Guilleloma/Furby-GPT/README.md

# Hacked Furby as a Desktop Assistant with Voice Control



https://github.com/Guilleloma/Furby-GPT/assets/115458145/2f7d8e4b-0d95-4262-baf4-6ca00bf8f71c

## Description
This project transforms a 1998 Furby into an interactive and advanced desktop assistant using a Raspberry Pi W. It incorporates OpenAI and Google Speech to text for natural language processing, primarily relying on Google Cloud Text to Speech for voice generation. It uses Picovoice's Porcupine library for voice activation and controls the Furby's motor for a dynamic user experience.

> **More on the web:** the [project page](https://makerisland.es/projects/furby-gpt) tells the full story, and [FurbyBoard por dentro](https://makerisland.es/projects/furby-gpt/placa) (in Spanish) is an interactive walkthrough of the custom board: every block animated, simulated signals and how to diagnose faults. The board's design files and datasheet live in [`Hardware/FurbyBoard/`](Hardware/FurbyBoard/README.md).

## Features
- **Function:** Designed to act as an interactive desktop assistant.
- **Platform:** Operates on a Raspberry Pi W.
- **Motor Control:** Animates the Furby in response to voice interactions.
- **Intelligent Interaction:** Processes natural language using OpenAI and Whisper/Google Speech to Text.
- **Voice Generation:** Primarily uses Google Cloud Text to Speech for verbal responses.
- **Voice Activation:** Utilizes Picovoice's Porcupine for detecting wake words.

## Requirements
- A 1998-2000 Furby.
- Raspberry Pi W (with necessary accessories).
- HAT Audio: WM8960 Audio HAT
- L298N H-Bridge (motor driver)
- Speaker (default speaker is useful as well but very poor)
- Access to OpenAI, Google Cloud & Picovoice (Elevenlabs optional)
- Knowledge in programming and electronics.

## Setup and Installation
1. **Hardware Preparation:** Modification and integration of the Raspberry Pi W into the Furby.
2. **Software Configuration:**
   - Installation and setup of OpenAI, Google Cloud
   - Installation of dependencies. Example:
     ```
     pip install openai whisper google-cloud-texttospeech pvporcupinewrapper python-dotenv
     ```
   - Add YOUR API Keys (see **Configuration** below)
3. **Programming and Integration:** Development of code to manage voice interaction and movement.

## Configuration
API keys are read from environment variables. Copy `.env.example` to `.env` and fill it in:
```
cp .env.example .env
```

| Variable | Required | Service |
|---|---|---|
| `OPENAI_API_KEY` | Yes | OpenAI (Whisper and ChatGPT) |
| `PICOVOICE_ACCESS_KEY` | Yes | Picovoice Porcupine (wake word) |
| `GOOGLE_APPLICATION_CREDENTIALS` | Yes | Path to your Google Cloud service account JSON (Text-to-Speech) |
| `PICOVOICE_KEYWORD_PATH` | No | Path to your wake word model (`.ppn`). Defaults to `heymatepicovoice.ppn` next to the scripts |
| `ELEVENLABS_API_KEY` | Only with ElevenLabs | ElevenLabs (optional TTS) |
| `ELEVENLABS_VOICE_ID` | Only with ElevenLabs | ID of the ElevenLabs voice to use |

`.env` is loaded automatically when `python-dotenv` is installed; otherwise export the variables in your shell. `.env` is in `.gitignore`: never commit it. If a variable is missing, the program stops and tells you which one.

The wake word model is created in the Picovoice Console and is tied to your account, so `*.ppn` files are not committed: download yours and place it next to the scripts or set `PICOVOICE_KEYWORD_PATH`.

### Furby personality
The system prompt lives in `chatbot1.txt`, which is local and ignored by git. Create it from the example and personalise it:
```
cp chatbot1.example.txt chatbot1.txt
```
If `chatbot1.txt` does not exist, the program uses `chatbot1.example.txt` and prints a warning. Keep personal details in `chatbot1.txt` only.

## Usage
1. Wake up the Furby with a keyword using Porcupine.
2. Interact with the Furby, which uses Whisper and OpenAI for understanding and responding.
3. Enjoy the Furby's responses and animations, controlled by the Raspberry Pi W.

## Contribution
To contribute to the project:
```
1. Fork the project
2. Create your feature branch (`git checkout -b feature/AmazingFeature`)
3. Commit your changes (`git commit -m 'Add some AmazingFeature'`)
4. Push to the branch (`git push origin feature/AmazingFeature`)
5. Open a Pull Request
```

## License
This project is licensed under the MIT License - see the LICENSE.md file for details.

## Contact
Contact information of the project creator.
