Guilleloma/Furby-GPT/Hardware/FurbyBoard/revisiones/2026-10-27-M3.md

# Cierre de la mejora M3 (piezas contra el contorno fresado; E1 propia repetida y E2 sobre los ficheros) — FurbyBoard v1.0

- Fecha: 2026-10-27 · Rama `fix/furbyboard-m3` desde `trunk` (`402eeb9`) · Commits: `ce455a2` (M3), `e558d6a` (fabricación) y el de documentación que añade este informe · Autor: electronics-engineer (T0, Fable 5.1), encargo de cierre de M3 de `2026-10-25-E-independiente.md`
- Tipo de placa: L · Capas: 6 (JLC06161H-7628) · Fabricante: JLCPCB (Economic a una cara)
- Material: `scripts/design.py`, `layout.py`, `rutas_fijas.py`, `comprobar_colocacion.py`; placa regenerada (`gen_sch` → `sch upgrade` → `gen_pro` → `gen_pcb` → `gen_pro` → `rellenar.sh`); volcado propio con pcbnew en subproceso (`os._exit`) de la distancia de patio, cuerpo (F.Fab) y pads de las 158 huellas al contorno real (`GetBoardPolygonOutlines`, con el agujero del mecanismo), de borde a borde; script propio de rellenos y de paralelos In2/In3 (el mismo criterio de M1); PNG de `pcb-toolkit capturas` a 60 px/mm.
- Skills cargadas: `pcb-layout`, `kicad-automation`, `pcb-fabrication`, `hardware-design-review` (y sus referencias del Cerebro enteras: `layout-pcb`, `kicad-automatizacion`, `fabricacion-pcb`, `fabricante-jlcpcb`, `revision-de-diseno`, plantillas y preferencias).

## Resultado
**PASA (propia)** — 0 críticos, 0 importantes, 0 mejoras nuevas. Objetivo de M3: ningún pad ni cuerpo de pieza montada a < 0,5 mm del contorno fresado (tolerancia del contorno de JLCPCB ±0,2 mm, `fabricante-jlcpcb.md` §2; con 0,5 nominal quedan ≥ 0,3 en el peor caso). Cumplido en las 126 piezas montadas. Falta la revisión independiente («Para el revisor»).

## Criterio
- `fabricante-jlcpcb.md` §2: cobre a borde fresado ≥ 0,2 mm, tolerancia del contorno ±0,2 mm (±0,1 de precisión). Regla del proyecto: cobre a borde 0,3 (DRC). Para piezas montadas se exige además pads y cuerpo a ≥ 0,5 mm (0,3 en el peor caso del fresado), y el patio a ≥ 0,5 donde quepa (es lo que midió la revisión E; el patio lleva 0,25 de margen alrededor del cuerpo y no es cobre).
- Medida: distancia mínima entre el polígono (patio, cuerpo o pad) y los segmentos del contorno real, no contra arcos aproximados.

## Distancias al contorno fresado (mm; antes `402eeb9` → después `ce455a2`)
| Pieza | Patio | Cuerpo | Pads | Qué se hizo |
|---|---|---|---|---|
| **R24** (30 kΩ, compensación del TPS61089) | 0,086 → **0,597** | 0,359 → **0,803** | 0,336 → **0,774** | 0603 → **0402** (C25776) bajo C15, en (−53,88; −119,10) a 180° |
| **R23** (270 kΩ, ILIM) | 0,216 → **0,396** | 0,821 → 0,997 | 0,650 → 0,827 | 0,30 al norte, (−45,25; −115,07) |
| **R50** (1 kΩ, serie de HOME) | 0,410 → **0,568** | 1,102 → 1,260 | 0,789 → 0,947 | 0,15 al oeste y 0,05 al norte, (−44,65; −112,75) |
| R42 | 0,500 → 0,500 | 1,19 | 0,87 | Sin cambio: C20 toca su patio por el oeste y R40 por el norte |
| D3, C16, C18 | 0,70 / 0,76 / 0,98 | ≥ 1,3 | ≥ 1,1 | Sin cambio |
| J9 (pads de cable) | 0,282 | — | 0,717 | Sin cambio |
| J7, J8, J11 (pads de cable) | 0,101 / 0,008 / −0,000 (J11 con un vértice 0,11 fuera, aceptado en C) | — | 0,446 / 0,344 / 0,347 | **No se mueven** (hallazgo A1) |
| J1 (USB-C de montaje medio) | −0,000 | −0,080 | 0,140 | Sin cambio: regla propia del `.kicad_dru` (pads junto a la ranura) |
| U4 (módulo) | −0,000 | 0,839 | — | Sin cambio: la antena va fuera de la placa por diseño |
| LOGO1 (serigrafía inferior) | 0,605 | 0,574 | — | Sin cambio |

Las 144 huellas restantes quedan a > 1,0 mm en los tres conceptos. Volcado completo en el scratchpad del encargo (`borde-antes.txt`, `borde-despues.txt`); el script se reproduce con pcbnew en < 1 min.

## Por qué R24 pasa a 0402 y no se mueve
- Entre el patio de R22 (y −117,00) y el borde trasero (y −120,161) hay 2,66 mm. Caben un 0603 a 180° (patio de 1,55) y un 0402 (0,94), pero no dos 0603 (3,10) ni uno a 90° (3,05). La columna no puede subir: C12 queda a 0,22 del patio de L2 y la pista FSW (y −113,75) a 0,23 del pad de C12. Al oeste están C14, R21 y el keepout de Ø5 de H4; al sur, la muesca del contorno hacia H4 (línea de (−55,53; −121,37) a (−53,34; −120,27)). Mover C15 en vez de R24 deja el mismo problema. Comprobado también a 0° y 90° en el hueco entre el keepout de H4 y la muesca: el patio o los pads caen dentro del keepout o a < 0,5 de la muesca.
- R24 sigue pegada a C15 (COMP, 1,3 mm) y a C14 (RC, 2,1 mm), fuera de la zona de L2 (> 8 mm) y del keepout de H4 (> 3 mm). Ruta: COMP baja recto de C15.1 y entra en R24.1 con una diagonal de 0,43; RC sale de R24.2 al oeste, sube a 45° a la fila de C14 (y −118,6) y entra en C14.1 por su eje. Sin vías nuevas. El lazo VOUT–C18–GND y el nodo SW no se tocan.
- Pieza: UNI-ROYAL 0402WGF3002TCE, 30 kΩ ±1 %, 62,5 mW, **C25776**. Ficha de JLCPCB: **Extended** (3,07 USD de carga en Economic); API de EasyEDA/LCSC: 249 300 en stock, 0,0033 USD (2026-10-27). Se mantiene el valor aprobado de la compensación; el 33 kΩ 0402 (C25779) es Basic y subiría fc un 10 % (R5 ∝ fC, ecuación 17 de SLVSD38C): queda como opción de Guillermo en `fabricacion/README.md`, «Confirmar antes de pedir». El código 30 kΩ 0402 no se adivinó: se sondeó la API de EasyEDA por código (C25770–C25780) hasta dar con el MPN, y se confirmó en la ficha de JLCPCB.

## R23 y R50
- **R23** (ILIM, resistencia de ajuste estática a GND: su única regla es ir corta al pin 8 y con el retorno local; no es realimentación ni compensación): 0,30 al norte. No cabe más al norte (patio de R50 a 0,01) ni al oeste (las dos vías de VSYS que alimentan C16.1 en x −46,25 quedan a 0,225 de sus pads; la primera prueba a 0,24 al oeste dio DRC con corto GND/VSYS y se descartó). ILIM pasa entre los pads de C16 por y −116,12 (0,245 al pad de VSYS, 0,405 al de GND) y entra en R23.1 por su eje desde el sur (aviso `entrada-pad-descentrada` 0,225, aceptado en NOTAS). La vía de GND de R23.2 baja a 45° al SE, a (−44,65; −114,845): al este quedaba a 0,125 de la columna de HOME_PAD.
- **R50**: 0,15 al oeste y 0,05 al norte. La vía de HOME se queda en la diagonal de In2 ((−46,35; −112,75), 45° exacto desde (−48,3; −110,8)); la columna de HOME_PAD de In2 pasa a x −43,825 (0,355 a la vía de TUMMY_PAD, 0,6 a la de TUMMY). La bajada de ENC_IO de In3 pasa de x −43,95 a −44,2 (0,225 a la vía de TUMMY) para no quedar a 0,125 de eje a eje de esa columna: ahora 0,375 (antes 0,275), solape 1,55 mm, por debajo del criterio de M1 (≥ 2 mm). Ningún paralelo In2/In3 nuevo: los 19 pares son los mismos, con las mismas longitudes y separaciones.

## Herramientas
| Herramienta | Comando | Resultado |
|---|---|---|
| Comprobación §1.1 | kicad-cli, pcb-toolkit, kicad-happy, rsvg-convert | kicad-cli 10.0.7; pcb-toolkit 0.1.0 (venv de `~/development/pcb-toolkit`, el de `PCB_TOOLKIT`); kicad-happy v2.3.2; rsvg-convert; sin `~*.lck` |
| ERC | `kicad-cli sch erc --severity-all --exit-code-violations` | **0** |
| DRC | `kicad-cli pcb drc --schematic-parity --severity-all` sobre la placa guardada por `rellenar.sh` (y en `make_fab.sh`, copia rellenada por kicad-cli idéntica) | **0 infracciones, 0 sin unir, 0 de paridad** |
| Rellenos | Script propio (área y trozos por red y capa) frente a `402eeb9` | In1 e In4 3313,1 mm² en 1 trozo; GND B 2773,3 en 10; VSYS In2 2617,8 en 3 (antes 2619,0, por las vías movidas); BAT F 31,2 en 1; **GND F 2080,3 en 19 (antes 2082,9 en 21)**: la bolsa de C18.2 (4,3 mm², 1 vía) se une al plano por la franja bajo el 0402 y la de C16.2 (4,0, 2 vías) a la de R23.2 (ahora 7,0 mm² con 3 vías); desaparece el dedo de 0,25 mm de ancho entre los pads de R40/R42/R50 (≈ 3 mm², sin pads ni vías de GND; `layout-pcb.md` §5.4 los prohíbe). Todos los pads de GND de la esquina siguen en un trozo con vía (U5.5 va por pista a C18.2, como antes) |
| Flujo | `pcb-toolkit comprobar-flujo --png --json` | Solo los dos cruces ya aceptados en NOTAS (I2S_DIN a 0,40 del clase D; MOT_VREF a 2,58 de L2) y los 4 desacoplos ≤ 2 mm de siempre |
| Geometría | `pcb-toolkit revisar-rutado --json` (anchos de `pcb-toolkit.toml`) | **0 errores, 152 avisos** (antes 151): +1 `entrada-pad-descentrada` R23:1 0,225 (BST_ILIM). Diff contra `402eeb9`: ningún otro aviso nuevo ni desaparecido |
| Colocación | `scripts/comprobar_colocacion.py` | OK (TP accesibles, calzos libres, alturas). Fallaba desde M7 por R59 (0402 sin altura en `ALTURAS`) y LOGO2: añadidas R_0402 (0,45 mm) y Logo_GuilleMaker (0) |
| Paralelos In2/In3 | Script propio (≤ 8°, solape ≥ 2 mm, borde a borde < 1 mm) | 19 pares de redes, idénticos a `402eeb9` (misma longitud y separación) |
| Configuración | `pcb-toolkit.toml`, `.kicad_dru` | Sin cambios |
| Análisis | `kicad-happy.sh analizar` sobre copia | Puerta WARN (el de siempre: 152 símbolos frente a 158 huellas = 152 + H1–H4 + LOGO1 + LOGO2); hallazgos de nivel error los mismos de E1-12 y M9 (fiduciales, keepouts por caja, J1 fuera del contorno, vía de IR_TX junto a H1, DC-002, SU-001, SW-003); nada nuevo |
| CPL | `pcb-toolkit cpl-rotaciones` (en `make_fab.sh`) | **PASS, 0 errores, 3 avisos** `giro-sin-tabla` (R59, R60: C25105; R24: C25776; los tres 0402 sin polaridad); origen del CPL = origen del Gerber (220; −40) |
| PNG | `pcb-toolkit capturas` a 60 px/mm | **11 leídos** (abajo) |

## PNG leídos
| PNG | Qué se ve | Pasa |
|-----|---|---|
| Esquina del elevador, F.Cu | R24 0402 bajo C15, COMP recto desde C15.1 con la diagonal final, RC al oeste y a 45° hasta C14.1; franja de GND continua bajo R24 hasta la zona de C18; R23 con ILIM entre los pads de C16 y entrada por el eje; vía de GND de R23.2 a 45°. Solo 0°/45°/90°, sin agudos ni escaleras | Sí |
| Esquina, patios | R24 pequeño bajo C15 con hueco claro al borde; R23 separado del arco; ningún solape | Sí |
| Esquina, todo el cobre | Lo de arriba más In2/B.Cu: nada sobre el nodo SW ni el lazo de C18 | Sí |
| Esquina, In2 | Diagonal de HOME a 45° acabando en su vía; columna de HOME_PAD hacia el norte; EN_6V sin tocar | Sí |
| Esquina, In3 | Solo vías; ninguna pista nueva | Sí |
| Esquina, B.Cu | V6 por y −118,0 y las vías dobles de C18; EN_6V por x −48,4; TP7. Sin cambios | Sí |
| Esquina, serigrafía | Designadores recolocados sin pisar pads ni vías | Sí |
| Zona de R50/R23/J9, F.Cu | Columna R40/R42/R50 con sus vías; R23 abajo con el stub de GND a 45°; ya no hay dedo de GND entre los pads de la columna (comparado con el PNG de `402eeb9`) | Sí |
| Zona de R50/R23/J9, In2 | HOME_PAD sube por x −43,825 entre las vías de TUMMY y TUMMY_PAD hasta el canal de J9 | Sí |
| Zona de R50/R23/J9, In3 | ENC_IO baja por x −44,2, fila de y −109,3 y vía; TUMMY_PAD por el canal x −43,07 | Sí |
| Zona de R50/R23/J9, patios | R23, R50, R42, R40, JP4 sin solape (huecos de 0,01–0,06) | Sí |

## Hallazgos
| ID | Severidad | Área | Hallazgo | Evidencia | Verificado / supuesto | Corrección propuesta | Estado |
|----|---|---|---|---|---|---|---|
| A1 | Aceptado (documental) | DFM: pads de cable y USB-C junto al contorno | Los patios de J7, J8, J9 y J11 quedan a 0,0–0,28 mm del contorno y el cobre de sus pads a 0,34–0,45; J1 a 0,14 por su regla propia; U4 con la antena fuera | Volcado propio | Verificado | No se mueven: son pads de cable sin cuerpo (el patio no es cobre y no hay pieza que el fresado pueda tocar); el cobre cumple los 0,3 del DRC y los 0,2 de JLCPCB (peor caso 0,14 de FR-4 con ±0,2). Moverlos 0,2 mm reabre el rutado de 18 pads en el borde (UART, I2C y P04 de J_EXP; TILT, TONGUE y altavoz de J8; IR de J7, que además quedaría bajo la batería). Si el revisor lo exige, es un encargo aparte | Abierto para el revisor |
| A2 | Mejora | Coste | R24 en 0402 es extended (+3,07 USD de carga por pedido, 19 referencias) | Ficha de JLCPCB de C25776 | Verificado | Mantener 30 kΩ (valor aprobado). Opción: C25779 (33 kΩ, basic), fc +10 % sin simular | Decisión de Guillermo (README de fabricación) |
| A3 | Mejora | R23 | El patio queda a 0,40 (pads a 0,83, cuerpo a 1,0): no llega a 0,5 por las vías de VSYS de C16 y por R50 | Volcado | Verificado | Nada para la v1.0: cumple el criterio de pads y cuerpo. v1.1: alimentar C16.1 desde el norte para liberar x −46,25 | Abierto (v1.1) |

## Checklist de la puerta (solo los puntos tocados)
| Sev. | Punto | Resultado |
|---|---|---|
| C | DRC con paridad 0/0 y rellenos no desfasados | OK: 0/0/0 guardado y rellenado; `make_fab.sh` para si no son idénticos |
| C | `revisar-rutado --ancho` 0 errores; anchos en el `.kicad_dru` | OK: 0 errores, 152 avisos (+1 aceptado) |
| C | `pcb-toolkit.toml` sin reglas apagadas | OK, sin cambios |
| C | Huella y pieza del 0402 comprobadas | OK: R_0402_1005Metric de KiCad (la misma de R59/R60), MPN y código confirmados en JLCPCB y LCSC |
| I | Convertidor como su referencia; compensación corta | OK: R24 a 1,3 mm de C15 y 2,1 de C14; lazo y SW intactos |
| I | Plano continuo bajo B/C/D; sin islas ni dedos nuevos | OK: In1/In4 en 1 trozo; GND F con 2 trozos menos (bolsas unidas) y un dedo menos |
| I | Apilado: paralelos In2/In3 | OK: 19, los mismos |
| I | Mecánica (`comprobar_colocacion.py`), patios sin solape | OK |
| C (E2) | Gerber, taladros y CPL con el mismo origen; CPL comprobado | OK: (220; −40); `cpl-rotaciones` PASS; R24 en (−53,880; −119,100) Top 180 |
| I (E2) | BOM agrupada; README de fabricación | OK: 52 líneas / 126 piezas; README con C25776, 19 extended y la opción C25779 |
| I | NOTAS y README al día | OK |

## Revisión final como revisor senior
- «Isla borrada en silencio» (FurbyBoard, 2026-10-25): medido trozo a trozo; los dos que desaparecen se unen a otros y el dedo que se pierde no tenía pads ni vías.
- «Vía de otra red fuera de la ventana» (2026-10-27): la primera posición de R23 chocó con la vía de VSYS de C16; lo paró el DRC y se corrigió antes de rutar nada más. Lección: antes de mover una pieza, volcar vías y pistas a ≥ 1 mm de su patio nuevo (hecho después para R50 y ENC_IO).
- «Código de pieza inventado»: C25900 que yo recordaba como 30 kΩ era 4,7 kΩ; se comprobó en LCSC y JLCPCB antes de usar C25776.
- «Herramienta de pipx desfasada»: todo con el pcb-toolkit del venv.

## Para el revisor
1. Repetir el volcado de distancias al contorno con `GetBoardPolygonOutlines` (patio, cuerpo y pads de las 158 huellas) y comprobar que ninguna pieza montada tiene pads ni cuerpo a < 0,5 mm; R24 0,60 / 0,80 / 0,77, R23 0,40 / 1,00 / 0,83, R50 0,57 / 1,26 / 0,95, R42 0,500 / 1,19 / 0,87.
2. Juzgar A1: si los pads de cable (J7, J8, J11) deben moverse 0,2 mm hacia dentro pese a cumplir las reglas de cobre, o si basta con lo documentado.
3. R24: la compensación sigue siendo 30 kΩ + 4,7 nF (+ 10 pF); comprobar que COMP y RC siguen cortas y que el 0402 no cae en el keepout de H4 ni en la zona de L2. Decidir, con Guillermo si hace falta, 30 kΩ extended (C25776) o 33 kΩ basic (C25779).
4. ILIM entre los pads de C16 por y −116,12: 0,245 al pad de VSYS y 0,405 al de GND, entrada a R23.1 por el eje desde el sur (descentrada 0,225).
5. Rellenos de GND de F.Cu: 21 → 19 trozos. Comprobar que los pads C18.2, C16.2 y R23.2 siguen en trozos con vía y que el dedo perdido entre R40/R42/R50 no deja nada suelto.
6. ENC_IO (In3) por x −44,2: 0,225 a la vía de TUMMY y 0,375 de eje a eje con HOME_PAD (In2) en 1,55 mm; paralelos In2/In3 sin cambios (19).
7. E2: `cpl-rotaciones` con 3 `giro-sin-tabla` (0402 sin polaridad): R24 a 180° en el CPL; comprobar en el visor de JLCPCB con las otras dos 0402.
