Guilleloma/Furby-GPT/Hardware/FurbyBoard/revisiones/2026-10-27-M7-M1.md

# Cierre de las mejoras M7 y M1 (E1 propia repetida y E2 sobre los ficheros) — FurbyBoard v1.0

- Fecha: 2026-10-27 · Rama `fix/furbyboard-m7-m1` desde `trunk` (`7f1f637`) · Commits: `f2f73dd` (M7), `4156112` (M1, tanda 1) y los de fabricación y documentación que siguen · Autor: electronics-engineer (T0, Fable 5.1), encargo de cierre de M7 y M1 de `2026-10-25-E-independiente.md`
- Tipo de placa: L · Capas: 6 (JLC06161H-7628) · Fabricante: JLCPCB (Economic a una cara)
- Material: `scripts/design.py`, `layout.py`, `rutas_fijas.py`, `pcb-toolkit.toml`; placa regenerada (`gen_sch` → `gen_pro` → `gen_pcb` → `gen_pro` → `rellenar.sh`); volcado propio con pcbnew en subproceso (`os._exit`) y script propio de paralelos In2/In3 (pares de segmentos a ≤ 8°, solape ≥ 2 mm, borde a borde < 1 mm); 9 PNG; `fabricacion/` regenerada con `make_fab.sh`. Skills cargadas: pcb-layout, kicad-automation (con `layout-pcb.md`, `kicad-automatizacion.md`, `preferencias-pcb-guillermo.md`, `plantilla-informe-revision.md`, `revision-de-diseno.md` §4.7–4.9 y §6) y la regla §7.3 de `diseno-de-circuito.md`. Coordenadas en el sistema del STL.

## Resultado
**PASA (propia)** — 0 críticos, 0 importantes, 0 mejoras nuevas. M7 cerrada; M1 cerrada con 9 pares corregidos y **19 aceptados uno a uno** en NOTAS («Paralelos In2/In3 aceptados»). Falta la revisión independiente (sección «Para el revisor»).

## Herramientas
| Herramienta | Comando | Resultado |
|---|---|---|
| Comprobación §1.1 | kicad-cli, pcb-toolkit, kicad-happy, Freerouting, rsvg-convert, ngspice | kicad-cli 10.0.7; pcb-toolkit 0.1.0 (pipx en `~/.local/bin`, y el venv de `~/development/pcb-toolkit` en `28b60ac`, que es el que mide el cobre en `comprobar-flujo` y trae la tabla de giros); kicad-happy v2.3.2 (`2fd9aa0f`); Freerouting 1.9.0; rsvg-convert; ngspice. Nada instalado (un venv con gerbonara para rasterizar los Gerber fue denegado por el sistema de permisos: los Gerber se comprobaron por texto, ver E2) |
| ERC | `kicad-cli sch erc --severity-all --format json` | **0** |
| DRC | `kicad-cli pcb drc --schematic-parity --severity-all` sobre la placa guardada por `rellenar.sh` | **0 infracciones, 0 sin unir, 0 de paridad** |
| Rellenos | `make_fab.sh` (copia rellenada por kicad-cli `cmp` con la guardada) | Idénticos. Volcado: GND F 2082,9 mm² en 21 trozos (antes 2084,6: antipads de los dos 0402), GND B 2773,2 en 10, In1 e In4 3313,1 en 1, VSYS In2 2619,0 en 3 (antes 2616,3: la fila de BQ_TS sube 0,25 y libera relleno), BAT F 31,2 en 1. **Ningún trozo ni isla nuevos** |
| Flujo | `pcb-toolkit comprobar-flujo --png --json` (venv `28b60ac`, mide el cobre) | Solo los dos avisos ya aceptados en NOTAS (I2S_DIN a 0,40 del clase D; MOT_VREF a 2,58 de L2) y los 4 desacoplos ≤ 2 mm; nada nuevo. (El pcb-toolkit de pipx, anterior, sigue dando el falso positivo USB_DP/L1) |
| Geometría | `pcb-toolkit revisar-rutado --tp-max 5 --json` (anchos de `pcb-toolkit.toml` = `params.ANCHOS_MINIMOS`) | **0 errores, 151 avisos** (entrada-asimétrica 36, descentrada 32, rodeo 27, cuello 21, roce-vía 15, roce-pad 10, pista-entre-pads 6, ancho-mayor-que-pad 3, colineales 1): los de NOTAS «Avisos aceptados», uno menos (el roce de BQ_TS con la vía de GND de C5.2 pasa de 0,2 a 0,225) |
| Configuración | `pcb-toolkit.toml` | Sin reglas en `off` ni umbrales más laxos; `criticas` y el grupo DVP pasan de `CAM_XCLK`/`CAM_PCLK` a `CAM_XCLK*`/`CAM_PCLK*` para cubrir las redes cortas de las series |
| Análisis | `kicad-happy.sh analizar` | Sin críticos; consistencia 152 símbolos frente a 158 huellas (= 152 + H1–H4 + LOGO1 + LOGO2, como antes); EMC 43/100 sin críticos |
| Paralelos In2/In3 | Script propio sobre el volcado | **28 → 19 pares**; antes de tocar nada reproduce los 28 del revisor independiente |
| CPL | `pcb-toolkit cpl-rotaciones` (venv, tabla `ejemplos/giros-jlcpcb.toml`) dentro de `make_fab.sh` | **PASS, 0 errores**, 2 avisos `giro-sin-tabla` (R59, R60: C25105 no está en la tabla; 0402 sin polaridad, giro 0) |
| PNG | `pcb-toolkit capturas` (F.Cu a 80 px/mm para M7; In2+In3 a 30 px/mm para M1) y los renders de `make_fab.sh` | 9 leídos y comentados (sección «PNG leídos») |

## M7: series en los relojes del bus DVP
| Qué | Dónde | Medida que lo demuestra |
|-----|---|---|
| **R59, 33 Ω 0402 (C25105, UNI-ROYAL 0402WGF330JTCE, básica, 2 162 519 en stock, 0,0011 USD; API de piezas de JLCPCB, 2026-10-27)** en CAM_XCLK, junto al pin 21 del módulo (lo genera el ESP32) | `layout.py` (−72,365; −82,35) a 0°; pad 1 (oeste) a la red corta CAM_XCLK_IO (pin 21), pad 2 al bus. Patio a 0,18 del patio del módulo (y −81,70); pads a 0,53 del pin 21 | PNG F.Cu a 80 px/mm: la subida de Y8 (x −71,095) a 0,415 del pad 2 y la de Y9 (x −73,635) a 0,415 del pad 1; XCLK entra en el pin 21 por su eje con una diagonal de 0,72 mm; la fila de Y9 (y −83,3) no pasa bajo los pads. DRC 0 |
| **R60, 33 Ω 0402 (mismo código)** en CAM_PCLK, junto al pad 17 de J6 (lo genera la cámara) | `layout.py` (−53,6; −78,0) a 0°, a 2,0 mm del pad; pad 2 (este) a la red corta CAM_PCLK_CAM (J6.17), pad 1 al bus. PCLK baja 0,25 a y −78,0 al salir del patio de J6 y vuelve a −77,75 al oeste de R60; Y7 baja 0,35 a y −78,6 y vuelve a −78,25 en x −55,6…−55,95 (más al oeste que el quiebro de PCLK) | PNG: Y6 (y −77,25) a 0,355 de los pads y Y7 (−78,6) a 0,205; Y8 (−79,25) a 0,5 de Y7; los quiebros son diagonales de 0,35–0,49 mm a 45° escalonadas (ningún par de diagonales a < 0,2). DRC 0 |
| Valor 33 Ω | `design.py` y NOTAS «Cálculos» | Z0 ≈ 75 Ω (microstrip 0,15 mm sobre In1 a 0,2104 mm, εr 4,4, IPC-2141); Rout del ESP32-S3 ≈ 30–40 Ω y de la OV2640 ≈ 40–50 Ω (**estimadas**, drive programable en los dos); Rs + Rout ≈ Z0. τ con ≈ 10 pF: 0,33 ns frente a 50 ns de periodo. Mismo valor que R31/R32 (I2S), huella distinta por sitio |
| HREF, VSYNC y datos sin serie | NOTAS «Decisiones» | HREF y VSYNC conmutan a frecuencia de línea y de cuadro; los datos se muestrean a mitad de periodo de PCLK (≥ 25 ns tras el flanco) con 16–29 mm de pista (anillo extinguido en < 2 ns). Ocho 0402 más no caben en el corredor de 0,3 mm de paso |
| Sin degradar el bus | Volcado | Las 12 líneas siguen en F.Cu sobre In1 continuo, **sin vías nuevas** (334 vías, como antes); los únicos cambios son los quiebros de PCLK y Y7 junto a J6 y 0,51 mm menos de XCLK |
| Esquema, ERC y paridad | `design.py` (redes CAM_XCLK_IO y CAM_PCLK_CAM), `hojas/mcu`, `hojas/camara` | ERC 0; paridad 0; 152 referencias, 108 redes |
| Documentación | README (Estado, Resumen, bloque Cámara, tablas de J6 y del módulo), NOTAS (Estado, Decisiones, Cálculos), TEST-PLAN §14 (flancos en R59/R60: ≤ 10 % de sobreimpulso; 47 Ω si hay anillo, 22 Ω si el flanco es lento), `fabricacion/README.md` (BOM, visor, coste) | Al día |

## M1: paralelos In2/In3
Método: volcado propio de la placa con pcbnew y script propio que compara cada segmento de In2 con cada uno de In3 (ángulo ≤ 8°, proyección con solape ≥ 2 mm, separación borde a borde = distancia entre ejes − (w1 + w2)/2 < 1 mm). Antes de tocar nada: **28 pares, los mismos que el revisor**. Orden: analógicas (VBAT_SNS, IPROPI, BQ_TS), relojes (I2S_BCLK, MOT_IN2) y la UART junto a la antena; después el resto por coste.

| Par corregido | Antes | Cambio (`rutas_fijas.py`, sin mover piezas ni vías) | Ahora (borde a borde) |
|---|---|---|---|
| VBAT_SNS ‖ U0RX | 11,4 mm a 0,46 | U0RX (In3) sube de y −63,6 a −63,0 entre el módulo y x −81,8 (0,45 a U0TX), baja a −63,6 en x −82,4 al sur de la vía de GND (−83,0; −62,99) | 1,06 |
| VBAT_SNS ‖ BQ_EN1 | 14,3 mm a 0,97 | Diagonales de EN_6V/BQ_EN2/BQ_EN1 0,141 al este (0,1 en perpendicular); la vía de GND (−71,2; −99,1) queda a 0,24 de EN_6V | 1,07 |
| I2S_DIN ‖ EN_6V | 3,7 mm a 0,95 | Las tres columnas de In3 0,1 al oeste (x −84,35 / −83,9 / −83,45); vías de 3V3 (−85,5; −86,3/−90,5) a 0,75 de BQ_EN1 | 1,05 |
| BQ_TS ‖ LED_CHG_A | 6,5 mm a 0,70 | BQ_TS (In2) a y −114,05 (0,225 a la vía de GND de C5.2); LED_CHG_A a −115,3 y LED_PG_A a −115,7 (0,2 a la vía de GND (−69,225; −116,3)); el tramo de F.Cu a R10.2 entra por el eje del pad | 1,05 |
| VBAT_SNS ‖ TUMMY | 2,6 mm a 0,85 | Fila corta de VBAT_SNS (In2) a y −76,1 (0,4 a la vía de ENC_IO) y las tres filas TUMMY/BACK/CAM_PWDN 0,1 al norte | 1,05 |
| 3V3 ‖ CAM_PWDN | 9,7 mm a 0,95 | Las mismas filas 0,1 al norte (CAM_PWDN a y −78,15; su diagonal a 0,25 de la vía de SDA y 0,29 de la de 3V3) | 1,05 |
| 3V3 ‖ CAM_EN y CAM_2V8 ‖ CAM_EN (tramo norte) | 2,3 a 0,90 y 4,1 a 0,28 | Tramo norte de CAM_EN (In3) por x −51,3 (1,0 a CAM_PWDN, 0,25 a la vía de 3V3 (−50,65; −87,8)) y la fila y −87,9 (0,3 a la vía de GND (−51,6; −88,6)) hasta x −53,5 y la vía de U8.3. Primer intento por x −50,9 cortocircuitaba con esa vía de 3V3 (DRC `shorting_items`): corregido antes del commit | 3,6 y 2,2; queda el tramo sur, 2,0 mm a 0,78 (fila 4 de NOTAS) |
| I2S_BCLK ‖ EXP_P07 | 4,5 mm a 0,75 | Columna de BCLK (In2) junto a U7 por x −94,0 (0,4 a DOUT, 0,2 a la vía de GND (−93,4; −91,95)) con diagonal de 0,57 a su vía | 1,15 |
| MOT_IN2 ‖ HOME | 4,4 mm a 0,50 | Fila de HOME (In3) a y −88,05 (0,5 a la vía de MOT_IN1 (−66,325; −88,95)) con diagonales de 0,55 y 2,0 | 1,05 |

**Los 19 que quedan** (EN ‖ U0RX y U0TX en la banda de la antena, IPROPI ‖ CAM_EN, CAM_2V8 ‖ CAM_EN, I2C_SCL ‖ I2C_SDA, EXP_INT ‖ IR_RX/TUMMY/BACK/CAM_PWDN, HOME_PAD y ENC_PT ‖ TUMMY_PAD, HOME ‖ BACK/TUMMY, CC1 ‖ CC2, I2C_SCL ‖ LED_RUN_K, 3V3 ‖ LED_RUN_K/IR_TX, I2C_SDA ‖ IR_RX, CAM_DVDD ‖ ENC_IO) están justificados uno a uno en NOTAS «Paralelos In2/In3 aceptados»: en todos la víctima o el agresor es una red estática o de interruptor filtrado (EN con 1 µF; enables; interruptores con 1 kΩ + 100 nF; Rd del USB-C; raíles desacoplados) y la geometría los pinza entre vías o en el único canal (entre las filas de pads de J7, entre las columnas de J9, entre las vías de EN y SDA bajo el módulo, entre el agujero del mecanismo y la columna de vías de x −53…−52). El único con una red de clase D es **IPROPI ‖ CAM_EN** (9,4 mm a 0,50): CAM_EN cambia una vez por encendido de la cámara a través de 100 kΩ; se intentó CAM_EN por x −50,5 y la diagonal de vuelta a R33 no pasa la columna de vías de x −54,375 (paso 0,75, antipads de 0,55); IPROPI no puede ir más al este por su vía de retorno (−53,39; −99,55). HOME_PAD ‖ TUMMY_PAD: el canal este de J9 (x −40,4) no existe, el borde fresado está en x −40,0 a la altura de J9.5.

Lo que sigue por debajo del umbral de 2 mm y por tanto no cuenta, para que el revisor no lo descubra por su cuenta: U0RX ‖ EN 2,0 mm a 0,20 en x −82,4…−84,4 (se cuenta dentro de la fila 1 de NOTAS); CAM_EN ‖ CAM_2V8 1,1 mm a 0,275 en el tramo x −53,5 (y −87,9…−89,0); CAM_2V8 ‖ CAM_EN 0,9 mm a 0,8 en el stub de x −51,512; VBAT_SNS ‖ ENC_IO 1,6 mm a 0,7 (fila y −76,1 frente a y −75,3).

## E2 sobre los ficheros regenerados
| Comprobación | Resultado |
|---|---|
| Rellenos al día | `make_fab.sh` para si la copia rellenada por kicad-cli no es idéntica: idéntica |
| ERC y DRC en `fabricacion/` | `erc.rpt` y `drc.rpt` sin infracciones (0/0/0) |
| Capas | 6 de cobre, máscara, pasta (la inferior vacía), serigrafía y contorno; 29 ficheros en `gerber/` y el zip |
| Taladros | PTH: 383 (0,2 × 3 del par USB, 0,3 × 331 = 334 vías, 0,8 × 4 ranuras del USB-C, 1,0 × 44 pads de cable, 1,2 × 1 de J2); NPTH: 4 (M2). **Iguales a la E2 del 2026-10-25**: M7 y M1 no añaden vías |
| Pads de R59 y R60 en los Gerber (comprobación por texto, sin rasterizar) | Flashes `D03` en F.Cu, F.Mask y F.Paste en (−72,875; −82,35), (−71,855; −82,35), (−54,11; −78,0) y (−53,09; −78,0): las cuatro aperturas de los 0402 en el mismo marco que el CPL (origen auxiliar (0,0) del STL) |
| Origen | Gerber con `--use-drill-file-origin`, taladros `--drill-origin plot`, CPL `--use-drill-file-origin`; `cpl-rotaciones`: origen del CPL = origen del Gerber (220; −40) |
| CPL | PASS, 0 errores; R59 (−72,365; −82,35) y R60 (−53,6; −78,0) a 0°, las posiciones del PCB. Los 21 códigos con giro u origen corregidos (`jlc_post.py`) no han cambiado |
| BOM | 52 líneas, 126 piezas, 18 extended (sin cambio); nueva línea `33, R59,R60, R_0402_1005Metric, C25105` (básica) |
| Renders | `render/furbyboard-arriba.png` (R59 bajo la fila inferior del módulo y R60 a la izquierda del FPC, el resto como el 2026-10-25), `-abajo.png` (sin cambios: TP, leyendas, logos) e `-iso.png`; STEP y PDF regenerados |
| README de fabricación | Fecha, commit, 52/126, línea de C25105 en la BOM, R59/R60 en «Revisar en el visor» y en «Confirmar antes de pedir», coste (+0,002 por placa) |
| Datos personales | `grep -r '/Users/'` en `Hardware/FurbyBoard`: nada |

Lo que no se repitió: la rasterización de los Gerber con gerbonara (instalación denegada en este encargo); los Gerber salen del mismo `kicad-cli` y la placa que los genera se ha revisado en PNG, pero **el revisor debería abrir `gerber-jlcpcb.zip` en un visor** (gerbv, el de JLCPCB o gerbonara) y mirar F.Cu, F.Paste y F.Mask alrededor de (−72,4; −82,4) y (−53,6; −78,0).

## PNG leídos
- `png-m7/F_Cu-v1` (comb de J6, 80 px/mm): R60 entre Y6 y Y7; PCLK con sus dos quiebros a 45°, Y7 con los suyos más al oeste; Y6 y Y8 sin tocar; el stub de GND de J6.15 a su vía. Pasa.
- `png-m7/F_Cu-v2` (fila sur del módulo, 80 px/mm): R59 bajo el pin 21; pad 1 sube con la diagonal al pin, pad 2 baja a la fila de XCLK; Y8 y Y9 a los lados sin tocar; fila de Y9 por debajo. Pasa.
- `png-m1/cobre-v1` (banda bajo la antena, In2+In3): TX y RX en dos carriles separados sobre el relleno de VSYS, RX con el quiebro a −63,6 junto a la vía de GND; EN y VBAT_SNS en In2 debajo; cosido en y −64,9. Pasa.
- `png-m1/cobre-v2` (diagonales BQ_EN/VBAT_SNS): las tres diagonales de In3 a su lado NE de la de VBAT_SNS con separación visible; octógono de HOME alrededor del agujero. Pasa.
- `png-m1/cobre-v3` (CAM_EN junto a J6/U8): columna de In3 por x −51,3, fila a y −87,9 y bajada a la vía; CAM_2V8 de In2 a dos milímetros al oeste. Pasa.
- `png-m1/cobre-v4` (BQ_TS y LED bajo la batería): fila de BQ_TS con sus vías, LED_CHG_A y LED_PG_A debajo en pareja con las diagonales, GND de C5.2 fuera del margen. Pasa.
- `png-m1/cobre-v5` (autopista de In3 bajo U10): tres filas con sus diagonales, columnas de In2 cruzando a 90°; fila corta de VBAT_SNS arriba. Pasa.
- `png-m1/cobre-v6` (BCLK/U7): columna de BCLK con la diagonal a su vía, EXP_P07 al oeste; vías de GND de cosido intactas. Pasa.
- `png-m1/cobre-v7` (HOME/MOT_IN2 alrededor del agujero): fila de HOME con la diagonal a su columna, MOT_IN2 por encima; octógono. Pasa.
- `render/furbyboard-arriba.png` y `-abajo.png`: montaje completo; R59 y R60 presentes; cara inferior sin cambios. Pasa.

## Checklist (puntos tocados)
| Ref. | Sev. | Punto | Estado |
|---|---|---|---|
| 4.2 | I | Interfaces: series en relojes de buses paralelos (`diseno-de-circuito.md` §7.3) | OK: XCLK y PCLK con 33 Ω en su origen |
| 4.3 | C/I | MPN, huella, código, stock y clase | OK: C25105 básica, huella `R_0402_1005Metric` de KiCad (pads 0,54 × 0,64 a 1,02 de paso), stock consultado |
| 4.6 | C/I | Colocación: patios sin solape, desacoplos sin regresión | OK: DRC 0; ningún desacoplo se mueve |
| 4.7 | C | DRC con paridad 0/0 y rellenos no desfasados | OK |
| 4.7 | C | `revisar-rutado --ancho` 0 errores; anchos en el `.kicad_dru` | OK (151 avisos, justificados) |
| 4.7 | C | `pcb-toolkit.toml` sin reglas apagadas | OK (`criticas` ampliada) |
| 4.7 | I | PNG; plano continuo bajo B/C/D; sin islas ni dedos | OK: In1/In4 en 1 trozo; DVP sigue en F.Cu sobre In1 sin vías |
| 4.7 | I | Apilado: paralelos In2/In3 (regla de NOTAS) | OK con 19 aceptados y justificados |
| 4.8 | C | Gerber, taladros y CPL con el mismo origen; giros por geometría | OK (R59/R60 sin polaridad) |
| 4.8 | I | BOM agrupada; README de fabricación | OK |
| 4.9 | C/I | TEST-PLAN | OK: §14 con la medida de los flancos en R59/R60 |

## Revisión final como revisor senior
- **«DRC 0» como calidad:** el primer intento de CAM_EN por x −50,9 pasó por `revisar-rutado` sin error y lo paró el DRC (`shorting_items` con la vía de 3V3 de U8.1): la lección es que el volcado por ventana hay que hacerlo con margen (la vía estaba a 0,25 mm fuera de la ventana que se miró). Se corrigió antes del commit.
- **Afirmación no medida:** cada separación de este informe sale del script de paralelos sobre el volcado, y las holguras a vías se han calculado una a una; las Rout del ESP32-S3 y de la OV2640 son estimaciones y están marcadas como tales.
- **Bus rápido por un convertidor, TP lejos, piezas giradas en el CPL, Gerber y CPL con distinto origen:** no aplica o comprobado (CPL PASS; sin vías nuevas; DVP intacto).
- **Islas borradas en silencio:** recuentos de relleno iguales por red y capa (ninguna isla nueva).

## Para el revisor
1. **Paralelos:** repetir el volcado y el recuento con su propio script (criterio: ≤ 8°, solape ≥ 2 mm, < 1 mm borde a borde) sobre `FurbyBoard.kicad_pcb` del último commit: deben salir **19 pares**, los de la tabla de NOTAS «Paralelos In2/In3 aceptados», con las separaciones que allí figuran. Comprobar que ninguno lleva una red de clase B, C o D salvo IPROPI ‖ CAM_EN, y juzgar las 19 justificaciones (en especial IPROPI ‖ CAM_EN, EN ‖ U0RX/U0TX y EXP_INT ‖ IR_RX).
2. **M7:** en el PNG de F.Cu (o en el Gerber) alrededor de (−72,4; −82,4) y (−53,6; −78,0): R59 y R60 a 0°, XCLK y PCLK pasando por ellas (pad 1 de R59 al pin 21, pad 2 a J6.13; pad 2 de R60 a J6.17, pad 1 al pin 24), sin vías nuevas (334), Y6/Y7/Y8/Y9 con holguras ≥ 0,2 y el bus entero en F.Cu sobre In1. En el esquema: R59 entre CAM_XCLK_IO (U4.21) y CAM_XCLK (J6.13); R60 entre CAM_PCLK (U4.24) y CAM_PCLK_CAM (J6.17). Valorar el valor (33 Ω) con el cálculo de NOTAS y, si se tiene la hoja del ESP32-S3 a mano, la Rout a su drive por defecto.
3. **Holguras de los movimientos de M1** (todas calculadas, DRC 0 con 0,15 de holgura): BQ_TS a 0,225 de la vía (−69,5; −113,425); LED_PG_A a 0,2 de (−69,225; −116,3); BCLK a 0,2 de (−93,4; −91,95); CAM_EN a 0,25 de (−50,65; −87,8) y 0,3 de (−51,6; −88,6); EN_6V a 0,24 de (−71,2; −99,1); U0RX a 0,21 de (−83,0; −62,99); HOME a 0,5 de (−66,325; −88,95). Vía de retorno de GND a ≤ 1 mm de cada vía de red crítica: sin cambios (ninguna vía se ha movido).
4. **Rellenos:** volcar y comparar con la referencia (GND F 2082,9 mm² en 21 trozos, B 2773,2 en 10, In1/In4 3313,1 en 1, VSYS In2 2619,0 en 3, BAT 31,2 en 1); los trozos sin vía ni pad de su red deben ser los mismos que en la re-revisión del 2026-10-25.
5. **E2:** `make_fab.sh` con `PCB_TOOLKIT=~/development/pcb-toolkit/.venv/bin/pcb-toolkit` (el de pipx no trae la tabla de giros y da 2 «errores» falsos de posición en U4 y J1); abrir `fabricacion/gerber-jlcpcb.zip` en un visor y mirar F.Cu, F.Paste y F.Mask de R59 y R60; contar taladros (383 PTH, 4 NPTH); BOM 52/126.
6. **Documentación:** README (tablas de J6 y del módulo con R59/R60 y las redes cortas), NOTAS (Decisiones del 2026-10-27, Cálculos, «Paralelos In2/In3 aceptados», Revisiones), TEST-PLAN §14 y `fabricacion/README.md` coinciden con `design.py` y con la placa.
