Guilleloma/Furby-GPT/Hardware/FurbyBoard/revisiones/2026-10-24-C-colocacion.md

# Revisión C colocación — FurbyBoard v1.0

- Fecha: 2026-10-24 · Commit: el de la colocación de esta rama (ver `git log`) · Revisor: electronics-engineer (replanteo independiente, modelo T0; revisión propia, no independiente)
- Tipo de placa: L · Capas: 4 · Fabricante: JLCPCB (reglas del perfil en el `.kicad_pro`)
- Material revisado: `FurbyBoard.kicad_pcb` generado por `scripts/gen_pcb.py --sin-rutado` desde `scripts/layout.py`; PNG de `pcb-toolkit png-revision --ratsnest --zona L1,L2` (fuera del repo) y `comprobar-flujo --png`; `render/colocacion-arriba.png` y `render/colocacion-abajo.png`

## Resultado
**PASA** — 0 críticos, 0 importantes, 4 mejoras anotadas. En placa L el encargo termina aquí: la revisión independiente de la colocación la lanza Maestro antes del rutado.

## Herramientas
| Herramienta | Comando | Resultado |
|---|---|---|
| ERC | `kicad-cli sch erc --severity-all --exit-code-violations` | 0/0 |
| DRC | `kicad-cli pcb drc --schematic-parity --severity-all` (sin `--refill-zones`) | **0 infracciones, paridad 0**; 362 conexiones sin rutar (esperable) |
| Flujo | `pcb-toolkit comprobar-flujo FurbyBoard.kicad_pcb --png … --json …` | **PASS**: 0 errores, 4 avisos (desacoplo a 1,02–1,9 mm), 232 conexiones, 9 zonas calientes, demanda máxima de celda 0,58 (umbral 0,8), 0 celdas congestionadas |
| Colocación propia | `scripts/comprobar_colocacion.py` | OK: TP, puentes, LED, botones y pads de cable fuera de la batería; calzos libres; 64 piezas bajo la batería, la más alta L1 (2,1 mm) para 4,1 de hueco; nada bajo el flex |
| Geometría | `pcb-toolkit revisar-rutado` | No aplica (sin rutado) |
| Configuración | `pcb-toolkit.toml` frente a `ejemplos/pcb-toolkit.toml` | Sin reglas en `off` ni umbrales relajados; margen 1,0 mm en las zonas del puente H y de la clase D, justificado en `NOTAS.md` |
| kicad-happy | — | no ejecutado (no instalado) |
| PNG | 12 leídos: `ratsnest_placa`, `montaje-F_placa`, `montaje-B_placa`, zonas U2, U3, U4, U5, U6, U7, U10, J1, J6, J9 | Comentados abajo |

## Hallazgos
| ID | Sev. | Área | Hallazgo | Evidencia | Verificado / supuesto | Corrección | Estado |
|----|---|---|---|---|---|---|---|
| C1 | Mejora | Desacoplo | C10 (100 nF del módulo) a 1,9 mm del pin 2 y C32 (TCA9535) a 1,08 mm: por encima del 1,0 mm ideal, dentro del máximo de 2 mm. C28/C29 (LDO) a 1,02 | `comprobar-flujo` avisos #1–#4 | Verificado | El pad del módulo y el patio de J9 no dejan acercarlos más; aceptado | Aceptado |
| C2 | Mejora | Serigrafía | Rótulos sin sitio: «+» de J2 arriba (BAT+ y BAT− sí están abajo y los pads tienen forma distinta), parte de la leyenda de J_EXP, J5 y los pads 1 y 7 de J9 | `gen_pcb.py` («Rótulos sin sitio») | Verificado | Se recolocan en la fase de rutado con el cobre definitivo; manda el diseño | Abierto (rutado) |
| C3 | Mejora | Buses | `cruces-en-bus` (info): DVP 15, I2S 13, sensado 3 cruces entre líneas rectas del ratsnest | JSON de `comprobar-flujo` | Verificado | Son cruces geométricos de líneas rectas entre una fila de pines y una columna de pads (rutado «de río» sin cruces reales, ver `NOTAS.md` «Pasillos»); los pines del módulo ya siguen el orden de los pads de J6 | Aceptado |
| C4 | Mejora | Batería | La fila trasera de J7 queda con el borde del pad a 0,05 mm del borde delantero nominal de la batería (centro del pad 0,8 mm fuera) | Linter de colocación | Verificado | El cable se suelda por delante; si molesta, J7 sube 0,1 mm a costa del área restringida del módulo | Aceptado |

## PNG leídos
- `ratsnest_placa`: bloques como en `NOTAS.md` («Planta»); el bus DVP (cian) va del lado derecho del módulo a J6 por el pasillo de la cámara sin tocar ninguna zona caliente; el par USB (verde) sube recto por el pasillo norte-sur a 2 mm del hull de L1; el I2S (magenta) va de la columna izquierda a U7 y J5; el sensado (amarillo) solo cruza el módulo (LIGHT, VBAT_SNS por debajo en capas internas). Congestión moderada en el canal de la columna izquierda y en la fila inferior del módulo.
- `montaje-F_placa`: serigrafía de LED, botones y puentes legible; «FurbyBoard v1.0» delante de la antena; polaridades de los LED visibles.
- `montaje-B_placa`: logo entero bajo la zona trasera izquierda de la batería; rótulos de pads de cable y de J_EXP (parciales, C2); BAT+ y BAT−.
- `zona-U5`: SW de U5 arriba, pegado al pad SW de L2; VIN al este con C16; VOUT y GND al sur con C18 (lazo de salida mínimo); compensación y FB al oeste.
- `zona-U2`: C3 (OUT) al norte, C2 (IN) al oeste, C4 (BAT) al sur, EN/PGOOD/CHG al este con sus pull-ups; Q1 y los pads de batería detrás.
- `zona-U6`: lado de control (IPROPI, IN, VREF) al oeste con R28/C23; VM y salidas al este con C22/C20 y los pads del motor de J9; zona caliente solo sobre las salidas.
- `zona-U7`: VDD al norte con C26 a 1,8 mm; salidas al oeste hacia J8.6/7; I2S por el este hacia los pines del sur.
- `zona-U3`: VIN/L1/L2/VOUT al este con la bobina y C7/C8; FB al oeste con R15/R16 pegados.
- `zona-U4`: columna izquierda hacia el expansor y el canal; fila inferior hacia el pasillo de la cámara; pines 35–39 hacia la izquierda por debajo del módulo.
- `zona-J1`: pads del USB-C con U1 detrás y R1/R2 a los lados; nada en la ranura.
- `zona-J6`: pines 7–22 reciben el bus desde el oeste en orden; 1–6 y 10/11 desde los LDO de debajo.
- `zona-U10`: I2C e INT por el este hacia el módulo; acondicionamiento de J8 al oeste.
- `zona-J9`: fototransistor y leva en la columna exterior, lejos de la zona del motor (abajo, columna interior).

## Checklist de la puerta (4.6)
| Sev. | Punto | Estado |
|---|---|---|
| C | Contorno, taladros y conectores coherentes con la carcasa; holgura ≥ 1 mm; fijación por tornillos | OK: `geometria.json` sin cambios (H1–H4, USB-C, agujero del mecanismo); la base no se toca |
| C | Interfaz con piezas reales medida | OK para el USB-C y el contorno (encargos anteriores); el centro del agujero del mecanismo sigue siendo un supuesto (pendiente de medir, `interfaz-base.md`) |
| C | Keepout de antena como área de reglas en todas las capas | OK (`gen_pcb.py`: x −85…−61, y > −62 en las 4 capas) + el área restringida propia de la huella del módulo |
| C | `comprobar-flujo` PASS | OK |
| I | Bloques compactos, cada convertidor como su layout de referencia, corredores reservados | OK (PNG de U5, U3, U6, U2; pasillos en `NOTAS.md`) |
| I | TP junto a su fuente; LED, botones, puentes y conectores accesibles | OK: 14 TP en la cara inferior junto a su fuente (lo comprobará `revisar-rutado --tp-max 5` al rutar); LED, botones y puentes arriba fuera de la batería |
| I | Alturas dentro de la carcasa, por zonas | OK: `comprobar_colocacion.py` (≤ 2,1 mm bajo la batería; nada bajo el flex; nada en la cara inferior salvo TP) |
| I | Taladros con keepout de cabeza y distancia al borde; fiduciales | OK: patio Ø5 de la huella y área sin cobre Ø5 en F/B; H3/H4 a 2,56/2,60 del borde (≥ 1,6); sin fiduciales (montaje Economic) |

## Revisión final como revisor senior
- Bus rápido por un convertidor (lección de esta placa): el DVP va por el pasillo de la cámara, el elevador en la esquina trasera derecha y el buck-boost al oeste del pasillo del USB; `comprobar-flujo` lo vigila con 3 mm.
- TP lejos de su fuente: cada TP a ≤ 5 mm de su pieza, en la cara inferior.
- El cruce del par USB en J1 queda resuelto desde las reglas (vías 0,45/0,2 solo en la clase USB) y la colocación de U1 (`NOTAS.md`, «Par USB»).

## Vuelta 1 — hallazgos de la revisión independiente (2026-10-24)

Entrada: `revisiones/2026-10-24-C-independiente.md` (commit `3575c85`): 0 críticos, 9 importantes (R1–R9), 6 mejoras (R10–R15). Planta, bloques, pasillos y pines sin cambios; solo piezas pequeñas y serigrafía. Sin rutar y sin Freerouting.

### Qué se hizo con cada hallazgo
| Hallazgo | Resolución | Verificado |
|---|---|---|
| R1 TP6 (3V3) y TP9 (I2S_DOUT) lejos de su fuente | TP6 a (−84,5; −110,0) B, a 4,9 mm de C8.1; TP9 a (−91,5; −92,0) B, a 1,5 mm de U7 | `revisar-rutado --tp-max 5` PASS (0 errores; antes 2 tp-lejos) |
| R2 TPS63802 sin su layout de referencia | C6 (Cin) a 90° pegado a VIN al norte, C7 (Cout) a 270° pegado a VOUT al sur con el GND hacia el plano, C8 al lado, L1 desplazada al este (−85,4) para no quedar entre VIN y VOUT; R15/R16 pegados a FB al oeste | PNG `zona-U3`; `comprobar-flujo` PASS (sin bulk-lejos) |
| R3 U5: C18 girado y GND por vías | C18 a 0° en (−50,4; −118,1) bajo los pines 5/6: VOUT–Cout–GND en la misma cara sin vías; C16 a 270° con VIN hacia el pin 7 | PNG `zona-U5`; DRC 0 |
| R4 TS del cargador sin NTC | RT1 Murata NCP18XH103F03RB (LCSC C13564, extended), 10 kΩ B3380 0603, de TS a VSS sin red de polarización (el BQ2407x inyecta la corriente); red `BQ_TS` en `criticas`; colocada en (−80,5; −113,5) bajo la batería, a 15 mm de U2 | ERC 0; esquema regenerado; PNG `zona-RT1` |
| R5 C14 y R21 lejos de COMP/FB | Columna x −53,8 pegada al lado oeste de U5: R22 (−114,5), R21 (−116,1), C15 (−117,7), C14 (−119,3); R24 y C12/R20 en la segunda columna (x −57). Toma Kelvin de V6 para R21 desde el pad de C18 (nota en `NOTAS.md`, «Elevador») | PNG `zona-U5`; DRC 0 (C14 a 0,31 mm del borde, mínimo 0,30) |
| R6 el logo manda sobre los rótulos de J_EXP | Logo regenerado a 0,28 mm/px (10,1 × 9,5 mm) en x −100…−90, y −118…−108; nombre y versión a su derecha y recuadro «PLACA» entre el logo y los pads de cable; `LEYENDA["J11"]` con 5,8 mm de ancho | `render/colocacion-abajo.png`: los 10 pads de J_EXP con su GPIO; logo a 2 mm de J11 y del buck-boost |
| R7 «+» de BAT+ y nombres de TP | `LADO_ARRIBA["J2"] = "U"` («+» en la cara superior); rótulo de cada TP en la cara inferior (`TP_ABAJO`, `LADO_TP = "UDRL"`, colocado en `gen_pcb.rotulos`) | `render/colocacion-arriba.png` («+» y «−»); `render/colocacion-abajo.png` (14 rótulos de TP) |
| R8 R23 fuera del contorno | R23 a (−45,55; −115,7) a 90°; R30 a (−56,2; −111,5) | DRC 0 (sin `copper_edge_clearance`) |
| R9 anillo del mecanismo | Patios a ≥ 2 mm del agujero Ø11,3 (centro supuesto): U9 a 270° en (−47,3; −93,8) con C29 debajo, U11 a 0° con C39 al este, U8 a 270° con C27/C28; JP4 y R40/R42/R50/R51 a la columna x −44 junto a J9 | Linter propio (anillo r + 2 mm); no ha hecho falta cambiar área ni funciones |
| R11 F1 entre J1 y U2 | Descartada: el patio de J1 ocupa el hueco; F1 sigue en (−82,5; −121) | — |
| R12 RC del ADC junto a 38/39 | Queda para v1.1 (anotado en `NOTAS.md`) | — |

### Herramientas (vuelta 1)
| Herramienta | Resultado |
|---|---|
| `kicad-cli sch erc --severity-all` | 0 infracciones |
| `kicad-cli pcb drc --severity-all --schematic-parity` | 0 infracciones, paridad 0, 362 sin conectar (sin rutar) |
| `pcb-toolkit comprobar-flujo` | PASS; 2 avisos conocidos (C10 a 1,90 mm de U4:2 y C32 a 1,08 mm de U10:24, ambos ≤ 2 mm) |
| `pcb-toolkit revisar-rutado --tp-max 5` | PASS, 0 errores (los 14 TP a ≤ 5 mm de su fuente) |
| `scripts/comprobar_colocacion.py` | OK: TP, puentes, LED y botones accesibles; alturas bajo la batería ≤ 2,1 mm |
| kicad-happy | no ejecutado (no instalado) |
| Freerouting | no ejecutado (fuera del encargo) |

### PNG leídos (vuelta 1)
- `zona-U5`: SW contra L2; C16 (VIN) al este; C18 a 0° bajo VOUT/GND, lazo cerrado en la cara superior; columna FB/COMP pegada al oeste.
- `zona-U3`: C6 al norte sobre VIN, C7/C8 al sur sobre VOUT, L1 al este fuera del camino VIN–VOUT; R15/R16 en FB.
- `zona-U2`: C3 (OUT) al norte con R5 al lado, C2 (IN) al oeste, C4 (BAT) al sur; sin cambios de bloque.
- `zona-U6`: control al oeste con R28/C23, VM/salidas al este con C22/C21; el hull de L2 queda 0,3 mm por debajo del sensado de VREF (antes cruzaba).
- `zona-U8`: TP10 (3V3) sobre el pad de entrada de U8; C27 al noreste y C28 bajo VOUT; U9 a 270° al este.
- `zona-RT1`: NTC sola bajo la batería, a 8 mm de F1 y 15 de U2.
- `zona-J1`: pads del USB-C limpios, U1 detrás; nada en el anillo del mecanismo.
- `render/colocacion-arriba.png`: «+» y «−» de la batería, LED/botones/puentes con rótulo, nada dentro del anillo de 2 mm del agujero.
- `render/colocacion-abajo.png`: 14 TP con nombre, 10 pads de J_EXP con GPIO, J5/J7/J8 completos, logo pequeño a la derecha con nombre/versión y recuadro; J9 con 7 de 10 rótulos (EN+, G y ESP sin sitio por TP11; se recolocan con el cobre definitivo) y «IO8» de JP4 solo en la cara inferior.

### Resultado de la vuelta 1
**PASA la puerta C propia** (0 críticos, 0 importantes). Siguiente paso: segunda revisión independiente de la colocación (Maestro) antes del rutado.

## Vuelta 2 — regresión R16 y mejoras R17, R20, R21 (2026-10-24)

Entrada: `revisiones/2026-10-24-C-independiente.md`, sección «Vuelta 1» (commit `5837471`): 1 importante (R16) y mejoras R17–R21. R19 queda para el rutado.

| Hallazgo | Resolución | Medida (borde a borde, pad a pad) |
|---|---|---|
| R16 C12 (2,2 µF de VCC) a 3,86 mm del pin VCC | C12 a (−53,8; −114,5) frente al pin VCC; R21 a la segunda columna (−57; −116,15) a 0°, con la toma de V6 para R21 en Kelvin desde el pad de C18 (se ruta así); R22 baja a (−53,8; −116,1) frente a FB; C15 se queda | C12–U5:2 **0,64 mm** (antes 3,86; vuelta 0: 0,62); R22–FB 0,63; C15–COMP 1,06 (sin cambio) |
| R17 R24 y C14 lejos de COMP | R24 a 180° (COMP al este) en (−57; −117,75) y C14 a 0° justo debajo, en (−56,9; −119,35): el nodo BST_RC mide 0,65 mm entre pads; R24 fuera del tornillo H4 y de la zona caliente de L2 | R24.2–C14.1 0,65 (antes 3,97); R24–COMP 3,93 (antes 3,99: sin sitio en la primera columna) |
| R20 margen de patio al borde | R50 a (−44,5; −112,8) y R23 a (−45,75; −115,7) (más al oeste choca con C16); C14 se ha ido con R17 | Patio al borde: R50 0,35 (antes 0,13), R23 0,32 (0,24), C14 1,05 (0,14) |
| R21 RT1 en el TEST-PLAN | `TEST-PLAN.md` 8.3: V_TS ≈ 0,75 V a 25 °C (75 µA × 10 kΩ), ventana 0–50 °C, hot ≈ 0,31 V (RT1 ≈ 4,2 kΩ, ≈ 50–51 °C) con aire caliente, cold ≈ 2,1 V (28 kΩ, 0 °C) con spray frío; qué hacer si falla | Resistencias de la NTC calculadas con B = 3380 K; umbrales del BQ24073 según la lectura del revisor del datasheet |

Sin regresión de desacoplos: script `medir_desacoplos.py` (scratchpad) mide, para cada condensador, la distancia borde a borde a la patilla de CI más cercana de su red (la misma medida que `comprobar-flujo`) y compara con la línea base del commit `96d64e1`: el único cambio mayor de 0,05 mm es C12 (3,86 → 0,64); ningún condensador que estuviera a ≤ 1 mm ha empeorado.

Herramientas: ERC 0; DRC 0 infracciones, paridad 0, 362 sin conectar; `comprobar-flujo` PASS (avisos C10 1,90 y C32 1,08, conocidos); `revisar-rutado --tp-max 5` PASS; `comprobar_colocacion.py` OK; kicad-happy no instalado; Freerouting no ejecutado.

PNG leídos: `ratsnest_zona-U5` (C12 arriba de la columna oeste sobre VCC, R22 sobre FB, C15 sobre COMP; C18 horizontal bajo VOUT/GND; C16 al este); `ratsnest_zona-C14` (R24 con C14 justo debajo, nodo RC vertical de 0,65 mm, fuera de la zona caliente de L2 y del keepout del tornillo; GND de C14 hacia la isla de señal de U5); `render/colocacion-arriba.png` y `-abajo.png` regenerados.

**Resultado: PASA la puerta C propia** (0 críticos, 0 importantes). Siguiente: revisión independiente breve y rutado.
