Guilleloma/Furby-GPT/Hardware/FurbyBoard/revisiones/2026-10-25-E1-rutado.md

# Revisión E1 diseño listo para fabricar (propia, fin del rutado) — FurbyBoard v1.0

- Fecha: 2026-10-25 · Commit: `24cea7e` · Revisor: electronics-engineer (T1, Opus 5.5), puerta propia del autor; la revisión independiente del diseño va después
- Tipo de placa: L · Capas: 6 (JLC06161H-7628) · Fabricante: JLCPCB
- Material revisado: esquema y PCB del commit, `NOTAS.md`, `README.md`, `TEST-PLAN.md`, `pcb-toolkit.toml`, `.kicad_dru`, `sim/`, `revisiones/2026-10-24-C-independiente.md` («Vuelta 2»); herramientas vueltas a ejecutar sobre copias en el scratchpad; 9 PNG de placa entera y 12 zonas ampliadas leídos
- Herramientas: kicad-cli 10.0.7, pcb-toolkit 0.1.0 (pipx; los PNG con el venv del repo, ver E1-14), kicad-happy v2.3.2 (`2fd9aa0f`), ngspice, rsvg-convert. No se instaló nada

## Resultado
**PASA con hallazgos** — 0 críticos, 0 importantes abiertos (E1-1 cerrado para esta puerta con una acción obligatoria antes de los Gerber), 13 mejoras. **No se ha cambiado el diseño**: el único arreglo trivial que pedía una comprobación (vértice colineal, E1-7) no se aplicó porque regenerar el PCB reordena el fichero entero (diff de 47 734 líneas); queda para la siguiente regeneración.

## Herramientas
| Herramienta | Comando | Resultado |
|---|---|---|
| ERC | `kicad-cli sch erc --severity-all` | **0 / 0** (9 hojas) |
| DRC, placa guardada | `kicad-cli pcb drc --schematic-parity --severity-all` (sin relleno) | **0 infracciones, 0 sin unir, 0 de paridad** |
| DRC, relleno de kicad-cli | `kicad-cli pcb drc --refill-zones --save-board --schematic-parity --severity-all` sobre una copia, y otra vez sin relleno | **0 / 0 / 0**; los rellenos cambian (E1-1) |
| Relleno en proceso aparte | `LoadBoard` + `ZONE_FILLER` + `SaveBoard` con el Python de KiCad sobre otra copia | Idéntico al de kicad-cli (áreas y trozos iguales en las 6 capas) |
| Flujo | `pcb-toolkit comprobar-flujo` | FAIL: 1 error (USB_DP cruza L1, falso positivo aceptado), 4 avisos de desacoplo (C10 1,90; C32 1,08; C22 1,23; C2 1,15 mm) |
| Geometría | `pcb-toolkit revisar-rutado --tp-max 5` (anchos de `pcb-toolkit.toml`) | **PASS, 0 errores, 152 avisos**; 0 `tp-lejos` (TP más lejano: TP12 a 4,29 mm) |
| Geometría estricta | `pcb-toolkit revisar-rutado --tp-max 5 --estricto` | Código 1 por los 152 avisos (el texto y el JSON dicen PASS: E1-14) |
| Configuración | `pcb-toolkit.toml` frente a `ejemplos/pcb-toolkit.toml` | Ninguna regla en `off` ni umbral más laxo. `clearance` 0,15 (la plantilla trae 0,2 solo como respaldo si el `.kicad_pro` no lo da; el proyecto da 0,15). `criticas` limita `CAM_*` al bus DVP (NOTAS, «Decisiones», 2026-10-24) |
| Análisis | `kicad-happy.sh analizar` sobre la copia rellenada | Puerta de fabricación WARN (8 pass, 1 warn, 0 fail, 3 skip); 13 hallazgos de severidad «error», todos justificados o falsos positivos (E1-12) |
| Simulación | `sim/analiza.py` (3 min 29 s) en una copia de `sim/` | 62 PASS, 6 FAIL, 14 informativos: **los mismos veredictos que `sim/RESULTADOS.md`** (E1-14 por el entorno de Python) |
| README frente a `design.py` | Script propio (lee las tablas del README e importa `design.py`) | **136 pines coinciden, 0 discrepancias** (J1 16, J5 6, J6 24, J7 8, J8 7, J9 12, J11 10, U4 37, TCA9535 16); J2 BAT_PAD y J3 GND; 14 TP con su red y su posición iguales en README, `layout.py` y PCB |
| PCB frente al generador | `gen_pcb.py` + `gen_pro.py` en una copia y comparación de huellas, pads, pistas, vías, zonas y dibujos | Idénticos (155 huellas, 522 pads, 1349 pistas y vías, 12 zonas, 194 dibujos); el `.kicad_pro` también. Solo cambia el orden de los elementos en el fichero |
| CPL | `pcb-toolkit comprobar-cpl` | No aplica en E1 (puerta E2) |
| PNG | `render/e1-cobre-{F,In1,In2,In3,In4,B}.png`, `render/e1-serigrafia-{F,B}.png`; teselas y zonas en el scratchpad | 9 de placa entera y 12 zonas leídos (sección «PNG») |

## Comprobaciones del encargo

### 1. Sin unir, DRC y rellenos
- Placa guardada y copia rellenada por kicad-cli: **0 sin unir, 0 infracciones, 0 de paridad** en las dos.
- El relleno de `gen_pcb.py` y el de kicad-cli **no coinciden**. Causa medida: el relleno guardado se queda a **0,55 mm** del contorno y el de kicad-cli a **0,35 mm** (bbox del relleno de In1: 67,85 × 65,33 frente a 68,25 × 65,54 mm). El margen a borde del proyecto es 0,3 mm; 0,5 mm es el valor por defecto de KiCad. `gen_pcb.py` rellena antes de que `gen_pro.py` vuelva a escribir las reglas en el `.kicad_pro` (supuesto sobre el mecanismo exacto, verificado en el efecto). El relleno bueno para fabricar es el de kicad-cli: aplica las reglas del proyecto y es el que harían los Gerber con `--check-zones`. Paso exacto, en `README.md` («Cómo regenerar») y `NOTAS.md` («Pendiente»):

  ```sh
  $KC pcb drc --refill-zones --save-board --schematic-parity --severity-all --exit-code-violations -o /tmp/drc-relleno.rpt FurbyBoard.kicad_pcb
  $KC pcb drc --schematic-parity --severity-all --exit-code-violations -o fabricacion/drc.rpt FurbyBoard.kicad_pcb
  ```

  Después de `gen_pro.py` (si se ha regenerado) y antes de `scripts/make_fab.sh`. Resultado esperado: el de la tabla del punto 5.

### 2. ERC
0 errores y 0 avisos.

### 3. comprobar-flujo
- **Error «USB cruza bobina L1 (USB_DP)»**: falso positivo ya aceptado (NOTAS, «Avisos aceptados»). Medido de nuevo con el cobre: USB_DP a **4,32 mm** y USB_DN a **3,89 mm** del patio de L1, y a **6,63 mm** de las pistas de BB_SW. BB_SW1/2 solo están en F.Cu y no tienen vías. Coincide con NOTAS.
- Avisos de desacoplo: C10 (1,90 mm) y C32 (1,08) ya estaban aceptados. **C22 (1,23 mm de U6:5) y C2 (1,15 mm de U2:13) no**: solo figuraban en «Desviaciones del layout de referencia», con las cifras de la colocación (1,8 y 1,6 mm). C28 y C29 ya no salen. Ver E1-11.
- Cruces dentro de los buses (DVP 15, I2S 5, sensado 3, USB 1): información de líneas rectas, como en la colocación.

### 4. revisar-rutado: avisos por tipo
152 avisos, los mismos en modo normal y estricto. Justificación en NOTAS antes de este encargo y evaluación de E1:

| Tipo | N | ¿Justificado en NOTAS antes de E1? | Evaluación de E1 |
|---|---|---|---|
| `cuello` | 21 | Sí (tabla de raíles: cuellos ≤ 1 mm en U2, U3, U5, U6, U7, Q1 y J1; J6 en «Decisiones») | OK: todos ≤ 1,00 mm y dentro de esos patios, incluido el 3V3 de J6.11 (0,30 mm) |
| `entrada-asimetrica` | 37 | Solo en la tabla «Revisiones» («entradas asimétricas de potencia»), no en «Avisos aceptados» | Mejora E1-3. Todas en 0603 u 0805; peores C3 (1,20/0,40), R10 (1,00/0,20), C2 (1,00/0,30), R13/R38/R52 (0,80/0,15). En 0603 el riesgo de lápida es bajo y el pad de GND va con alivio térmico al relleno |
| `entrada-pad-descentrada` | 32 | Solo TONGUE (C35.1) y CHG (D1.1) | Mejora E1-5. 24 a ≤ 0,30 mm. Las mayores van a lo largo del eje largo de pads grandes: JP1:2 0,675 mm (pad 1,0 × 1,5), C21:1 0,64 (0805), U5:5 0,50, U7:17 0,47 (pad expuesto), U4:11 0,39 (pad del módulo) y R4:1 0,39 |
| `pista-entre-pads` | 6 | No | Mejora E1-5. BST_ILIM bajo C16, I2S_WS bajo C25 y R31, LED_PWR_K bajo D3 y R19, TUMMY bajo C38. Pista de 0,15 mm con máscara entre pads y holgura ≥ 0,15 (DRC): fabricable. Ninguna es un nodo de conmutación |
| `roce-pad` / `roce-via` | 10 / 16 | Solo los de MOT_IN1/MOT_IN2 (bloque M) | Mejora E1-5. Todos ≥ 0,150 mm (clearance del proyecto; JLCPCB pide 0,09 en multicapa); los de 0,150 son I2C_SCL en In3 junto a la columna de vías de x −44,45 |
| `rodeo` | 26 | Solo MOT_IN1 (× 1,70), LED_CHG_A/LED_PG_A (× 1,7–1,9) e IR_PWR (× 1,65) | Mejora E1-4. Por encima del criterio de clase B y C (≤ 1,2): I2S_BCLK 1,40, I2S_DIN 1,32, I2S_DOUT 1,37, I2S_WS 1,59, I2S_WS_MIC 1,85 y USB_DN 1,21. Clase D por encima de 1,5: IPROPI_IO 1,51. El resto son señales lentas (hasta BQ_ILIM × 2,20 y VBUS_IN × 2,03, 31,5 mm a 0,5 mm de ancho) |
| `ancho-mayor-que-pad` | 3 | No (cubierto por las reglas de cuello de Q1 y J1 del `.kicad_dru`) | Mejora E1-5: V6 0,50 en U5:6 (0,45), BAT_G 0,50 en Q1:4 (0,41), VBUS_IN 0,40 en J1:A9 (0,30) |
| `colineales` | 1 | No | Mejora E1-7: USB_DP en B.Cu (−83,0; −79,5) → (−83,5; −80,0) → (−84,3; −80,8), `rutas_fijas.py` línea 343 |

Todos los tipos quedan ahora justificados en NOTAS («Avisos aceptados», filas de E1), **pendientes de que los confirme la revisión independiente**.

### 5. Rellenos por red y capa (relleno de kicad-cli, el de fabricar)
| Red y capa | Área (mm²) | Trozos | Guardado por `gen_pcb.py` |
|---|---:|---:|---|
| GND In1 | 3324,4 | 1 | 3279,4 en 1 |
| GND In4 | 3324,4 | 1 | 3279,4 en 1 |
| GND F.Cu | 2096,3 | 21 | 2055,0 en 21 |
| GND B.Cu | 2799,7 | 10 | 2758,1 en 11 |
| VSYS In2 | 2584,3 | 3 | 2541,8 en 3 |
| BAT F.Cu | 31,2 | 1 | 31,2 en 1 |

**Ningún trozo suelto**: cada trozo contiene una vía de su red o toca un pad de su red. Los que no tienen vía se comprobaron por intersección con el pad:
- F.Cu: U2.4 (0,48 mm²), J5.6 (0,62), J7.3 y J7.7 (9,62).
- B.Cu: cuatro arcos de alivio de J7.3 y J7.7 y dos de J9.10 (1,5–2,0 mm²).
- VSYS de In2: 2525,0 mm² con 14 vías, 34,0 con 2 y 25,3 con 1 (las bolsas de U7 y R54, unidas por sus puentes, NOTAS 93 y 98).
- In1 e In4: un único trozo, sin ranuras, salvo bajo la antena (PNG).
- GND F.Cu tiene seis trozos de 0,2–1,2 mm² alrededor de una sola vía de cosido: inocuos (E1-13, informativo).

### 6. Agujero del mecanismo y taladros
- El agujero del mecanismo es un **corte de Edge.Cuts** (Ø11,3 en (−60,88; −95,32)), no un taladro NPTH: le aplica la regla de JLCPCB de **cobre a borde fresado, ≥ 0,2 mm**, consultada el 2026-10-25 en jlcpcb.com/capabilities/pcb-capabilities. El proyecto exige 0,3.
- Cobre más cercano a su borde: rellenos de GND y VSYS a **0,300 mm** en las 6 capas, MOT_IN2 (B.Cu) **0,342**, IPROPI (In2) 0,430, HOME (In3) 0,630, MOT_IN1 (B.Cu) 0,645 y 0,736. **Cumple la regla del fabricante** (mínimo 0,30 frente a 0,2): no hay crítico.
- **No cumple el punto 9 de la vigilancia** (nada a < 1 mm del borde, por si el agujero se agranda): E1-9. Maestro comunica que Guillermo dio por bueno el agujero el 2026-10-24, pero en el repo seguía como supuesto (E1-10).
- Anillo de 2 mm sin piezas: el patio más cercano está a **2,05 mm** del borde (R26); U11 2,14, R52 2,18, D1 2,21 y TP10 2,29. Cumple.
- Taladros M2 (H1–H4, NPTH Ø2,3): cobre exterior a ≥ 1,33 mm del borde (la cabeza del tornillo no toca cobre). Los planos interiores (GND In1/In4, VSYS In2) quedan a **0,201–0,205 mm** de la pared: es justo el mínimo de JLCPCB, «NPTH to track» 0,2 mm (E1-8).

### 7. Antena y TP
- **Keepout de la antena** (x −85…−61, y > −62): área de reglas en las 6 capas que prohíbe pistas, vías, pads y rellenos. **0 objetos de cobre dentro** (pistas, vías, pads y rellenos, comprobado por intersección en cada capa).
- Keepouts de las cabezas de los tornillos (F.Cu y B.Cu): limpios. kicad-happy marca una vía de IR_TX en (−95,0; −70,9) «dentro» del de H1, pero lo comprueba por la caja: la vía queda a 2,82 mm del centro y el keepout es un círculo de 2,5 mm.
- **TP**: todos a ≤ 5 mm de su fuente: TP12 4,29 mm (U4.41), TP11 4,15, TP6 4,12, TP9 3,48, TP2 3,12, TP7 3,05, TP10 2,81, TP4 2,39, TP1 2,36, TP13 2,28, TP14 1,95, TP8 1,95, TP5 1,20, TP3 0,37. Todos en la cara inferior.

### 8. PNG
Placa entera con `pcb-toolkit png-revision` (40 px/mm, reducida a la mitad para el repo) y serigrafía con kicad-cli + rsvg-convert:
- `e1-cobre-F`: relleno de GND, bus DVP de río del módulo a J6 sin cruces, par USB por el pasillo norte-sur sin vías, lazos de U3, U5, U2 y U7 compactos, F.Cu vacía bajo la antena. Pasa.
- `e1-cobre-In1` / `e1-cobre-In4`: GND continuo, solo antipads, sin ranuras ni dedos; recorte limpio bajo la antena. Pasa.
- `e1-cobre-In2`: relleno de VSYS con los huecos de las señales lentas bajo el módulo e I2S/I2C a la izquierda; las dos bolsas aisladas son las de U7 y R54, con sus puentes. Pasa.
- `e1-cobre-In3`: autopistas de señales lentas, HOME rodeando el agujero en octógono, puente de VSYS de 0,6 mm a R54. Pasa, con los paralelos de E1-6.
- `e1-cobre-B`: relleno de GND partido en franjas por el tronco de 3V3 y las señales, cosido con vías; TP en la cara inferior. Pasa.
- `e1-serigrafia-F`: «FURBYBOARD V1.0» en la franja de la antena, rótulos de LED, botones y puentes sin pisar pads. Pasa.
- `e1-serigrafia-B`: leyendas de J5, J7, J8 y J_EXP con la disposición de los pads, J9 aparte (aceptado), TP con su nombre, BAT+/BAT− grandes, logo y recuadro PLACA. La fecha es «2026-10» a propósito (`params.BOARD_DATE`). Pasa.
- Zonas ampliadas: C16, C25, R31, C38, D3, JP1, C21, R10 y C3 (las de E1-3 y E1-5), y montaje de las dos caras.

### 9. Simulación
Mismos veredictos que `sim/RESULTADOS.md`: 62 PASS y los **6 FAIL documentados**:
- power path: pico de 2,9 A en USB500 con el BAT-FET en su máximo, y enchufe con 5 W en ILIM;
- caída del pico de 10,2 W con 0,21 Ω y con 0,37 Ω;
- ADC de VBAT_SNS a 10 kHz y a 100 kHz.

Todos están cubiertos por las «Reglas para el firmware». Ningún valor cambia. Las únicas diferencias son de formato en la tabla del elevador de `RESULTADOS.md`, escrita a mano con más filas (2,82 A y 19 mV iguales).

### 10. Coherencia README frente a `design.py`
0 discrepancias en 136 pines, en las tablas de conectores, en la del módulo y en la del TCA9535, y 14 TP con la misma red y posición en README, `layout.py` y el PCB.

## Hallazgos
| ID | Severidad | Área | Hallazgo | Evidencia | Verificado / supuesto | Corrección propuesta | Estado |
|----|---|---|---|---|---|---|---|
| E1-1 | Importante | Rellenos (4.7 C «rellenos no desfasados») | El relleno guardado en el repo no es el que se fabricaría: `gen_pcb.py` rellena con 0,5 mm de margen a borde en vez de 0,3 (−45 mm² en In1/In4, GND B.Cu 11 trozos en vez de 10) | Punto 1 y tabla del punto 5 | Verificado (efecto); la causa exacta en `gen_pcb.py`, supuesto | Por instrucción de Maestro, no se rellena el repo. El relleno de kicad-cli se verificó sobre una copia (DRC 0/0/0, sin trozos sueltos) y el paso exacto queda en README y NOTAS. **Es obligatorio antes de los Gerber (E2)** | Cerrado para E1; acción en E2 |
| E1-2 | Mejora | Documentación | 7 de los 9 tipos de aviso de `revisar-rutado`, 2 avisos de `comprobar-flujo` y los 13 «error» de kicad-happy no estaban justificados en NOTAS | Puntos 3, 4 y E1-12 | Verificado | Filas de E1 en «Avisos aceptados» (este commit); las confirma la revisión independiente | Cerrado (documentado) |
| E1-3 | Mejora | DFA (`layout-pcb.md` §12, pasivos pequeños) | 37 entradas asimétricas en 0603/0805 | Punto 4; PNG de C3, R10 y C2 | Verificado | v1.1: estrechar a ≤ 0,4 mm la pista ancha en los últimos 0,5 mm antes del pad o igualar las dos entradas. Mirar la soldadura de C3, C2, R10, R13, R38, R41 y R52 en las primeras placas | Abierto (v1.1) |
| E1-4 | Mejora | Rodeos de clase B, C y D | I2S de × 1,32 a × 1,85, USB_DN × 1,21 e IPROPI_IO × 1,51, sin justificar | Punto 4 | Verificado | Aceptables: BCLK ≈ 3 MHz, 35–51 mm sobre In1 a 0,40 mm, desfase máximo ≈ 15 mm (0,1 ns frente a 325 ns de periodo); par USB con 0,97 mm de diferencia entre D+ (58,09 mm) y D− (59,06); IPROPI_IO es casi continua. Justificado en NOTAS | Cerrado (documentado) |
| E1-5 | Mejora | Pegas del PNG (`layout-pcb.md` §15) | 6 pistas entre pads de pasivos, 30 entradas descentradas sin justificar, 21 roces sin justificar, 3 pistas más anchas que el pad | Punto 4; PNG de R31, C16 y JP1 | Verificado | Fabricables y con DRC limpio. Justificado en NOTAS; v1.1, sacar I2S_WS de debajo de C25 y R31 y BST_ILIM de debajo de C16 si se recoloca | Cerrado (documentado); v1.1 |
| E1-6 | Mejora | Apilado (In2 e In3 adyacentes) | 4 paralelos In2/In3 a menos de 1 mm, contra la regla de «Apilado»: VBAT_SNS ‖ U0RX 0,66 mm × 11,4 mm (−65,4; −64,3), IPROPI ‖ CAM_EN 0,70 × 9,3, BQ_TS ‖ LED_CHG_A 0,90 × 6,5, I2S_BCLK ‖ EXP_P07 0,95 × 4,5 | Script de paralelos (In3/B.Cu no cuenta: In4 los apantalla) | Verificado (geometría); acoplo, supuesto | Despreciables: VBAT_SNS tiene C5 de 100 nF (≈ 0,5 pF × 3,3 V da ≈ 16 µV); CAM_EN y LED_CHG_A son estáticas; EXP_P07 es lenta. v1.1: separar ≥ 1 mm | Abierto (v1.1) |
| E1-7 | Mejora | Geometría (`layout-pcb.md` §12) | Vértice colineal en USB_DP de B.Cu (−83,5; −80,0) | `revisar-rutado` (`colineales`) | Verificado | Quitar `(-83.5, -80.0)` en `rutas_fijas.py`:343 en la próxima regeneración. No se aplicó: regenerar reordena el `.kicad_pcb` entero (diff de 47 734 líneas) por un cambio estético | Abierto |
| E1-8 | Mejora | DFM, taladros M2 | Planos interiores a 0,201 mm de los NPTH de Ø2,3: justo el mínimo de JLCPCB (0,2) | Punto 6 | Verificado | Regla en el `.kicad_dru` que aleje a ≥ 0,3–0,5 mm el cobre interior de los NPTH (holgura frente al tornillo metálico) y volver a rellenar. Se puede hacer en E2 junto con el relleno: solo cambian los rellenos | Abierto |
| E1-9 | Mejora | Mecánica (vigilancia, punto 9) | Pistas a menos de 1 mm del borde del agujero: MOT_IN2 0,34, IPROPI 0,43, HOME 0,63, MOT_IN1 0,645/0,736 mm | Punto 6 | Verificado | Cumplen la regla de JLCPCB (0,2) y el agujero está dado por bueno. Si algún día hubiera que agrandarlo, MOT_IN2 e IPROPI son lo primero que se cortaría | Aceptado |
| E1-10 | Mejora | Documentación | El agujero del mecanismo figuraba como «supuesto, medir antes de pedir» en NOTAS, README y `../PCB-suelo/interfaz-base.md` §4, cuando Guillermo lo dio por bueno el 2026-10-24 (dato de Maestro, no consta en el repo) | Búsqueda en el repo | Verificado (documentos); la decisión, comunicada por Maestro | NOTAS («Decisiones» y «Pendiente») y README actualizados en este commit. **`interfaz-base.md` está fuera de la carpeta de la placa: lo actualiza otro encargo** | Parcial |
| E1-11 | Mejora | Documentación | C22 (1,23 mm) y C2 (1,15 mm) no estaban aceptados; «Desviaciones del layout de referencia» daba 1,8 y 1,6 mm (cifras de la colocación) | `comprobar-flujo` | Verificado | Fila en «Avisos aceptados» (este commit). Las cifras de «Desviaciones» se actualizan en el próximo encargo de NOTAS | Cerrado (aviso); cifras abiertas |
| E1-12 | Mejora | kicad-happy | 13 «error» (sin críticos ni altos con ese nombre). Falsos positivos o decisiones ya tomadas: SW-003 (lazo de U5 «C25 → U5 → L2», pero C25 es del amplificador y el lazo real es VOUT–C18–GND sin vías); PP-001 (U6.5 VM en V6, que es la salida de U5); keepouts de H1–H4 y del logo comprobados por la caja; J1 fuera del contorno (USB-C de montaje medio, regla del `.kicad_dru`); 0 fiduciales (montaje Economic, `layout-pcb.md`); SU-001 (In2/In3 adyacentes, decisión del apilado); SW-001 (armónicos de U3); 150 frente a 155 huellas (H1–H4 y LOGO1). **DC-002: U1 (USBLC6-2SC6) sin condensador en VBUS_IN**; C1 está tras F1 | JSON de kicad-happy (scratchpad) | Verificado salvo DC-002 (recomendación del fabricante sin comprobar en su hoja) | Justificados en NOTAS. DC-002: 100 nF en VBUS_IN junto a U1.5 en la v1.1, con la TVS ya prevista | Cerrado (documentado); DC-002 v1.1 |
| E1-13 | Mejora | Flujo de scripts | Causa de E1-1: `gen_pcb.py` rellena antes de que el `.kicad_pro` tenga las reglas, y `make_fab.sh` no vuelve a rellenar. Seis trozos de GND de F.Cu de 0,2–1,2 mm² alrededor de una sola vía (inocuos) | Punto 1 | Verificado | Mover el relleno a un paso aparte después de `gen_pro.py` (o al principio de `make_fab.sh`, con `--refill-zones --save-board`) | Abierto |
| E1-14 | Mejora | Herramientas | (a) El pcb-toolkit de pipx no tiene Pillow (`png-revision` y `--png` dan código 2): se usó `~/development/pcb-toolkit/.venv`. (b) Con `--estricto` el código es 1 pero el texto y el JSON dicen «PASS». (c) El `python3` del PATH no tiene numpy ni matplotlib: `sim/analiza.py` se ejecutó con `Hardware/Base-furby/.venv` sobre una copia de `sim/`. (d) `gen_pcb.py` no da el mismo fichero byte a byte (mismo contenido, otro orden) | Salidas de las órdenes | Verificado | (a) y (c): Maestro decide si instalar los extras. (b) y (d): mejoras para pcb-toolkit y para `gen_pcb.py` (ordenar los elementos antes de guardar) | Abierto (Maestro) |

## Lista de vigilancia de la revisión C independiente («Vuelta 2»)
| # | Punto | Estado en E1 |
|---|---|---|
| 1 | Par USB | OK. D+ unido en F.Cu en J1; D− cruza por B.Cu con vías de 0,45/0,2 solo en la clase USB (regla del `.kicad_dru`); 0 errores de `via-sin-retorno` en redes críticas; par de 0,28/0,15 por el pasillo norte-sur y el canal; D+ 1 vía, D− 2 vías (≤ 2 cambios de capa); 0,97 mm de diferencia de longitud; rodeo de D− × 1,21 (E1-4). TP2 y TP3 cuelgan del par como ramales cortos, irrelevantes a 12 Mbit/s (aceptado) |
| 2 | DVP | OK. Las 12 líneas en F.Cu, de río en orden de pads (PNG), con In1 continuo debajo; ningún cruce con zonas calientes (`comprobar-flujo` solo da el falso positivo del USB) |
| 3 | Lazos calientes | OK. BST_SW, BB_SW1 y BB_SW2 solo en F.Cu y **sin vías**. El camino de 2,9 A de BAT (Q1 → C4 → U2.2/U2.3) va entero por el polígono de F.Cu, sin cambio de capa; entra en U2 con el ancho del pad (cuello aceptado). Sus 3 vías solo llevan el divisor (R13) y TP4. VSYS con 17 vías y los puentes de 2 vías por extremo (NOTAS 93). MOT_OUT a 0,5 mm; SPK_P/N en F.Cu sin vías a 0,4 mm |
| 4 | Clase D | OK. `revisar-rutado` sin errores de retorno ni de roce en BQ_TS, IPROPI, MOT_VREF, VBAT_SNS, LIGHT, ENC_PT ni en las realimentaciones; IPROPI y MOT_VREF salen por el oeste de U6 (bloque M). Paralelos In2/In3 en E1-6 |
| 5 | Relleno de VSYS en In2 | OK con puentes. 3 trozos: el principal (2525 mm², 14 vías) y las bolsas de U7 y R54, alimentadas por el puente de B.Cu de 0,6 mm con 2 vías por extremo y por el de In3 (NOTAS 93 y 98) |
| 6 | Canal x −86,5…−82,5 | OK (PNG de F.Cu e In2): I2S y par USB en F.Cu; I2C, INT, HOME y ENC_IO por In2 e In3 |
| 7 | Antena | OK. 0 cobre en el keepout de las 6 capas; cosido del bloque E: fila de vías de GND en y −64,9 y vías de borde |
| 8 | Serigrafía (R19) | Aceptado en NOTAS: leyenda de J9 aparte, «IO8» de JP4 solo abajo, sin título «J5», cuatro rótulos de 0,8 mm. DRC de serigrafía 0 (severidades en error) |
| 9 | Mecanismo: nada a < 1 mm del borde | **No se cumple** (E1-9), aunque sí la regla del fabricante; el anillo de 2 mm sin piezas, sí (2,05 mm) |
| 10 | Puerta D | DRC 0/0 con paridad y `revisar-rutado` sin errores. El contraste del relleno sobre una copia **da otro relleno** (E1-1). No hay autorrutador propio ni Freerouting (0 ejecuciones) |

## Entrada para la revisión independiente: excepciones, micromovimientos y permutaciones (NOTAS, «Decisiones»)
**Excepciones a reglas y criterios:**
- Margen a borde de 0,12 mm solo para los pads de J1 (USB-C de montaje medio, `.kicad_dru`).
- Vías de 0,45/0,2 solo en la clase USB.
- Cuellos de 0,25 mm (0,2 en J1, 0,15 en J6, 0,5 en Q1) dentro de los patios de U2, U3, U5, U6, U7, Q1, J1 y J6.
- `criticas` limitada al bus DVP.
- Vías en el pad expuesto de U2:17, U6:9, U7:17 y U4:41 (POFV de serie en 6 capas).
- 20 pads de GND sin vía propia, unidos por el relleno de F.Cu.
- VSYS de U7 por un puente de B.Cu con 2 vías por extremo, y de R54 por un puente de In3 con 1 vía por extremo.
- Bolsa de VSYS de In2 bajo J7 eliminada.
- Huecos del cosido de borde: junto a J_EXP/J5, junto a R40/J9, en (−103; −72) y en el USB-C.
- Rótulos de 0,8 mm, leyenda de J9 a 22 mm, «IO8» y el título de J5 sin sitio.
- Rodeos aceptados de MOT_IN1, LED_CHG_A/LED_PG_A e IR_PWR.
- Y las filas de E1 en «Avisos aceptados»: entradas asimétricas, descentradas, pistas entre pads, roces, rodeos, anchos mayores que el pad, colineal, C22/C2 y kicad-happy.

**Micromovimientos (≤ 2 mm):**
- R36 y R37 intercambiadas; C40 a 180°; C4 a (−63,9; −114,55).
- JP1–JP3 en fila y JP3 a 270°; R18 junto al pin 27; SW1/SW2 0,4/0,2 mm al este.
- TP2, TP3 y TP11 recolocados; TP14 a (−98,3; −86,4).
- Bloque RC de J8: columna izquierda 0,3 mm al oeste y cinco piezas a 180°.
- R28 0,17 mm al norte y C23 0,30 mm al sur (bloque M); D1 0,1 mm al norte (bloque U); R43 0,13 mm al sur (bloque U2).
- Vías de PGOOD, TONGUE_PAD y VSYS de U7 desplazadas ≤ 1 mm.

**Permutaciones:**
- J9.11/J9.12 (MOT_OUT2/MOT_OUT1).
- J_EXP: 5 EXP_P07, 6 SCL, 7 U0TX, 9 SDA, 10 U0RX.
- J7.3 ↔ J7.8 (J7.3 a GND, J7.8 a IR_PWR).
- Puertos del TCA9535 en ciclo: P03 LED_RUN_K, P04 EXP_P07, P17 IR_PWR.
- GPIO del módulo y puertos del expansor asignados por geometría (replanteo).

**Cambios de componente desde la colocación aprobada:**
- C41 nuevo (10 µF, C19702) en VDD de U7.
- R57/R58 de 1 kΩ (antes 2,2 kΩ y 1,5 kΩ).
- RT1 NTC en TS (crítico B7).
- LED del encoder desde V6 por 470 Ω, sin AO3400A.

## Checklist de la puerta E1
| Ref. | Sev. | Punto | Estado |
|---|---|---|---|
| 4.1 | C/I | Alimentación y protección | OK por las puertas A y B y por la simulación (6 FAIL con regla de firmware); sin cambios en E1 |
| 4.2 | C/I | MCU, señales e interfaces | OK (puerta B; pines de arranque en el README; consola UART en J_EXP) |
| 4.3 | C | Pinout y huellas | OK (puerta B); el giro del CPL se comprueba en E2 |
| 4.3 | I | Código, stock y precio | Pendiente de E2: C23179 e Isat de la FHD4020S-1R0MT antes del pedido (NOTAS) |
| 4.4 | I | Simulación y cálculos | OK (punto 9) |
| 4.5 | C/I | RF y alta velocidad | OK: módulo con antena integrada y keepout limpio; USB FS sin impedancia controlada (NOTAS, «Apilado») |
| 4.6 | C | Contorno, taladros, keepout de antena, flujo | OK; el agujero, dado por bueno por Guillermo (E1-10); flujo, solo el falso positivo aceptado |
| 4.6 | I | TP junto a su fuente; holguras | OK (TP ≤ 4,29 mm) |
| 4.7 | C | DRC con paridad 0/0 y rellenos no desfasados | DRC OK; rellenos: **E1-1** (verificado el relleno de fabricación; paso obligatorio en E2) |
| 4.7 | C | `revisar-rutado` con los anchos, 0 errores; los mismos anchos en el `.kicad_dru` | OK (12 redes de potencia en los dos) |
| 4.7 | C | `pcb-toolkit.toml` sin reglas apagadas ni umbrales laxos | OK |
| 4.7 | C | Anchos y vías de potencia | OK (vigilancia 3) |
| 4.7 | I | PNG de toda la placa | OK (punto 8); pegas en E1-3, E1-5 y E1-7 |
| 4.7 | I | Plano continuo, lazos, pares, analógico lejos de conmutados | OK (vigilancia 1–6); E1-6 |
| 4.7 | M | Lágrimas | No hay (mejora ya conocida; vías de 0,6/0,3 con anillo de 0,15) |
| 4.9 | C | `TEST-PLAN.md` | OK: cortos sin alimentar (§2), fuente limitada (§3), polaridad inversa sin USB y con USB (§8.1) |
| 4.9 | I | TP, GND para la sonda, puentes; firmware de prueba por bloques | OK (14 TP, 3 de GND, JP1–JP5; TEST-PLAN §5–§16) |
| — | — | kicad-happy sin críticos ni altos sin justificar | OK tras E1-12 |

## Revisión final como revisor senior
- **Rutado en escalera, solapes, picos o autorrutado en bucle:** no. Todo el rutado es explícito en `rutas_fijas.py`, sin autorrutador; `revisar-rutado` da 0 errores de ángulo, escalera, solape o colgante.
- **Bus rápido cruzando un convertidor:** no (DVP, I2S y USB lejos de L1/L2; el único aviso es el falso positivo medido).
- **TP lejos de su fuente:** no (máximo 4,29 mm).
- **«DRC 0» tomado como calidad:** se revisaron además los 152 avisos uno a uno por tipo, los PNG de las 6 capas y la geometría frente al agujero y la antena.
- **Rellenos guardados distintos de los fabricados:** **sí se repetía** la lección de la Game Boy y de la FurbyBoard (E1-1). Queda cubierta por el paso obligatorio antes de los Gerber.
- **Serigrafía bajo el mínimo:** cuatro rótulos de 0,8 mm, aceptados y documentados.
- **Giros del CPL, Gerber y CPL con distinto origen:** se comprueban en E2 (`make_fab.sh` ya usa el origen auxiliar en los dos).
- **Lección para el Cerebro** (la pasa Maestro; este encargo no escribe en el Cerebro): un generador que rellena antes de escribir las reglas del proyecto deja rellenos con las reglas por defecto de KiCad (0,5 mm a borde). El relleno va en un paso aparte, después de escribir el `.kicad_pro`.
