Guilleloma/Furby-GPT/Hardware/FurbyBoard/render/colocacion-abajo.png

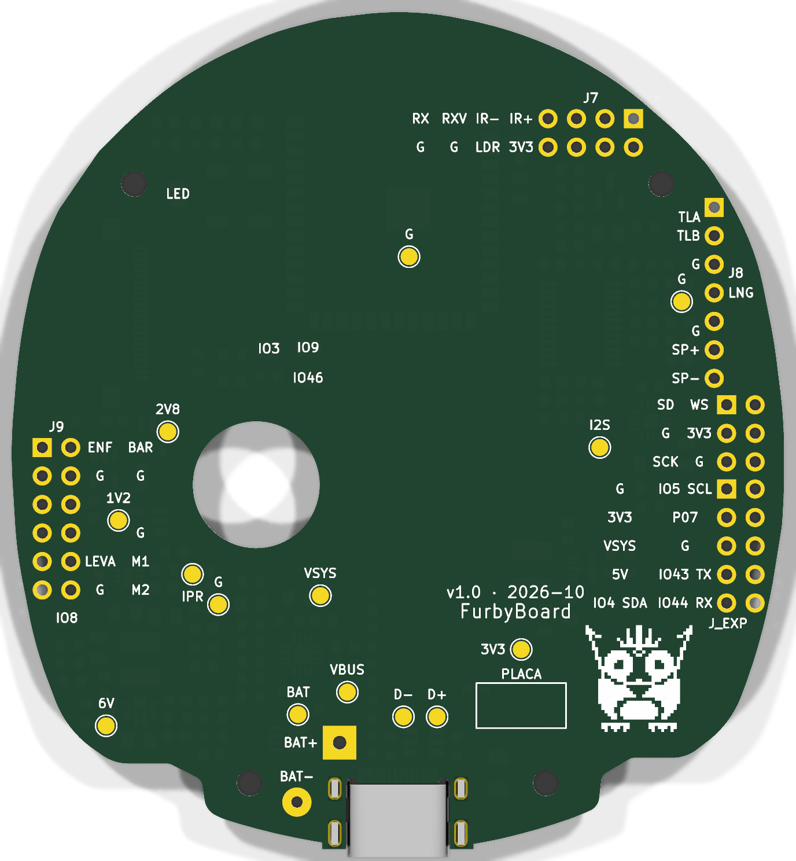
Hardware/FurbyBoard/render/colocacion-abajo.png
