Guilleloma/Furby-GPT/Hardware/FurbyBoard/render/colocacion-arriba.png

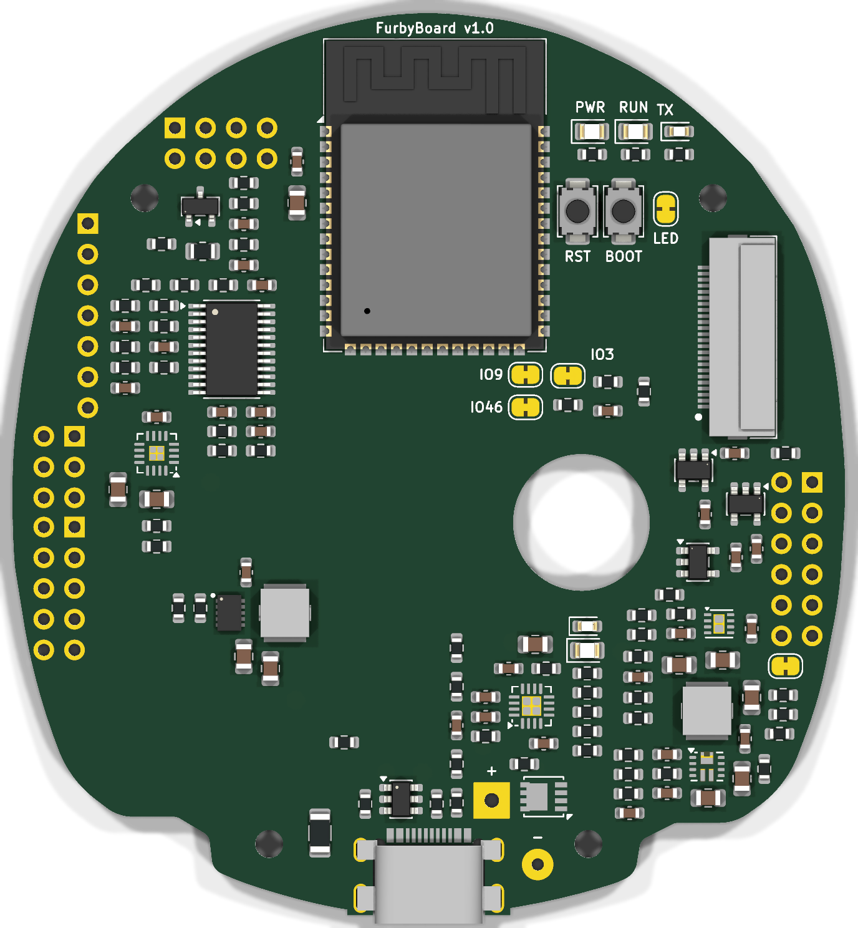
Hardware/FurbyBoard/render/colocacion-arriba.png
