Guilleloma/Furby-GPT/Hardware/FurbyBoard/render/e1-cobre-B.png

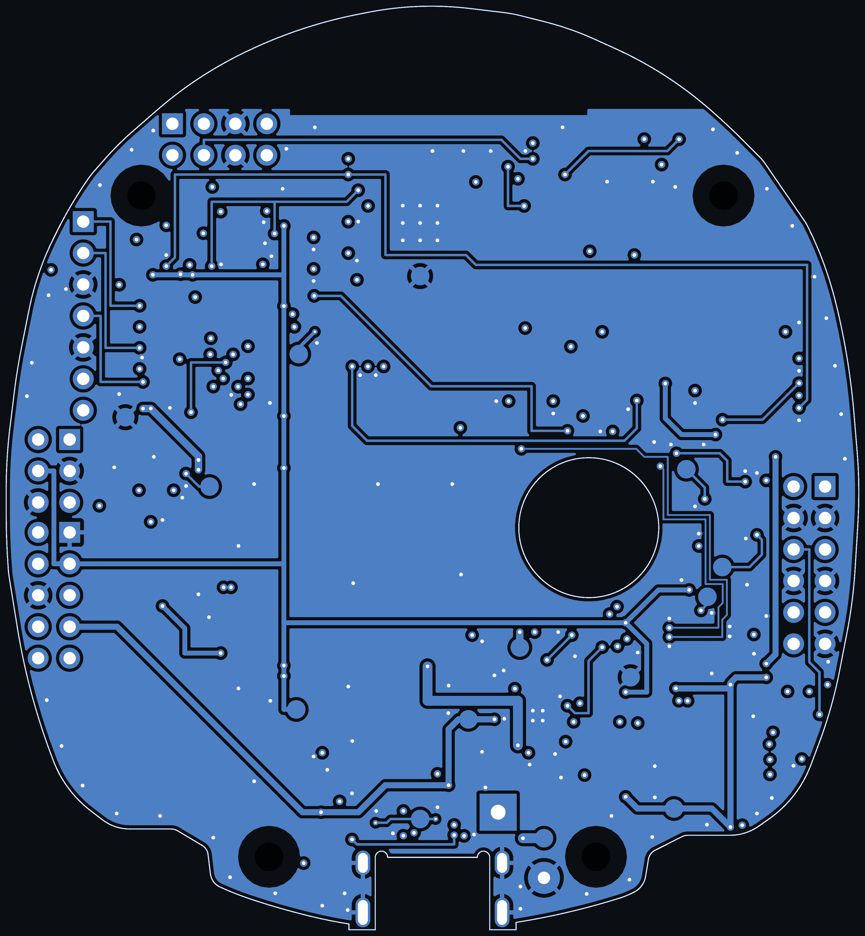
Hardware/FurbyBoard/render/e1-cobre-B.png
