Guilleloma/Furby-GPT/Hardware/FurbyBoard/render/e1-cobre-F.png

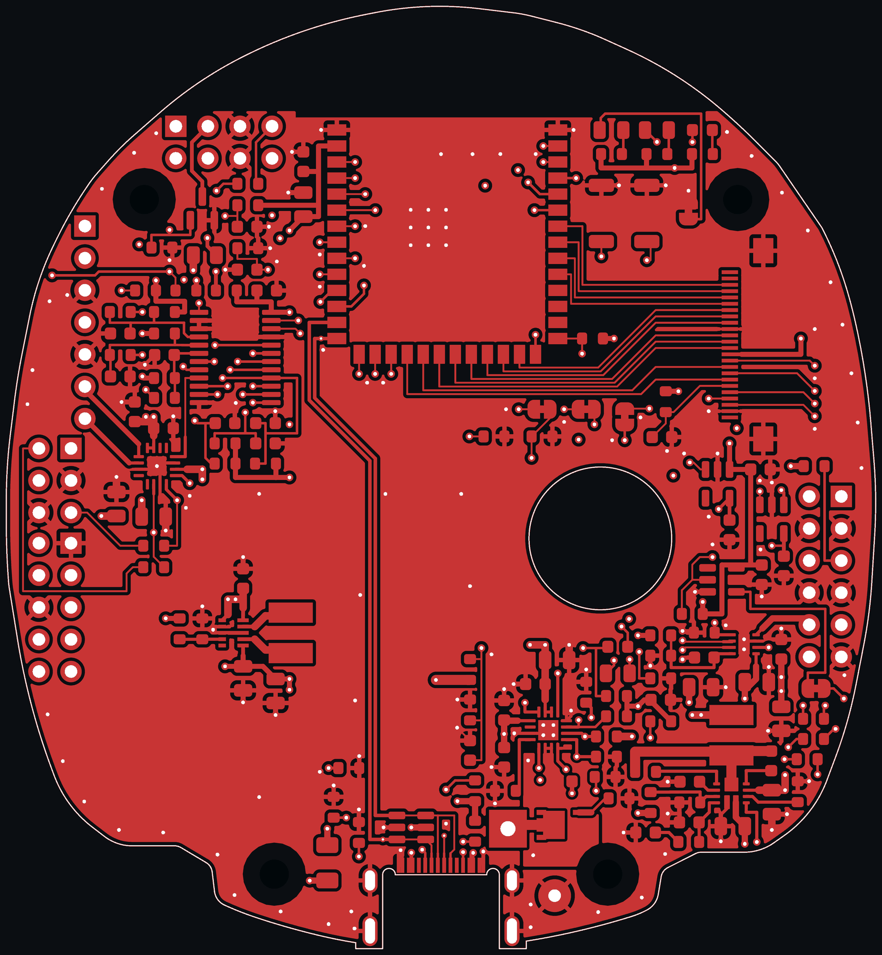
Hardware/FurbyBoard/render/e1-cobre-F.png
