Guilleloma/Furby-GPT/Hardware/FurbyBoard/render/e1-cobre-In3.png

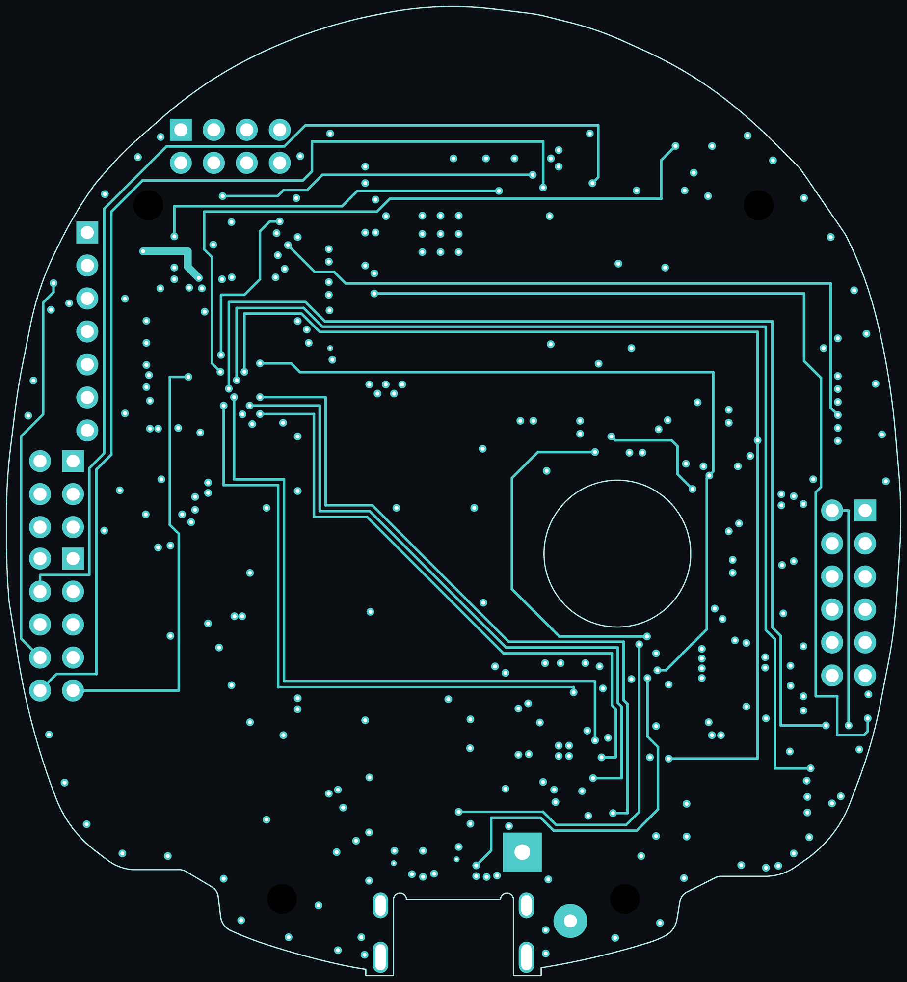
Hardware/FurbyBoard/render/e1-cobre-In3.png
