Guilleloma/Furby-GPT/Hardware/FurbyBoard/render/e1-cobre-In4.png

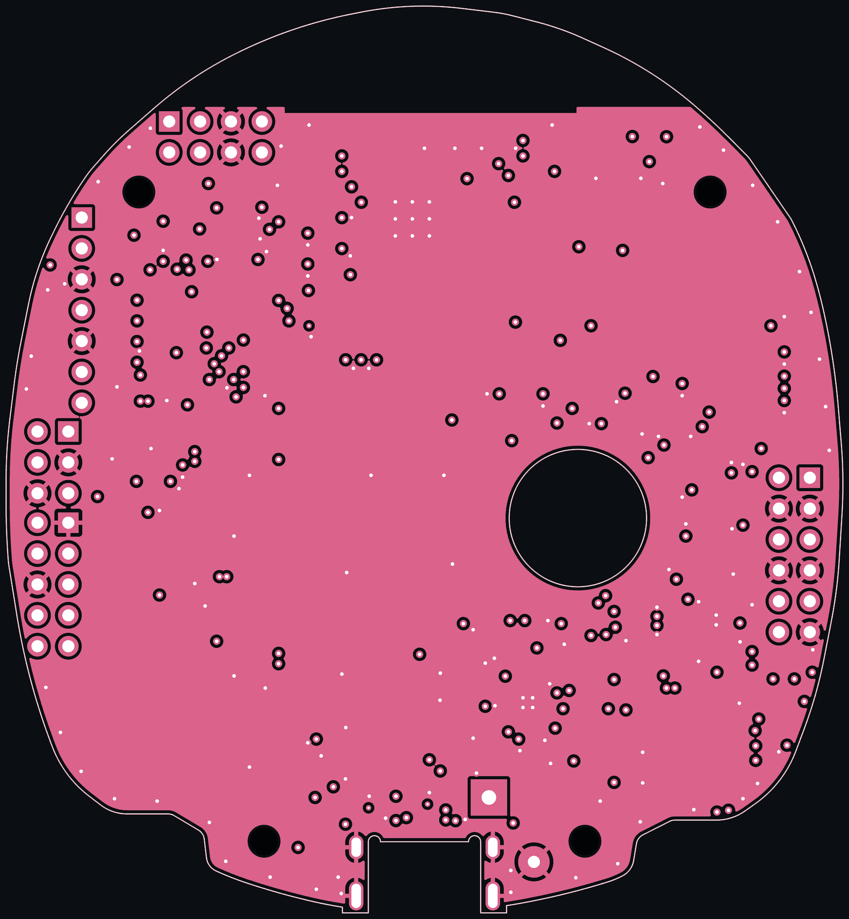
Hardware/FurbyBoard/render/e1-cobre-In4.png
