Guilleloma/Furby-GPT/Hardware/FurbyBoard/render/e1-serigrafia-F.png

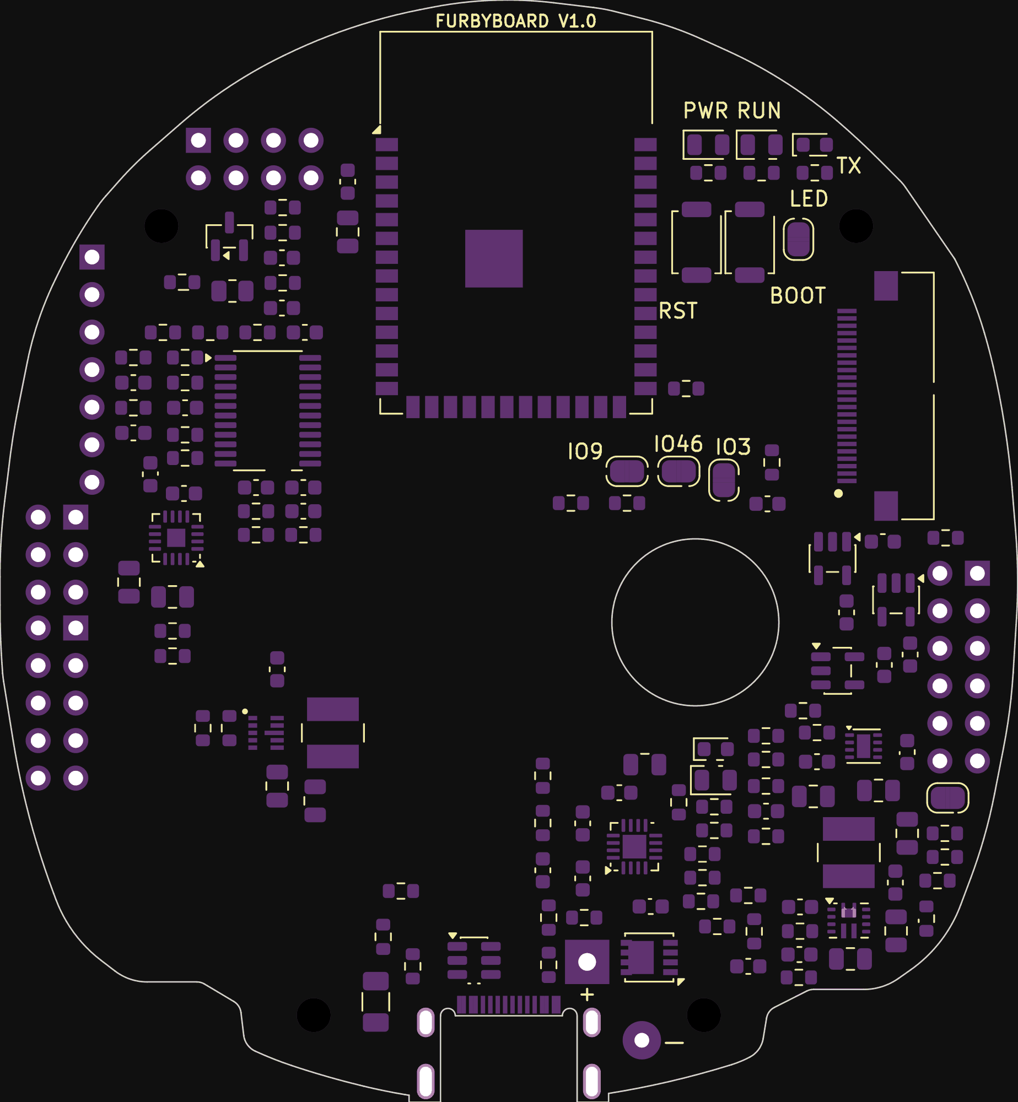
Hardware/FurbyBoard/render/e1-serigrafia-F.png
