Guilleloma/Furby-GPT/Hardware/FurbyBoard/render/furbyboard-iso.png

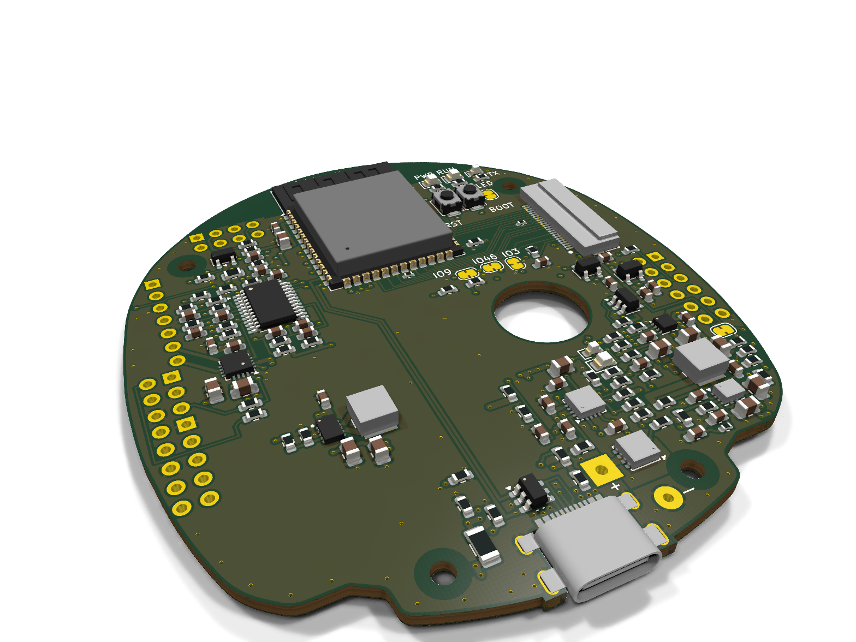
Hardware/FurbyBoard/render/furbyboard-iso.png
