Guilleloma/Furby-GPT/Hardware/FurbyBoard/render/remate-zona-cargador-elevador.png

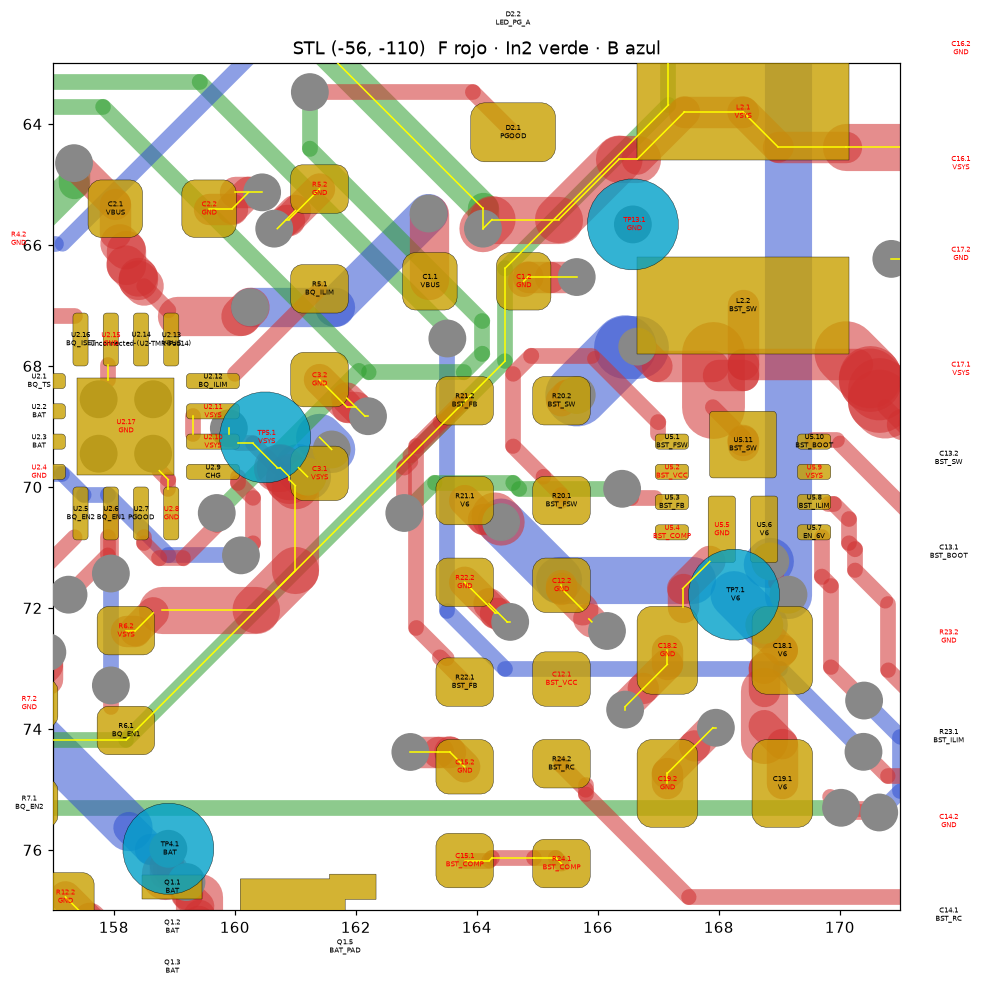
Hardware/FurbyBoard/render/remate-zona-cargador-elevador.png
