Guilleloma/Furby-GPT/Hardware/FurbyBoard/sim/png/arranque.png

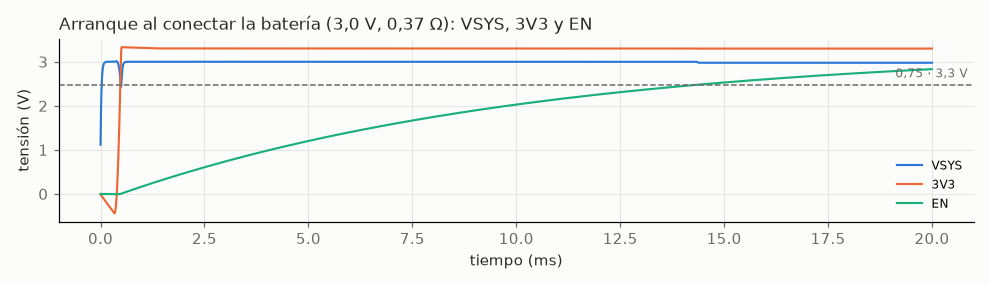
Hardware/FurbyBoard/sim/png/arranque.png
