Guilleloma/Furby-GPT/Hardware/FurbyBoard/sim/png/bq24073_desenchufe.png

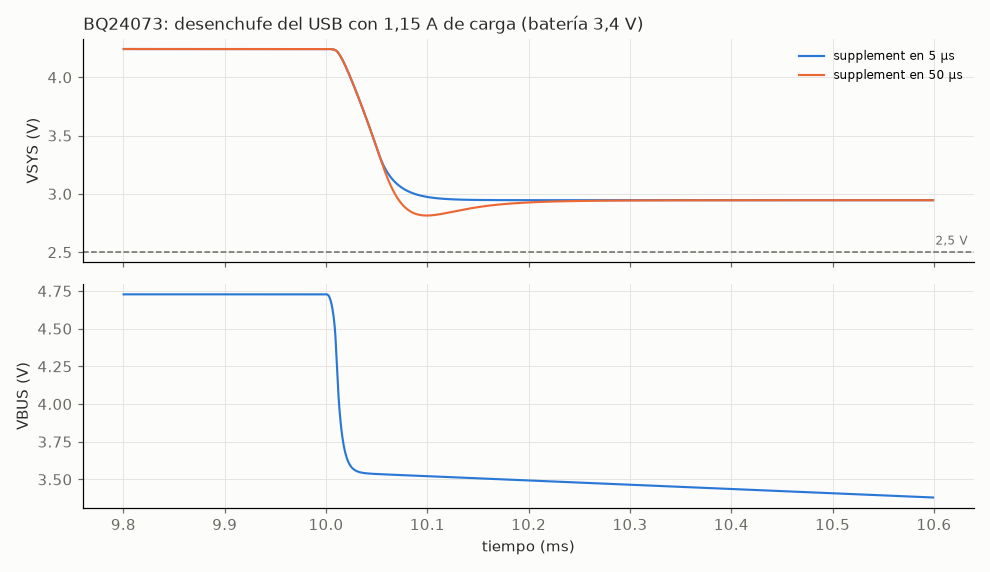
Hardware/FurbyBoard/sim/png/bq24073_desenchufe.png
