Guilleloma/Furby-GPT/Hardware/FurbyBoard/sim/png/bq24073_enchufe.png

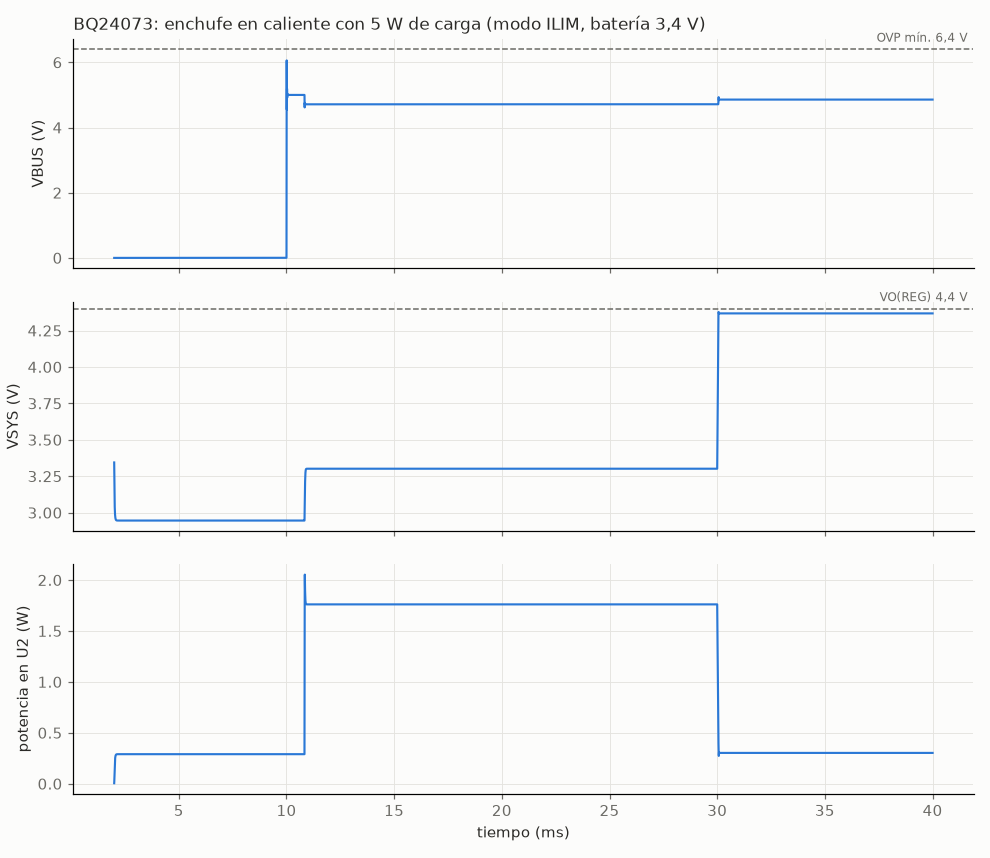
Hardware/FurbyBoard/sim/png/bq24073_enchufe.png
