Guilleloma/Furby-GPT/Hardware/FurbyBoard/sim/png/bq24073_supplement.png

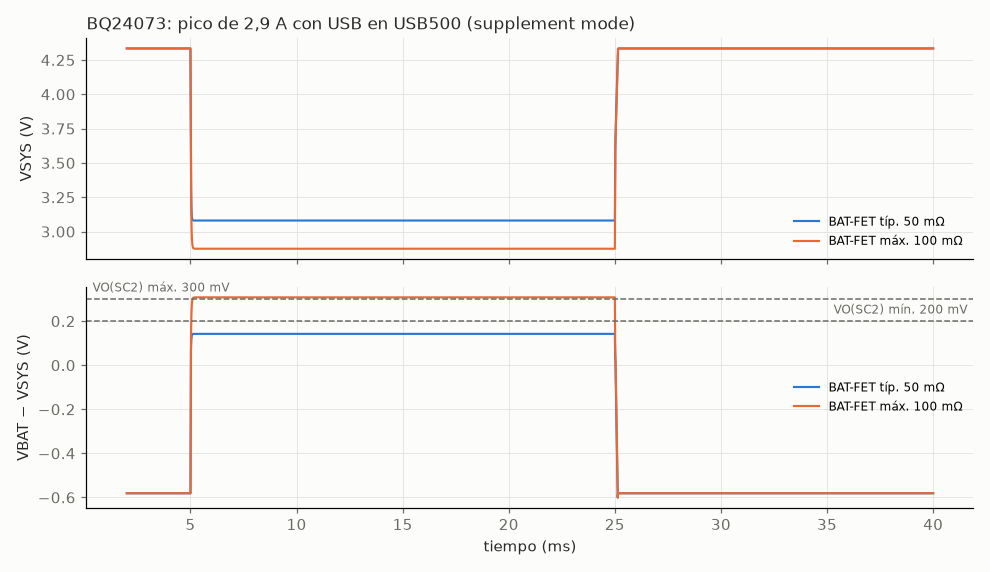
Hardware/FurbyBoard/sim/png/bq24073_supplement.png
