Guilleloma/Furby-GPT/Hardware/FurbyBoard/sim/png/caida_bateria.png

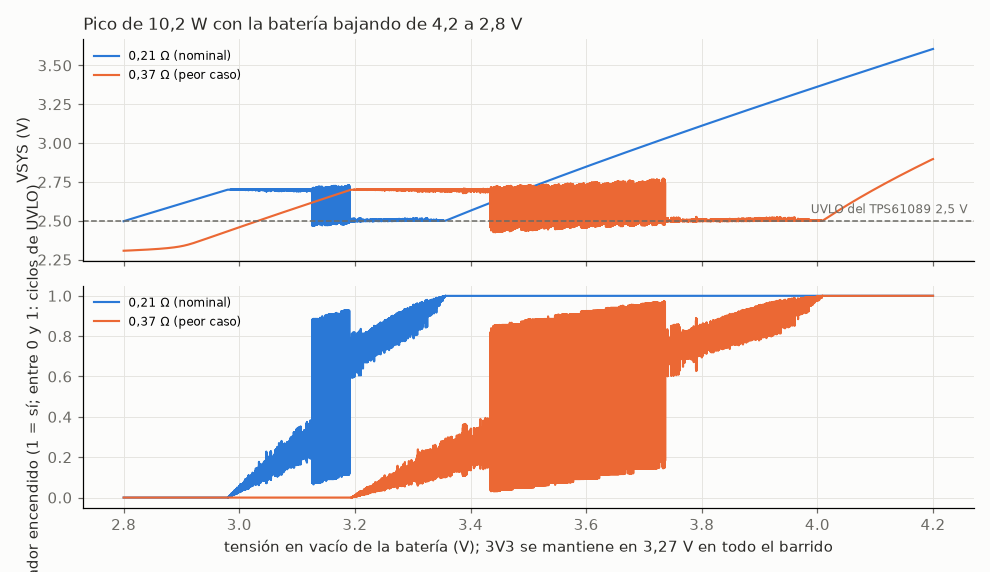
Hardware/FurbyBoard/sim/png/caida_bateria.png
