Guilleloma/Furby-GPT/Hardware/FurbyBoard/sim/png/drv_inversion.png

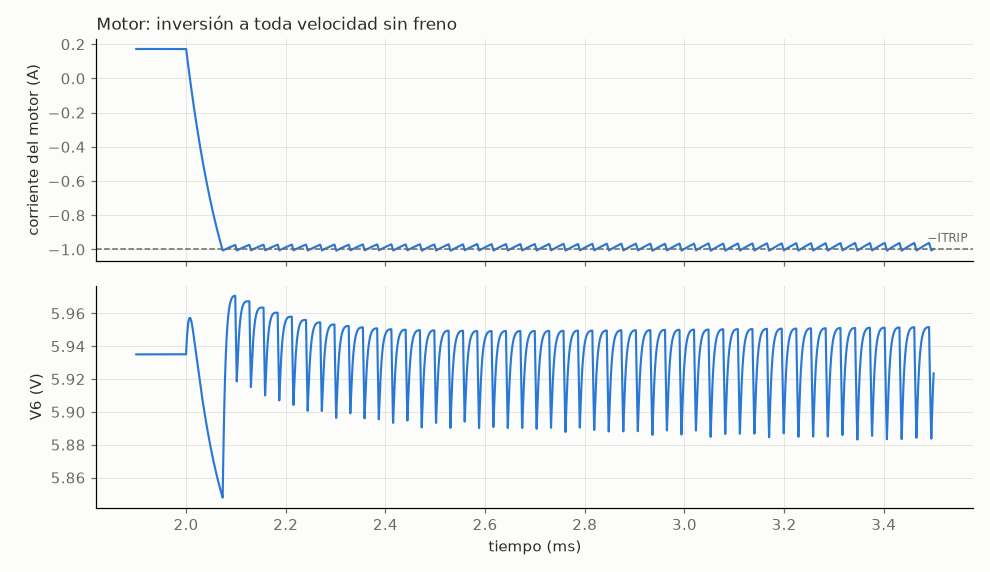
Hardware/FurbyBoard/sim/png/drv_inversion.png
