Guilleloma/Furby-GPT/Hardware/FurbyBoard/sim/png/ldo_arranque.png

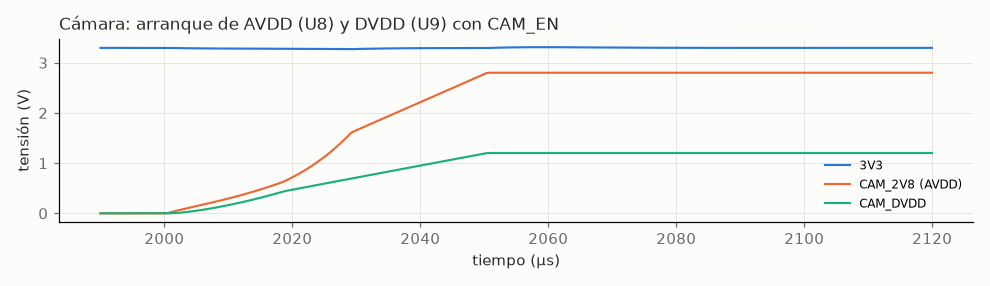
Hardware/FurbyBoard/sim/png/ldo_arranque.png
