Guilleloma/Furby-GPT/Hardware/FurbyBoard/sim/png/ntc_ts.png

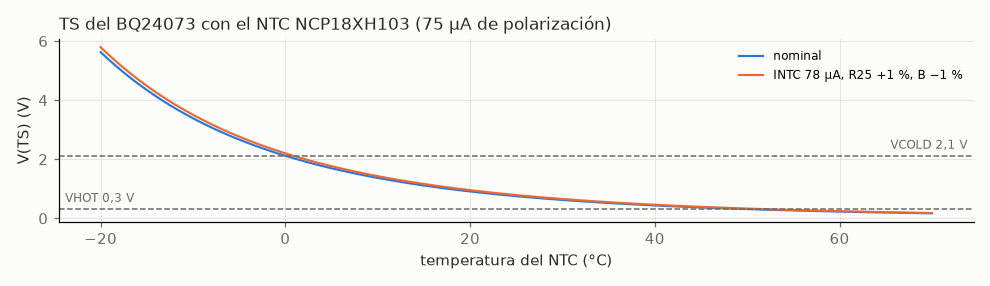
Hardware/FurbyBoard/sim/png/ntc_ts.png
