Guilleloma/Furby-GPT/Hardware/FurbyBoard/sim/png/q1_reves_con_usb.png

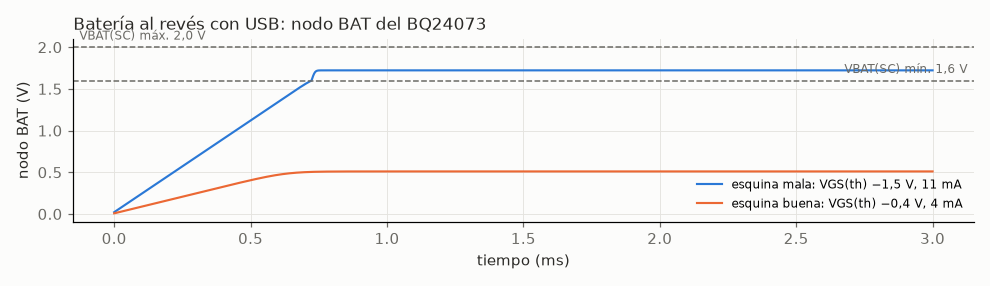
Hardware/FurbyBoard/sim/png/q1_reves_con_usb.png
