Guilleloma/Furby-GPT/Hardware/FurbyBoard/sim/png/tps63802_rizado.png

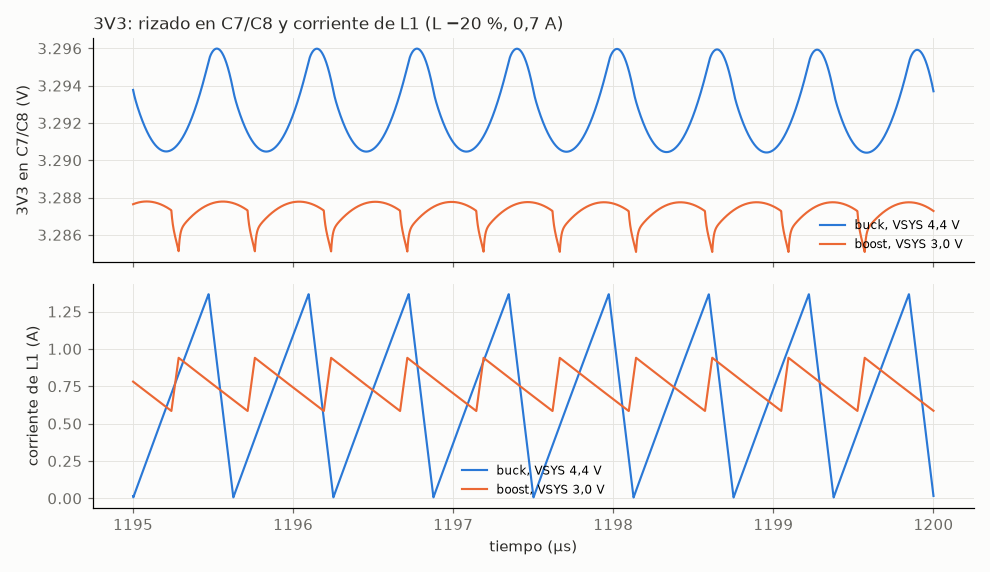
Hardware/FurbyBoard/sim/png/tps63802_rizado.png
