Guilleloma/Furby-GPT/Hardware/PCB-suelo/render/planta.png

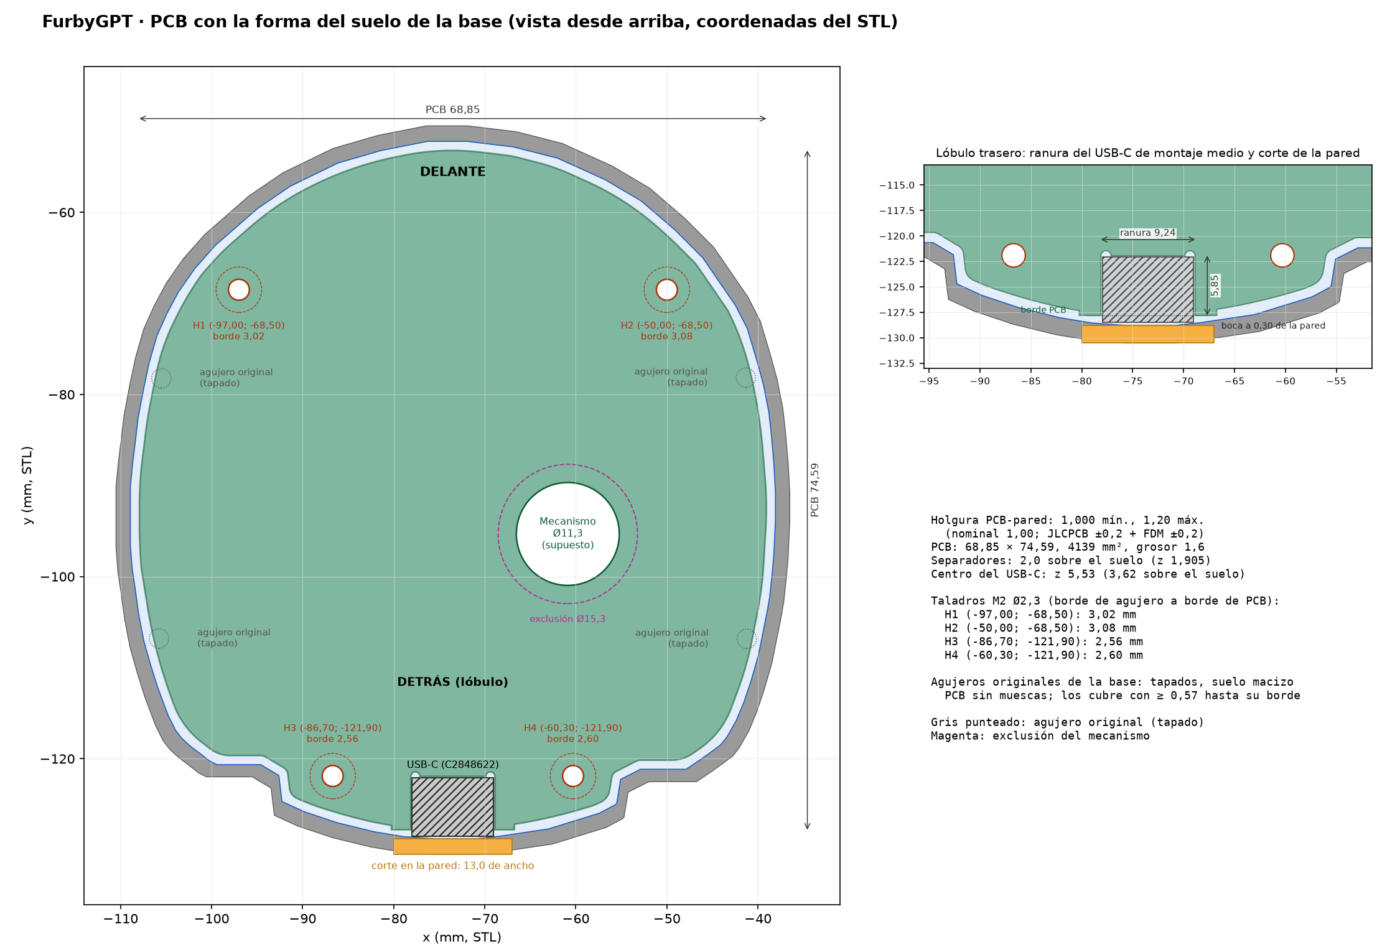
Hardware/PCB-suelo/render/planta.png
