Guilleloma/Furby-GPT/Hardware/FurbyBoard/fabricacion/bom-jlcpcb.csv

Comment | Designator | Footprint | LCSC Part #
10u | C1,C3,C4,C6,C41 | C_0603_1608Metric | C19702
1u | C2,C11,C27,C28,C29 | C_0603_1608Metric | C15849
100n | C5,C10,C13,C22,C23,C26,C30,C31,C32,C33,C34,C35,C36,C37,C39,C40 | C_0603_1608Metric | C14663
22u | C7,C8,C9,C16,C17,C18,C19,C20,C21,C24,C25 | C_0805_2012Metric | C45783
2.2u | C12 | C_0603_1608Metric | C23630
4.7n | C14 | C_0603_1608Metric | C53987
10p | C15 | C_0603_1608Metric | C1634
10n | C38 | C_0603_1608Metric | C57112
Rojo | D1,D3 | LED_0603_1608Metric | C2286
Verde | D2,D4,D5 | LED_0805_2012Metric | C2297
1.5A | F1 | Fuse_1206_3216Metric | C883133
USB-C 16P | J1 | USB_C_HRO_TYPE-C-31-M-13C | C2848620
FPC 24P 0.5 | J6 | FPC_AFC01-S24FCA-00 | C262669
0.47u | L1 | L_Changjiang_FHD4020S | C602026
1u | L2 | L_Changjiang_FHD4020S | C602028
SI7615ADN | Q1 | Vishay_PowerPAK_1212-8_Single | C553966
AO3400A | Q3 | SOT-23 | C20917
5.1k | R1,R2 | R_0603_1608Metric | C23186
1.8k | R4 | R_0603_1608Metric | C4177
1.2k | R5 | R_0603_1608Metric | C22765
100k | R6,R7,R8,R9,R22,R25,R29,R30,R33,R49,R55 | R_0603_1608Metric | C25803
2.2k | R10,R11 | R_0603_1608Metric | C4190
10k | R12,R17,R18,R27,R34,R35,R38,R52 | R_0603_1608Metric | C25804
470k | R13,R14,R53 | R_0603_1608Metric | C23178
510k | R15 | R_0603_1608Metric | C23192
91k | R16 | R_0603_1608Metric | C23265
1.5k | R19,R28 | R_0603_1608Metric | C22843
150k | R20 | R_0603_1608Metric | C22807
390k | R21 | R_0603_1608Metric | C23150
270k | R23 | R_0603_1608Metric | C22965
33k | R24 | R_0402_1005Metric | C25779
4.7k | R26,R36,R37 | R_0603_1608Metric | C23162
33 | R31,R32 | R_0603_1608Metric | C23140
47k | R39,R41,R43 | R_0603_1608Metric | C25819
1k | R40,R42,R44,R46,R48,R50,R56,R57,R58 | R_0603_1608Metric | C21190
220k | R45,R47 | R_0603_1608Metric | C22961
220 | R51 | R_0603_1608Metric | C22962
22 | R54 | R_0805_2012Metric | C17561
33 | R59,R60 | R_0402_1005Metric | C25105
10k NTC | RT1 | R_0603_1608Metric | C13564
RESET / BOOT | SW1,SW2 | SW_SPST_TS-1088-xR020 | C720477
USBLC6-2SC6 | U1 | SOT-23-6 | C2687116
BQ24073RGTR | U2 | VQFN-16-1EP_3x3mm_P0.5mm_EP1.6x1.6mm | C15220
TPS63802DLAR | U3 | Texas_DLA_VSON-10_2x3mm_P0.5mm | C2845237
ESP32-S3-WROOM-1-N16R8 | U4 | ESP32-S3-WROOM-1 | C2913202
TPS61089RNRR | U5 | Texas_VQFN-RNR0011A-11 | C165129
DRV8231ADSGR | U6 | Texas_DSG0008A_WSON-8-1EP_2x2mm_P0.5mm_EP0.9x1.6mm | C5139865
MAX98357AETE+T | U7 | TQFN-16-1EP_3x3mm_P0.5mm_EP1.23x1.23mm | C910544
ME6211C28M5G-N | U8 | SOT-23-5 | C53099
ME6211C12M5G-N | U9 | SOT-23-5 | C236672
TCA9535PWR | U10 | TSSOP-24_4.4x7.8mm_P0.65mm | C130204
SN74LVC1G17DBVR | U11 | SOT-23-5 | C7836
