Guilleloma/Furby-GPT/Hardware/FurbyBoard/render/furbyboard.step

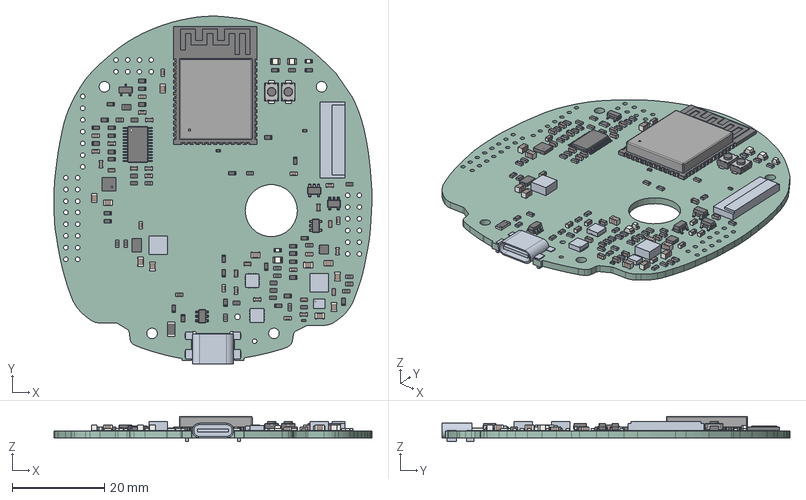
[picture p66: CAD file, 2026-10-27]
Hardware/FurbyBoard/render/furbyboard.step
68.8 x 75.3 x 5.50 mm
R_0603_1608Metric x 56
SW_SPST_TS-1088-xR020 x 2
C_0603_1608Metric x 30
R_0402_1005Metric x 3
LED_0805_2012Metric x 3
C_0805_2012Metric x 11
ESP32-S3-WROOM-1
R_0805_2012Metric
SOT-23-6
WSON_8_1EP_2x2mm_P05mm_EP09x16mm
LED_0603_1608Metric x 2
WSON-10-1EP_2x3mm_P0.5mm_EP0.84x2.4mm
Fuse_1206_3216Metric
TSSOP-24_4.4x7.8mm_P0.65mm
SOT-23-5 x 3
SOT-23
TQFN_16_1EP_3x3mm_P05mm_EP16x16mm
FurbyBoard_PCB
