Guilleloma/Furby-GPT/Hardware/PCB-suelo/contorno-pcb.dxf

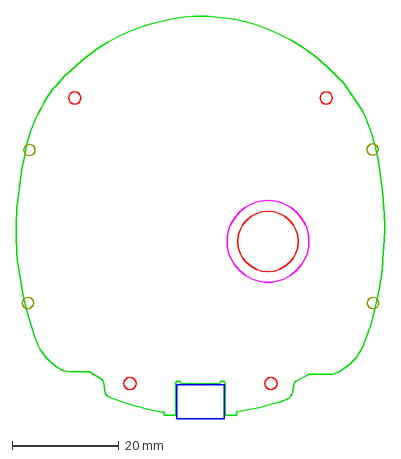
[picture p67: CAD file, 2026-10-25]
Hardware/PCB-suelo/contorno-pcb.dxf
68.8 x 75.3 mm
