Guilleloma/Furby-GPT/3D Prints/readme

https://www.tinkercad.com/things/ggFgPefmAW7-furby-1998-base-adult
