Guilleloma/Furby-GPT/3D Prints/WhatsApp Image 2024-03-22 at 01.04.49.jpeg

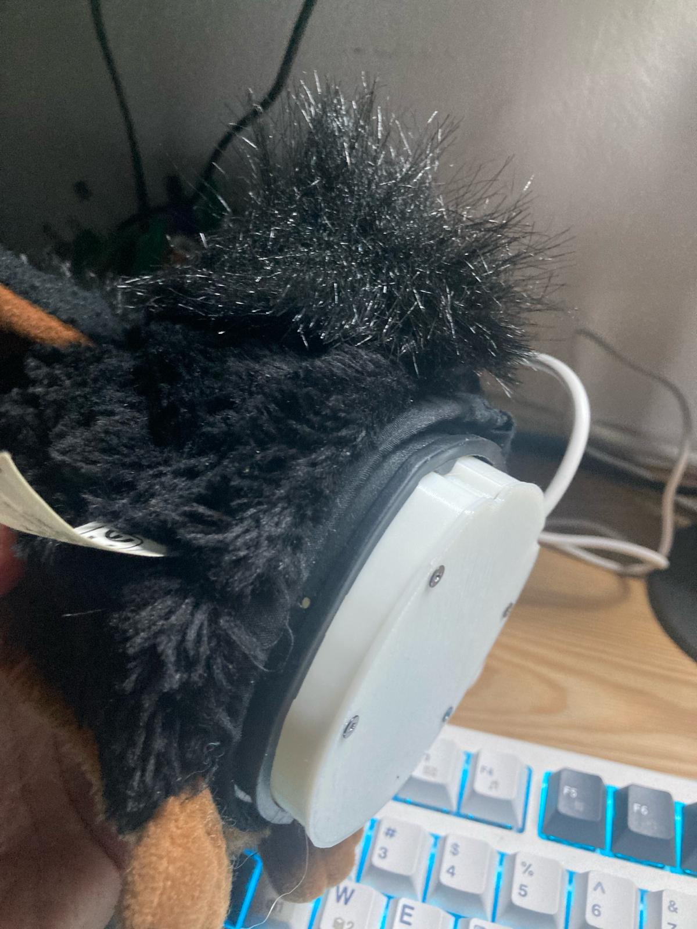
3D Prints/WhatsApp Image 2024-03-22 at 01.04.49.jpeg
