Guilleloma/Furby-GPT/Hardware/FurbyBoard/FurbyBoard.kicad_pcb

## KiCad design Hardware/FurbyBoard/FurbyBoard.kicad_pcb (2026-10-27)

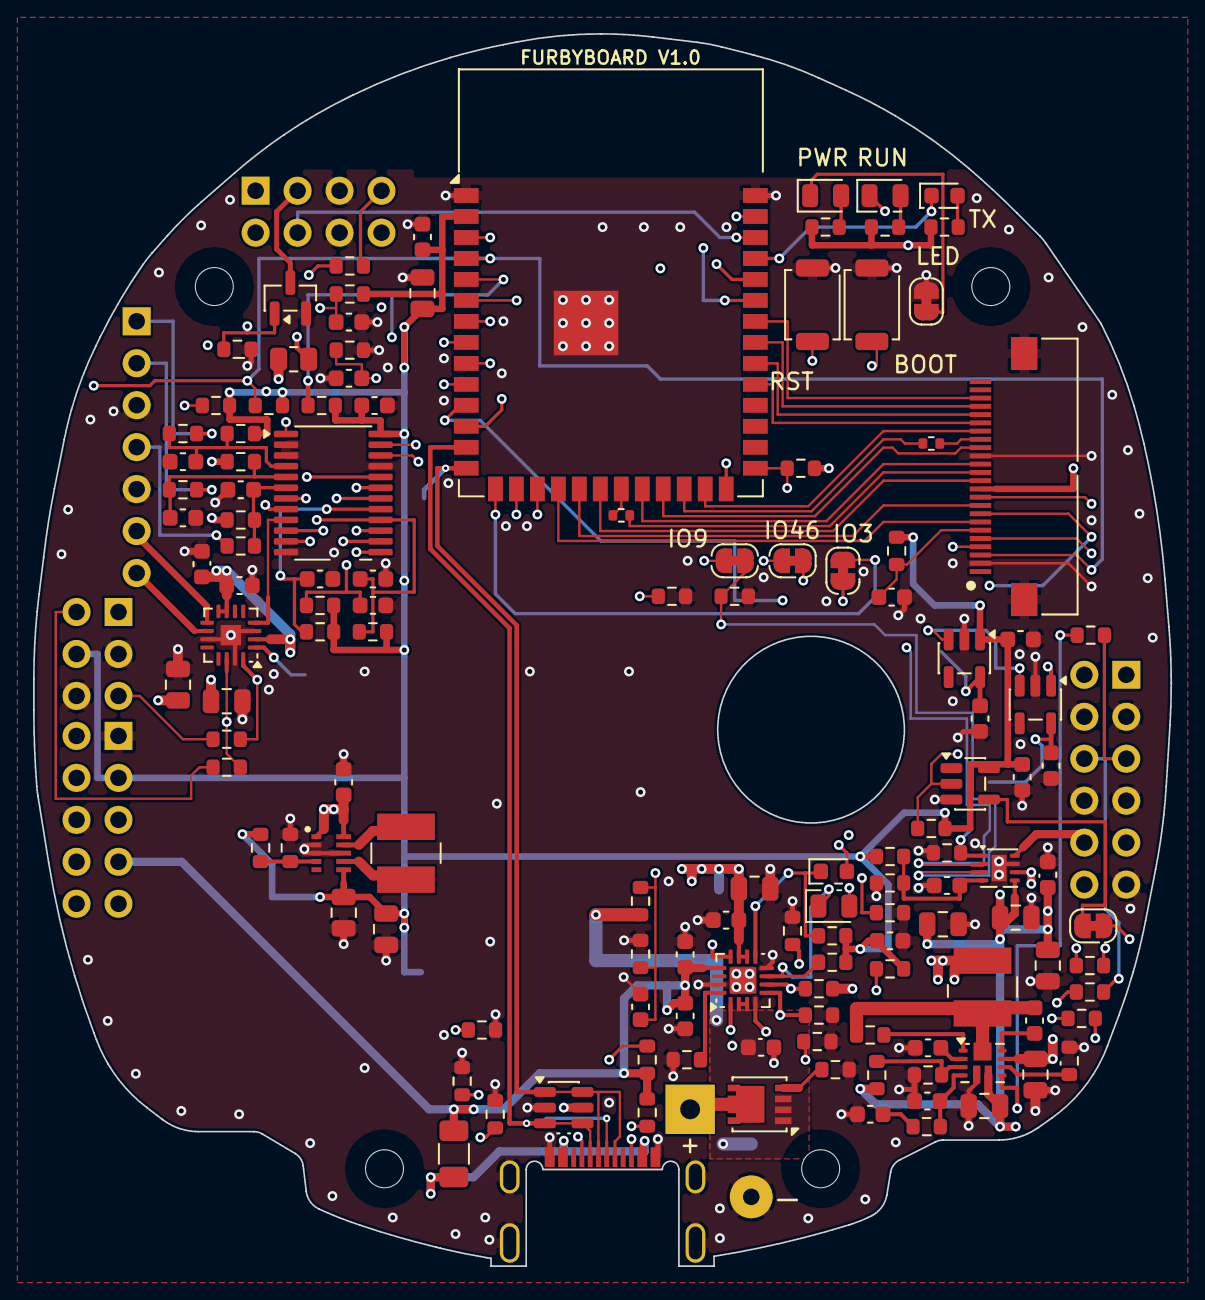
[picture p78: board FurbyBoard.kicad_pcb from above]

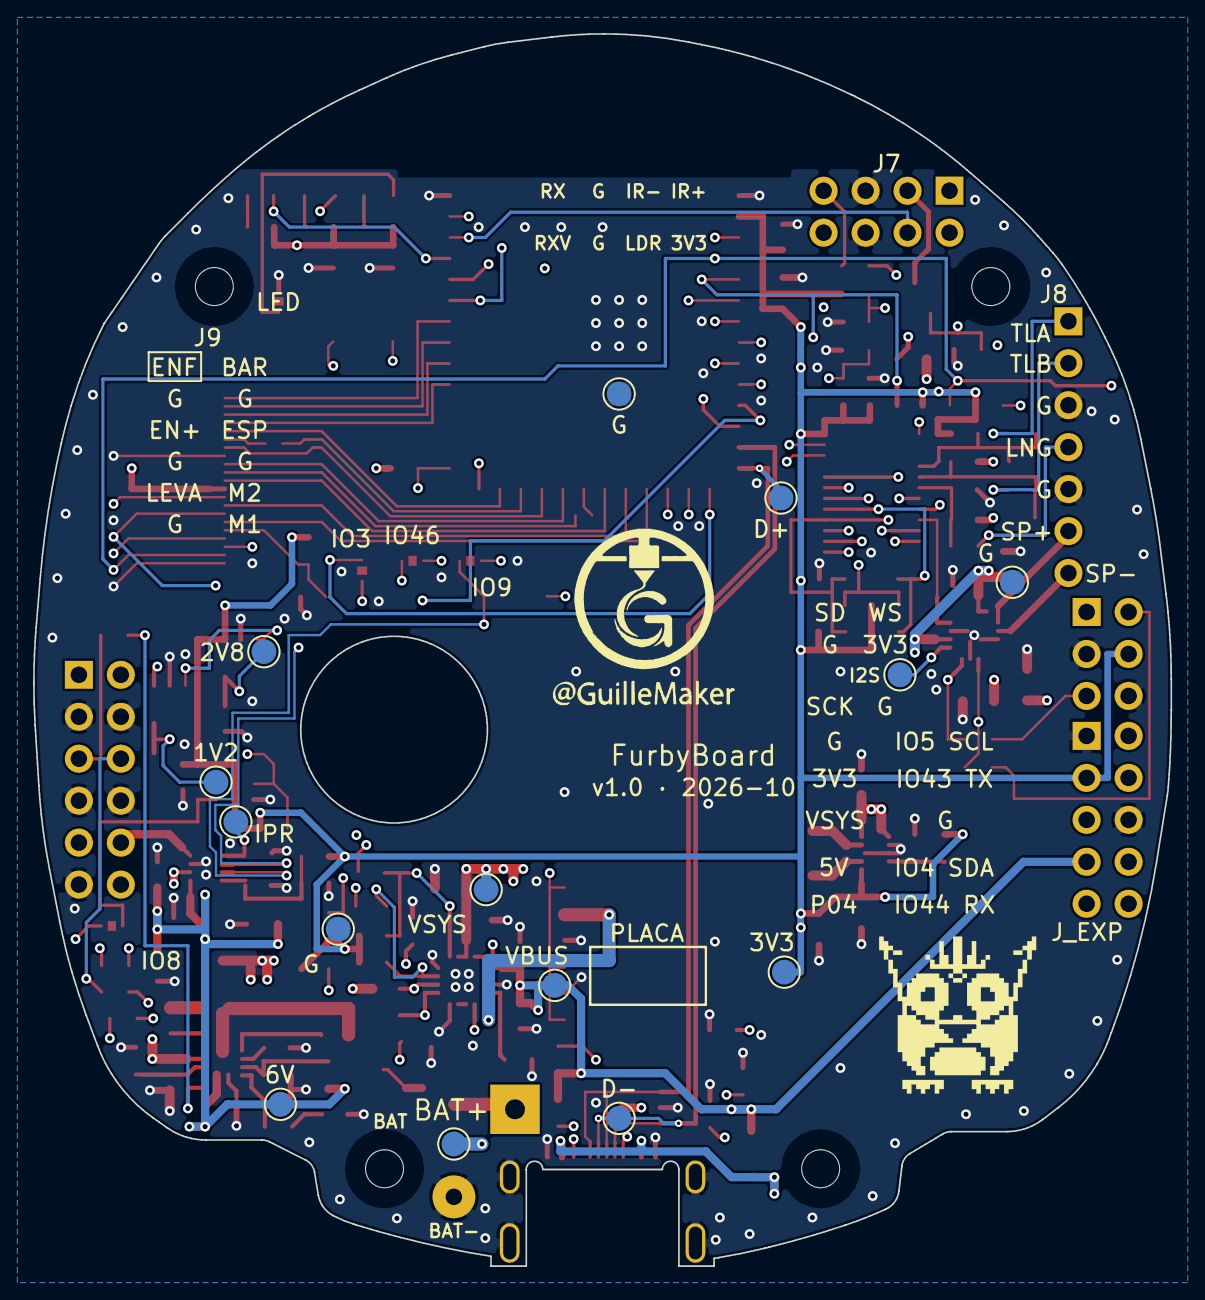
[picture p79: board FurbyBoard.kicad_pcb from below]

Board: 6 copper layers, 68.8 x 74.6 mm, 158 parts (16 on the bottom side), 108 nets.

Parts:
C1, C3, C4, C6, C41: 10u; C_0603_1608Metric
C2, C11, C27, C28, C29: 1u; C_0603_1608Metric
C5, C10, C13, C22, C23, C26, C30, C31, C32, C33, C34, C35, C36, C37, C39, C40: 100n; C_0603_1608Metric
C7, C8, C9, C16, C17, C18, C19, C20, C21, C24, C25: 22u; C_0805_2012Metric
C12: 2.2u; C_0603_1608Metric
C14: 4.7n; C_0603_1608Metric
C15: 10p; C_0603_1608Metric
C38: 10n; C_0603_1608Metric
D1, D3: Rojo; LED_0603_1608Metric
D2, D4, D5: Verde; LED_0805_2012Metric
F1: 1.5A; Fuse_1206_3216Metric
H1, H2, H3, H4: M2; MountingHole_2.3mm_M2
J1: USB-C 16P; USB_C_HRO_TYPE-C-31-M-13C
J2: BAT+; BAT_POS_Square3x3_Drill1.2
J3: BAT-; BAT_NEG_Round2.6_Drill1.0
J5: Micro I2S (SD, GND, SCK, WS, 3V3, GND); Pads_2x03_P2.54mm
J6: FPC 24P 0.5; FPC_AFC01-S24FCA-00
J7: Frente: IR (emisor ×2, receptor ×3), luz ×2, GND; Pads_2x04_P2.54mm
J8: Inclinación ×3, lengua ×2, altavoz ×2; Pads_1x07_P2.54mm
J9: Encoder ×3, leva ×2, barriga ×2, espalda ×2, moto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; Pads_2x06_P2.54mm
J11: J_EXP: header de expansión 2 x 5 sin montar; Pads_2x05_P2.54mm
JP1, JP2, JP3, JP4, JP5: Puente; SolderJumper-2_P1.3mm_Bridged_RoundedPad1.0x1.5mm
L1: 0.47u; L_Changjiang_FHD4020S
L2: 1u; L_Changjiang_FHD4020S
LOGO1: Logo_Furby_PixelArt
LOGO2: Logo_GuilleMaker
Q1: SI7615ADN; Vishay_PowerPAK_1212-8_Single
Q3: AO3400A; SOT-23
R1, R2: 5.1k; R_0603_1608Metric
R4: 1.8k; R_0603_1608Metric
R5: 1.2k; R_0603_1608Metric
R6, R7, R8, R9, R22, R25, R29, R30, R33, R49, R55: 100k; R_0603_1608Metric
R10, R11: 2.2k; R_0603_1608Metric
R12, R17, R18, R27, R34, R35, R38, R52: 10k; R_0603_1608Metric
R13, R14, R53: 470k; R_0603_1608Metric
R15: 510k; R_0603_1608Metric
R16: 91k; R_0603_1608Metric
R19, R28: 1.5k; R_0603_1608Metric
R20: 150k; R_0603_1608Metric
R21: 390k; R_0603_1608Metric
R23: 270k; R_0603_1608Metric
R24: 30k; R_0603_1608Metric
R26, R36, R37: 4.7k; R_0603_1608Metric
R31, R32: 33; R_0603_1608Metric
R39, R41, R43: 47k; R_0603_1608Metric
R40, R42, R44, R46, R48, R50, R56, R57, R58: 1k; R_0603_1608Metric
R45, R47: 220k; R_0603_1608Metric
R51: 220; R_0603_1608Metric
R54: 22; R_0805_2012Metric
R59, R60: 33; R_0402_1005Metric
RT1: 10k NTC; R_0603_1608Metric
SW1: RESET; SW_SPST_TS-1088-xR020
SW2: BOOT; SW_SPST_TS-1088-xR020
TP1: VBUS; TestPoint_Pad_D1.5mm
TP2: USB_DP; TestPoint_Pad_D1.5mm
TP3: USB_DN; TestPoint_Pad_D1.5mm
TP4: BAT; TestPoint_Pad_D1.5mm
TP5: VSYS; TestPoint_Pad_D1.5mm
TP6: 3V3; TestPoint_Pad_D1.5mm
TP7: V6; TestPoint_Pad_D1.5mm
TP8: IPROPI; TestPoint_Pad_D1.5mm
TP9: I2S_DOUT; TestPoint_Pad_D1.5mm
TP10: CAM_2V8; TestPoint_Pad_D1.5mm
TP11: CAM_DVDD; TestPoint_Pad_D1.5mm
TP12, TP13, TP14: GND; TestPoint_Pad_D1.5mm
U1: USBLC6-2SC6; SOT-23-6
U2: BQ24073RGTR; VQFN-16-1EP_3x3mm_P0.5mm_EP1.6x1.6mm
U3: TPS63802DLAR; Texas_DLA_VSON-10_2x3mm_P0.5mm
U4: ESP32-S3-WROOM-1-N16R8; ESP32-S3-WROOM-1
U5: TPS61089RNRR; Texas_VQFN-RNR0011A-11
U6: DRV8231ADSGR; Texas_DSG0008A_WSON-8-1EP_2x2mm_P0.5mm_EP0.9x1.6mm
U7: MAX98357AETE+T; TQFN-16-1EP_3x3mm_P0.5mm_EP1.23x1.23mm
U8: ME6211C28M5G-N; SOT-23-5
U9: ME6211C12M5G-N; SOT-23-5
U10: TCA9535PWR; TSSOP-24_4.4x7.8mm_P0.65mm
U11: SN74LVC1G17DBVR; SOT-23-5

Connections:
3V3: C7.1, C8.1, C9.1, C10.1, C27.1, C30.1, C32.1, C39.1, J5.5, J6.11, J7.5, J11.2, R8.2, R9.2, R15.1, R17.2, R18.2, R19.1, R26.1, R34.2, R35.2, R36.2, R37.2, R38.2, R39.2, R41.2, R43.2, R45.2, R47.2, R49.2, R52.2, R57.1, R58.1, TP6.1, U3.6, U4.2, U8.1, U10.24, U11.5
AMP_SD: U7.4, U10.9
BACK: C34.1, R41.1, R42.1, U10.17
BACK_PAD: J9.9, R42.2
BAT: C4.1, Q1.1, Q1.2, Q1.3, R13.1, TP4.1, U2.2, U2.3
BAT_G: Q1.4, R12.1
BAT_PAD: J2.1, Q1.5
BB_FB: R15.2, R16.1, U3.4
BB_SW1: L1.1, U3.9
BB_SW2: L1.2, U3.7
BOOT: R18.1, SW2.1, U4.27
BQ_EN1: R6.1, U2.6, U10.13
BQ_EN2: R7.1, U2.5, U10.14
BQ_ILIM: R5.1, U2.12
BQ_ISET: R4.1, U2.16
BQ_TS: RT1.1, U2.1
BST_BOOT: C13.1, U5.10
BST_COMP: C15.1, R24.1, U5.4
BST_FB: R21.2, R22.1, U5.3
BST_FSW: R20.1, U5.1
BST_ILIM: R23.1, U5.8
BST_RC: C14.1, R24.2
BST_SW: C13.2, L2.2, R20.2, U5.11
BST_VCC: C12.1, U5.2
CAM_2V8: C28.1, J6.4, TP10.1, U8.5, U9.1
CAM_DVDD: C29.1, J6.10, TP11.1, U9.5
CAM_EN: R33.1, U8.3, U9.3, U10.19
CAM_HREF: J6.9, U4.19
CAM_PCLK: R60.1, U4.24
CAM_PCLK_CAM: J6.17, R60.2
CAM_PWDN: J6.8, R34.1, U10.18
CAM_RST: C31.1, J6.6, R35.1
CAM_VSYNC: J6.7, U4.18
CAM_XCLK: J6.13, R59.2
CAM_XCLK_IO: R59.1, U4.21
CAM_Y2: J6.19, U4.31
CAM_Y3: J6.21, U4.33
CAM_Y4: J6.22, U4.34
CAM_Y5: J6.20, U4.32
CAM_Y6: J6.18, U4.25
CAM_Y7: J6.16, U4.23
CAM_Y8: J6.14, U4.22
CAM_Y9: J6.12, U4.20
CC1: J1.A5, R1.1
CC2: J1.B5, R2.1
CHG: D1.1, R9.1, U2.9, U10.11
EN: C11.1, R17.1, SW1.1, U4.3
ENC: JP4.1, U11.4
ENC_IO: JP4.2, U4.12
ENC_LED_A: J9.3, R51.2
ENC_PT: J9.1, R52.1, U11.2
EN_6V: R25.1, R51.1, U5.7, U10.15
EXP_INT: R38.1, U4.6, U10.1
EXP_P07: J11.5, U10.8
GND: C1.2, C2.2, C3.2, C4.2, C5.2, C6.2, C7.2, C8.2, C9.2, C10.2, C11.2, C12.2, C14.2, C15.2, C16.2, C17.2, C18.2, C19.2, C20.2, C21.2, C22.2, C23.2, C24.2, C25.2, C26.2, C27.2, C28.2, C29.2, C30.2, C31.2, C32.2, C33.2, C34.2, C35.2, C36.2, C37.2, C38.2, C39.2, C40.2, C41.2, J1.A1, J1.A12, J1.B1, J1.B12, J1.SH, J3.1, J5.2, J5.6, J6.2, J6.15, J6.MP, J7.3, J7.7, J8.3, J8.5, J9.2, J9.4, J9.6, J9.8, J9.10, J11.1, J11.8, JP5.2, Q3.2, R1.2, R2.2, R4.2, R5.2, R7.2, R12.2, R14.2, R16.2, R22.2, R23.2, R25.2, R27.2, R28.2, R29.2, R30.2, R33.2, R53.2, R55.2, RT1.2, SW1.2, SW2.2, TP12.1, TP13.1, TP14.1, U1.2, U2.4, U2.8, U2.15, U2.17, U3.2, U3.3, U3.8, U4.1, U4.40, U4.41, U5.5, U6.7, U6.9, U7.3, U7.11, U7.15, U7.17, U8.2, U9.2, U10.2, U10.3, U10.12, U10.21, U11.3
HOME: C38.1, R49.1, R50.1, U4.11
HOME_PAD: J9.5, R50.2
I2C_SCL: J6.5, J11.6, R37.1, U4.5, U10.22
I2C_SDA: J6.3, J11.9, R36.1, U4.4, U10.23
I2S_BCLK: R31.1, U4.7, U7.16
I2S_DIN: J5.1, U4.10
I2S_DOUT: TP9.1, U4.9, U7.1
I2S_SCK_MIC: J5.3, R31.2
I2S_WS: R32.1, U4.8, U7.14
I2S_WS_MIC: J5.4, R32.2
IPROPI: JP3.2, R28.1, TP8.1, U6.1
IPROPI_IO: JP3.1, U4.15
IR_LED_A: J7.1, R54.2
IR_LED_K: J7.2, Q3.3
IR_PWR: J7.8, U10.20
IR_RX: R56.1, U4.35
IR_RX_PAD: J7.4, R56.2
IR_TX: Q3.1, R55.1, U4.26
LED_CHG_A: D1.2, R10.2
LED_PG_A: D2.2, R11.2
LED_PROG_A: D3.2, R19.2
LED_PWR_A: D4.2, R57.2
LED_PWR_K: D4.1, JP5.1
LED_RUN_A: D5.2, R58.2
LED_RUN_K: D5.1, U10.7
LIGHT: C40.1, J7.6, R53.1, U4.38
MOT_IN1: JP1.2, R29.1, U6.3
MOT_IN1_IO: JP1.1, U4.17
MOT_IN2: JP2.2, R30.1, U6.2
MOT_IN2_IO: JP2.1, U4.16
MOT_OUT1: J9.12, U6.6
MOT_OUT2: J9.11, U6.8
MOT_VREF: C23.1, R26.2, R27.1, U6.4
PGOOD: D2.1, R8.1, U2.7, U10.10
SPK_N: J8.7, U7.10
SPK_P: J8.6, U7.9
TILT_A: C36.1, R45.1, R46.1, U10.4
TILT_A_PAD: J8.1, R46.2
TILT_B: C37.1, R47.1, R48.1, U10.5
TILT_B_PAD: J8.2, R48.2
TONGUE: C35.1, R43.1, R44.1, U10.6
TONGUE_PAD: J8.4, R44.2
TUMMY: C33.1, R39.1, R40.1, U10.16
TUMMY_PAD: J9.7, R40.2
U0RX: J11.10, U4.36
U0TX: D3.1, J11.7, U4.37
USB_DN: J1.A7, J1.B7, TP3.1, U1.3, U1.4, U4.13
USB_DP: J1.A6, J1.B6, TP2.1, U1.1, U1.6, U4.14
V6: C18.1, C19.1, C20.1, C21.1, C22.1, R21.1, TP7.1, U5.6, U6.5
VBAT_SNS: C5.1, R13.2, R14.1, U4.39
VBUS: C1.1, C2.1, F1.2, J11.4, R10.1, R11.1, TP1.1, U2.13
VBUS_IN: F1.1, J1.A4, J1.A9, J1.B4, J1.B9, U1.5
VSYS: C3.1, C6.1, C16.1, C17.1, C24.1, C25.1, C26.1, C41.1, J11.3, L2.1, R6.2, R54.1, TP5.1, U2.10, U2.11, U3.1, U3.10, U5.9, U7.2, U7.7, U7.8
