Guilleloma/Furby-GPT/chatbot/furpisimple/speech_to_text.py

#Speech_to_text.py

import time
import sounddevice as sd
import soundfile as sf
import openai
from utils import open_file
import numpy as np

import pyaudio
import wave

api_key = open_file('openaiapikey2.txt')

def record_and_transcribe(duration=8, fs=44100, threshold=1000):
    
    pa=pyaudio.PyAudio()
    
    # Configuración del stream de audio
    stream = pa.open(format=pyaudio.paInt16, channels=1, rate=fs, input=True, frames_per_buffer=1024)
    print("Recording...")
    print("Abriendo stream de audio (pyaudio)")
    frames = []
    for _ in range(0, int(fs / 1024 * duration)):
        data = stream.read(1024)
        frames.append(data)

    print("Recording complete.")
    print("Cerrando stream de audio (pyaudio)")
    stream.stop_stream()
    stream.close()

    # Convertir frames a datos de numpy
    np_frames = np.frombuffer(b''.join(frames), dtype=np.int16)
    
    # Calcular y mostrar el valor medio absoluto
    mean_val = np.abs(np_frames).mean()
    print(f"Valor medio absoluto del audio: {mean_val}")
    # Comprobar si el audio es principalmente silencio
    print("Comprobamos si hay silencio")
    if mean_val < threshold:
        print('Detectado silencio, yendo a dormir...')
        return "a dormir"
    
    print("No hay silencio. Generamos Wav")
    # Guardar grabación en un archivo WAV
    filename = 'myrecording.wav'
    with wave.open(filename, 'wb') as wf:
        wf.setnchannels(1)
        wf.setsampwidth(pa.get_sample_size(pyaudio.paInt16))
        wf.setframerate(fs)
        wf.writeframes(b''.join(frames))

    # Transcripción del audio a texto usando Whisper de OpenAI
    attempt = 0
    while attempt < 3:
        try:
            print("Transcribiendo texto con Whisper")
            with open(filename, "rb") as file:
                openai.api_key = api_key
                result = openai.Audio.transcribe(model="whisper-1", file=file)
            return result['text']
        except openai.error.APIError as e:
            print(f"Error al transcribir: {e}. Reintentando...")
            attempt += 1
            time.sleep(2)

    print("No se puede conectar con Whisper.OpenAI")
    return None

    '''
    #GRABA
    print('Recording...')
    print("Abriendo stream de audio (sounddevice)")
    myrecording = sd.rec(int(duration * fs), samplerate=fs, channels=1)
    sd.wait() #Esperamos a que termine para que se cierre el stream
    print("Cerrando stream de audio (sounddevice)")
    print('Recording complete.')

    # Comprueba si el audio grabado es principalmente silencio
    if np.abs(myrecording).mean() < threshold:
        print('Detectado silencio, yendo a dormir...')
        return "a dormir" #Se va a dormir si es silencio
    
    #Genera el archivo de audio
    print('Generando archivo myrecording.wav')
    filename = 'myrecording.wav'
    sf.write(filename, myrecording, fs)
    

    #MANDA A WISPER (OPENAI) PARA SPEECH TO TEXT
    attempt = 0
    while attempt < 3: #Reintentos en caso de fallo de conexion con la API
        try:
            with open(filename, "rb") as file:
                openai.api_key = api_key
                result = openai.Audio.transcribe(model="whisper-1", file=file)
            transcription = result['text']
            return transcription #Devuelve el resultado de la transcripcion
        except openai.error.APIError as e:
            print(f"Error al transcribir: {e}. Reintentando...")
            attempt += 1
            time.sleep(2)  # Esperar 2 segundos antes de reintentar

    print("No se puede conectar con Wisper.OpenAI") #Mensaje en caso de no conseguir conectarse
    return None
'''

def chatgpt(conversation, chatbot, user_input):
    openai.api_key = api_key
    conversation.append({"role": "user", "content": user_input})
    messages_input = conversation.copy()
    prompt = [{"role": "system", "content": chatbot}]
    messages_input.insert(0, prompt[0])
    completion = openai.ChatCompletion.create(
        model="gpt-3.5-turbo",
        messages=messages_input
    )
    chat_response = completion['choices'][0]['message']['content']
    conversation.append({"role": "assistant", "content": chat_response})
    return chat_response
