Guilleloma/Furby-GPT/Hardware/FurbyBoard/scripts/layout.py

"""Colocación de la FurbyBoard en coordenadas del STL (mm, vista desde arriba, delante = y mayor).

Cada entrada es ref -> (x, y, rotación en grados, sentido antihorario visto desde arriba) y,
opcionalmente, un cuarto valor "B" para las piezas de la cara inferior (solo los puntos de
test: todo lo que se monta va en la cara superior, montaje económico de JLCPCB a una cara).

Replanteo del 2026-10-24 (NOTAS.md, «Planta»). Bloques, de delante hacia atrás:

- delante: módulo con la antena en el borde; a su derecha, LED PWR/RUN/TX, botones y JP5;
  a su izquierda, pads del IR y la luz (J7) con el driver del emisor;
- borde izquierdo (fuera de la batería): J8 (inclinación, lengua, altavoz), J5 (micro) y J_EXP;
- bajo la batería, de delante hacia atrás: expansor pegado a la columna izquierda del módulo
  con el acondicionamiento de J8 entre ambos, amplificador junto a J8 y J5, buck-boost de 3,3 V
  en la zona trasera izquierda;
- borde derecho: FPC de la cámara con el flex hacia la pared; debajo, los LDO de la cámara,
  el Schmitt del encoder, los puentes y el puente H junto a J9;
- esquina trasera derecha: elevador de 6 V; centro trasero: cargador, protección de polaridad
  y pads de la batería; lóbulo: USB-C, ESD, PTC.

Pasillos reservados (sin piezas): el de la cámara (módulo -> J6, y -74..-81), el pasillo sur
(y -83..-89,5 entre el módulo y el agujero del mecanismo), el canal x -86,5..-82,5 a la
izquierda de la columna izquierda del módulo (I2S, par USB, 3V3) y el pasillo norte-sur
x -77..-69 bajo la batería (par USB, señales del motor, VBAT).
"""

BATERIA = {"centro": (-84.5, -91.8), "ancho": 33.0, "largo": 50.0, "giro": -4.0}
ANTENA_SIN_COBRE = {"x": (-85.0, -61.0), "y": (-62.0, -50.0)}
# Logo en la cara inferior (sin vías ni pads), bajo la zona trasera izquierda de la batería,
# entre J_EXP, el buck-boost y el micro: sin piezas arriba y pocas vías previstas. Subordinado al diseño.
LOGO_INFERIOR = {"x": (-100.0, -90.0), "y": (-118.0, -108.0)}
# Logo de GuilleMaker (scripts/logo_guillemaker.py, 11 mm), cara inferior: gen_pcb.py lo pone tras los
# rótulos en el sitio libre más cercano a este centro. Junto al logo del Furby no queda sitio ni para
# 8 mm tras el cosido de GND; aquí, a la izquierda del agujero del mecanismo, cabe sin vías dentro de
# su silueta (2026-10-25).
LOGO_GUILLEMAKER = {"centro": (-75.9, -88.3), "radio": 3.0}
# Franja del flex de la cámara entre J6 y la pared: sin piezas (el flex pasa por encima).
FLEX_SIN_PIEZAS = {"x": (-46.0, -39.0), "y": (-88.0, -72.0)}
CALZOS = [(-75.0, -105.8, "E1"), (-99.5, -113.0, "E2"), (-90.5, -112.5, "E3")]
CALZO_D = 4.0
# Cabeza del tornillo M2 (Ø4) + 0,5: sin cobre ni piezas en las dos caras (layout-pcb.md 4.1).
TORNILLO_KEEPOUT_D = 5.0

P = {
    # ------------------------------------------------ módulo y su soporte (pin 2 = 3V3, 3 = EN)
    "U4": (-73.0, -68.25, 0),
    "C10": (-84.4, -65.5, 90), "C9": (-84.4, -68.9, 90),
    # ------------------------------------------------ delante a la izquierda: IR, luz y RC de EN
    "J7": (-94.5, -62.7, 0),
    "R56": (-88.8, -67.25, 0), "R17": (-88.8, -68.95, 0), "C11": (-88.85, -70.65, 0), "R53": (-88.8, -72.35, 0),
    "Q3": (-92.4, -69.2, 90), "R54": (-92.2, -72.9, 0), "R55": (-95.6, -72.3, 0),
    # ------------------------------------------------ LED, botones y JP5 (delante a la derecha)
    "D4": (-60.0, -63.0, 0), "D5": (-56.4, -63.0, 0), "D3": (-52.8, -63.0, 0),
    "R57": (-60.0, -64.9, 0), "R58": (-56.4, -64.9, 0), "R19": (-52.8, -64.9, 0),
    "SW1": (-60.8, -69.6, 90), "SW2": (-57.2, -69.6, 90), "JP5": (-53.9, -69.4, 90),
    # ------------------------------------------------ cámara: FPC en el borde derecho (pin 1 abajo)
    "J6": (-49.3, -80.0, 90),
    # Series de los relojes del DVP (M7, 2026-10-27), 0402 a 0°: R59 (XCLK) justo bajo el pin 21 del
    # módulo, entre su patio (y -81,70) y la fila del bus (XCLK en y -83,0; Y8 sube por x -71,1 al
    # este y Y9 por x -73,6 al oeste); R60 (PCLK) a 2 mm del pad 17 de J6, con PCLK bajada a y -78,0
    # y Y7 a -78,6 en ese tramo para que quepan los pads de 0,64 entre Y6 (-77,25) y Y7.
    "R59": (-72.365, -82.35, 0), "R60": (-53.6, -78.0, 0),
    # LDO de la cámara debajo del FPC: 3V3 -> U8 (2,8 V) -> U9 (1,2 V); control debajo
    "U8": (-51.6, -91, 270), "C28": (-50.65, -94.65, 270), "C29": (-46.35, -97.5, 270),
    "R33": (-56.1, -106.4, 0), "C27": (-48.2, -89.86, 0), "U9": (-47.3, -93.8, 270),
    "C30": (-56.1, -108.1, 0), "C39": (-48.1, -98.2, 270), "U11": (-51.25, -98.6, 0),
    "C31": (-56, -87.3, 0), "R34": (-56.1, -109.8, 0), "R35": (-55.7, -84.5, 90),
    # ------------------------------------------------ pasillo sur: puentes del motor, BOOT y JP4
    "JP1": (-65.5, -85.1, 0), "JP2": (-62, -85.1, 0), "JP3": (-58.95, -85.7, 270),
    "R18": (-61.5, -79.5, 0), "JP4": (-43.8, -107.2, 0),
    # ------------------------------------------------ puente H junto a los pads del motor (J9.11/12)
    "J9": (-41.8, -92.0, 270),
    "U6": (-49.5, -103.7, 0),
    "C22": (-46.55, -104.1, 90), "C20": (-46.55, -109.6, 270), "C21": (-48.49, -106.7, 0),
    # R28 0,17 al norte y C23 0,30 al sur (bloque M): el hueco entre ellos pasa de 0,55 a 0,80 para que
    # MOT_IN1 y MOT_IN2 salgan juntas de los pines 2 y 3 de U6
    "R28": (-52.65, -102.78, 180), "C23": (-52.65, -104.75, 180),
    "R26": (-56.1, -103, 0), "R27": (-56.1, -104.6, 180),
    "R29": (-65.5, -87.25, 0), "R30": (-69.3, -87.25, 0), "R25": (-60.5, -114.2, 0),
    # Series de barriga, espalda y leva y resistencia del LED del encoder, junto a J9
    # M3: R50 0,15 al oeste y 0,05 al norte (patio a 0,55 del borde, antes 0,41). R42 queda a 0,50
    # justo: C20 toca su patio por el oeste y R40 por el norte.
    "R40": (-44, -109.6, 0), "R42": (-44, -111.2, 0), "R50": (-44.65, -112.75, 0), "R51": (-43.95, -89.6, 0),
    "R52": (-53.6, -101.3, 0),
    # ------------------------------------------------ elevador de 6 V (esquina trasera derecha)
    # SW abajo (hacia U5), VIN al este (Cin), VOUT y GND al sur (lazo caliente con Cout).
    "L2": (-50.5, -110.9, 270), "U5": (-50.5, -115.5, 0),
    # M3 (2026-10-27): R23 0,30 al norte (patio a 0,33 del borde fresado, antes 0,22; pads a 1,0): no
    # cabe más al norte (patio de R50 a 0,01) ni al oeste (vías de VSYS de C16 en x -46,25, a 0,225 de
    # sus pads). R24 pasa a 0402 bajo C15 (pads a 0,77 del borde, antes 0,34; patio a 0,60, antes 0,09).
    "C13": (-47.35, -112.93, 90), "C16": (-47.3, -116.2, 270), "R23": (-45.25, -115.07, 90), "C17": (-64.3, -104.95, 0),
    "C18": (-50.39, -118.1, 180), "C19": (-52.9, -107.1, 0),
    "R20": (-57.3, -113.8, 180), "C12": (-53.8, -114.58, 180), "R22": (-53.8, -116.22, 180),
    "C15": (-53.84, -117.8, 180), "R21": (-56.9, -116.23, 90), "R24": (-53.88, -119.1, 180),
    "C14": (-57.3, -118.6, 180),
    # ------------------------------------------------ cargador (centro trasero), girado 90°:
    # IN al oeste (C2 junto al pin), BAT al sur (C4, Q1 y pads), OUT al norte (C3), EN/PGOOD al este.
    "U2": (-65.0, -110.5, 90),
    "C2": (-68.5, -108.925, 90), "C1": (-68.5, -112.65, 270), "R4": (-68.4, -115.3, 180), "RT1": (-80.8, -113.5, 0), 
    "C3": (-66.025, -106.85, 180), "R5": (-62, -107.5, 90),
    "C4": (-63.9, -114.55, 0), "R12": (-59.4, -115.9, 0),
    "R9": (-59.6, -107.8, 0), "R8": (-59.6, -109.4, 0), "R6": (-60.4, -111, 0), "R7": (-60.4, -112.6, 0),
    # LED CHG y PG al norte del cargador (visibles); sus resistencias, en VBUS bajo la batería
    "D1": (-59.5, -103.9, 0), "D2": (-59.5, -106, 0),
    # Divisor de VBAT (ADC) y resistencias de los LED: columna bajo la batería, junto al cargador
    "R13": (-71.2, -105.7, 90), "R14": (-71.2, -108.9, 90), "C5": (-71.2, -112.1, 90),
    "R10": (-70.8, -115.3, 90), "R11": (-70.8, -118.5, 270),
    # Polaridad y pads de la batería (fuera de la batería, detrás de su esquina derecha)
    "Q1": (-64, -118, 180), "J2": (-68.2, -118.3, 0), "J3": (-64.5, -123.6, 0),
    # ------------------------------------------------ USB (lóbulo)
    "J1": (-73.5, -128.494, 0), "U1": (-75.85, -118.2, 0),
    "R1": (-82, -116.6, 90), "R2": (-80, -118.6, 90), "F1": (-82.5, -121.0, 90),
    # ------------------------------------------------ borde izquierdo: J8, micro (2 x 3) y J_EXP (2 x 5)
    "J8": (-101.7, -70.6, 270), "J5": (-102.8, -88.2, 270), "J11": (-102.8, -95.7, 270),
    # ------------------------------------------------ bajo la batería: expansor y su acondicionamiento
    "C32": (-87.3, -75.7, 0), "R36": (-93.7, -75.7, 0), "R37": (-90.5, -75.7, 0), "R38": (-96.9, -75.7, 0),
    "U10": (-89.8, -81, 0),
    # Bloque RC de J8 (rutado, 2026-10-24): columna izquierda 0,3 mm al oeste para que entre una vía de 0,6
    # entre columnas (x -97,15); las series TILT_A/B_PAD y TONGUE_PAD salen por esas vías a B.Cu hacia J8,
    # y los 3V3 de R47/R43 por otras dos a In2. Filas: TILT_A arriba (R46, C36 | R45), TILT_B (R48, C37 | R47)
    # y TONGUE a la derecha (C35, R43, R44, giradas 180°: su nodo hacia U10.6). R43 0,13 al sur (bloque U2):
    # deja sitio a la vía de EXP_P07 junto a U10.8 entre C35.1 y R43.1.
    "R45": (-95.4, -77.4, 0), "R47": (-95.4, -79.1, 180), "C35": (-95.4, -80.8, 180), "R43": (-95.4, -82.63, 180),
    "R44": (-95.4, -84.2, 180),
    "R46": (-98.9, -77.4, 0), "C36": (-98.9, -79.1, 180), "R48": (-98.9, -80.8, 0), "C37": (-98.9, -82.5, 0),
    # Pull-ups y filtros de barriga, espalda y leva (sus series van junto a J9)
    "C33": (-87.4, -86.2, 0), "C34": (-90.6, -86.2, 0), "C40": (-88.85, -74.05, 180),
    "C38": (-87.4, -87.8, 0), "R49": (-90.6, -87.8, 0),
    "R39": (-87.4, -89.4, 0), "R41": (-90.6, -89.4, 0),
    # ------------------------------------------------ bajo la batería: amplificador junto a J8
    # Girado 180°: salidas al oeste hacia J8.6/7, VDD al norte (C26 junto al pin), I2S al sur, DIN al este.
    "U7": (-96, -89.6, 180), "C26": (-95.475, -86.6, 0), "C41": (-97.75, -85.3, 90), "C24": (-99.2, -92.6, 90), "C25": (-96.25, -93.6, 0),
    "R31": (-96.25, -95.9, 180), "R32": (-96.25, -97.6, 180),
    # ------------------------------------------------ bajo la batería: buck-boost de 3,3 V
    # VIN/L1/L2/VOUT al este (bobina y condensadores), EN/MODE/AGND/FB al oeste (divisor).
    "C6": (-89.17, -98.5, 90), "U3": (-90, -102.8, 0), "L1": (-85.4, -102.8, 270),
    "C7": (-89.17, -106.4, 270), "C8": (-86.6, -107.4, 270),
    "R16": (-92.4, -102.48, 90), "R15": (-94.2, -102.48, 270),
    # ------------------------------------------------ puntos de test: cara inferior, junto a su fuente
    "TP1": (-70.6, -110.8, 0, "B"), "TP2": (-84.3, -81.3, 0, "B"), "TP3": (-74.5, -118.85, 0, "B"),
    "TP4": (-64.5, -120.4, 0, "B"), "TP5": (-66.45, -105, 0, "B"), "TP6": (-84.5, -110, 0, "B"),
    "TP7": (-54, -118, 0, "B"), "TP8": (-51.3, -100.9, 0, "B"), "TP9": (-91.5, -92, 0, "B"),
    "TP10": (-53, -90.6, 0, "B"), "TP11": (-50.1, -98.5, 0, "B"),
    "TP12": (-74.5, -75, 0, "B"), "TP13": (-57.5, -107.4, 0, "B"), "TP14": (-98.3, -86.4, 0, "B"),
}


def placement():
    return {ref: v[:3] for ref, v in P.items()}


def caras():
    """Cara de cada pieza: "F" salvo las marcadas con "B"."""
    return {ref: (v[3] if len(v) > 3 else "F") for ref, v in P.items()}
