Guilleloma/Furby-GPT/Hardware/FurbyBoard/scripts/rutas_fijas.py

"""Rutas explícitas de la FurbyBoard (coordenadas del STL, mm), bloqueadas en el PCB.

Encargo 4 (rutado, 2026-10-24): todo lo crítico va aquí escrito a mano, por bloques y en el
orden de layout-pcb.md §13: lazos de potencia (U2, U3, U5, U6, U7) y raíles → par USB → DVP →
I2S → sensado (clase D) → escapes de los pines finos. Lo lento que queda lo remata Freerouting
sobre estas pistas bloqueadas (una ejecución acotada) y el resultado pasa por limpiar-pistas.

Sintaxis (gen_pcb.rutas_fijas resuelve los pads con las posiciones reales de la placa):
    pista(red, capa, ancho, p0, p1, ..., modo="s")
        p = (x, y) | "REF.PAD" | ("REF.PAD", dx, dy)
        Entre dos puntos no alineados a 0/45/90 se mete un codo a 45°: modo "s" = recto
        primero y diagonal al final; "d" = diagonal primero. Un codo por tramo; para
        trayectorias largas se dan los vértices.
    via(red, p, tam=VIA)              VIA = 0,6/0,3; VIA_USB = 0,45/0,2 (solo la clase USB)
    stub(red, "REF.PAD", (dx, dy), ancho, tam=VIA)   pista corta pad -> vía en pad+(dx, dy)
Cada pista comprueba que la red de los pads que toca es la suya.
"""

VIA = (0.6, 0.3)
VIA_USB = (0.45, 0.2)

PISTAS = []   # (red, capa, ancho, [puntos], modo)
VIAS = []     # (red, punto, (diámetro, taladro))
ZONAS = []    # (red, capa, [puntos], clearance, prioridad): polígonos de potencia (conexión sólida)


def pista(red, capa, ancho, *puntos, modo="s"):
    PISTAS.append((red, capa, ancho, list(puntos), modo))


def via(red, p, tam=VIA):
    VIAS.append((red, p, tam))


def zona(red, capa, puntos, clearance=0.2, prioridad=2):
    """Polígono de cobre de una red de potencia (> 1,5 A: layout-pcb.md §5.1), con conexión sólida
    a sus pads; prioridad por encima del relleno de GND de la cara."""
    ZONAS.append((red, capa, list(puntos), clearance, prioridad))


def stub(red, pad, d, ancho, tam=VIA, capa="F.Cu"):
    pista(red, capa, ancho, pad, (pad, d[0], d[1]))
    via(red, (pad, d[0], d[1]), tam)


def codo(a, b, modo):
    """Vértice intermedio que une a y b con un tramo recto y uno a 45° (o nada si ya están alineados)."""
    dx, dy = b[0] - a[0], b[1] - a[1]
    ax, ay = abs(dx), abs(dy)
    # Alineados (o a 45°) salvo por el redondeo de los pads: sin codo (queda dentro de 0,5°)
    if ax < 0.02 or ay < 0.02 or abs(ax - ay) < 0.02:
        return None
    sx, sy = (1 if dx > 0 else -1), (1 if dy > 0 else -1)
    if ax > ay:
        rem = ax - ay
        return (a[0] + sx * rem, a[1]) if modo == "s" else (a[0] + sx * ay, b[1])
    rem = ay - ax
    return (a[0], a[1] + sy * rem) if modo == "s" else (b[0], a[1] + sy * ax)


def resolver(p, pad_xy):
    if isinstance(p, str):
        return pad_xy(p)
    if isinstance(p, tuple) and len(p) == 3 and isinstance(p[0], str):
        x, y = pad_xy(p[0])
        return (x + p[1], y + p[2])
    return (float(p[0]), float(p[1]))


def rutas(pad_xy):
    """Devuelve (pistas, vias) con coordenadas resueltas: pistas = [(red, capa, ancho, [(x, y), ...])]."""
    out_p = []
    for red, capa, ancho, puntos, modo in PISTAS:
        pts = [resolver(p, pad_xy) for p in puntos]
        expandido = [pts[0]]
        for a, b in zip(pts, pts[1:]):
            c = codo(a, b, modo)
            if c is not None:
                expandido.append(c)
            expandido.append(b)
        out_p.append((red, capa, ancho, expandido))
    out_v = [(red, resolver(p, pad_xy), tam) for red, p, tam in VIAS]
    return out_p, out_v


# ============================================================================ bloques
# Nota de geometría: los pads de 0805/0603 girados 90/270 tienen el lado largo en x (C16, C20, C7,
# C8, C24: 1,45 x 1,0; L1/L2: 3,5 x 1,6). Tramos >= 2 x ancho (revisar-rutado).
# ---------------------------------------------------------------- elevador de 6 V (TPS61089)
# Lazo de salida en F.Cu: pin 6 (VOUT) -> C18.1 y pin 5 (GND) -> C18.2 (C18 a 180°: V6 al este,
# GND al oeste; sin cruce ni vías dentro del lazo). SW: pad de L2, pad 11 y los stubs de C13 y RFSW.
# VSYS entra en C16.1 desde dos vías al este del pad (pin 9 con cuello de 0,25 de 1 mm). ILIM pasa
# entre los pads de C16 y EN_6V baja entre C18.1 y C16.2 hasta una vía (sigue por In2 a R25).
# Columna oeste (x -53,8): C12 (VCC), R22 (FB), C15 (COMP), R24 (COMP->RC) en filas de 1,6 mm con
# las pistas FSW (y -113,8), FB (y -115,4) y COMP (y -117,0) entre ellas; GND a vías en x -55,55.
pista("BST_SW", "F.Cu", 0.8, "U5.11", "L2.2")
pista("BST_SW", "F.Cu", 0.8, "C13.2", (-49.2, -112.15))
pista("BST_SW", "F.Cu", 0.8, "R20.2", (-58.13, -112.2), (-50.9, -112.2))
pista("BST_BOOT", "F.Cu", 0.25, "U5.10", (-49.33, -113.7), "C13.1")
pista("BST_FSW", "F.Cu", 0.25, "U5.1", (-51.675, -113.75), "R20.1")
pista("BST_VCC", "F.Cu", 0.25, "U5.2", (-52.355, -115.25), "C12.1")
pista("BST_FB", "F.Cu", 0.25, "U5.3", (-52.51, -115.75), "R22.1")
pista("BST_FB", "F.Cu", 0.25, "R22.1", (-52.98, -115.39), "R21.2")
pista("BST_COMP", "F.Cu", 0.25, "U5.4", (-52.25, -116.25), (-52.25, -116.99), "C15.1")
# R24 en 0402 bajo C15 (M3): COMP baja recto de C15.1 y entra en R24.1 con una diagonal; RC sale de
# R24.2 al oeste, sube a 45° a la fila de C14 (y -118,6) y entra en C14.1 por su eje.
pista("BST_COMP", "F.Cu", 0.25, "C15.1", "R24.1")
pista("BST_RC", "F.Cu", 0.25, "R24.2", (-55.45, -118.6), "C14.1")
pista("V6", "F.Cu", 0.5, "U5.6", (-50.15, -117.39), "C18.1")
pista("GND", "F.Cu", 0.25, "U5.5", (-50.85, -116.7), (-51.34, -117.19), "C18.2")
pista("GND", "F.Cu", 0.35, "C18.2", (-51.34, -119.3))
via("GND", (-51.34, -119.3))
via("VSYS", (-46.25, -115.25))
via("VSYS", (-46.25, -114.05))
pista("VSYS", "F.Cu", 0.6, (-46.25, -114.05), (-46.25, -115.25), (-48.33, -115.25))
pista("VSYS", "F.Cu", 0.25, "U5.9", (-48.33, -115.25))
pista("GND", "F.Cu", 0.4, "C16.2", (-46.1, -117.15))
via("GND", (-46.1, -117.15))
pista("GND", "F.Cu", 0.6, "C16.2", (-47.3, -118.4))
via("GND", (-47.3, -118.4))
# EN_6V baja a una vía entre C18.1 y C16.2 (x -48,4; a 0,24 y 0,41 de los pads) y deja el sitio
# junto al borde, al este de la vía de V6 de C18, a la segunda vía de V6 (revisión E, I1)
pista("EN_6V", "F.Cu", 0.25, "U5.7", (-49.33, -117.0), (-48.4, -117.0), (-48.4, -118.25))
via("EN_6V", (-48.4, -118.25))
# ILIM pasa entre los pads de C16 por y -116,12 (0,245 al pad de VSYS, 0,405 al de GND) y entra en
# R23.1 por su eje desde el sur (R23 0,30 al norte por M3).
pista("BST_ILIM", "F.Cu", 0.25, "U5.8", (-48.83, -115.75), (-48.46, -116.12), ("R23.1", 0.0, -0.225), "R23.1")
# V6: vía junto a C18.1; por B.Cu, toma Kelvin hacia R21 (TP7 sobre esa pista) y tronco al puente H
# Dos vías junto a C18 (1,0 A; I1 de la revisión E: ⌈I / 0,7 A⌉ vías por cambio de capa, «Cálculos»
# de NOTAS): bajo C18.1 y al este, donde estaba la de EN_6V
via("V6", (-49.44, -119.35))
via("V6", (-48.49, -119.35))
pista("V6", "F.Cu", 0.5, "C18.1", (-49.44, -119.35), (-48.49, -119.35))
pista("V6", "B.Cu", 0.5, (-48.49, -119.35), (-49.44, -119.35))
pista("V6", "B.Cu", 0.5, (-49.44, -119.35), (-50.79, -118.0), (-56.96, -118.0), (-57.9, -117.06))
via("V6", (-57.9, -117.06))
pista("V6", "F.Cu", 0.5, (-57.9, -117.06), "R21.1")
# Tronco hasta una segunda vía al norte de C21.1 (y -105,3) y ramal a C20/C22 por y -107,41
pista("V6", "B.Cu", 0.5, (-49.44, -119.35), (-49.44, -105.3))
pista("V6", "B.Cu", 0.5, (-49.44, -107.41), (-46.55, -107.41))
via("V6", (-46.55, -107.41))
# EN_6V sigue por In2 hasta R25 (pull-down) y de ahí por In3 a U10
pista("EN_6V", "In2.Cu", 0.2, (-48.4, -118.25), (-51.35, -115.3), (-61.22, -115.3))
via("EN_6V", (-61.22, -115.3))
pista("EN_6V", "F.Cu", 0.2, (-61.22, -115.3), "R25.1")
# GND de la columna oeste: vías en el hueco entre columnas (x -55,55)
pista("GND", "F.Cu", 0.3, "C12.2", (-55.55, -114.58))
via("GND", (-55.55, -114.58))
pista("GND", "F.Cu", 0.35, "R22.2", "C15.2")
pista("GND", "F.Cu", 0.3, (-54.62, -117.1), (-55.55, -117.1))
via("GND", (-55.55, -117.1))
stub("GND", "C14.2", (-0.97, 0.0), 0.3)
# M3: la vía de GND de R23.2 baja a 45° al SE (antes 0,9 al este): con R23 0,30 al norte y la columna de
# HOME_PAD 0,15 al oeste (x -43,825), al este quedaba a 0,125 de esa pista.
stub("GND", "R23.2", (0.6, -0.6), 0.3)
# ---------------------------------------------------------------- V6 hacia el puente H
# La vertical x -46,55 une C22.1 y C20.1 y baja a B.Cu por dos vías (tronco de B.Cu desde C18).
pista("V6", "F.Cu", 0.5, "C22.1", "C20.1")
via("V6", (-46.55, -106.3))
pista("V6", "B.Cu", 0.5, (-46.55, -106.3), (-46.55, -107.41))
# ---------------------------------------------------------------- LED del encoder desde EN_6V
# R51 cuelga de EN_6V (P12 del TCA9535), no de V6: el TPS61089 no desconecta la carga y con EN bajo
# V6 = VSYS - 0,4 V, así que el LED lucía también dormido (revisión E independiente, I3). Desde la
# vía de EN_6V junto a U5 por B.Cu: al norte por x -48,4 (a 1 mm del tronco de V6), al este por
# y -108,4 (bajo la fila de V6 de y -107,41) y al norte por el pasillo de x -45,8 que ocupaba el
# ramal de V6, entre las vías de C20/C22 y la columna de J9, hasta la vía junto a R51.
pista("EN_6V", "B.Cu", 0.2, (-48.4, -118.25), (-48.4, -108.4), (-45.8, -108.4), (-45.8, -89.6))
via("EN_6V", (-45.8, -89.6))
pista("EN_6V", "F.Cu", 0.2, (-45.8, -89.6), "R51.1")
# ---------------------------------------------------------------- buck-boost de 3,3 V (TPS63802)
# Cin (C6) sobre VIN (pines 1/10) con dos vías de VSYS; L1 al este con los nodos SW de 0,6; Cout
# (C7) bajo VOUT (pin 6) y C8 en paralelo; FB (R16/R15) al oeste. GND de los pines 2/3/8 unidos
# bajo el chip y a una vía; toma Kelvin de 3V3 para R15 desde el pad de C7 por B.Cu.
pista("BB_SW1", "F.Cu", 0.3, "U3.9", (-88.25, -102.3))
pista("BB_SW1", "F.Cu", 0.6, (-88.25, -102.3), (-87.4, -101.45), (-86.2, -101.45))
pista("BB_SW2", "F.Cu", 0.3, "U3.7", (-88.25, -103.3))
pista("BB_SW2", "F.Cu", 0.6, (-88.25, -103.3), (-87.4, -104.15), (-86.2, -104.15))
pista("VSYS", "F.Cu", 0.3, "U3.10", (-89.17, -100.82))
pista("VSYS", "F.Cu", 0.6, (-89.17, -100.82), "C6.1")
pista("VSYS", "F.Cu", 0.6, (-89.17, -100.14), (-90.37, -100.14))
via("VSYS", (-89.77, -100.14))
via("VSYS", (-90.37, -100.14))
pista("VSYS", "F.Cu", 0.3, "U3.1", (-90.37, -101.345))
pista("VSYS", "F.Cu", 0.6, (-90.37, -101.345), (-90.37, -100.14))
pista("GND", "F.Cu", 0.25, "U3.2", (-91.55, -102.3))
pista("GND", "F.Cu", 0.25, "U3.3", (-91.55, -102.8), (-91.55, -102.3))
via("GND", (-91.55, -102.55))
pista("GND", "F.Cu", 0.25, "U3.3", "U3.8")
stub("GND", "C6.2", (0.0, 0.925), 0.4)
stub("GND", "C7.2", (0.0, -0.95), 0.4)
stub("GND", "C8.2", (0.0, -0.95), 0.4)
stub("GND", "R16.2", (0.0, 0.955), 0.3)
pista("BB_FB", "F.Cu", 0.25, "U3.4", "R16.1")
pista("BB_FB", "F.Cu", 0.25, "R16.1", "R15.2")
pista("3V3", "F.Cu", 0.3, "U3.6", (-89.17, -104.6))
pista("3V3", "F.Cu", 0.4, (-89.17, -104.6), "C7.1")
pista("3V3", "F.Cu", 0.4, "C7.1", (-87.6, -105.45), "C8.1")
pista("3V3", "F.Cu", 0.4, "C8.1", (-85.5, -106.45))
via("3V3", (-85.5, -106.45))
pista("3V3", "F.Cu", 0.4, (-85.5, -106.45), (-85.5, -107.3))
via("3V3", (-85.5, -107.3))
pista("3V3", "F.Cu", 0.4, "C7.1", (-90.6, -105.45))
via("3V3", (-90.6, -105.45))
pista("3V3", "B.Cu", 0.4, (-90.6, -105.45), (-93.5, -105.45), (-93.5, -103.45), (-95.3, -101.65))
via("3V3", (-95.3, -101.65))
pista("3V3", "F.Cu", 0.4, (-95.3, -101.65), "R15.1")
# ---------------------------------------------------------------- tronco de 3V3 por B.Cu (x -85,5)
# De las vías de C8 al módulo (C9/C10 y pin 2) por el canal; ramales: U10 y pull-ups (fila F y -76,6
# para C32/R36; fila B y -74,75 para R37/R38 y J7.5); J11.2 y J5.5 (fila y -98,24 y columna x -104,07
# entre los pads); lado este (y -103,0) para R26, R52, U11, C39, C27 y U8.
pista("3V3", "B.Cu", 0.4, (-85.5, -107.3), (-85.5, -70.95))
via("3V3", (-85.5, -70.95))
pista("3V3", "F.Cu", 0.4, (-85.5, -70.95), "C9.1")
# Segunda vía del tronco al módulo (0,55-0,7 A de pico; I1)
via("3V3", (-85.5, -73.4))
pista("3V3", "F.Cu", 0.4, (-85.5, -73.4), (-85.5, -70.95))
pista("3V3", "F.Cu", 0.4, "C9.1", (-83.2, -69.85), (-83.2, -64.26), "U4.2")
pista("3V3", "F.Cu", 0.4, (-83.2, -66.28), "C10.1")
via("3V3", (-85.5, -77.42))
pista("3V3", "F.Cu", 0.4, (-85.5, -77.42), "U10.24")
pista("3V3", "F.Cu", 0.4, "U10.24", (-86.94, -76.6), (-89.675, -76.6))
pista("3V3", "F.Cu", 0.4, "C32.1", (-88.08, -76.6))
pista("3V3", "F.Cu", 0.4, "R37.2", (-89.675, -76.6))
pista("3V3", "B.Cu", 0.4, (-85.5, -74.9), (-96.075, -74.9))
via("3V3", (-92.875, -74.9))
pista("3V3", "F.Cu", 0.4, (-92.875, -74.9), "R36.2")
via("3V3", (-96.075, -74.9))
pista("3V3", "F.Cu", 0.4, (-96.075, -74.9), "R38.2")
via("3V3", (-93.85, -74.85))
pista("3V3", "In2.Cu", 0.4, (-93.85, -74.85), (-93.85, -65.9), (-94.5, -65.25))
pista("3V3", "B.Cu", 0.4, (-85.5, -98.24), "J11.2", (-104.07, -98.24), (-104.07, -90.74), "J5.5")
pista("3V3", "B.Cu", 0.4, (-85.5, -103.0), (-57.9, -103.0))
via("3V3", (-57.9, -103.0))
pista("3V3", "F.Cu", 0.4, (-57.9, -103.0), "R26.1")
pista("3V3", "B.Cu", 0.4, (-57.9, -103.0), (-55.25, -100.35), (-52.775, -100.35))
via("3V3", (-52.775, -100.35))
pista("3V3", "F.Cu", 0.4, (-52.775, -100.35), "R52.2")
pista("3V3", "F.Cu", 0.4, "R52.2", (-51.25, -101.3), (-51.25, -97.42), "C39.1")
pista("3V3", "F.Cu", 0.4, (-48.975, -97.42), "C27.1")
pista("3V3", "F.Cu", 0.4, "C27.1", "U8.1")
# ---------------------------------------------------------------- cargador (BQ24073)
# VSYS por los pines 10/11 a C3 y C17 y dos vías; VBUS por el pin 13 a C2.1/C1.1 (verticales) y una
# vía a B.Cu (TP1 sobre la fila; R10/R11 en F; F1.2 por B); BAT como polígono (2,9 A) de los pines
# 2/3 a C4 y Q1, con vías para TP4 y para la toma de R13 (B.Cu); ILIM por In2 a R5; ISET a R4; TS
# por In2 a RT1 con vías de retorno; EP con 4 vías térmicas (declaradas) y los pines 4/8/15 a vías.
pista("VSYS", "F.Cu", 0.25, "U2.10", "U2.11")
pista("VSYS", "F.Cu", 0.25, "U2.11", (-65.25, -108.08))
pista("VSYS", "F.Cu", 0.6, (-65.25, -108.08), "C3.1", "C17.1", (-65.25, -103.75))
via("VSYS", (-65.25, -103.75))
pista("VSYS", "F.Cu", 0.6, (-65.25, -103.75), (-66.45, -103.75))
via("VSYS", (-66.45, -103.75))
pista("VSYS", "B.Cu", 0.6, (-66.45, -103.75), "TP5.1")
# Tres vías más de OUT al plano de In2, al oeste de TP5 bajo el tronco de 3V3 de B.Cu (y -103,0):
# cinco para el pico de 2,9 A (I1); antes había dos (la de R6.2 no está unida a OUT por F.Cu)
pista("VSYS", "F.Cu", 0.6, (-66.45, -103.75), (-68.7, -103.75))
via("VSYS", (-67.5, -103.75))
via("VSYS", (-68.7, -103.75))
pista("VSYS", "F.Cu", 0.6, (-68.1, -103.75), (-68.1, -104.5))
via("VSYS", (-68.1, -104.5))
stub("GND", "C3.2", (-0.95, 0.0), 0.4)
stub("GND", "C17.2", (0.0, 1.2), 0.6)
pista("VBUS", "F.Cu", 0.25, "U2.13", (-67.42, -109.75))
pista("VBUS", "F.Cu", 0.5, (-67.42, -109.75), "C2.1", "C1.1")
via("VBUS", (-68.5, -110.8))
# Segunda vía de VBUS junto a C1.1, unida al tramo de B.Cu (1,34 A en ILIM; I1)
pista("VBUS", "F.Cu", 0.5, "C1.1", (-69.6, -112.3))
via("VBUS", (-69.6, -112.3))
pista("VBUS", "B.Cu", 0.5, (-69.6, -112.3), (-69.6, -110.8))
pista("VBUS", "B.Cu", 0.5, (-68.5, -110.8), (-71.4, -110.8), (-72.2, -111.6), (-72.2, -116.12))
via("VBUS", (-72.2, -116.12))
pista("VBUS", "F.Cu", 0.5, (-72.2, -116.12), "R10.1", "R11.1")
pista("VBUS", "B.Cu", 0.5, (-72.2, -116.12), (-77.3, -116.12), (-79.48, -118.3), (-82.5, -118.3))
via("VBUS", (-82.5, -118.3))
pista("VBUS", "F.Cu", 0.5, (-82.5, -118.3), "F1.2")
# Segunda vía de F1.2 sobre el tramo de B.Cu, al este (entre R1 y el pad; I1)
via("VBUS", (-81.3, -118.3))
pista("VBUS", "F.Cu", 0.5, (-81.3, -118.3), (-82.5, -118.3))
# VBUS a J11.4 (THT) por B.Cu: diagonal larga por debajo de los convertidores
pista("VBUS", "B.Cu", 0.5, (-82.5, -118.3), (-84.0, -118.3), (-98.98, -103.32), "J11.4")
stub("GND", "C2.2", (0.0, 0.9), 0.3)
stub("GND", "C1.2", (-1.0, 0.0), 0.3)
pista("BQ_ISET", "F.Cu", 0.25, "U2.16", (-67.3, -111.25), (-67.3, -115.025), "R4.1")
stub("GND", "R4.2", (0.0, -1.0), 0.3)
pista("BQ_ILIM", "F.Cu", 0.25, "U2.12", (-66.85, -109.06), (-66.85, -108.325))
via("BQ_ILIM", (-66.85, -108.325))
pista("BQ_ILIM", "In2.Cu", 0.2, (-66.85, -108.325), (-62.775, -108.325), (-61.6, -109.5))
via("BQ_ILIM", (-61.6, -109.5))
pista("BQ_ILIM", "F.Cu", 0.25, (-61.6, -109.5), (-61.6, -108.725), "R5.1")
stub("GND", "R5.2", (0.0, 0.975), 0.3)
pista("GND", "F.Cu", 0.25, "U2.4", (-64.25, -112.95), (-63.6, -113.6))
via("GND", (-63.6, -113.6))
# U2.8 sube a su vía en diagonal: deja sitio a la vía de PGOOD al este de U2.7
pista("GND", "F.Cu", 0.25, "U2.8", (-63.2, -109.388), (-63.2, -108.95))
via("GND", (-63.2, -108.95))
pista("GND", "F.Cu", 0.25, "U2.15", (-67.7, -110.75))
via("GND", (-67.7, -110.75))
for _xy in ((-65.4, -110.9), (-64.6, -110.9), (-65.4, -110.1), (-64.6, -110.1)):
    via("GND", _xy)
pista("BAT", "F.Cu", 0.25, "U2.2", "U2.3")
zona("BAT", "F.Cu", [(-67.0, -112.3), (-61.0, -112.3), (-61.0, -121.3), (-67.0, -121.3)])
via("BAT", (-66.2, -120.4))
pista("BAT", "B.Cu", 0.8, (-66.2, -120.4), "TP4.1")
via("BAT", (-66.6, -112.9))
pista("BAT", "B.Cu", 0.8, (-66.6, -112.9), (-66.6, -109.3), (-73.9, -109.3), (-73.9, -106.525))
via("BAT", (-73.9, -106.525))
pista("BAT", "F.Cu", 0.8, (-73.9, -106.525), "R13.1")
# BAT_PAD: del pad de 3 mm de J2 al drenador de Q1 (0,8)
pista("BAT_PAD", "F.Cu", 0.8, (-67.0, -118.0), "Q1.5")
stub("GND", "C4.2", (0.0, -0.95), 0.3)
pista("BQ_TS", "F.Cu", 0.25, "U2.1", (-65.75, -113.5))
via("BQ_TS", (-65.75, -113.5))
# M1 (2026-10-27): la fila sube de y -114,3 a -114,05 (0,225 a la vía de GND de C5.2 (-69,5; -113,425)) y
# LED_CHG_A baja a -115,3: 1,05 borde a borde entre las dos (antes 0,70).
pista("BQ_TS", "In2.Cu", 0.2, (-65.75, -113.5), (-66.3, -114.05), (-81.85, -114.05), (-82.4, -113.5))
via("BQ_TS", (-82.4, -113.5))
pista("BQ_TS", "F.Cu", 0.25, (-82.4, -113.5), "RT1.1")
via("GND", (-65.65, -114.45))
via("GND", (-83.1, -113.8))
stub("GND", "RT1.2", (0.0, 0.95), 0.3)
# ---------------------------------------------------------------- USB-C: VBUS_IN, CC1, CC2 y GND
# U1 (USBLC6) es de paso: los pines 6-1 (D+) y 4-3 (D-) se unen por debajo del cuerpo con 0,15,
# así que VBUS_IN no puede subir por el hueco entre columnas. Entra en el pin 5 y baja a In2 por
# una vía bajo el cuerpo (In2 hasta la vía de A4/B9). A4/B9 (0,3 centrada entre los dos pads) y
# A9/B4 bajan con sus propias vías a B.Cu (1 oz) y de ahí van a F1.1 por la fila y -120,9, sobre
# el borde de la ranura del conector y bajo el pad de escudo, con dos vías junto a F1.1. Antes iba
# 27 mm por In2 a 0,5 mm: en 0,5 oz interior eso son 0,44 A a ΔT 10 °C frente a 1,34 A en modo
# ILIM (revisión E independiente, I2). En B.Cu, 0,5 mm llevan 1,45 A (IPC-2221, ΔT 10 °C); más
# ancho no cabe entre la vía de CC2 de J1, la muesca de la ranura (x -77,9) y el pad de escudo.
# CC1 (A5) por In2 bajo la fila de pads (y -120,8) a R1, al oeste de F1; CC2 (B5) por In3 (vacía
# en el lóbulo) bajo la fila de B.Cu de VBUS_IN hasta una vía al suroeste de R2.
# GND de A12/B1 a una vía; A1/B12 por el relleno.
pista("VBUS_IN", "F.Cu", 0.3, (-75.85, -121.194), (-75.85, -120.2))
via("VBUS_IN", (-75.85, -120.2))
pista("VBUS_IN", "F.Cu", 0.5, "U1.5", (-75.85, -118.2))
via("VBUS_IN", (-75.85, -118.2))
pista("VBUS_IN", "In2.Cu", 0.5, (-75.85, -120.2), (-75.85, -118.2))
pista("VBUS_IN", "F.Cu", 0.4, (-71.05, -121.194), (-71.05, -120.21))
via("VBUS_IN", (-70.95, -120.21))
pista("VBUS_IN", "B.Cu", 0.5, (-70.95, -120.21), (-70.95, -120.85), (-79.75, -120.85), (-81.31, -122.41),
      (-83.9, -122.41), (-83.9, -123.41))
pista("VBUS_IN", "B.Cu", 0.5, (-75.85, -120.2), (-75.85, -120.85))
via("VBUS_IN", (-83.9, -122.41))
via("VBUS_IN", (-83.9, -123.41))
pista("VBUS_IN", "F.Cu", 0.5, (-83.9, -123.41), (-83.9, -122.41), "F1.1")
pista("CC1", "F.Cu", 0.2, "J1.A5", (-74.75, -120.2))
pista("CC1", "F.Cu", 0.15, (-74.75, -120.2), (-74.99, -119.96))
via("CC1", (-74.99, -119.96))
pista("CC1", "In2.Cu", 0.2, (-74.99, -119.96), (-74.99, -120.8), (-78.8, -120.8), (-79.5, -120.1), (-79.5, -118.925), (-81.0, -117.425))
via("CC1", (-81.0, -117.425))
pista("CC1", "F.Cu", 0.2, (-81.0, -117.425), "R1.1")
pista("CC2", "F.Cu", 0.2, "J1.B5", (-71.75, -120.1))
via("CC2", (-71.75, -120.1))   # 0,05 al norte: deja 0,2 a la fila de VBUS_IN de B.Cu
pista("CC2", "In3.Cu", 0.2, (-71.75, -120.1), (-71.75, -120.9), (-80.0, -120.9), (-80.9, -120.0))
via("CC2", (-80.9, -120.0))
pista("CC2", "F.Cu", 0.2, (-80.9, -120.0), "R2.1")
stub("GND", "R1.2", (0.0, 0.9), 0.3)
stub("GND", "R2.2", (0.0, 1.0), 0.3)
stub("GND", "U1.2", (-1.0625, 0.0), 0.3)
stub("GND", "J1.A12", (0.0, 1.09), 0.3)
# ---------------------------------------------------------------- par USB (clase C, 0,28/0,15)
# Campo de pads de J1: 0,2 dentro del patio de J1 y 0,15 hasta U1. D+: A6 sube recta y B6 sube
# con un quiebro a x -72,45, cruza por encima de la vía de D- y entra en el pin 6 recogiendo a A6
# en un cruce a 90°; D-: B7 sube al pin 4 y A7 sube entre A6 y B6 hasta una vía de 0,45 y sigue
# por B.Cu (TP3 sobre esa pista) hasta otra vía en la salida del pin 3. Retornos de GND: vía
# (-73,1, -117,9) a 0,96 mm de la primera (entre A6 y el quiebro de B6) y la vía del pin 2 a
# 0,95 mm de la segunda. Con pads a 0,5 mm de paso, la vía de 0,6 solo cabe si B6 se aparta.
# Paso por U1: pines 6-1 y 4-3 unidos con 0,15 bajo el cuerpo. El par sale por el oeste de U1
# (x -78,7 / -79,13), sube por el pasillo norte-sur, cruza al canal (x -83,5 / -83,93) y entra en
# los pines 14 (D+) y 13 (D-). TP2 (D+) sobre una vía de 0,45 a la entrada del pin 14.
pista("USB_DP", "F.Cu", 0.2, "J1.A6", (-73.75, -120.25))
pista("USB_DP", "F.Cu", 0.15, (-73.75, -120.25), (-73.75, -117.25))
pista("USB_DP", "F.Cu", 0.2, "J1.B6", (-72.75, -120.25))
pista("USB_DP", "F.Cu", 0.15, (-72.75, -120.25), (-72.45, -119.95), (-72.45, -117.25), "U1.6")
pista("USB_DP", "F.Cu", 0.15, "U1.6", "U1.1")
pista("USB_DN", "F.Cu", 0.2, "J1.B7", (-74.25, -120.25))
pista("USB_DN", "F.Cu", 0.15, (-74.25, -120.25), (-74.25, -119.6125), (-74.7125, -119.15), "U1.4")
pista("USB_DN", "F.Cu", 0.15, "U1.4", "U1.3")
pista("USB_DN", "F.Cu", 0.2, "J1.A7", (-73.25, -120.25))
pista("USB_DN", "F.Cu", 0.15, (-73.25, -120.25), (-73.25, -118.85))
via("USB_DN", (-73.25, -118.85), VIA_USB)
pista("USB_DN", "B.Cu", 0.2, (-73.25, -118.85), (-76.9, -118.85), (-77.2, -119.15), (-78.1, -119.15))
via("USB_DN", (-78.1, -119.15), VIA_USB)
via("GND", (-73.1, -117.9))
pista("USB_DP", "F.Cu", 0.28, "U1.1", (-78.7, -117.25), (-78.7, -89.0), (-83.5, -84.2), (-83.5, -79.5), "U4.14")
pista("USB_DN", "F.Cu", 0.28, "U1.3", (-79.13, -119.15), (-79.13, -89.178), (-83.93, -84.378), (-83.93, -78.23), "U4.13")
via("USB_DP", (-83.0, -79.5), VIA_USB)
via("GND", (-82.83, -80.4))
pista("USB_DP", "B.Cu", 0.28, (-83.0, -79.5), (-83.5, -80.0), (-84.3, -80.8), "TP2.1")
# ---------------------------------------------------------------- cámara: bus DVP J6 -> U4 (clase B)
# Rutado "de río" en F.Cu desde la columna de pads de J6 (x -50,6; paso 0,5) hasta la fila sur del
# módulo (pines 18-25, se entran desde abajo) y la columna este (31-34), sin cruces: Y4/Y3/Y5/Y2
# (pines 22-19 de J6) suben en escalera entre SW1 y la columna de pads (x -62,3…-63,2) a los
# pines 34-31; los ocho restantes bajan a 45° desde x -56,5 a una banda de paso 0,3 en
# y -81,8…-83,9 (entre la fila de pads y JP1/JP3, que bajan a y -85,1) y entran en 25-18 por
# orden. Los pines no DVP de J6 salen por el este bajo el cuerpo (GND 15, 3V3 11, DVDD 10,
# PWDN 8, SCL 5, SDA 3, GND 2: columna de vías en x -43,9) o por el oeste (2V8 4 a una vía;
# CAM_RST 6 en F.Cu a R35/C31). Retornos de GND a <= 1 mm de cada vía de red CAM_*.
# Series de 33 Ω en el origen de los relojes (M7, 2026-10-27), 0402 a 0° y en F.Cu, sin vías:
# · PCLK (lo genera la cámara): R60 en (-53,6; -78,0), a 2 mm del pad 17. PCLK baja 0,25 a y -78,0
#   nada más salir del patio de J6 (x -51,8 → -52,05) y vuelve a -77,75 al oeste de R60 (x -55,2 →
#   -55,45); Y7 baja 0,35 a y -78,6 (x -51,8 → -52,15) y vuelve a -78,25 en x -55,6 → -55,95, más
#   al oeste que el quiebro de PCLK para no acercarse a él a < 0,2. Entre Y6 (-77,25) y Y7 (-78,6)
#   quedan 0,355 y 0,205 a los pads de R60 (0,64 de alto); Y8 (-79,25) sigue a 0,5 de Y7.
# · XCLK (lo genera el ESP32): R59 en (-72,365; -82,35), bajo el pin 21 (patio del módulo en
#   y -81,70, pads a 0,53 del pin). Pad 1 (oeste, x -72,875) sube y entra en el pin 21 por su eje
#   con una diagonal; pad 2 (este, x -71,855) baja recto a la fila de XCLK (y -83,0), que se
#   acorta 0,51 por el este. Y8 sube por x -71,095 (0,415 del pad 2) y Y9 por x -73,635 (0,415
#   del pad 1); la fila de Y9 (y -83,3) no pasa bajo los pads.
pista("CAM_Y4", "F.Cu", 0.15, "J6.22", (-62.3, -75.25), (-62.3, -70.61), "U4.34")
pista("CAM_Y3", "F.Cu", 0.15, "J6.21", (-62.6, -75.75), (-62.6, -71.88), "U4.33")
pista("CAM_Y5", "F.Cu", 0.15, "J6.20", (-62.9, -76.25), (-62.9, -73.15), "U4.32")
pista("CAM_Y2", "F.Cu", 0.15, "J6.19", (-63.2, -76.75), (-63.2, -74.42), "U4.31")
pista("CAM_Y6", "F.Cu", 0.15, "J6.18", (-56.5, -77.25), (-61.05, -81.8), (-67.285, -81.8), "U4.25")
pista("CAM_PCLK_CAM", "F.Cu", 0.15, "J6.17", (-51.8, -77.75), (-52.05, -78.0), "R60.2")
pista("CAM_PCLK", "F.Cu", 0.15, "R60.1", (-55.2, -78.0), (-55.45, -77.75), (-56.5, -77.75), (-60.85, -82.1), (-68.555, -82.1), "U4.24")
pista("CAM_Y7", "F.Cu", 0.15, "J6.16", (-51.8, -78.25), (-52.15, -78.6), (-55.6, -78.6), (-55.95, -78.25), (-56.5, -78.25), (-60.65, -82.4), (-69.825, -82.4), "U4.23")
pista("CAM_Y8", "F.Cu", 0.15, "J6.14", (-56.5, -79.25), (-59.95, -82.7), (-71.095, -82.7), "U4.22")
pista("CAM_XCLK", "F.Cu", 0.15, "J6.13", (-56.5, -79.75), (-59.75, -83.0), (-71.855, -83.0), "R59.2")
pista("CAM_XCLK_IO", "F.Cu", 0.15, "R59.1", "U4.21", modo="d")
pista("CAM_Y9", "F.Cu", 0.15, "J6.12", (-56.5, -80.25), (-59.55, -83.3), (-73.635, -83.3), "U4.20")
pista("CAM_HREF", "F.Cu", 0.15, "J6.9", (-56.5, -81.75), (-58.35, -83.6), (-74.905, -83.6), "U4.19")
pista("CAM_VSYNC", "F.Cu", 0.15, "J6.7", (-56.5, -82.75), (-57.65, -83.9), (-76.175, -83.9), "U4.18")
# Salidas por el este (bajo el cuerpo de J6) a la columna de vías x -43,9
pista("GND", "F.Cu", 0.15, "J6.15", (-43.9, -78.75))
via("GND", (-43.9, -78.75))
pista("3V3", "F.Cu", 0.3, "J6.11", (-49.7, -80.75))
pista("3V3", "F.Cu", 0.4, (-49.7, -80.75), (-45.0, -80.75), (-45.0, -79.5))
via("3V3", (-45.0, -79.5))
pista("CAM_DVDD", "F.Cu", 0.15, "J6.10", (-44.3, -81.25), (-43.9, -81.65))
via("CAM_DVDD", (-43.9, -81.65))
via("GND", (-43.9, -82.65))
pista("CAM_PWDN", "F.Cu", 0.15, "J6.8", (-45.3, -82.25), (-43.9, -83.65))
via("CAM_PWDN", (-43.9, -83.65))
pista("I2C_SCL", "F.Cu", 0.15, "J6.5", (-44.8, -83.75), (-43.9, -84.65))
via("I2C_SCL", (-43.9, -84.65))
pista("I2C_SDA", "F.Cu", 0.15, "J6.3", (-44.8, -84.75), (-43.9, -85.65))
via("I2C_SDA", (-43.9, -85.65))
pista("GND", "F.Cu", 0.15, "J6.2", (-45.3, -85.25), (-43.9, -86.65))
via("GND", (-43.9, -86.65))
# CAM_DVDD: por In2 bordeando J9 hasta una vía junto a U9.5/C29 (TP11 en B.Cu)
pista("CAM_DVDD", "In2.Cu", 0.2, (-43.9, -81.65), (-43.2, -82.35), (-43.2, -89.0), (-45.6, -91.4), (-45.6, -94.2), (-47.3, -95.9))
via("CAM_DVDD", (-47.3, -95.9))
via("GND", (-48.2, -96.2))
pista("CAM_DVDD", "F.Cu", 0.2, (-47.3, -95.9), (-46.35, -95.9))
pista("CAM_DVDD", "F.Cu", 0.3, "U9.5", "C29.1")
pista("CAM_DVDD", "B.Cu", 0.2, (-47.3, -95.9), (-46.9, -96.3), (-46.9, -97.5), (-47.9, -98.5), "TP11.1")
# 3V3 del pin 11 de J6, de R35.2 (pull-up de RST) y de R18.2 (pull-up de BOOT): fila de In2 en
# y -79,5 con una columna a la vía de R35.2, y de ahí por B.Cu a U8.1 (tronco de 3V3)
pista("3V3", "F.Cu", 0.4, "R35.2", (-54.7, -83.675))
via("3V3", (-54.7, -83.675))
pista("3V3", "B.Cu", 0.4, (-54.7, -83.675), (-54.7, -86.5), (-53.4, -87.8), (-50.65, -87.8))
via("3V3", (-50.65, -87.8))
pista("3V3", "F.Cu", 0.4, (-50.65, -87.8), "U8.1")
pista("3V3", "F.Cu", 0.4, "R18.2", (-59.8, -79.5))
via("3V3", (-59.8, -79.5))
pista("3V3", "In2.Cu", 0.4, (-59.8, -79.5), (-45.0, -79.5))
pista("3V3", "In2.Cu", 0.4, (-54.7, -79.5), (-54.7, -83.675))
# BOOT: pin 27 -> R18.1 en F.Cu; de R18.1 por In2 a SW2 (el grupo Y2-Y4 cierra el paso en F.Cu)
pista("BOOT", "F.Cu", 0.15, "U4.27", "R18.1")
pista("BOOT", "F.Cu", 0.15, "R18.1", (-62.325, -80.7))
via("BOOT", (-62.325, -80.7))
pista("BOOT", "In2.Cu", 0.2, (-62.325, -80.7), (-62.325, -79.0), (-57.2, -73.875), (-57.2, -73.3))
via("BOOT", (-57.2, -73.3))
pista("BOOT", "F.Cu", 0.15, (-56.9, -73.3), "SW2.1")
# CAM_2V8 del pin 4: vía al oeste, In2 hasta U8.5 (TP10 en B.Cu) y C28.1; U9.1 con su propia vía a la
# misma columna de In2 (el tronco de 3V3 en F.Cu, x -48,975, cierra el paso entre U8 y U9)
pista("CAM_2V8", "F.Cu", 0.15, "J6.4", (-52.3, -84.25))
via("CAM_2V8", (-52.3, -84.25))
via("GND", (-52.3, -85.25))
pista("CAM_2V8", "In2.Cu", 0.25, (-52.3, -84.25), (-53.0, -84.95), (-53.0, -91.512), (-51.512, -93.0))
via("CAM_2V8", (-51.512, -93.0))
via("GND", (-52.3, -93.6))
pista("CAM_2V8", "F.Cu", 0.25, (-51.512, -93.0), "U8.5")
pista("CAM_2V8", "F.Cu", 0.3, "U8.5", "C28.1")
pista("CAM_2V8", "F.Cu", 0.25, "U9.1", (-46.35, -91.7), (-46.55, -91.5))
via("CAM_2V8", (-46.55, -91.5))
pista("CAM_2V8", "In2.Cu", 0.25, (-46.55, -91.5), (-46.55, -90.4), (-47.25, -89.7), (-53.0, -89.7))
pista("CAM_2V8", "B.Cu", 0.2, (-51.512, -93.0), (-51.512, -92.088), "TP10.1")
# CAM_RST (pin 6) en F.Cu a R35.1 y, bajando a 45°, a C31.1
pista("CAM_RST", "F.Cu", 0.15, "J6.6", (-53.0, -83.25), (-55.075, -85.325), "R35.1", (-55.7, -86.225), "C31.1")
# CAM_EN: vía A junto a U8.3 y vía B sobre U9.3 (el resto de la red, por In2, en el bloque del expansor)
pista("CAM_EN", "F.Cu", 0.15, "U8.3", (-52.95, -89.862), (-53.5, -89.312), (-53.8, -89.312))
via("CAM_EN", (-53.8, -89.312))
via("GND", (-54.25, -88.6))
pista("CAM_EN", "F.Cu", 0.15, "U9.3", (-48.25, -91.6))
via("CAM_EN", (-48.25, -91.6))
pista("GND", "F.Cu", 0.25, "U9.2", (-47.3, -90.9))
via("GND", (-47.3, -90.9))
via("GND", (-48.25, -90.75))
# Puentes de soldadura (fila y -85,1 entre la banda DVP y el anillo del mecanismo; JP3 a 270° al
# este): IPROPI_IO / MOT_IN1_IO / MOT_IN2_IO desde los pines 15-17; JP1.2 -> R29.1 en F.Cu y
# JP2.2 -> R30.1 (bajo la batería) por In2 (los pull-down del puente H)
pista("IPROPI_IO", "F.Cu", 0.15, "U4.15", (-79.985, -82.3))
via("IPROPI_IO", (-79.985, -82.3))
pista("MOT_IN2_IO", "F.Cu", 0.15, "U4.16", (-78.715, -82.3))
via("MOT_IN2_IO", (-78.715, -82.3))
pista("MOT_IN1_IO", "F.Cu", 0.15, "U4.17", (-77.445, -82.3))
via("MOT_IN1_IO", (-77.445, -82.3))
via("GND", (-79.35, -83.0))
via("GND", (-78.08, -83.0))
pista("MOT_IN1_IO", "In2.Cu", 0.2, (-77.445, -82.3), (-77.445, -83.5), (-76.645, -84.3), (-68.15, -84.3), (-67.35, -85.1))
via("MOT_IN1_IO", (-67.35, -85.1))
via("GND", (-68.35, -85.1))
pista("MOT_IN1_IO", "F.Cu", 0.15, (-67.35, -85.1), "JP1.1")
pista("MOT_IN2_IO", "In2.Cu", 0.2, (-78.715, -82.3), (-78.715, -85.1), (-77.915, -85.9), (-64.55, -85.9), (-63.75, -85.1))
via("MOT_IN2_IO", (-63.75, -85.1))
via("GND", (-63.75, -86.1))
pista("MOT_IN2_IO", "F.Cu", 0.15, (-63.75, -85.1), "JP2.1")
# IPROPI_IO por B.Cu (en In2 cruzaría la diagonal de IPROPI junto a JP3)
pista("IPROPI_IO", "B.Cu", 0.2, (-79.985, -82.3), (-79.985, -87.1), (-78.785, -88.3), (-58.0, -88.3), (-57.0, -87.3), (-57.0, -85.05))
via("IPROPI_IO", (-57.0, -85.05))
via("GND", (-57.7, -85.75))
pista("IPROPI_IO", "F.Cu", 0.15, "JP3.1", (-57.0, -85.05))
pista("MOT_IN1", "F.Cu", 0.15, "JP1.2", (-64.85, -85.775), "R29.1")
pista("MOT_IN2", "F.Cu", 0.15, "JP2.2", (-61.35, -86.3))
via("MOT_IN2", (-61.35, -86.3))
pista("MOT_IN2", "In2.Cu", 0.2, (-61.35, -86.3), (-61.85, -86.8), (-70.8, -86.8), (-71.25, -87.25))
via("MOT_IN2", (-71.25, -87.25))
pista("MOT_IN2", "F.Cu", 0.15, (-71.25, -87.25), "R30.1")
# ---------------------------------------------------------------- puente H (DRV8231A) y V6 local
# V6: C21.1 desde dos vías del tronco de B.Cu (al sur y al norte del pad, I1), de ahí al pin 5 (0,5,
# ancho mayor que el pad); C19.1 con su propia vía; C22.1 y C20.1 por la vertical x -46,55 (dos vías).
# Salidas: OUT2 (pin 8) a J9.11 por F.Cu al noreste; OUT1 (pin 6) por In2 a J9.12 (los pads 11/12
# del motor se intercambiaron en el esquema). IPROPI a R28 y, por una vía, a TP8 (B) y JP3 (In2
# por x -54,7, fuera del anillo del mecanismo; JP3 bajo el bus de la cámara). VREF a C23 y por In2 a R27/R26. EP con 2 vías.
via("V6", (-49.44, -108.0))
pista("V6", "F.Cu", 0.5, (-49.44, -108.0), "C21.1")
via("V6", (-49.44, -105.3))
pista("V6", "F.Cu", 0.5, (-49.44, -105.3), "C21.1")
pista("V6", "F.Cu", 0.25, "U6.5", (-48.55, -105.45))
pista("V6", "F.Cu", 0.5, (-48.55, -105.45), (-48.55, -106.45), (-49.44, -107.34))
pista("V6", "B.Cu", 0.5, (-49.44, -108.3), (-53.85, -108.3))
via("V6", (-53.85, -108.3))
pista("V6", "F.Cu", 0.5, (-53.85, -108.3), "C19.1")
pista("MOT_OUT2", "F.Cu", 0.25, "U6.8", (-48.05, -102.45))
pista("MOT_OUT2", "F.Cu", 0.5, (-48.05, -102.45), (-47.25, -101.65), (-44.34, -101.65))
pista("MOT_OUT1", "F.Cu", 0.25, "U6.6", (-47.55, -103.95))
via("MOT_OUT1", (-47.55, -103.95))
# Segunda vía al sur, hacia la vía de GND (-47,54; -105,5): al norte cortaría el único paso del
# relleno de GND de F.Cu entre C22.2 y U6.7 (I1). In2 a 1,0 mm: a 0,5 mm en 0,5 oz interior solo
# llevaba 0,44 A a ΔT 10 °C (IPC-2221); 3,5 mm a 1,0 mm son 4 mΩ, 4 mW a 1,0 A
pista("MOT_OUT1", "F.Cu", 0.5, (-47.55, -103.95), (-47.55, -104.65))
via("MOT_OUT1", (-47.55, -104.65))
pista("MOT_OUT1", "In2.Cu", 1.0, (-47.55, -103.95), (-46.8, -104.7), "J9.12")
pista("MOT_OUT1", "In2.Cu", 0.5, (-47.55, -104.65), (-47.55, -103.95))   # 1,0 rozaría la vía de GND
pista("GND", "F.Cu", 0.25, "U6.7", (-49.5, -103.45))
via("GND", (-49.5, -103.3))
via("GND", (-49.5, -104.1))
pista("IPROPI", "F.Cu", 0.25, "U6.1", ("R28.1", 0.0, -0.17))   # recto: R28 está 0,17 al norte del pin 1 (bloque M)
pista("IPROPI", "F.Cu", 0.25, "R28.1", (-51.825, -102.0))
via("IPROPI", (-51.825, -102.0))
pista("IPROPI", "B.Cu", 0.2, (-51.825, -102.0), (-51.3, -101.475), "TP8.1")
pista("IPROPI", "In2.Cu", 0.2, (-51.825, -102.0), (-54.7, -102.0), (-54.7, -91.8), (-58.95, -87.55))
via("GND", (-59.95, -87.55))
via("GND", (-50.95, -102.2))
via("IPROPI", (-58.95, -87.55))
pista("IPROPI", "F.Cu", 0.2, (-58.95, -87.55), "JP3.2")
pista("MOT_VREF", "F.Cu", 0.25, "U6.4", ("C23.1", 0.0, 0.3))   # recto: C23 está 0,30 al sur del pin 4 (bloque M)
pista("MOT_VREF", "F.Cu", 0.25, "C23.1", (-51.875, -105.55), (-55.275, -105.55), "R27.1")
pista("MOT_VREF", "F.Cu", 0.2, "R27.1", "R26.2")
# Vías de GND de R28.2 y C23.2 en los extremos de la columna x -54,375 (paso 0,75); entre ellas, las de MOT_IN2 y
# MOT_IN1 (bloque M). La de R28.2 no sube más: IPROPI va por In2 en y -102,0 (0,25 de margen).
pista("GND", "F.Cu", 0.3, "R28.2", (-53.605, -102.65), (-54.375, -102.65))
via("GND", (-54.375, -102.65))
pista("GND", "F.Cu", 0.3, "C23.2", (-54.225, -104.75), (-54.375, -104.9))
via("GND", (-54.375, -104.9))
stub("GND", "R27.2", (0.0, -0.8), 0.3)
stub("GND", "C19.2", (1.0, 0.0), 0.3)
stub("GND", "C21.2", (0.0, 1.2), 0.3)
stub("GND", "C20.2", (-1.05, 0.0), 0.3)
stub("GND", "C22.2", (0.0, 0.875), 0.3)
# ---------------------------------------------------------------- amplificador de clase D (MAX98357)
# VSYS por los pines 7/8 a C26.1 y a una vía; C25/C24 (bulk) con sus vías; GND de los pines 3/11/15
# al EP (1 vía). SPK_P/SPK_N (0,4) a J8.6/J8.7 en diagonales paralelas separadas.
pista("VSYS", "F.Cu", 0.25, "U7.7", "U7.8")
pista("VSYS", "F.Cu", 0.25, "U7.7", (-96.25, -87.2))
pista("VSYS", "F.Cu", 0.6, (-96.25, -87.2), (-96.25, -85.7))
via("VSYS", (-96.25, -85.7))
pista("VSYS", "F.Cu", 0.25, "U7.2", (-93.6, -89.85))
pista("VSYS", "F.Cu", 0.6, (-93.6, -89.85), (-92.4, -89.85))
via("VSYS", (-92.4, -89.85))
pista("VSYS", "F.Cu", 0.6, "C25.1", (-97.2, -92.3))
via("VSYS", (-97.2, -92.3))
pista("VSYS", "F.Cu", 0.6, "C24.1", (-100.4, -93.55))
via("VSYS", (-100.4, -93.55))
pista("GND", "F.Cu", 0.25, "U7.3", (-95.6, -89.35))
pista("GND", "F.Cu", 0.25, "U7.11", (-96.4, -89.85))
pista("GND", "F.Cu", 0.25, "U7.15", (-95.75, -90.0))
via("GND", (-96.0, -89.6))
stub("GND", "C26.2", (0.0, 0.95), 0.3)
# C41 (10 µF, sim/RESULTADOS.md «Amplificador»): al oeste de C26, entre el tronco de VSYS de los pines 7/8 y SPK_P; su VSYS
# entra en el tronco por y -86,075 (≈ 2,5 mm de cobre hasta los pines) y su GND baja por una vía al oeste.
pista("VSYS", "F.Cu", 0.6, "C41.1", (-96.25, -86.075))
stub("GND", "C41.2", (-1.05, 0.0), 0.4)
stub("GND", "C25.2", (0.0, -1.1), 0.6)
stub("GND", "C24.2", (0.0, 1.2), 0.6)
pista("SPK_P", "F.Cu", 0.25, "U7.9", (-97.4375, -87.85))
pista("SPK_P", "F.Cu", 0.4, (-97.4375, -87.85), (-101.7, -83.59))
pista("SPK_N", "F.Cu", 0.25, "U7.10", (-98.19, -89.35))
pista("SPK_N", "F.Cu", 0.4, (-98.19, -89.35), "J8.7")
# ---------------------------------------------------------------- I2S (clase B), I2C, EXP_INT, EN, AMP_SD
# Los pines 3-10 del módulo (columna oeste) no pueden salir en F.Cu (el tronco de 3V3 de C9/C10 y
# el par USB cierran el paso): cada uno baja a una vía bajo el cuerpo del módulo (x -80,3 … -78,7)
# con su vía de retorno de GND. I2S por In2: columnas x -82,2 (DIN) / -81,8 (WS; estos dos con la
# vía al oeste del pad) / -81,4 (BCLK) / -81,0 (DOUT) y filas y -87,0 … -88,2 hasta J5.1 (THT),
# U7.14 (WS, vía bajo C25 desde el oeste), U7.16 (BCLK, vía al este de C25) y U7.1 (DOUT, vía con
# TP9 en B). BCLK y WS siguen en F.Cu hasta R31/R32 (a 180°,
# con el lado del micro al oeste) y de ahí SCK_MIC/WS_MIC en F.Cu a J5.3/J5.4 (WS_MIC bordea J5 y
# J11 por el oeste). I2C: vías de los pines 4/5 → In2 (columnas x -84,3 / -83,9) a U10.23/22 y
# B.Cu (filas y -66,8 / -69,0) a R36.1/R37.1 (R36 y R37 intercambiados para que las filas aniden;
# J7.5 se alimenta por In2 por x -93,85 para dejar libre B.Cu). EXP_INT: vía del pin 6 → In2 por encima de todo
# (y -66,2) y columna x -84,8 a U10.1 y R38.1. EN: vía del pin 3 → In2 a R17/C11 (oeste) y a
# SW1 (este, fila y -63,6). AMP_SD en F.Cu por la columna x -93,75.
pista("I2S_BCLK", "F.Cu", 0.15, "U4.7", (-80.3, -70.61))
via("I2S_BCLK", (-80.3, -70.61))
pista("I2S_WS", "F.Cu", 0.15, "U4.8", (-83.1, -71.88))
via("I2S_WS", (-83.1, -71.88))
pista("I2S_DOUT", "F.Cu", 0.15, "U4.9", (-80.3, -73.15))
via("I2S_DOUT", (-80.3, -73.15))
pista("I2S_DIN", "F.Cu", 0.15, "U4.10", (-83.1, -74.42))
via("I2S_DIN", (-83.1, -74.42))
via("GND", (-79.5, -70.6))
via("GND", (-79.6, -73.75))
via("GND", (-83.1, -72.85))
via("GND", (-83.1, -75.4))
# M1 (2026-10-27): la columna de BCLK junto a U7 pasa de x -94,4 a -94,0 (0,4 a la de DOUT, 0,2 a la vía de GND
# (-93,4; -91,95)) y entra en su vía con una diagonal: queda a 1,15 borde a borde de EXP_P07 (In3, x -95,35).
pista("I2S_BCLK", "In2.Cu", 0.2, (-80.3, -70.61), (-81.4, -70.61), (-81.4, -87.8), (-94.0, -87.8), (-94.0, -91.9), (-94.4, -92.3))
via("I2S_BCLK", (-94.4, -92.3))
via("GND", (-93.7, -92.9))
pista("I2S_BCLK", "F.Cu", 0.25, "U7.16", (-95.25, -91.45), (-94.4, -92.3))
pista("I2S_BCLK", "F.Cu", 0.15, (-94.4, -92.3), (-94.4, -95.9), "R31.1")
pista("I2S_WS", "In2.Cu", 0.2, (-83.1, -71.88), (-81.8, -73.18), (-81.8, -87.4), (-98.6, -87.4), (-98.6, -94.85), (-96.25, -94.85))
via("I2S_WS", (-96.25, -94.85))
pista("I2S_WS", "F.Cu", 0.25, "U7.14", (-96.25, -91.8))
pista("I2S_WS", "F.Cu", 0.15, (-96.25, -91.8), (-96.25, -96.775), (-95.425, -97.6))
pista("I2S_DOUT", "In2.Cu", 0.2, (-80.3, -73.15), (-81.0, -73.15), (-81.0, -88.2), (-93.4, -88.2), (-93.4, -90.95))
via("I2S_DOUT", (-93.4, -90.95))
via("GND", (-93.4, -91.95))
pista("I2S_DOUT", "F.Cu", 0.25, "U7.1", (-94.0, -90.35), (-93.4, -90.95))
pista("I2S_DOUT", "B.Cu", 0.2, (-93.4, -90.95), (-92.35, -92.0), "TP9.1")
pista("I2S_DIN", "In2.Cu", 0.2, (-83.1, -74.42), (-82.2, -75.32), (-82.2, -87.0), (-101.6, -87.0), "J5.1")
pista("I2S_SCK_MIC", "F.Cu", 0.15, "R31.2", (-98.9, -95.9), (-101.52, -93.28), "J5.3")
pista("I2S_WS_MIC", "F.Cu", 0.15, "R32.2", (-97.9, -97.6), (-98.4, -98.1), (-98.4, -99.5), (-106.6, -99.5), (-106.6, -88.2), "J5.4")
# I2C y EXP_INT
pista("I2C_SDA", "F.Cu", 0.15, "U4.4", (-80.3, -66.8))
via("I2C_SDA", (-80.3, -66.8))
pista("I2C_SCL", "F.Cu", 0.15, "U4.5", (-79.5, -68.07))
via("I2C_SCL", (-79.5, -68.07))
pista("EXP_INT", "F.Cu", 0.15, "U4.6", (-78.7, -69.34))
via("EXP_INT", (-78.7, -69.34))
pista("I2C_SDA", "In2.Cu", 0.2, (-80.3, -66.8), (-83.1, -66.8), (-84.3, -68.0), (-84.3, -77.575), (-84.8, -78.075))
via("I2C_SDA", (-84.8, -78.075))
pista("I2C_SDA", "F.Cu", 0.15, "U10.23", (-84.8, -78.075))
pista("I2C_SCL", "In2.Cu", 0.2, (-79.5, -68.07), (-82.8, -68.07), (-83.9, -69.17), (-83.9, -78.35), (-84.65, -79.1))
via("I2C_SCL", (-84.65, -79.1))
pista("I2C_SCL", "F.Cu", 0.15, "U10.22", (-85.025, -78.725), (-84.65, -79.1))
pista("I2C_SDA", "B.Cu", 0.2, (-80.3, -66.8), (-94.3, -66.8), (-94.3, -73.5), (-95.0, -74.2))
via("I2C_SDA", (-95.0, -74.2))
pista("I2C_SDA", "F.Cu", 0.15, "R36.1", (-94.525, -74.675), (-95.0, -74.2))
pista("I2C_SCL", "B.Cu", 0.2, (-79.5, -68.07), (-80.43, -69.0), (-91.325, -69.0), (-91.325, -74.2))
via("I2C_SCL", (-91.325, -74.2))
# Bloque U2: 0,3 para equilibrar con el 3V3 de 0,4 de R37.2 (antes R37.1 tenía dos pistas de 0,15).
pista("I2C_SCL", "F.Cu", 0.3, "R37.1", (-91.325, -74.2))
pista("EXP_INT", "In2.Cu", 0.2, (-78.7, -69.34), (-78.7, -66.2), (-84.8, -66.2), (-84.8, -75.5), (-86.0, -76.7), (-92.663, -76.7))
via("EXP_INT", (-92.663, -76.7))
pista("EXP_INT", "F.Cu", 0.15, "U10.1", (-92.663, -76.7))
pista("EXP_INT", "In2.Cu", 0.2, (-92.663, -76.7), (-93.663, -75.7), (-98.8, -75.7))
via("EXP_INT", (-98.8, -75.7))
pista("EXP_INT", "F.Cu", 0.15, "R38.1", (-98.8, -75.7))
# EN
pista("EN", "F.Cu", 0.15, "U4.3", (-80.3, -65.53))
via("EN", (-80.3, -65.53))
pista("EN", "In2.Cu", 0.2, (-80.3, -65.53), (-80.3, -64.0), (-90.6, -64.0), (-90.6, -69.8))
via("EN", (-90.6, -69.8))
pista("EN", "F.Cu", 0.15, "R17.1", "C11.1")
pista("EN", "F.Cu", 0.15, (-89.625, -69.8), (-90.6, -69.8))
pista("EN", "In2.Cu", 0.2, (-80.3, -64.0), (-79.9, -63.6), (-61.2, -63.6), (-60.8, -64.0), (-60.8, -73.0))
via("EN", (-60.8, -73.0))
pista("EN", "F.Cu", 0.15, "SW1.1", (-60.8, -73.0))
# AMP_SD
pista("AMP_SD", "F.Cu", 0.25, "U7.4", (-93.75, -88.85), (-93.75, -87.3))
pista("AMP_SD", "F.Cu", 0.15, (-93.75, -87.3), (-93.75, -82.625), "U10.9")
# ---------------------------------------------------------------- sensado (clase D): VBAT_SNS, LIGHT, ENC_PT
# VBAT_SNS: pin 39 → vía bajo el módulo, In2 hacia el oeste (y -64,26), baja por x -78,0 y -80,6
# (único paso libre entre las filas del I2S y las vías de los pines 15-17) y diagonal hasta la
# vía junto a R13.2; el divisor R13/R14/C5 se encadena en F.Cu por x -70,3. LIGHT: pin 38 → vía,
# B.Cu por y -64,0 (entre J7 y la vía de EN) hasta J7.6 (THT) y de ahí por In2 a la vía junto a
# C40.1 (C40 a 180°, LIGHT al este, GND al oeste). ENC_PT: U11.2 ↔ R52.1 en F.Cu y vía a In2 por el hueco entre las
# filas de pads de J9 hasta J9.1 (THT).
pista("VBAT_SNS", "F.Cu", 0.15, "U4.39", (-65.4, -64.26))
via("VBAT_SNS", (-65.4, -64.26))
pista("LIGHT", "F.Cu", 0.15, "U4.38", (-65.4, -65.53))
via("LIGHT", (-65.4, -65.53))
via("GND", (-66.0, -64.9))
# M1 (2026-10-27): la fila corta sube de y -76,4 a -76,1 (0,4 a la vía de ENC_IO (-79,6; -75,3)) para quedar a
# 1,05 borde a borde de TUMMY (In3, ahora y -77,35).
pista("VBAT_SNS", "In2.Cu", 0.2, (-65.4, -64.26), (-78.0, -64.26), (-78.0, -76.1), (-80.6, -76.1), (-80.6, -93.7), (-70.3, -104.0))
via("VBAT_SNS", (-70.3, -104.0))
via("GND", (-69.5, -104.5))
pista("VBAT_SNS", "F.Cu", 0.15, (-70.3, -104.0), (-70.3, -104.875), "R13.2")
pista("VBAT_SNS", "F.Cu", 0.15, (-70.3, -104.875), (-70.3, -109.725), "R14.1")
pista("VBAT_SNS", "F.Cu", 0.15, (-70.3, -109.725), (-70.3, -112.875), "C5.1")
pista("LIGHT", "B.Cu", 0.2, (-65.4, -65.53), (-66.4, -65.53), (-67.93, -64.0), (-91.96, -64.0), "J7.6")
pista("LIGHT", "In2.Cu", 0.2, "J7.6", (-91.96, -70.4), (-88.31, -74.05), (-87.2, -74.05))   # codo a -70,4: deja sitio a la vía de IR_LED_A
via("LIGHT", (-87.2, -74.05))
via("GND", (-86.5, -73.4))
pista("LIGHT", "F.Cu", 0.15, (-87.2, -74.05), "C40.1")
pista("LIGHT", "F.Cu", 0.15, "R53.1", (-89.625, -73.2), (-88.075, -73.2), "C40.1")
pista("ENC_PT", "F.Cu", 0.15, "U11.2", (-53.6, -98.6), (-54.425, -99.425), "R52.1")
pista("ENC_PT", "F.Cu", 0.15, (-53.6, -98.6), (-53.6, -97.4), (-53.0, -96.8), (-52.0, -96.8))
via("ENC_PT", (-52.0, -96.8))
via("GND", (-52.0, -95.8))
pista("ENC_PT", "In2.Cu", 0.2, (-52.0, -96.8), (-46.2, -96.8), (-45.21, -95.81), (-43.07, -95.81), (-43.07, -93.27), "J9.1")
# ---------------------------------------------------------------- vías de GND del resto de desacoplos y pads
# Cada pad SMD de GND con hueco libre lleva su vía (0,9-1,3 mm); los que no tienen sitio (C29.2,
# C30.2, C32.2, C34.2, C36.2, C37.2, C38.2, C5.2, R7.2, R12.2, R25.2, R29.2, R30.2, R33.2,
# U10.2/3/12/21, Q3.2,
# los MP de J6 y los TP de B)
# se unen por el relleno de GND de su cara (anotado en NOTAS.md).
pista("GND", "F.Cu", 0.3, "C28.2", (-51.625, -95.425), (-52.0, -95.8))
stub("GND", "U8.2", (0.0, 1.26), 0.3)
stub("GND", "C33.2", (0.0, 0.95), 0.3)
stub("GND", "C11.2", (0.95, 0.0), 0.3)
pista("GND", "F.Cu", 0.3, "C31.2", (-55.225, -88.025), (-55.6, -88.4))
via("GND", (-55.6, -88.4))
pista("GND", "F.Cu", 0.3, "R55.2", (-94.775, -73.075), (-95.0, -73.3))
via("GND", (-95.0, -73.3))
stub("GND", "C39.2", (0.0, -0.95), 0.3)
stub("GND", "U11.3", (-1.0, 0.0), 0.3)
stub("GND", "R14.2", (-1.0, 0.0), 0.3)
stub("GND", "SW1.2", (1.4, 0.0), 0.3)
stub("GND", "SW2.2", (1.5, 0.0), 0.3)   # al este: deja libre la fila de 3V3 de R57/R58/R19 (y -66,0)
pista("GND", "F.Cu", 0.3, (-76.7, -121.194), (-76.7, -120.0))
via("GND", (-76.7, -120.0))
stub("GND", "C40.2", (-0.95, 0.0), 0.3)
stub("GND", "JP5.2", (0.0, 0.95), 0.3)
stub("GND", "R53.2", (0.95, 0.0), 0.3)
# ---------------------------------------------------------------- vías de VSYS del resto
stub("VSYS", "R54.1", (0.0, -1.2), 0.6)
stub("VSYS", "R6.2", (1.2, 0.0), 0.6)
pista("VSYS", "F.Cu", 0.6, "L2.1", (-53.6, -109.3))
via("VSYS", (-52.9, -109.3))
via("VSYS", (-53.6, -109.3))
# L2.1 lleva la entrada del elevador (2,2 A con la batería a 3,0 V): dos vías más bajo la esquina
# oeste del pad (I1); más al oeste cerrarían el paso del relleno de GND de F.Cu junto a R34
pista("VSYS", "F.Cu", 0.6, (-53.2, -109.3), (-53.2, -110.45))
via("VSYS", (-53.2, -110.45))
pista("VSYS", "F.Cu", 0.6, (-52.2, -110.45), (-52.2, -109.8))
via("VSYS", (-52.2, -110.45))
# ---------------------------------------------------------------- módulo: EP y GND de los pines 1/40, C9, C10
for _x in (-75.9, -74.5, -73.1):
    for _y in (-69.31, -70.71, -72.11):
        via("GND", (_x, _y))
stub("GND", "U4.1", (-1.25, 0.0), 0.3)
stub("GND", "U4.40", (1.25, 0.0), 0.3)
stub("GND", "C10.2", (-0.9, 0.0), 0.3)
stub("GND", "C9.2", (-1.2, 0.0), 0.4)
# ---------------------------------------------------------------- sensores de J8 (TILT_A/B, TONGUE) junto a U10
# Bloque RC de dos columnas (x -99,7/-98,1 y -96,2/-94,6) y cinco filas de 1,7 mm al oeste de U10, con una
# columna de vías de 0,6 entre ambas (x -97,15, una por fila). TILT_A cruza a U10.4 por el hueco de filas
# y -78,25 y baja por el hueco de 0,8 junto a U10; TILT_B por y -80,015 recto a U10.5; TONGUE por y -81,65 y
# sube a U10.6. Las tres series a J8 salen por las vías de las filas 1, 3 y 5 a B.Cu, con carriles anidados
# (x -99,5 a J8.1, -99,9 a J8.2, -100,3 a J8.4). 3V3: R45.2 a R38.2 por y -76,55 (0,4 en un hueco de 0,75:
# dos avisos de 0,175 aceptados, red de µA); R47.2 y R43.2 por las vías de las filas 2 y 4 a In2 y de ahí al
# tronco de B.Cu (x -85,5). C35.2, C36.2 y C37.2 (GND) van por el relleno.
pista("TILT_A", "F.Cu", 0.2, "R46.1", (-99.725, -78.25), (-98.075, -78.25), "C36.1")
pista("TILT_A", "F.Cu", 0.2, (-98.075, -78.25), (-96.225, -78.25), "R45.1")
pista("TILT_A", "F.Cu", 0.2, (-96.225, -78.25), (-93.85, -78.25), (-93.85, -79.075), (-93.55, -79.375), "U10.4")
pista("TILT_B", "F.Cu", 0.2, "C37.1", "R48.1", (-99.725, -80.015), (-94.575, -80.015), "U10.5")
pista("TILT_B", "F.Cu", 0.2, "R47.1", (-94.575, -80.015))
pista("TONGUE", "F.Cu", 0.2, "C35.1", "R43.1", "R44.1")
# Bloque U2: TONGUE recto de U10.6 a C35.1 por y -80,675 (entra 0,125 por encima del centro del pad); deja libre el
# hueco junto a U10.8 para la vía de EXP_P07.
pista("TONGUE", "F.Cu", 0.2, "U10.6", (-94.625, -80.675))
stub("TILT_A_PAD", "R46.2", (0.925, 0.0), 0.2)
pista("TILT_A_PAD", "B.Cu", 0.2, (-97.15, -77.4), (-99.5, -77.4), (-99.5, -70.6), "J8.1")
stub("TILT_B_PAD", "R48.2", (0.925, 0.0), 0.2)
pista("TILT_B_PAD", "B.Cu", 0.2, (-97.15, -80.8), (-99.9, -80.8), (-99.9, -73.14), "J8.2")
# Bloque F: la vía de TONGUE_PAD sube 0,65 mm en diagonal desde R44.2 (antes (-97,15; -84,2)) para dejar sitio a C41.
stub("TONGUE_PAD", "R44.2", (-0.65, 0.65), 0.2)
pista("TONGUE_PAD", "B.Cu", 0.2, (-96.875, -83.55), (-100.3, -83.55), (-100.3, -78.22), "J8.4")
pista("3V3", "F.Cu", 0.4, "R45.2", (-93.8, -77.4), (-93.8, -76.55), (-96.075, -76.55), "R38.2")
stub("3V3", "R47.2", (-0.925, 0.0), 0.4)
pista("3V3", "F.Cu", 0.4, "R43.2", (-97.15, -82.5))
via("3V3", (-97.15, -82.5))
pista("3V3", "In2.Cu", 0.4, (-97.15, -79.1), (-97.85, -79.8), (-97.85, -81.8), (-97.15, -82.5), (-97.85, -83.2), (-97.85, -84.9), (-92.0, -84.9), (-90.6, -86.3), (-85.5, -86.3))
via("3V3", (-85.5, -86.3))
# ---------------------------------------------------------------- LED del frente, encoder, BAT_G y 3V3 locales
# LED PWR/RUN/PROG: ánodo recto de cada diodo a su resistencia (la entrada final al pad absorbe el desfase
# de 0,1 mm entre huellas); los 3V3 de R57/R58/R19 por una fila de 0,4 en y -66,0 con una vía a In2 que
# baja por x -55,0 hasta la fila de 3V3 de In2 (y -79,5). LED_PWR_K sale de D4.1 por el norte de los LED (y -61,7, fuera del
# área de la antena, x > -61; el área del módulo solo prohíbe vías) y baja por x -52,9 y va por B.Cu hasta una vía junto a JP5.1. ENC_LED_A baja entre las dos columnas de J9. BAT_G de la puerta de Q1 a R12 por fuera
# del polígono de BAT. TP6 (3V3) con un tramo al tronco de B.Cu; R17.2 al 3V3 de C9/U4.2.
pista("LED_PWR_A", "F.Cu", 0.2, "D4.2", (-59.062, -64.787), "R57.2")
pista("LED_RUN_A", "F.Cu", 0.2, "D5.2", (-55.462, -64.787), "R58.2")
pista("LED_PROG_A", "F.Cu", 0.2, "D3.2", (-52.013, -64.862), "R19.2")
pista("LED_PWR_K", "F.Cu", 0.2, (-60.85, -63.0), (-60.85, -62.05), (-60.5, -61.7), (-52.9, -61.7), (-52.9, -70.05), "JP5.1")
pista("3V3", "F.Cu", 0.4, "R57.1", (-60.825, -66.0), (-53.625, -66.0), "R19.1")
pista("3V3", "F.Cu", 0.4, "R58.1", (-57.225, -66.0))
via("3V3", (-55.0, -66.0))
pista("3V3", "In2.Cu", 0.4, (-55.0, -66.0), (-55.0, -79.5))
pista("3V3", "F.Cu", 0.4, "R17.2", (-83.2, -68.95))
pista("3V3", "B.Cu", 0.4, "TP6.1", (-85.5, -110.0), (-85.5, -107.3))
pista("ENC_LED_A", "F.Cu", 0.2, "R51.2", (-43.125, -97.08), "J9.3")
pista("BAT_G", "F.Cu", 0.5, "Q1.4", (-61.6, -117.01))   # 0,5 dentro del patio de Q1 (regla cuello Q1)
pista("BAT_G", "F.Cu", 0.2, (-61.6, -117.01), (-60.49, -115.9), "R12.1")
# ---------------------------------------------------------------- señales del cargador desde U10 (P06, P07, P10, P11, P12)
# U10 quedaba encerrado en 4 capas (NOTAS, «Diagnóstico del rutado»): las cinco salen a vías bajo el cuerpo
# de U10 y viajan por In3. EN_6V, BQ_EN1 y BQ_EN2 van por el pasillo NE: este bajo U10, bajada en
# x -84,25…-83,35 (a > 1 mm de las columnas del I2S), cruce a 90° de la columna de VBAT_SNS y diagonal
# paralela a la de VBAT_SNS por su lado NE (a 1,2 mm), al sur del agujero del mecanismo y bajada por
# x -61,0/-60,55/-60,1 entre la vía de BQ_ILIM y los LED del cargador.
pista("EN_6V", "F.Cu", 0.2, "U10.15", (-88.4, -83.275))
via("EN_6V", (-88.4, -83.275))
# M1 (2026-10-27): las tres columnas bajan 0,1 más al oeste (x -84,35…-83,45: EN_6V a 1,05 borde a borde de
# I2S_DIN, In2 x -82,2) y las tres diagonales se desplazan 0,141 al este (0,1 en perpendicular): BQ_EN1 queda a
# 1,07 borde a borde de la diagonal de VBAT_SNS (antes 0,97).
pista("EN_6V", "In3.Cu", 0.2, (-88.4, -83.275), (-83.45, -83.275), (-83.45, -91.6), (-79.61, -91.6),
      (-69.11, -102.1), (-60.4, -102.1), (-60.4, -106.6), (-60.1, -106.9), (-60.1, -115.3), (-61.22, -115.3))
pista("BQ_EN1", "F.Cu", 0.2, "U10.13", (-88.4, -84.575))
via("BQ_EN1", (-88.4, -84.575))
pista("BQ_EN1", "In3.Cu", 0.2, (-88.4, -84.575), (-84.35, -84.575), (-84.35, -92.5), (-80.01, -92.5),
      (-69.51, -103.0), (-61.3, -103.0), (-61.3, -107.0), (-61.0, -107.3), (-61.0, -111.0), (-62.1, -111.0))
via("BQ_EN1", (-62.1, -111.0))
pista("BQ_EN1", "F.Cu", 0.25, "U2.6", (-62.35, -110.75), (-62.1, -111.0), "R6.1")
pista("BQ_EN2", "F.Cu", 0.2, "U10.14", (-89.2, -83.925))
via("BQ_EN2", (-89.2, -83.925))
pista("BQ_EN2", "In3.Cu", 0.2, (-89.2, -83.925), (-83.9, -83.925), (-83.9, -92.05), (-79.81, -92.05),
      (-69.31, -102.55), (-60.85, -102.55), (-60.85, -106.8), (-60.55, -107.1), (-60.55, -112.6), (-62.75, -112.6))
via("BQ_EN2", (-62.75, -112.6))
pista("BQ_EN2", "F.Cu", 0.25, "U2.5", (-62.75, -111.25), (-62.75, -112.6), "R7.1")
# CHG y PGOOD salen del lado oeste de U10 por el pasillo SO de In3: bajada bajo U10, este en y -90,05/-89,6,
# bajada por x -87,0/-86,55 y este en y -105,6/-105,15, al sur de la vía de VBAT_SNS. CHG llega a una vía en
# la salida de U2.9 (C17 cierra el norte); un tramo de B.Cu entre las vías de GND de C17 y R5 la une a otra vía
# al oeste de D1.1, de la que bajan D1.1 y el carril x -61,225 entre R5 y la columna de LED hasta R9.1.
pista("CHG", "F.Cu", 0.2, "U10.11", (-91.2, -83.925))
via("CHG", (-91.2, -83.925))
pista("CHG", "In3.Cu", 0.2, (-91.2, -83.925), (-91.2, -90.05), (-87.0, -90.05), (-87.0, -105.6),
      (-64.25, -105.6), (-64.25, -106.0))
via("CHG", (-64.25, -106.0))
pista("CHG", "F.Cu", 0.25, "U2.9", (-64.25, -106.0))
pista("CHG", "B.Cu", 0.2, (-64.25, -106.0), (-62.25, -104.0))
via("CHG", (-62.25, -104.0))
pista("CHG", "F.Cu", 0.2, (-62.25, -104.0), (-61.225, -104.0))
pista("CHG", "F.Cu", 0.2, (-61.225, -104.0), ("D1.1", 0, -0.1))
pista("CHG", "F.Cu", 0.2, (-61.225, -104.0), (-61.225, -107.8), "R9.1")
# PGOOD: U2.7 a R8.1 por debajo (y -110,25) con una vía al norte del tramo (-62,6, -109,7), donde llega In3 por
# x -62,6; D2.1 cuelga de una vía entre los cuatro pads de D1/D2, unida a la anterior por B.Cu (en In3 cruzaría
# las bajadas de BQ_EN1/BQ_EN2/EN_6V).
pista("PGOOD", "F.Cu", 0.2, "U10.10", (-90.4, -83.275))
via("PGOOD", (-90.4, -83.275))
pista("PGOOD", "In3.Cu", 0.2, (-90.4, -83.275), (-90.4, -89.6), (-86.55, -89.6), (-86.55, -105.15),
      (-62.6, -105.15), (-62.6, -109.7))
via("PGOOD", (-62.6, -109.7))
pista("PGOOD", "F.Cu", 0.25, "U2.7", (-62.6, -110.25))
pista("PGOOD", "F.Cu", 0.2, (-62.6, -110.25), (-61.275, -110.25), "R8.1")
pista("PGOOD", "F.Cu", 0.2, (-62.6, -110.25), (-62.6, -109.7))
pista("PGOOD", "B.Cu", 0.2, (-62.6, -109.7), (-62.0, -110.3), (-60.9, -110.3), (-60.9, -106.08), (-59.8, -104.98))
via("PGOOD", (-59.8, -104.98))
pista("PGOOD", "F.Cu", 0.2, (-59.8, -104.98), "D2.1")
# ---------------------------------------------------------------- barriga, espalda y cámara desde U10 (P13-P16)
# Vías bajo el cuerpo de U10 a la altura de su pin (stubs de F.Cu a 0,65 de las vías vecinas). TUMMY, BACK y
# CAM_PWDN suben por In3 al norte de U10 (x -90,8/-90,2/-89,6), van al este por y -75,95/-76,41/-76,87 entre
# las vías de 3V3 (-85,5) y GND (-83,1), bajan a 45° y cruzan bajo el módulo por y -77,45/-77,85/-78,25 (a más
# de 1 mm de la fila de VBAT_SNS en In2, cruces a 90° de las columnas del I2S); bajan por el canal x -48,95/
# -49,45/-50,1 entre la vía de 3V3 de U8 y las de GND de U9 hasta la esquina de J9.
# TUMMY: C33.1 y R39.1 por F.Cu rodeando U10 por el este (x -84,9) y bajando entre las columnas del bloque RC.
pista("TUMMY", "F.Cu", 0.2, "U10.16", (-90.8, -82.625))
via("TUMMY", (-90.8, -82.625))
# M1 (2026-10-27): las tres filas de la ruta norte suben 0,1 (y -77,35 / -77,75 / -78,15): CAM_PWDN queda a 1,05
# borde a borde de la fila de 3V3 de In2 (y -79,5) y TUMMY a 1,05 de VBAT_SNS (In2, y -76,1).
pista("TUMMY", "In3.Cu", 0.2, (-90.8, -82.625), (-90.8, -75.95), (-84.8, -75.95), (-83.4, -77.35), (-48.95, -77.35),
      (-48.95, -101.0), (-48.3, -101.65), (-48.3, -108.55), (-44.825, -108.55))
via("TUMMY", (-44.825, -108.55))
pista("TUMMY", "F.Cu", 0.2, (-44.825, -108.55), "R40.1")
pista("TUMMY", "F.Cu", 0.2, "U10.16", (-84.9, -82.625), (-84.9, -87.0), (-87.4, -87.0), (-87.4, -86.2), "C33.1")
pista("TUMMY", "F.Cu", 0.2, (-87.4, -87.0), (-87.4, -89.4), "R39.1")
# TUMMY_PAD y BACK_PAD suben a J9 por el pasillo entre sus dos columnas (x -43,07), en In3 y en B.Cu.
pista("TUMMY_PAD", "F.Cu", 0.2, "R40.2", (-43.07, -108.55))
via("TUMMY_PAD", (-43.07, -108.55))
pista("TUMMY_PAD", "In3.Cu", 0.2, (-43.07, -108.55), (-43.07, -92.0), "J9.7")
# BACK: ruta norte por el segundo carril; C34.1 y R41.1 desde una vía al oeste del bloque RC (-93,0, -86,0),
# unida a la vía de U10 por B.Cu bajo el cuerpo, y bajando por fuera de R49 (x -92,15) hasta R41.1.
pista("BACK", "F.Cu", 0.2, "U10.17", (-90.2, -81.975))
via("BACK", (-90.2, -81.975))
pista("BACK", "In3.Cu", 0.2, (-90.2, -81.975), (-90.2, -76.41), (-84.94, -76.41), (-83.6, -77.75), (-49.45, -77.75),
      (-49.45, -101.2), (-48.75, -101.9), (-48.75, -111.85), (-46.0, -111.85))
via("BACK", (-46.0, -111.85))
pista("BACK", "F.Cu", 0.2, (-46.0, -111.85), "R42.1", modo="d")
pista("BACK", "B.Cu", 0.2, (-90.2, -81.975), (-93.0, -81.975), (-93.0, -86.0))
via("BACK", (-93.0, -86.0))
pista("BACK", "F.Cu", 0.2, (-93.0, -86.0), "C34.1", modo="d")
pista("BACK", "F.Cu", 0.2, (-92.15, -86.2), (-92.15, -88.95), (-91.7, -89.4), "R41.1")
pista("BACK_PAD", "F.Cu", 0.2, "R42.2", (-42.25, -110.4), modo="d")
via("BACK_PAD", (-42.25, -110.4))
pista("BACK_PAD", "B.Cu", 0.2, (-42.25, -110.4), (-42.25, -107.0), (-43.07, -106.18), (-43.07, -97.08), "J9.9")
# CAM_PWDN: tercer carril de la ruta norte; baja por x -50,08 hasta y -111,1 y va al oeste a una vía bajo R34.1.
# La vía colgante de J6.8 (x -43,9) se une por B.Cu desde una vía del carril al sur de J6 (-50,08, -86,6).
pista("CAM_PWDN", "F.Cu", 0.2, "U10.18", (-89.6, -81.325))
via("CAM_PWDN", (-89.6, -81.325))
pista("CAM_PWDN", "In3.Cu", 0.2, (-89.6, -81.325), (-89.6, -76.85), (-85.1, -76.85), (-83.8, -78.15), (-50.08, -78.15),
      (-50.08, -111.1), (-56.925, -111.1))
via("CAM_PWDN", (-56.925, -111.1))
pista("CAM_PWDN", "F.Cu", 0.2, (-56.925, -111.1), "R34.1")
via("CAM_PWDN", (-50.08, -86.6))
pista("CAM_PWDN", "B.Cu", 0.2, (-50.08, -86.6), (-46.85, -86.6), (-43.9, -83.65))
# CAM_EN: único carril de la banda entre la vía de GND (-82,83, -80,4) y la de IPROPI_IO (y -81,35), al este
# hasta x -53,5, baja a la vía de U8.3 y sigue por x -54,0 junto al anillo del mecanismo hasta una vía al oeste
# de R33 (entre D1 y R27) y de ahí a R33.1 en F.Cu. U8.3 y U9.3 se unen por B.Cu bajo el canal de In3.
pista("CAM_EN", "F.Cu", 0.2, "U10.19", (-88.4, -80.675))
via("CAM_EN", (-88.4, -80.675))
# M1 (2026-10-27): el tramo norte baja por x -51,3 (1,0 a CAM_PWDN, In3 x -50,08; 0,25 a la vía de 3V3
# (-50,65; -87,8)) en vez de por x -53,5, que iba a 0,28 de CAM_2V8 (In2, x -53,0) y a 0,9 de la columna de 3V3
# (In2, x -54,7); vuelve a la vía de U8.3 por la fila y -87,9 (0,3 a la vía de GND (-51,6; -88,6)) y 1,1 mm de
# x -53,5. El tramo sur sigue por x -54,0: entre IPROPI (In2, x -54,7; aceptado en NOTAS) y las vías de
# x -53,4/-52,8 no hay otro carril.
pista("CAM_EN", "In3.Cu", 0.2, (-88.4, -80.675), (-86.0, -80.675), (-85.325, -81.35), (-51.3, -81.35),
      (-51.3, -87.9), (-53.5, -87.9), (-53.5, -89.012), (-53.8, -89.312), (-54.0, -89.512), (-54.0, -101.15),
      (-57.15, -104.3), (-57.8, -104.3))
via("CAM_EN", (-57.8, -104.3))
pista("CAM_EN", "F.Cu", 0.2, (-57.8, -104.3), (-57.8, -106.4), "R33.1")
pista("CAM_EN", "B.Cu", 0.2, (-53.8, -89.312), (-50.3, -89.312), (-49.7, -89.912), (-49.7, -91.6), (-48.25, -91.6))
# LED_RUN_K: vía bajo U10 y por In3 al norte entre las vías de 3V3 (-92,875) e I2C_SCL (-91,325); cruza a 90° LIGHT (x -91,96) en
# y -69,0, pasa a 45° entre las vías de I2C_SCL y EXP_INT del módulo, cruza VBAT_SNS (x -78) a 90° en y -68,0
# y sube a una vía entre D5 y R58.
# Bloque U2: LED_RUN_K pasa a U10.7 (P03) y a la vía que era de EXP_P07; sube por In3 en x -92,1 y deja la columna
# de x -91,4 a IR_PWR.
pista("LED_RUN_K", "F.Cu", 0.2, "U10.7", (-91.45, -81.325))
via("LED_RUN_K", (-91.45, -81.325))
pista("LED_RUN_K", "In3.Cu", 0.2, (-91.45, -81.325), (-92.1, -80.675), (-92.1, -72.5), (-92.7, -71.9),
      (-92.7, -69.0), (-79.4, -69.0), (-78.4, -68.0), (-57.5, -68.0), (-57.5, -65.038), (-56.4, -63.938))
via("LED_RUN_K", (-56.4, -63.938))
pista("LED_RUN_K", "F.Cu", 0.2, "D5.1", (-56.4, -63.938))
# ---------------------------------------------------------------- bloque B: HOME, encoder y 3V3 del bloque RC de U10
# 3V3 de los pull-ups R49/R41/R39: R49.2 baja a R41.2 y una fila de 0,4 por debajo del bloque (y -90,5) los une a R39.2
# y a una vía sobre el tronco de 3V3 de B.Cu (x -85,5).
pista("3V3", "F.Cu", 0.4, "R49.2", "R41.2", (-89.775, -90.5), (-85.5, -90.5))
pista("3V3", "F.Cu", 0.4, "R39.2", (-86.575, -90.5))
via("3V3", (-85.5, -90.5))
# HOME: R49.1 y C38.1 se unen por el hueco entre las filas de C34/C33 y R49/C38 (y -87,0); del hueco entre columnas
# (x -89,0) sube a una vía bajo U10 y sigue por In2 (libre bajo U10: EXP_INT al norte, I2S al sur) hasta una vía junto
# al pin 11 del módulo (x -83,05, entre las columnas de I2C y la de I2S_DIN de In2).
pista("HOME", "F.Cu", 0.2, "R49.1", (-91.425, -87.0), (-88.175, -87.0), "C38.1")
pista("HOME", "F.Cu", 0.2, (-89.0, -87.0), (-89.0, -85.35))
via("HOME", (-89.0, -85.35))
pista("HOME", "In2.Cu", 0.2, (-89.0, -85.35), (-88.0, -85.35), (-87.7, -85.05), (-87.7, -79.85), (-84.2, -79.85),
      (-83.05, -78.7), (-83.05, -76.6))
via("HOME", (-83.05, -76.6))
pista("HOME", "F.Cu", 0.2, "U4.11", (-83.05, -76.6))
# HOME hacia R50 (serie de J9.5): de la vía del pin 11 por B.Cu bajo el módulo (bolsa libre entre el tronco de 3V3 y
# IPROPI_IO) hasta una vía entre las filas MOT_IN de In2 y IPROPI_IO de B.Cu; por el interior de In3 (dentro del lazo de
# A1/A2) rodea el agujero del mecanismo por el oeste y el sur (a >= 0,6 mm del borde, entre el agujero y EN_6V) hasta una
# vía al SE; de ahí por In2 al sur y al este por y -106,2 hasta una vía al oeste de R50.1.
pista("HOME", "B.Cu", 0.2, (-83.05, -76.6), (-80.9, -76.6), (-73.6, -83.9), (-65.5, -83.9), (-65.5, -87.5), (-62.6, -87.5))
via("HOME", (-62.6, -87.5))
# M1 (2026-10-27): la fila baja de y -87,5 a -88,05 (0,5 a la vía de MOT_IN1 (-66,325; -88,95)) para quedar a
# 1,05 borde a borde de la fila de MOT_IN2 (In2, y -86,8, PWM de 20 kHz).
pista("HOME", "In3.Cu", 0.2, (-62.6, -87.5), (-63.15, -88.05), (-67.0, -88.05), (-69.0, -90.05), (-69.0, -98.05), (-65.35, -101.7),
      (-58.6, -101.7))
via("HOME", (-58.6, -101.7))
# M3 (2026-10-27): R50 0,15 al oeste y 0,05 al norte; la vía de HOME se queda en la diagonal (45°).
pista("HOME", "In2.Cu", 0.2, (-58.6, -101.7), (-56.2, -101.7), (-56.2, -106.2), (-48.3, -106.2), (-48.3, -110.8), (-46.35, -112.75))
via("HOME", (-46.35, -112.75))
pista("HOME", "F.Cu", 0.2, (-46.35, -112.75), "R50.1")
# HOME_PAD: J9.5 solo se alcanza por el canal entre las columnas de J9 (x -43,07; F.Cu lo usa ENC, In3 TUMMY_PAD y B.Cu
# BACK_PAD): R50.2 baja a una vía y sube por In2 entre las vías de TUMMY y TUMMY_PAD hasta el canal.
pista("HOME_PAD", "F.Cu", 0.2, "R50.2", (-43.825, -114.0))
via("HOME_PAD", (-43.825, -114.0))
pista("HOME_PAD", "In2.Cu", 0.2, (-43.825, -114.0), (-43.825, -107.755), (-43.07, -107.0), (-43.07, -102.16), "J9.5")
# ENC: en F.Cu sin vías. De U11.4 por debajo de la vía de GND de C39 (y -100,9, al norte de MOT_OUT2), entre J9.10 y
# J9.11 al canal de J9 (x -43,07) y por la franja entre J9 y JP4 (y -105,95) a JP4.1.
pista("ENC", "F.Cu", 0.2, "U11.4", (-49.0, -99.55), (-49.0, -100.9), (-43.07, -100.9), (-43.07, -105.95),
      (-44.45, -105.95), "JP4.1")
# ENC_IO: vía bajo el módulo al NE del pin 12 (al este de I2S_DOUT y al norte de la fila de VBAT_SNS de In2); por In3 al
# este en y -75,3 (al norte de los carriles de A2 y a > 1 mm de VBAT_SNS) hasta x -46,5, al este de la vía de V6 y por
# el único carril libre entre la columna oeste de J9 y las vías de x -46,55 (x -45,6); bajo JP4 cruza la ventana entre
# las vías de TUMMY y TUMMY_PAD y llega a una vía al este de JP4.2 (B.Cu cierra el canal con BACK_PAD).
pista("ENC_IO", "F.Cu", 0.2, "U4.12", (-80.6, -76.96), (-79.6, -75.96), (-79.6, -75.3))
via("ENC_IO", (-79.6, -75.3))
# M3: la bajada de x -43,95 pasa a -44,2 (0,225 a la vía de TUMMY): la columna de HOME_PAD de In2 se fue 0,15 al
# oeste con R50 y quedaba a 0,125 de eje a eje (1,55 mm de solape); ahora a 0,375 (antes 0,275).
pista("ENC_IO", "In3.Cu", 0.2, (-79.6, -75.3), (-46.5, -75.3), (-46.5, -80.5), (-45.2, -81.8), (-45.2, -90.2),
      (-45.6, -90.6), (-45.6, -106.3), (-44.2, -106.3), (-44.2, -109.3), (-41.9, -109.3), (-41.6, -109.0), (-41.6, -108.0))
via("ENC_IO", (-41.6, -108.0))
pista("ENC_IO", "F.Cu", 0.2, "JP4.2", (-41.6, -108.0))
# ---------------------------------------------------------------- bloque C: MOT_IN2, UART0, EXP_P07 e I2C a J11
# MOT_IN2 y MOT_IN1 (bloques C y M): los pines 1 (IPROPI a R28.1) y 4 (MOT_VREF a C23.1) de U6 encierran a los pines 2 y
# 3; las dos salen juntas por el hueco entre R28 y C23 (0,80 tras mover R28 y C23) a dos vías de la columna x -54,375 y
# van en pareja por B.Cu (0,15, PWM lógico): al este por debajo de U6, al norte entre la vía de GND (-50,95; -102,2) y los
# pads inferiores de U6, entre TP8 y TP11, al oeste, al norte por el este de las vías de ENC_PT y GND y al oeste otra vez
# hasta el borde este del agujero. Allí MOT_IN2 baja a In3 (por su recorrido anterior hasta JP2) y MOT_IN1 sigue en B.Cu
# por encima de su vía y entre IPROPI_IO y el agujero hasta una vía al sur de R29.1.
# Dentro del patio de U6, 0,25 hasta x -51,15; MOT_IN2 entra 0,05 por debajo del eje del pad para dejar 0,15 a R28.
pista("MOT_IN2", "F.Cu", 0.25, ("U6.2", 0.0, -0.05), (-51.15, -103.5))   # 0,25 dentro del patio de U6
pista("MOT_IN2", "F.Cu", 0.15, (-51.15, -103.5), (-54.275, -103.5), (-54.375, -103.4))
via("MOT_IN2", (-54.375, -103.4))
pista("MOT_IN1", "F.Cu", 0.25, "U6.3", (-51.15, -103.95))   # 0,25 dentro del patio de U6
pista("MOT_IN1", "F.Cu", 0.15, (-51.15, -103.95), (-54.175, -103.95), (-54.375, -104.15))
via("MOT_IN1", (-54.375, -104.15))
pista("MOT_IN2", "B.Cu", 0.15, (-54.375, -103.4), (-50.41, -103.4), (-50.41, -101.75), (-50.06, -101.4),
      (-50.06, -99.875), (-51.45, -99.875), (-51.45, -94.65), (-54.85, -94.65), (-54.85, -90.6), (-55.1, -90.35))
pista("MOT_IN1", "B.Cu", 0.15, (-54.375, -104.15), (-50.1, -104.15), (-50.1, -102.75), (-49.73, -102.38),
      (-49.73, -99.525), (-51.1, -99.525), (-51.1, -94.3), (-54.5, -94.3), (-54.5, -89.6), (-56.4, -89.6),
      (-57.05, -88.95), (-66.325, -88.95))
via("MOT_IN2", (-55.1, -90.35))
via("MOT_IN1", (-66.325, -88.95))
pista("MOT_IN1", "F.Cu", 0.15, (-66.325, -88.95), "R29.1")
pista("MOT_IN2", "In3.Cu", 0.2, (-55.1, -90.35), (-56.25, -89.2), (-56.25, -87.05),
      (-56.7, -86.6), (-61.05, -86.6), (-61.35, -86.3))
# EXP_P07: el pin 7 de U10 queda encerrado por TONGUE (pines 6 y 8 al oeste); vía bajo el cuerpo y por In3, al oeste hasta
# x -95,35 y al sur entre las vías del clase D y del I2S (quiebro al este de la vía de GND (-95,3; -94,7)), al oeste por
# debajo de J11 (y -107,3) y a J11.10 desde abajo (bloque U: deja el oeste de J8/J5 a la UART).
# Bloque U2: EXP_P07 pasa a U10.8 (P04) con una vía al oeste del pin, entre C35.1 y R43.1, y sigue por In3 igual.
pista("EXP_P07", "F.Cu", 0.2, "U10.8", (-93.655, -81.975), (-93.915, -81.715))
via("EXP_P07", (-93.915, -81.715))
pista("EXP_P07", "In3.Cu", 0.2, (-93.915, -81.715), (-95.35, -81.715), (-95.35, -93.1), (-94.65, -93.8),
      (-94.65, -105.86), "J11.5")
# I2C_SCL a J11.6: de R37.1 al sur a una vía al sur de EXP_INT (In2) y entre LED_RUN_K y TUMMY (In3); por In2 al oeste
# entre las vías de TILT_A_PAD y 3V3, por el hueco entre J8.4 y J8.5 y entre las columnas de J5 hasta J11.6.
# Bloque U2: el ramal de J11 ya no baja de R37.1 por la columna de x -91,4 (es de IR_PWR): sale de la vía de U10.22
# por In2 bajo U10 (y -79,1, entre la vía de SDA y HOME) y empalma con el tramo de siempre.
pista("I2C_SCL", "In2.Cu", 0.2, (-84.65, -79.1), (-91.5, -79.1), (-92.35, -78.25), (-99.5, -78.25), (-100.74, -79.49), (-104.07, -79.49),
      (-104.07, -95.7), "J11.6")
# I2C_SDA a J11.5: por In3 (en In2 cerraba el relleno de VSYS de R54): desde la vía junto a R36 al oeste por el hueco entre
# J8.2 y J8.3, a 1 mm al oeste de SCL (In2), por el oeste de J5 y J11 (x -106,8) hasta la fila entre J11.8 y J11.9 y por el
# hueco entre columnas a J11.5.
# Bloque U: el tramo al oeste hasta J8 pasa a F.Cu (deja In3 libre a la UART; en In2 aislaba el VSYS de R54) por el hueco
# entre J8.2 y J8.3 y baja a In3 por una vía junto al borde.
pista("I2C_SDA", "F.Cu", 0.2, (-95.0, -74.2), (-100.6, -74.2), (-100.9, -74.5), (-104.3, -74.5))
via("I2C_SDA", (-104.3, -74.5))
pista("I2C_SDA", "In3.Cu", 0.2, (-104.3, -74.5), (-104.3, -75.2),
      (-105.1, -76.0), (-105.1, -84.6), (-106.8, -86.3), (-106.8, -101.86), "J11.9")
# VSYS de U7 (pines 7/8 y C26): su vía (-96,25; -85,7) quedaba en una bolsa del relleno de In2 cerrada por SCL (y -78,25),
# el 3V3 de In2 (x -97,6) y el bus I2S; la une por B.Cu (0,6) a la vía del pin 2 de U7, que sí cuelga del relleno.
pista("VSYS", "B.Cu", 0.6, (-96.25, -85.7), (-92.4, -89.55), (-92.4, -89.85))
# I2C de J6: las vías colgantes de SCL y SDA junto a J6 se unen al bus del módulo. SCL por In3: al norte entre la columna
# de vías de J6 y ENC_IO, al oeste al norte de ENC_IO (por la ranura entre GND y ENC_IO de x -79,6 y entre GND e I2S_DIN
# de x -83,1) y por debajo de LIGHT hasta la vía de SCL junto a R37. SDA por B.Cu: al norte por el este de las vías de J6,
# al oeste por debajo de BOOT y EN y de las vías del EP del módulo, y al norte hasta la vía de SDA del pin 4.
pista("I2C_SCL", "In3.Cu", 0.2, (-43.9, -84.65), (-44.45, -84.1), (-44.45, -74.525), (-81.8, -74.525), (-82.69, -73.635),
      (-84.185, -73.635), (-86.25, -71.57))
# Bloque U2: SCL de J6 ya no llega a la vía de R37 por y -75,1 (paso de IR_PWR por In3): acaba en una vía al oeste del
# 3V3 de B.Cu (x -85,5) y sube por B.Cu a la fila de SCL de y -69.
via("I2C_SCL", (-86.25, -71.57))
pista("I2C_SCL", "B.Cu", 0.2, (-86.25, -71.57), (-86.25, -69.0))
pista("I2C_SDA", "B.Cu", 0.2, (-43.9, -85.65), (-43.25, -85.0), (-43.25, -74.1), (-70.0, -74.1), (-70.8, -73.3),
      (-77.3, -73.3), (-77.3, -66.8), (-80.3, -66.8))
# U0TX local: U4.37 a una vía al este del pin (al norte de LED_RUN_K de In3, para que el tramo hacia J11 salga por la banda
# norte de In3) y por B.Cu hasta una vía bajo D3.1 (LED PROG, encerrado en F.Cu por LED_PWR_K y la fila de 3V3).
pista("U0TX", "F.Cu", 0.2, "U4.37", (-62.8, -66.8))
via("U0TX", (-62.8, -66.8))
pista("U0TX", "B.Cu", 0.2, (-62.8, -66.8), (-60.9, -64.9), (-54.538, -64.9), (-53.588, -63.95))
via("U0TX", (-53.588, -63.95))
pista("U0TX", "F.Cu", 0.2, "D3.1", (-53.588, -63.95))
# UART0 a J11 (bloque U; J11 permutado: 6 U0TX, 7 U0RX, 9 SCL, 10 EXP_P07). Por In3 desde el módulo hacia el oeste en
# dos carriles bajo el keepout de la antena (TX y -62,35; RX y -63,6); TX entra en la fila entre las dos de J7 y RX baja
# entre la vía de GND (-85,3; -64,75) y la diagonal de IR_RX a la franja al sur de J7.
# Al oeste de J7 bajan en pareja (0,55) por el oeste de H1, por el este de J8 y J5, y entran en J11.6 (fila entre J5 y
# J11) y J11.7 (fila entre J11.6 y J11.7) desde arriba.
pista("U0TX", "In3.Cu", 0.2, (-62.8, -66.8), (-62.35, -66.35), (-62.35, -62.35), (-84.9, -62.35), (-86.525, -63.975),
      (-95.6, -63.975), (-100.4, -68.775), (-100.4, -87.6), (-101.55, -88.75), (-101.55, -96.97), (-105.34, -96.97),
      "J11.7")
pista("U0RX", "F.Cu", 0.2, "U4.36", (-65.67, -68.07), (-66.6, -67.14))
via("U0RX", (-66.6, -67.14))
# M1 (2026-10-27): RX sube de y -63,6 a -63,0 entre el módulo y x -81,8 (0,45 a TX) para quedar a ≥ 1 mm de
# VBAT_SNS (In2, y -64,26); vuelve a -63,6 en x -82,4 para pasar al sur de la vía de GND (-83,0; -62,99).
# Sobre EN (In2, y -63,6) queda a 0,4 borde a borde en 15 mm: aceptado en NOTAS (EN tiene 1 µF a GND).
pista("U0RX", "In3.Cu", 0.2, (-66.6, -67.14), (-66.6, -63.0), (-81.8, -63.0), (-82.4, -63.6), (-84.4, -63.6), (-84.4, -65.9), (-85.1, -66.6),
      (-97.445, -66.6), (-99.85, -69.005), (-99.85, -87.7), (-101.0, -88.85), (-101.0, -104.59), (-104.07, -104.59),
      "J11.10")
# Segunda vía en cada extremo del puente de VSYS de U7 (cambio de capa de potencia: >= 2 vías; picos de 0,9 A del clase D).
# Bloque F: la del lado de los pines pasa de x -97,0 a -96,875 para quedar a 0,1 mm del pad de VSYS de C41; en F.Cu baja
# al tramo de C41 al tronco (y -86,075) en vez de ir en paralelo a él hasta la primera vía.
via("VSYS", (-96.875, -85.7))
pista("VSYS", "F.Cu", 0.6, (-96.875, -85.7), (-96.875, -86.075))
pista("VSYS", "B.Cu", 0.6, (-96.25, -85.7), (-96.875, -85.7))
via("VSYS", (-92.4, -90.65))
pista("VSYS", "F.Cu", 0.6, (-92.4, -89.85), (-92.4, -90.65))
pista("VSYS", "B.Cu", 0.6, (-92.4, -89.85), (-92.4, -90.65))
# ---------------------------------------------------------------- bloque D: IR de J7, LEDs del cargador, 3V3 y GND
# IR_TX (U4.26 a la puerta de Q3 y a su pull-down R55): vía bajo el módulo, por In2 (relleno de VSYS) al norte hasta
# la banda de In3 al norte de LED_RUN_K, que recorre pegada a LED_RUN_K para dejar libre el norte de la banda a la UART:
# entre las vías de SDA y SCL del pin 4/5 y por debajo de la vía de GND (-85,6; -67,95) hasta una vía junto a Q3.
stub("IR_TX", "U4.26", (0.0, 1.55), 0.2)
pista("IR_TX", "In2.Cu", 0.2, ("U4.26", 0.0, 1.55), (-70.0, -75.19), (-70.0, -67.4))
via("IR_TX", (-70.0, -67.4))
pista("IR_TX", "In3.Cu", 0.2, (-70.0, -67.4), (-80.9, -67.4), (-82.075, -68.575), (-95.0, -68.575), (-95.0, -70.9))
via("IR_TX", (-95.0, -70.9))   # al oeste del 3V3 de In2 (x -93,85) y del SDA de B.Cu (x -94,3), fuera del keepout de H1
pista("IR_TX", "F.Cu", 0.2, (-95.0, -70.9), (-95.0, -71.3), (-93.35, -71.3), "Q3.1")
pista("IR_TX", "F.Cu", 0.2, (-95.0, -71.3), (-96.43, -71.3), "R55.1")
# IR_RX (U4.35 a R56.1): vía al oeste del pin, por B.Cu al norte cruzando LED_RUN_K de In3 y por In3 al oeste entre las
# vías EN y SDA de los pines 3/4 y al norte de la vía de GND de C9 hasta una vía junto a R56 (entre EN y LIGHT de In2).
# Entre J7 e IR_RX quedan dos carriles de In3 (y ≈ -66,55 / -66,95) para la UART.
stub("IR_RX", "U4.35", (-1.85, 0.0), 0.2)
pista("IR_RX", "B.Cu", 0.2, ("U4.35", -1.85, 0.0), (-67.4, -69.34), (-67.4, -66.165))
via("IR_RX", (-67.4, -66.165))
pista("IR_RX", "In3.Cu", 0.2, (-67.4, -66.165), (-83.6, -66.165), (-84.785, -67.35), (-86.6, -67.35), (-87.05, -67.8),
      (-91.28, -67.8))
via("IR_RX", (-91.28, -67.8))
pista("IR_RX", "F.Cu", 0.2, (-91.28, -67.8), "R56.1", modo="d")
# IR_RX_PAD: de R56.2 al norte entre J7.7 y J7.8 (0,32 a cada lado) y en diagonal a J7.4.
pista("IR_RX_PAD", "F.Cu", 0.2, "R56.2", (-88.15, -63.97), "J7.4", modo="d")
# IR_LED_A (J7.1 a R54.2, 0,3: pulsos de 0,1 A): R54.2 queda encerrado en F.Cu (Q3, EN, SCL) y la única vía posible es la
# del pasillo entre Q3 y R54 (-92,0; -71,54): entre LED_RUN_K (In3) y SCL (B.Cu), con LIGHT de In2 doblando 0,35 más arriba.
# Llega por In2 desde J7.1 por el hueco entre J7.5 y J7.6 (0,27 a cada lado) y entre el 3V3 de In2 y LIGHT.
pista("IR_LED_A", "In2.Cu", 0.3, "J7.1", (-93.23, -63.97), (-93.23, -70.31), (-92.0, -71.54))
via("IR_LED_A", (-92.0, -71.54))
pista("IR_LED_A", "F.Cu", 0.3, (-92.0, -71.54), "R54.2")
# IR_LED_K (Q3.3 a J7.2, 0,3): F.Cu al norte por el hueco entre J7.5 y J7.6 y en diagonal a J7.2.
pista("IR_LED_K", "F.Cu", 0.3, "Q3.3", (-92.4, -67.06), (-93.23, -66.23), (-93.23, -63.97), "J7.2")
# VSYS de R54.1: IR_LED_A ocupa en In2 el único paso del relleno de VSYS hacia la bolsa de R54 (entre J7.5 y J7.6); la vía de
# R54.1 se une al relleno principal de In2 por un puente de In3 de 0,6 (bolsa entre IR_TX y LED_RUN_K, y entre las vías
# de IR_TX y de GND de R55.2, 0,4 a cada lado) hasta una vía al oeste de R55. Solo lleva los pulsos de 0,1 A del LED IR.
pista("VSYS", "In3.Cu", 0.6, ("R54.1", 0.0, -1.2), (-93.96, -73.25), (-93.96, -72.05), (-97.4, -72.05))
via("VSYS", (-97.4, -72.05))
# 3V3 de R8.2, R9.2 (pull-ups de PGOOD/CHG), C30.1 y R34.2: en F.Cu entre ellos y una vía entre R8/R9 y C30 que sube por
# B.Cu al este de TP13 y de la vía de GND (-56,9; -105,4) hasta la vía de 3V3 (-57,9; -103,0) del tronco de B.Cu.
pista("3V3", "F.Cu", 0.4, "R9.2", "R8.2")
pista("3V3", "F.Cu", 0.4, ("R9.2", 0.0, -0.795), (-57.9, -108.6))
via("3V3", (-57.9, -108.6))
pista("3V3", "F.Cu", 0.4, (-57.9, -108.6), "C30.1", modo="d")
pista("3V3", "F.Cu", 0.4, "C30.1", "R34.2")
pista("3V3", "B.Cu", 0.4, (-57.9, -108.6), (-56.2, -108.6), (-56.2, -104.7), (-57.9, -103.0))
# GND: el trozo de relleno de F.Cu de U10.12 y C34.2 (pads sin vía propia) quedaba sin unión al plano; vía de cosido en él,
# entre PGOOD de In3 (x -90,4) y la vía de BQ_EN2.
via("GND", (-89.75, -84.6))
# LED_CHG_A (R10.2 a D1.2): D1.2 sale al norte en F.Cu a una vía entre el tronco de 3V3 de B.Cu (y -103,0) y HOME de In3
# (y -101,7), a 0,2 de cada uno; por In3 al sur entre las vías de PGOOD y CAM_EN, al este de EN_6V y al oeste de la vía
# de VSYS, por debajo de las vías de EN_6V y GND y por encima de J2, hasta una vía al oeste de R10 (al oeste del VBUS de
# B.Cu y al sur de BQ_TS de In2).
pista("LED_CHG_A", "F.Cu", 0.2, "D1.2", (-58.71, -102.79), (-59.2, -102.3))
via("LED_CHG_A", (-59.2, -102.3))
# M1 (2026-10-27): la fila oeste baja 0,1 (y -115,3) y LED_PG_A 0,05 (y -115,7; 0,2 a la vía de GND
# (-69,225; -116,3) y 0,2 a LED_CHG_A), para dejar BQ_TS (In2, ahora y -114,05) a 1,05 borde a borde.
pista("LED_CHG_A", "In3.Cu", 0.2, (-59.2, -102.3), (-59.2, -115.2),
      (-60.2, -116.2), (-65.6, -116.2), (-66.5, -115.3), (-73.1, -115.3))
via("LED_CHG_A", (-73.1, -115.3))
pista("LED_CHG_A", "F.Cu", 0.2, (-73.1, -115.3), (-72.275, -114.475), "R10.2")
# LED_PG_A (R11.2 a D2.2, bloque U): D2.2 sube a una vía entre D1.2 y D2.2 (al este de la de PGOOD, que pasa a
# x -59,8; EN_6V, BQ_EN2 y BQ_EN1 de In3 se apartan 0,3 al oeste en ese tramo); por In3 al este de LED_CHG_A, rodea
# la vía de VSYS por el este y sigue paralela a LED_CHG_A por el sur hasta una vía al oeste de R11.2.
pista("LED_PG_A", "F.Cu", 0.2, (-58.562, -104.9), "D2.2")
via("LED_PG_A", (-58.562, -104.9))
pista("LED_PG_A", "In3.Cu", 0.2, (-58.562, -104.9), (-58.562, -109.4), (-57.75, -110.212), (-57.75, -115.0),
      (-59.4, -116.65), (-65.836, -116.65), (-66.786, -115.7), (-70.6, -115.7), (-70.6, -118.175),
      (-71.75, -119.325))
via("LED_PG_A", (-71.75, -119.325))
pista("LED_PG_A", "F.Cu", 0.2, (-71.75, -119.325), "R11.2")
# ---------------------------------------------------------------- bloque U2: IR_PWR (U10.20, P17) a J7.8
# J7.3 y J7.8 permutados (IR_PWR al sur de J7). Por la vía que era de LED_RUN_K y la columna de In3 de x -91,4 (entre
# LED_RUN_K y TUMMY) al norte; al este bajo la vía de SCL de R37 (y -75,4, sobre TUMMY), por la bolsa de In3 entre las
# vías de GND, LIGHT y EN hasta una vía al sur de LED_RUN_K bajo J7.8 (-86,88; -69,75); por In2 recto al norte hasta
# J7.8, por el centro de la bolsa de VSYS para que el relleno la rodee por el sur y siga unido al resto.
pista("IR_PWR", "F.Cu", 0.2, "U10.20", (-91.4, -80.025))
via("IR_PWR", (-91.4, -80.025))
pista("IR_PWR", "In3.Cu", 0.2, (-91.4, -80.025), (-91.4, -75.4), (-89.6, -75.4), (-88.4, -74.2), (-88.4, -70.5),
      (-87.65, -69.75), (-86.88, -69.75))
via("IR_PWR", (-86.88, -69.75))
pista("IR_PWR", "In2.Cu", 0.2, (-86.88, -69.75), "J7.8")
# ---------------------------------------------------------------- bloque E: cosido de GND (In1, In4, F.Cu y B.Cu)
# Vías de 0,6/0,3 colocadas donde hay hueco en las seis capas (holgura 0,2 a cobre de otra red, 0,2 a pads de GND,
# >= 1,2 mm entre vías de GND, centro a >= 1,0 mm del borde, fuera de patios, serigrafía y áreas de reglas, y sin
# partir el relleno de VSYS de In2: solo se acepta una vía dentro del relleno si muerde un único filo).
# Desacoplos que no tenían vía de GND a <= 1 mm: C35 (TONGUE, 3,7 mm) y C5 (VBAT_SNS, 1,8 mm), con stub a 45°
# (el de C5 de 0,15, como la pista de VBAT_SNS del otro pad: entradas simétricas).
stub("GND", "C35.2", (-0.775, -0.775), 0.3)
stub("GND", "C5.2", (-1.025, 1.025), 0.15)
# Borde: paso nominal de 4 mm a lo largo del contorno (layout-pcb.md §5.4, <= 5 mm). Sin vías en el casquete
# delantero (sin planos) ni en los tramos que ocupan los pads de J8/J11/J9, la pista de I2S_WS_MIC junto al borde
# izquierdo y el USB-C.
for _xy in [(-50.85, -63.15), (-48.9, -65.05), (-46.5, -67.95), (-44.45, -70.95), (-42.65, -75.05), (-41.7, -78.4),
            (-41.0, -82.25), (-40.5, -86.15), (-40.2, -89.75), (-41.55, -106.15), (-55.75, -120.3), (-57.6, -123.75),
            (-61.05, -124.9), (-66.4, -126.1), (-66.4, -124.3), (-80.6, -124.85), (-80.35, -126.2), (-82.4, -125.85),
            (-86.2, -124.85), (-89.85, -123.55), (-91.2, -120.35), (-95.5, -118.6), (-99.0, -118.4), (-101.75, -116.15),
            (-103.45, -112.95), (-104.65, -109.25), (-106.25, -84.7), (-105.85, -82.0), (-104.5, -76.55),
            (-103.1, -76.05), (-100.35, -67.65), (-97.8, -64.8), (-96.05, -63.25)]:
    via("GND", _xy)
# Antena: la banda de y -62…-64 al sur del keepout la ocupan U0TX/U0RX (In3), EN (In2) y la tira de VSYS de In2
# (una vía la partiría); la fila va bajo el módulo en y -64,9, entre VBAT_SNS (In2, y -64,26) y el pad expuesto,
# completando las vías de GND de los pines 1 y 40 (x -83,0 y -63,0) y la de (-66,0; -64,9).
for _xy in [(-73.5, -64.9), (-71.0, -64.9), (-68.8, -64.9)]:
    via("GND", _xy)
# Rejilla interior de 8 mm donde no había ninguna vía de GND a < 4 mm (une los rellenos exteriores al plano)
for _xy in [(-87.9, -115.8), (-80.3, -108.15), (-79.9, -99.8), (-71.2, -99.1), (-87.9, -91.8), (-77.9, -91.8),
            (-71.9, -91.8)]:
    via("GND", _xy)
