Guilleloma/Furby-GPT/(commit log)

2023-11-29 actualizo a la version 1.1
2023-12-02 control de motor segun estado Dormido y Despierto, el control se realiza por tiempo de giro de motor
2023-12-20 Cambios en los tiempos de respuesta, use de Wav en lugar de MP3 y secuencias de moviemientos, optimizacion de codigo
2023-12-21 Resultos conflictos de stream closed
2024-03-15 Added example to test Motors
2026-10-23 Security: leer claves de API desde variables de entorno
    OpenAI, ElevenLabs y Picovoice se leen de OPENAI_API_KEY,
    ELEVENLABS_API_KEY y PICOVOICE_ACCESS_KEY en lugar de ficheros .txt.
    utils.py carga .env con python-dotenv si está instalado y get_env_key
    falla con un mensaje que nombra la variable que falta, sin mostrar valores.
2026-10-23 Security: añadir .env.example y .gitignore
    .env.example documenta las tres variables de claves vacías.
    .gitignore excluye .env, el audio generado, logs, __pycache__ y .venv.
2026-10-23 Docs: documentar la configuración de claves con .env
2026-10-23 Feature: añadir el contorno original de la PCB del Furby
    DXF del colaborador (capa Final, mm): 21 segmentos de contorno y 4 agujeros. Se deja en blanco $LASTSAVEDBY porque el repositorio es público; la geometría no cambia.
2026-10-23 Feature: script para suavizar el contorno de la PCB
    Sustituye cada vértice del polígono por un arco tangente que queda dentro del original, con desviación máxima configurable, y genera el DXF suavizado, el proyecto KiCad y el render de comparación.
2026-10-23 Feature: contorno suavizado y proyecto KiCad de la PCB
    Desviación máxima 0,5 mm hacia dentro. Proyecto KiCad 10 con el borde en Edge.Cuts, tres taladros M2 de 2,3 mm sin cobre y el recorte de 11,3 mm. DRC sin errores.
2026-10-23 Docs: notas de diseño del contorno de la PCB
2026-10-23 Security: sacar el prompt personal del Furby del repo
    chatbot1.txt pasa a ser un fichero local ignorado por git. Se añade
    chatbot1.example.txt con la misma personalidad y un usuario genérico,
    que main.py usa (con aviso) si no existe el fichero local.
2026-10-23 Security: dejar de versionar la grabación del micrófono
    myrecording.wav lo escribe speech_to_text.py en cada interacción con la
    voz del usuario: se ignora y sale del índice. pensando.wav y snoring.wav
    se quedan porque main.py los reproduce.
2026-10-23 Fix: leer la credencial de Google TTS de GOOGLE_APPLICATION_CREDENTIALS
    Sustituye la ruta 'YOUR PATH' hardcodeada por la variable estándar de
    Google; si falta, get_env_key para con un error claro.
2026-10-23 Fix: configurar la ruta del modelo de Porcupine con PICOVOICE_KEYWORD_PATH
    Quita la ruta absoluta de la Raspberry Pi. Sin la variable, se busca
    heymatepicovoice.ppn junto a los scripts. *.ppn se ignora porque el
    modelo va ligado a la cuenta de Picovoice.
2026-10-23 Security: leer el voice_id de ElevenLabs de ELEVENLABS_VOICE_ID
    El identificador de voz deja de estar en el código, porque puede ser
    una voz clonada de la cuenta. No hay valor por defecto: si falta y se
    usa ElevenLabs, get_env_key para con un error claro.
2026-10-23 Security: dejar de versionar test.wav
    Es una grabación de prueba que no usa el código. Se queda en disco
    y pasa a estar ignorada.
2026-10-23 Fix: devolver bytes WAV también con ElevenLabs
    text_to_speech_elevenlabs() escribía output.mp3 y devolvía la ruta,
    pero play_audio_and_move_motor() espera bytes WAV, así que con
    tts_service='elevenlabs' fallaba al reproducir. Ahora pide a la API
    output_format=pcm_22050 (PCM S16LE mono) y le pone la cabecera WAV en
    memoria con wave, sin dependencias nuevas. Las dos rutas de TTS
    devuelven lo mismo y ya no se escribe ningún fichero en disco.
    También añade timeout a la petición para que el Furby no se quede
    colgado si la API no responde.
2026-10-23 Feature: script del contorno de la PCB con la forma del suelo
    Encoge el suelo interior de la base 0,5 mm, quita las facetas por dentro,
    cambia los vértices por arcos tangentes (R 0,5 en los cóncavos) y abre la
    ranura del USB-C de montaje medio en el lóbulo trasero. Comprueba que el
    contorno nunca se acerca a la pared y escribe DXF, geometría y renders.
2026-10-23 Feature: contorno de la PCB, taladros M2 y renders sobre la base
    Holgura a la pared de 0,50 a 0,70 mm, 4 taladros M2 a 2,55 mm o más del
    borde, agujero del mecanismo (supuesto) y ranura del USB-C. Renders en
    planta y en corte por el lóbulo con el conector, la funda y el corte.
2026-10-23 Feature: generador del proyecto KiCad de la PCB con forma de suelo
    Crea la huella del USB-C HRO TYPE-C-31-M-28A, el esquema mínimo (Rd de
    5,1 k en CC1 y CC2) y la placa con borde, taladros, componentes, rutado y
    plano de GND, en las coordenadas del STL de la base.
2026-10-23 Feature: proyecto KiCad con el USB-C de alimentación colocado
    Generado con scripts/generar_kicad.py. ERC sin errores ni avisos y DRC
    sin errores, sin pads sin conectar y sin diferencias con el esquema.
2026-10-23 Docs: notas de la PCB con forma de suelo y contrato con la base
    NOTAS.md recoge cálculos, elección del USB-C, altura de los separadores y
    supuestos. interfaz-base.md fija para la base impresa los separadores, el
    corte de la pared del lóbulo y la exclusión del mecanismo.
2026-10-23 Fix: rellenar la zona GND sobre la placa guardada
    El relleno en memoria no recortaba los taladros NPTH ni el agujero del
    mecanismo, y el DRC sin --refill-zones daba 5 errores. Ahora la placa se
    guarda, se vuelve a cargar y se rellena como último paso.
2026-10-23 Fix: placa regenerada con la zona GND bien rellenada
    DRC sin --refill-zones: 0 errores, 0 sin conectar y 0 diferencias con el
    esquema.
2026-10-23 Test: comprobaciones de contorno-pcb.dxf
    Contorno cerrado y sin autointersecciones, 4 taladros M2 en su sitio a
    2,5 mm o más del borde, y mecanismo y exclusión dentro de la PCB. Con
    --suelo comprueba también la holgura de 0,5 mm contra el suelo. Sale con
    código 1 si algo falla.
2026-10-23 Fix: borde real de la PCB junto a la ranura en el corte lateral
    El render rotulaba y −128,29, que es el borde nominal en el eje del
    conector. A los lados de la ranura el borde está en y −128,10 y −128,00.
    geometria.json guarda ahora esos dos valores.
2026-10-23 Docs: cómo comprobar el contorno y el DRC sin volver a rellenar zonas
    Comandos del test del contorno (con y sin --suelo), del ERC y del DRC
    sobre la placa tal como está commiteada.
2026-10-23 Feature: muescas en el contorno alrededor de los agujeros originales del suelo
    Arco cóncavo de R 3,0 (--muesca-r, torreta supuesta de Ø5,0 + 0,5) en cada
    uno de los 4 agujeros de la capa Agujeros, con las esquinas redondeadas a
    R 0,5 (--muesca-redondeo). Se valida que no quede PCB a menos de ese radio.
2026-10-23 Test: los 4 agujeros originales del suelo quedan libres de PCB
2026-10-23 Feature: torretas supuestas del cuerpo en Cmts.User de la placa
2026-10-23 Docs: agujeros originales del suelo abiertos y muescas de R 3,0 en la PCB
2026-10-23 Docs: tornillo M2 × 4 para los separadores y descartes de M2 × 5 e insertos
2026-10-23 Feature: exclusión del mecanismo y funda del cable en geometria.json
    El script de la base lee de una sola fuente el diámetro de la exclusión
    (15,3), la funda supuesta (12,0 × 6,5) y las muescas (centros y radio).
2026-10-23 Test: geometria.json coincide con el DXF y trae exclusión, muescas y funda
2026-10-23 Docs: campos de geometria.json para el script de la base
2026-10-23 Feature: parámetros de la base del Furby modificada para la PCB del suelo
    parametros-base.json con las cotas propias de la base (separadores, pilotos
    M2 × 4, ventana del USB-C, funda, cupón y prueba del lóbulo) y las
    tolerancias de verificación. La geometría de la PCB se sigue leyendo de
    Hardware/PCB-suelo/geometria.json.
2026-10-23 Feature: medidas del STL original y operaciones de la base modificada
    comun.py mide en el STL el suelo, la pared del lóbulo y los agujeros
    originales, calcula los derivados y construye separadores, ventana con
    chaflán y pilotos con manifold3d.
2026-10-23 Feature: verificación A a I de la base modificada
    verificar_base.py comprueba cotas del original, holgura de la PCB, malla,
    volumen, zonas intactas, medidas, exclusiones, cable y apoyo, y escribe
    verificacion.json. Sale con 1 si algo falla.
2026-10-23 Feature: script que genera la base modificada y sus piezas de prueba
    modificar_base.py aplica las operaciones, verifica y solo entonces escribe
    la base, la prueba del lóbulo, el cupón de pilotos y la PCB fantasma, fuera
    del repositorio.
2026-10-23 Feature: renders de la base modificada (planta, cortes y vistas 3/4)
    render_base.py dibuja la planta y los cortes por el USB-C y por H3/H4 con
    cotas medidas, y lanza render_blender.py para las vistas 3/4 con y sin la
    PCB fantasma. Corrige la sección vertical de comun.py.
2026-10-23 Docs: notas de la base del Furby modificada
    Uso, método, operaciones, chaflán referido a la media de la cara curva,
    piezas de prueba, parametricidad, resultado de la verificación y lo que
    queda pendiente (B por el USB-C y H por el radio de la ventana).
2026-10-23 Refactor: exclusión y funda leídas de geometria.json; radio de la ventana a 0,9
    Quita mecanismo_margen_exclusion, funda_ancho y funda_alto de
    parametros-base.json: ahora salen de mecanismo.exclusion_diametro y funda
    en geometria.json. ventana_radio_sup pasa a 0,9 para que la funda quede a
    más de 0,3 de la esquina de la ventana.
2026-10-23 Fix: la comprobación H dilata la funda y el USB-C en distancia euclídea
    La dilatación caja a caja alargaba las esquinas √2 veces y daba choques que
    no existen. Ahora es una suma de Minkowski con una esfera.
2026-10-23 Feature: rebaje interior del lóbulo sobre la ventana del USB-C
    La cara interior del lóbulo es curva y las esquinas del cuerpo del USB-C
    pasaban a 0,09 de ella al bajar la PCB. Rebaje_USBC retira 0,3 de pared
    hacia fuera (rebaje_usb_fondo), siguiendo la curva, del ancho de la
    ventana y desde su techo hasta el borde superior. La comprobación B mide
    ahora el USB-C contra la base de salida (0,39) y D suma el volumen del
    rebaje.
2026-10-23 Feature: el corte por el USB-C muestra el rebaje interior y su cota
2026-10-23 Fix: contorno_suelo.py sin muescas por defecto; solo con --muescas
    En el Furby no hay tornillos en los 4 agujeros originales del suelo y la
    base modificada los tapa, así que la PCB pasa por encima. Sin muescas,
    geometria.json lleva "muescas": null, el DXF no lleva la capa Muescas y
    el script comprueba que los 4 agujeros originales quedan bajo la PCB.
2026-10-23 Fix: contorno, geometria.json y planta regenerados sin muescas
    Área de 4248 mm² y holgura a la pared de 0,500 a 0,697 mm.
2026-10-23 Fix: placa KiCad regenerada sin muescas ni torretas de referencia
    Edge.Cuts con 57 arcos y 32 rectas, sin círculos en Cmts.User.
    ERC 0/0 y DRC 0/0/0 sin volver a rellenar zonas.
2026-10-23 Test: PCB sin muescas por defecto; con --muescas, agujeros originales libres
    Sin muescas, cada agujero original queda bajo la PCB a 1,0 mm o más de su
    borde, no hay capa Muescas y geometria.json trae "muescas": null.
2026-10-23 Docs: agujeros originales del suelo tapados y PCB sin muescas
    En el Furby real no hay tornillos ni torretas en esos agujeros. La base
    los tapa y el suelo queda macizo. Se documenta el formato de
    geometria.json, con "muescas": null.
2026-10-23 Feature: muescas de geometria.json opcionales en la verificación y la planta
    Si geometria.json no trae el bloque de muescas, lo trae vacío, con
    "activas": false o sin centros ni radio, la comprobación G se salta y lo
    anota, y la planta no dibuja los círculos de las muescas.
2026-10-23 Feature: tapones a ras en los 4 agujeros originales del suelo
    Parámetros tapar_agujeros_originales (true) y tapon_margen (0,4). La
    operación Tapon_A1…A4 une a la base un cilindro por agujero, Ø del agujero
    medido + 2 × margen, entre las z exactas de su pared (las dos caras del
    suelo), así que la cara inferior y la superior quedan planas.
    La verificación lo comprueba:
    - C: género esperado = original + 1 (ventana) − tapones (4 → 1).
    - D: el volumen que añaden los tapones es justo el de los huecos.
    - E: rayos en el centro y en un anillo de cada agujero, con material de la
    cara inferior a la superior del suelo, y área de la cara inferior plana
    antes y después.
    Co-Authored-B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
2026-10-23 Feature: la planta muestra el suelo macizo y rotula los agujeros tapados
    Con los agujeros tapados se añade una sección por el suelo (z 1,0), los
    agujeros se dibujan discontinuos con el rótulo «tapado» y se anota el área
    de la cara inferior antes y después.
2026-10-23 Docs: agujeros originales tapados, muescas opcionales y verificación regenerada
    NOTAS.md recoge por qué se tapan los 4 agujeros del suelo, cómo se miden, el tapón y cómo lo comprueban C, D y E, y los resultados con la geometria.json sin muescas.
2026-10-24 Feature: renders de la arquitectura electrónica v1 (planta por bloques y diagrama)
    render_arquitectura.py comprueba la colocación sobre el contorno real de
    geometria.json (batería en bandeja elevada, ESP32-S3 Zero con la antena fuera
    de la batería, bloques fuera de mecanismo, tornillos y USB-C) y dibuja
    render/planta-arquitectura.png y render/bloques.png.
2026-10-24 Fix: cargador BQ24072 en los renders (OUT sigue a la batería y calienta menos el LDO del Zero)
2026-10-24 Docs: arquitectura electrónica v1 (fase 1) del FurbyGPT
    Propuesta para aprobar antes del esquemático: ESP32-S3 Zero, BQ24072 con
    power path y LM66100, TPS61089 a 6 V con DRV8231A, MAX98357A e ICS-43434,
    BOM preliminar con códigos LCSC y coste, presupuesto de potencia, mapa de
    pines, colocación con la batería en bandeja elevada, alturas, opciones de USB
    (el Zero no saca D+/D-) y dudas abiertas.
2026-10-24 Docs: NOTAS.md enlaza la arquitectura v1, sus renders y su script
2026-10-24 Feature: FurbyBoard v1.0 sobre ESP32-S3-WROOM-1 en los renders de arquitectura
    Antena del WROOM-1 en el borde delantero con zona sin cobre, conector FPC de
    la cámara, LDO de la cámara, buck-boost de 3,3 V, expansor, header J_EXP,
    puntos de test, botones y LED, todo comprobado sobre geometria.json; la
    batería solo tapa lo marcado como bajo la bandeja.
2026-10-24 Docs: ARQUITECTURA.md de la FurbyBoard v1.0 sobre ESP32-S3-WROOM-1-N16R8
    Comparativa breve C6/S3 SuperMini/S3 Zero/WROOM-1, mapa de pines con cámara
    DVP (preset ESP32-S3-EYE), I2S full duplex, TCA9535 en el bus SCCB, GPIO
    libres y jumpers, USB-C de 16 pines con el mismo eje, cámara y PSRAM, motor
    IN/IN a 20 kHz, LED, puntos de test, BOM, potencia y dudas. Altura de la
    batería confirmada.
2026-10-24 Docs: borrador de TEST-PLAN.md de la FurbyBoard v1.0
    Bring-up paso a paso: inspección, cortos, primer arranque con fuente
    limitada, carriles, USB y flasheo, LED, carga y power path, ADC de batería,
    elevador, motor, sensores, audio, cámara, WiFi, consumo y temperatura, con
    criterios PASS/FAIL, equipo y qué hacer si falla.
2026-10-24 Docs: NOTAS.md y ARQUITECTURA.md enlazan el plan de pruebas de la FurbyBoard
2026-10-24 Feature: batería sobre calzos de espuma y soldada a pads BAT+/BAT- en la planta
    Sin bandeja: la batería apoya en el blindaje del WROOM-1 (1,0 de espuma) y en
    tres calzos de 4,1 comprobados contra los bloques. El JST desaparece; los pads
    BAT+ (cuadrado) y BAT- (redondo) van junto al cargador, con el P-MOSFET de
    polaridad en el bloque de carga.
2026-10-24 Fix: ITRIP del motor a 1,0 A en el diagrama de bloques
2026-10-24 Docs: ARQUITECTURA.md v2 con batería a pads, polaridad inversa y altavoz de 4 ohm
    Tabla de cambios respecto a la v1; P-MOSFET SI7615ADN con la puerta a GND
    (análisis con y sin USB frente a la detección de cortocircuito del BQ24073);
    pads BAT+ cuadrado y BAT- redondo; batería sobre calzos de espuma sin bandeja;
    potencia real del MAX98357A en 4 ohm, ganancia de 6 dB y limitador; ITRIP de
    1,0 A ajustable; BOM, coste, pico simultáneo y dudas actualizados.
2026-10-24 Docs: TEST-PLAN.md con prueba de polaridad inversa y soldadura de la batería
2026-10-24 Feature: pads de los bordes de la planta compatibles con la holgura de 1,0
    Los pads izquierdos, J_EXP y los derechos entran 0,5 mm y el FPC se estrecha,
    comprobado contra el contorno regenerado con --holgura 1.0. El pin 8 de J_EXP
    pasa a GND porque P1.7 alimenta el receptor IR.
2026-10-24 Docs: modo dormido y holgura PCB-pared de 1,0 en ARQUITECTURA.md
    Fuentes de despertar, qué se apaga, consumo en reposo por bloque (≈ 80 µA) y
    autonomía por uso; resistencias de mayor valor en VBAT, LDR, inclinación y
    leva. Holgura de 1,0 verificada en copia: área 4129 mm², H3 y H4 movidos a
    (-86,7; -121,9) y (-60,3; -121,9), boca del USB-C mantenida con saliente de
    0,70 y cambios en los criterios de test_contorno.py.
2026-10-24 Docs: TEST-PLAN.md mide el bobinado del motor y prueba el modo dormido
2026-10-24 Feature: logo Furby en pixel art de 1 bit para la serigrafía de la FurbyBoard
    Matriz propia de 36 × 34 px versionada en serigrafia/ y scripts/logo_furby.py,
    que genera la huella Logo_Furby_PixelArt (polígonos en F.SilkS, píxel de
    0,40 mm, 14,4 × 13,6 mm; --cobre deja las pupilas en cobre visto) y la vista
    previa render/logo-furby.png.
2026-10-24 Feature: zona del logo en la cara inferior comprobada en la planta
    Sin pads pasantes, separadores, módulo ni bloques con vías encima, y dentro
    del borde con la holgura de 1,0; el bloque del expansor baja 0,6 mm.
2026-10-24 Docs: logo Furby en la serigrafía inferior en ARQUITECTURA.md y NOTAS.md
2026-10-24 Feature: contorno con holgura de 1,0, H3/H4 movidos y USB-C de 16 pines
    contorno_suelo.py pasa a --holgura 1.0 por defecto, mueve H3 a (-86,7; -121,9)
    y H4 a (-60,3; -121,9) y usa el HRO TYPE-C-31-M-13C (ranura 9,24 x 5,85, boca
    0,70 fuera del borde, a 0,30 de la pared como antes). test_contorno.py pide
    holgura de 1,0 y agujeros originales a >= 0,5. Regenerados el DXF,
    geometria.json y los renders; los tests pasan contra el suelo.
2026-10-24 Docs: interfaz-base.md y NOTAS.md con la holgura de 1,0, H3/H4 y el USB-C de 16 pines
2026-10-24 Feature: FurbyBoard, piezas y redes (design.py) y librería propia
    design.py describe las 157 piezas con su hoja, huella, LCSC y red de cada pin.
    gen_lib.py escribe los símbolos SI7615ADN y TPS63802, copias corregidas de
    DRV8231ADSG y MAX98357A, y las huellas del USB-C HRO TYPE-C-31-M-13C, el FPC
    AFC01, la bobina FHD4020S, el VSON-10 del TPS63802, los pads de cables y de
    batería, el taladro M2 y el logo.
2026-10-24 Feature: esquemático jerárquico de la FurbyBoard (8 hojas), ERC 0/0
    gen_sch.py genera la raíz y una hoja por bloque (USB, alimentación, MCU,
    motor, audio, cámara, sensores, LED y TP) con etiquetas locales o globales
    según la red; gen_pro.py escribe el proyecto con las reglas de JLCPCB y las
    clases de red Potencia, Motor y USB.
2026-10-24 Fix: orejetas en el borde para las patas delanteras del USB-C
    Las patas delanteras de la carcasa del HRO M-13C empiezan 0,20 dentro del
    borde de la PCB, pero con el fondo curvo del lóbulo el borde con holgura de
    1,0 pasaba por encima de sus pads. El borde sigue recto a la cota del eje
    2,1 mm a cada lado de la ranura; ahí la pared queda a 0,47.
2026-10-24 Refactor: pads de cable agrupados por zona y etiquetas globales
    - Motor en J9 con leva, encoder y sensores; altavoz en J8 con inclinación y
    lengua; luz en J7 con el IR. Desaparecen J4 y J10: cada grupo sale por el
    borde más cercano a su destino.
    - Micro en 2x03 en vez de 1x06 para que quepa junto al borde derecho.
    - Todas las etiquetas del esquemático son globales, así el nombre de red
    coincide con el del PCB (paridad sin prefijos de hoja).
    - ERC 0 errores, 0 avisos.
2026-10-24 Feature: colocación de la FurbyBoard en 4 capas, DRC sin errores salvo el rutado
    - gen_pcb.py: contorno de geometria.json, colocación de layout.py con la
    ruta jerárquica de cada símbolo (paridad esquemático-PCB), taladros, logo
    en la cara inferior, planos de GND y áreas sin cobre bajo la antena y sin
    vías bajo el logo. Origen auxiliar en el (0,0) del STL.
    - Quita las vías de 0,2 mm que traen dentro de los pads las huellas del
    WROOM-1 y del TPS61089 (vía en pad sin rellenar, taladro fuera de JLCPCB).
    - FurbyBoard.kicad_dru: única excepción de margen a borde, los pads de J1
    junto a la ranura (layout del fabricante, 0,15).
    - comprobar_colocacion.py: TP, puentes, LED y boton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
2026-10-24 Feature: par USB trazado, planos GND/VSYS y serigrafía de la FurbyBoard
    - Par USB de J1 al ESD y al módulo, acoplado 0,28/0,15 por F.Cu sobre el
    plano de GND, sin vías (rutas_fijas.py, bloqueado para el autorrutado).
    Canal libre en x -83 bajo la batería.
    - In1 plano de GND e In2 plano de VSYS; potencia por pista a 0,4 (cabe en
    los pads de 0,5 de paso) y 3V3 a 0,3. exportar_dsn.py deja el DSN para
    Freerouting con las clases de red.
    - Rótulos de serigrafía colocados solos (serigrafia.py): TP, LED, botones,
    puentes y polaridad de la batería arriba; función de cada pad de cable y
    GPIO del J_EXP abajo, con leyenda para J7, J9 y J5.
    - Para que quepan los rótulos: fila de LED c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
2026-10-24 Feature: BOM y CPL de JLCPCB para la FurbyBoard con giros comprobados
    jlc_post.py agrupa la BOM por valor, huella y LCSC y corrige en el CPL el
    giro y el origen de cada pieza según su huella EasyEDA, comparada pad a pad
    con la de KiCad. Los LED van a 0 (EasyEDA numera el cátodo como pad 2).
    make_fab.sh: ERC/DRC sin rellenar zonas, Gerber de 4 capas y taladros con el
    mismo origen que el CPL, BOM, CPL, renders, STEP y PDF del esquema.
2026-10-24 Feature: recuadro «PLACA» en la serigrafía inferior para numerar cada placa
2026-10-24 Docs: TEST-PLAN, README y opciones de pedido de la FurbyBoard
    - TEST-PLAN.md con los designadores, TP y valores reales del esquema y el
    PCB, y dónde medir lo que no tiene TP. El de la fase 1 queda como histórico.
    - README.md: estado, capas y por qué son 4, estructura y cómo regenerar y
    rutar.
    - fabricacion/README.md: opciones del formulario de JLCPCB (1,6 mm, ENIG,
    JLC04161H-7628, montaje por arriba) y coste estimado.
    - ARQUITECTURA.md: resumen de lo que cambia en la fase 2.
2026-10-24 Feature: modelos 3D simplificados del USB-C, el FPC y las bobinas
    gen_modelos3d.py (FreeCAD) genera la envolvente de las tres huellas propias
    sin modelo en KiCad, con el USB-C de montaje medio metido en la ranura y el
    eje 0,02 por encima de la cara superior. El TPS63802 usa el WSON-10 de 2 x 3
    de KiCad. Hacen falta para los renders y para el STEP de la carcasa.
    PCB con los planos rellenos: DRC 0 infracciones y paridad con el esquema;
    quedan 341 pads por rutar.
2026-10-24 Style: ojos del logo Furby como la referencia, sin cejas de enfado
    Los ojos pasan a ser dos gafas redondas (aro, hueco y pupila con brillo) y
    desaparecen las diagonales que bajaban hacia el centro. Emblema pequeño en
    la frente, como en la referencia. El resto del dibujo no cambia.
2026-10-24 Refactor: GPIO reasignados para acortar rutas e In2 como capa de señal
    - Cámara en los pines del lado del FPC (fila inferior derecha y columna
    derecha del módulo), en el orden del conector para que no se crucen.
    - I2S, leva, INT del expansor y encoder en la columna izquierda, hacia el
    amplificador y los sensores. MOT_IN1 pasa a GPIO9, junto a IN2 e IPROPI.
    - Sin tocar strapping (IO0, IO3, IO45, IO46) ni el USB (IO19/IO20).
    - In2 deja de ser plano: capa de señal con relleno de VSYS en lo libre.
    In1 sigue como GND continuo.
    - Rótulos de JP1 (IO9) y JP4 (IO8) actualizados.
    ERC 0/0. PCB sin rutar.
2026-10-24 Feature: rutador por rejilla propio para la FurbyBoard (en pruebas)
    extraer.py saca pads, pistas fijas, áreas prohibidas y contorno; rutar.py
    ruta en rejilla de 0,05 mm sobre F.Cu, In2 y B.Cu con A* en C (astar.c,
    compilado al vuelo) y márgenes que cubren el error de la rejilla, de modo
    que lo que sale pasa el DRC; aplicar.py lo añade al PCB. Orden por bloques:
    control de los convertidores, potencia, GND (vía al plano por pad), USB,
    I2S, cámara y resto.
    Estado: el cobre que genera no da infracciones, pero el rutado voraz deja
    redes sin terminar (18-33 según el orden).
2026-10-24 Style: expresión neutra del logo Furby, como la referencia
    - Ojos grandes y redondos de tinta, con la pupila centrada sin tinta y su
    brillo.
    - Fuera la línea interior de las orejas, que caía en diagonal hacia el centro
    y hacía de ceja fruncida.
    - Pico cerrado.
    Mismo tamaño (14,4 × 13,6 mm) y misma posición.
2026-10-24 Feature: post-proceso del rutador, tramos rectos y a 45° sin escaleras
    Cada tramo de una capa se simplifica a la mínima cantidad de rectas
    octilineales (0°, 45° y 90°) que caben en las celdas libres, comprobando el
    margen en cada atajo (también las dos celdas rectas de cada paso en
    diagonal). Se parte por ancho para que lo estrecho de la salida de los pads
    finos no se extienda. Entradas a pad por su centro. El árbol de cada red solo
    crece con el cobre ya pintado, no con las celdas del camino original, para no
    dejar pistas colgando. Margen de rejilla a 0,09 mm, vía más cara y sin pistas
    en F.Cu bajo el cuerpo del módulo.
    Con todo rutado de una vuelta: de 5 140 a ≈ 2 050 tramos y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
2026-10-24 Refactor: elevador de 6 V junto al DRV y al cargador, pasillo libre para la cámara
    El bus DVP iba del módulo al FPC cruzando el bloque del TPS61089. El
    elevador (U5, L2, C12-C19, R20-R24) pasa a la zona de abajo a la derecha,
    entre el cargador (VSYS) y el puente H (V6), con el lazo de entrada y el de
    salida cortos. El cargador se reordena con cada pasivo junto a su pin; los
    LED de carga, junto al borde de la batería; JP1-JP3 al lóbulo izquierdo y al
    del USB-C; R31/R32 junto a J5. comprobar_colocacion.py OK.
2026-10-24 Feature: TP sobre su red junto a la fuente y levantar y rerutar en el rutador
    - Cada TP es un pad de 1,5 mm en la cara inferior sobre una vía de su red,
    a pocas décimas del pin de su fuente (sin pista propia, sin vía en pad),
    colocado antes de rutar. Rótulo en la serigrafía inferior.
    - El A* admite coste por celda: al fallar una conexión se busca el camino
    permitiendo pisar pistas ajenas, se levantan las redes que estorban, se
    ruta la que fallaba y se vuelven a rutar las levantadas si así mejora.
    - Rellenos de GND en F.Cu y B.Cu al aplicar el rutado.
2026-10-24 Fix: franja prohibida de 0,32 mm junto al borde en el DSN para Freerouting
    Freerouting usa el margen general (0,15) contra el borde y KiCad exige 0,3.
    Solo afecta al DSN; el PCB no la lleva.
2026-10-24 Refactor: colocación final antes de rutar, con los TP junto a su fuente
    - Amplificador (U7) junto a los pines del I2S del módulo y a los pads del
    altavoz (J8); deja libre la zona de abajo a la izquierda.
    - Columnas de pasivos del expansor separadas de U10 para dejar pasillo de
    vías de GND.
    - TP colocados y fijados antes de rutar: pad de 1,5 mm en la cara inferior
    sobre una vía de su red, junto al pin de su fuente; TP9 en el pin de
    I2S_DOUT del módulo. Lejos del logo y de los tornillos.
    - aplicar.py: --fijar bloquea lo aplicado; rellenos exteriores solo con
    --rellenos.
    - render/colocacion-arriba.png y colocacion-abajo.png.
    DRC 0 infracciones, paridad OK; sin rutar.
    Co-Authore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
2026-10-24 Feature: lo crítico pre-rutado y fijado antes del autorrutado
    - preparar.sh: colocación, TP, vías térmicas, pre-rutado y DSN en un paso.
    - Pre-rutado con el rutador por rejilla (con su post-proceso) y fijado:
    lazos del TPS61089, del TPS63802 y del puente H, carga, batería, VSYS,
    V6, motor, altavoz, LED IR, 3V3 y bajadas de GND al plano (prerrutado.json,
    con 0,8 mm en los nodos de conmutación y 0,5-0,6 en potencia). C18/C19 giradas
    para que VOUT y GND del TPS61089 caigan sobre su condensador; compensación
    junto a su pin.
    - vias_termicas.py: vías bajo los pads expuestos de U2, U7, U6 y U4.
    - Amplificador fuera de la zona del logo (no admite vías).
    - El DSN sale sin el rellen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
2026-10-24 Feature: rutado de Freerouting importado y limpiado, con 25 conexiones pendientes
    Una sola ejecución de Freerouting 1.9.0 (-mp 20, 10,5 min, sin red) sobre el
    DSN con lo crítico fijado. limpiar.py une los tramos colineales, quita
    repetidos y puntas colgando e informa de ángulos fuera de 0/45/90 (1, del
    par USB fijo) y agudos (10).
    Estado: 30 pads sin unir (≈ 25 conexiones), 7 pistas de In2 a menos de 0,3
    del borde (la franja del DSN solo cubría F y B) y 23 puntas colgando por
    revisar. render/rutado-pendiente.png marca lo que falta.
2026-10-24 Docs: traspaso de la FurbyBoard al pausar y scripts de apoyo sin probar
    NOTAS.md con el estado al pausar: qué está hecho y en qué commit, el
    diagnóstico del rutado (≈ 25 conexiones pendientes), las opciones A-E con la
    recomendación (A + B), qué hace cada script, qué partes del rutador propio
    hay que descartar y la explicación de las líneas que salían de la placa en el
    mapa de congestión (posición de la zona de GND, no una huella fuera).
    Se añaden render_montaje.py (render sobre la base con la batería),
    vias_extra.py y ensanchar_potencia.py, escritos pero sin probar.
2026-10-24 Feature: remate por pares pendientes del DRC con el rutador por rejilla
    rutar.py --remate une solo los pares que da el DRC de KiCad, con todo lo
    existente como obstáculo fijo y el mismo post-proceso (0/45/90, entradas
    centradas). Vías lejos de los pads que aún tienen que salir y levantar y
    rerutar por pares. rematar_prep.py limpia In2 junto al borde, agudos y
    puntas y saca la lista; rematar_levantar.py libera pads encerrados.
2026-10-24 Feature: remate R5 del rutado, de 30 a 15 pads sin unir
    Cuello de DP en J1 a 45° + vertical sin mover la vía. Sin pistas de In2
    junto al borde, sin puntas ni ángulos agudos. Cobre de U5, U2, U7 y U6
    rehecho por rejilla; TP13 movido con su vía. DRC con paridad: 15 pads sin
    unir y 2 vías de IR_RX a medio camino. Mapa en render/.
2026-10-24 Docs: traspaso tras el remate R5 para la revisión independiente
2026-10-24 Feature: esquema de la FurbyBoard al procedimiento nuevo: rúbrica L, reglas por red, pines por geometría y simulación del elevador
    - Rúbrica S/M/L (L) y tabla de raíles con anchos mínimos (params.ANCHOS_MINIMOS), que gen_pro.py vuelca al .kicad_dru como una regla por red, con cuellos dentro de los patios de los QFN y de J1.
    - Vías de 0,45/0,2 solo en la clase USB (cruce del par en el receptáculo de 16 pines); el resto sigue en 0,6/0,3.
    - pcb-toolkit.toml: clases B/C/D, anchos, grupos explícitos y zonas del puente H y de la clase D.
    - Redes a la convención: BB_SW1/2, I2S_SCK_MIC/I2S_WS_MIC.
    - Pines del módulo (I2S, HOME, EXP_INT) y puertos del TCA9535 por geometría, sin tocar stra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
2026-10-24 Feature: replanteo de la planta y colocación de la FurbyBoard (puerta C, sin rutar)
    - Partición nueva: motor y elevador en la esquina trasera derecha junto a J9, cargador en el centro trasero con los pads de batería, LDO de cámara bajo el FPC, expansor pegado a la columna izquierda del módulo, amplificador junto a J8, buck-boost en la zona trasera izquierda; J8, J5 y J_EXP en el borde izquierdo; TP en la cara inferior junto a su fuente.
    - Pasillos reservados: cámara (módulo -> J6), sur, canal de la columna izquierda y norte-sur (par USB).
    - gen_pcb.py: cara por pieza, keepout de cobre de las cabezas de tornillo, franja del flex sin piezas, logo recolocado; comprobar_colocacion.py vigi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
2026-10-24 Docs: revisión independiente de la colocación de la FurbyBoard (puerta C): NO PASA, 9 importantes
    - Herramientas vueltas a ejecutar sobre 5479572: ERC 0/0, DRC 0 con paridad 0, comprobar-flujo PASS, revisar-rutado FAIL (TP6 y TP9 a más de 5 mm), kicad-happy no instalado.
    - Importantes: TP6/TP9 lejos de su fuente, Cout del buck-boost a 2,5 mm con la bobina en medio, Cout del elevador con el GND a 2,6 mm, único hueco para la NTC a 1,5 mm del cargador, C14 de compensación a 8 mm, logo que deja sin rótulo 6 pads de J_EXP y bloquea vías, falta el «+» de BAT+ arriba y los nombres de los TP, R23 fuera del contorno, agujero del mecanismo sin medir con 8 piezas a menos de 1 mm.
    - 15 PNG leí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
2026-10-24 Feature: NTC de 10 kΩ en TS del cargador (R4) y BQ_TS como red crítica
    RT1 Murata NCP18XH103F03RB (C13564) de TS a VSS como pide el BQ2407x,
    sin red de polarización; la red BQ_TS entra en las críticas de
    pcb-toolkit.toml. ERC 0 infracciones.
2026-10-24 Style: logo a 0,28 mm/px y rótulos de TP y BAT+ en serigrafía (R6, R7)
    El logo se reduce a 10,1 × 9,5 mm para que los 10 pads de J_EXP lleven
    su GPIO y no ocupe el sitio de las vías de GND del buck-boost; nombre,
    versión y recuadro PLACA pasan a su derecha. Cada TP lleva su nombre
    en la cara inferior y el «+» de BAT+ sale en la cara superior.
2026-10-24 Feature: colocación vuelta 1 con los hallazgos R1–R9 de la revisión independiente
    TP6/TP9 a ≤ 5 mm de su fuente; TPS63802 y TPS61022 con su layout de
    referencia (Cin/Cout pegados, C18 a 0° bajo VOUT/GND, C14/R21 junto a
    COMP/FB); RT1 bajo la batería; R23 dentro del contorno; anillo libre de
    2 mm alrededor del agujero del mecanismo. Puerta C: ERC 0, DRC 0/0 con
    paridad, comprobar-flujo PASS, revisar-rutado PASS; zonas revisadas en
    PNG: U5, U3, U2, U6, U8, RT1, J1 y los renders de las dos caras.
2026-10-24 Docs: re-revisión independiente de la colocación de la FurbyBoard, vuelta 1: NO PASA por una regresión (C12 de VCC)
    - Herramientas sobre 96d64e1: ERC 0, DRC 0 con paridad 0, comprobar-flujo PASS (2 avisos), revisar-rutado PASS (TP a <= 5 mm), linter OK, patios dentro del contorno.
    - R1-R9 de la vuelta 0 resueltos y medidos uno a uno; TS con la NTC directa a VSS verificado contra SLUS810N (I_NTC 75 uA, V_HOT 0,30 V, V_COLD 2,1 V): ventana 0-51 C con la NCP18XH103F03RB.
    - Nuevo importante R16: C12 (2,2 uF de VCC del TPS61089) ha pasado de 0,62 a 3,86 mm del pin al reordenar la columna de FB/COMP; corrección: intercambiar C12 y R21.
    - Mejoras R17-R21: red de compensación a 4 mm, extremo de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
2026-10-24 Fix: C12 de VCC del elevador frente a su pin (R16) y mejoras R17, R20 y R21
    C12 pasa de 3,86 a 0,64 mm del pin VCC del TPS61089 intercambiándose
    con R21; R24/C14 con el nodo RC de 0,65 mm; R50 y R23 con más margen
    al borde; RT1 en el TEST-PLAN (V_TS, hot y cold). Ningún otro
    desacoplo cambia (medido contra 96d64e1). ERC 0, DRC 0/0 con paridad,
    comprobar-flujo PASS, revisar-rutado PASS; PNG de U5 y C14 revisados.
2026-10-24 Docs: revisión independiente breve de la colocación de la FurbyBoard, vuelta 2: PASA
    - Herramientas sobre 4e16b1c: ERC 0, DRC 0 con paridad 0, comprobar-flujo PASS, revisar-rutado PASS, linter OK, patios dentro del contorno.
    - R16 resuelto (C12 a 0,64 mm de VCC, medido); desacoplos comparados pieza a pieza con 96d64e1 con extracción propia: solo cambia el bloque del elevador, sin regresiones.
    - Lista de vigilancia para el rutado: par USB, DVP, lazos calientes, clase D (BQ_TS), relleno de VSYS en In2, canal, antena, serigrafía de J9, mecanismo y puerta D.
2026-10-24 Feature: rutado explícito de potencia y lazos (U5, U3, U2, USB-C auxiliar, tronco de 3V3)
    rutas_fijas.py nuevo (DSL por pad con codos a 45°, vías, stubs y polígonos) y gen_pcb.py
    con relleno tras recargar y SES opcional. Lazos del elevador (C18 bajo VOUT/GND, SW solo
    pad+bobina, VSYS por dos vías), buck-boost (Cin/Cout pegados, SW de 0,6, Kelvin de 3V3 por
    B.Cu), cargador (VSYS a C3/C17 y vías, VBUS a C2/C1 y B.Cu, polígono de BAT a C4/Q1, ILIM y
    TS por In2 con retorno, EP con 4 vías), VBUS_IN/CC1/CC2 del USB-C y tronco de 3V3 por B.Cu
    con ramales. Ajustes de colocación de 0,1-0,5 mm en el elevador, cargador, USB y TP para
    las entradas a pad. Puerta D: DRC 0/0 con paridad, revisar-r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
2026-10-24 Feature: rutado del puente H, el amplificador y las vías de VSYS/GND de potencia
    U6: V6 a C21/C19/C22/C20 y al pin 5, OUT2 a J9.11 por F.Cu y OUT1 a J9.12 por In2
    (pads 11/12 del motor intercambiados en el esquema; ERC 0), IPROPI a R28/TP8 y por In2 a
    JP3 fuera del anillo del mecanismo, VREF a C23/R27/R26, EP con 2 vías. U7: VSYS a C26 y
    vías, GND al EP, SPK_P/N a J8 en diagonales separadas. Vías de VSYS de L2, R54, R6, C24,
    C25 y C17; vías de GND de los pasivos de los dos bloques. Puerta D: DRC 0/0, revisar-rutado
    0 errores (48 avisos documentados), PNG de U6, U7 y B.Cu de U6 revisados.
2026-10-24 Feature: rutado del par USB y del lado USB-C de la FurbyBoard
    Par USB J1 -> U1 -> U4 en F.Cu (0,28/0,15 en el tramo largo, 0,15 en el
    campo de pads): D+ por A6 recta y B6 con quiebro, D- por B7 recta y A7
    con una vía de 0,45 por B.Cu hasta la salida del pin 3; retorno de GND a
    menos de 1 mm de cada vía. U1 (USBLC6) es de paso, así que los pines 6-1
    y 4-3 van unidos bajo el cuerpo y VBUS_IN entra al pin 5 y baja a In2
    por una vía bajo U1; A4/B9 y A9/B4 bajan a In2 con sus vías y llegan a
    F1 por la fila y -115,9 sin cruzar BQ_TS. CC1 por In2 (fila y -120,8) a
    R1 y CC2 por B.Cu (fila y -120,9) a R2. TP3 sobre la pista de D- en B y
    TP2 sobre una vía de D+ a la entrada del módulo (U4.14).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
2026-10-24 Feature: rutado del bus DVP de la cámara y del abanico de J6
    Bus DVP J6 -> U4 en F.Cu, rutado de río sin cruces: Y2-Y5 en escalera
    entre SW1 y la columna de pads a los pines 31-34; los ocho restantes
    bajan a 45° a una banda de paso 0,3 (y -81,8…-83,9) y entran en los
    pines 18-25 por orden. Los pines no DVP de J6 salen por el este bajo el
    cuerpo a una columna de vías (GND, DVDD, PWDN, SCL, SDA, GND) o por el
    oeste (2V8, RST a R35/C31); 3V3 del pin 11, de R35 y de R18 por una
    fila de In2 hasta la vía de R35 y por B.Cu a U8.1. CAM_DVDD por In2
    bordeando J9 hasta U9.5/C29 (TP11 en B); CAM_2V8 por In2 a U8.5/C28 y
    U9.1 (TP10 en B); CAM_EN con sus vías junto a U8.3 y U9.3; BOOT de pin
    27 a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
2026-10-24 Feature: rutado del I2S, el I2C, EXP_INT, EN y AMP_SD de la FurbyBoard
    Los pines 3-10 de la columna oeste del módulo bajan a vías bajo el
    cuerpo (o al oeste del pad en WS y DIN) con retorno de GND. I2S por In2
    en cuatro columnas anidadas y filas y -87,0…-88,2 hasta J5.1 (DIN),
    U7.14 (WS, vía bajo C25 desde el oeste), U7.16 (BCLK, vía al este de
    C25) y U7.1 (DOUT, TP9 en B); BCLK y WS siguen en F.Cu a R31/R32 (a
    180°) y SCK_MIC/WS_MIC en F.Cu a J5.3/J5.4 (WS_MIC bordea J5 y J11 por
    el oeste). I2C por In2 a U10.22/23 (vías al este del tronco de B.Cu)
    y por B.Cu a R36/R37 (intercambiados para que las filas aniden);
    EXP_INT por In2 (y -66,2, columna x -84,8) a U10.1 y R38.1; EN por In2
    a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
2026-10-24 Feature: rutado del sensado (VBAT_SNS, LIGHT, ENC_PT), VBUS a J11 y BAT_PAD
    VBAT_SNS: pin 39 -> vía bajo el módulo, In2 por y -64,26, x -78,0 y
    x -80,6 (único paso libre entre las filas del I2S y las vías de los
    pines 15-17) y diagonal hasta la vía junto a R13.2; divisor R13/R14/C5
    encadenado en F.Cu. LIGHT: pin 38 -> vía, B.Cu por y -64,0 hasta J7.6
    (THT) y por In2 a la vía junto a C40.1 (C40 a 180°). ENC_PT: U11.2 <->
    R52.1 en F.Cu y vía a In2 por el hueco entre las filas de pads de J9
    hasta J9.1. VBUS a J11.4 por B.Cu (diagonal larga bajo los
    convertidores). BAT_PAD de J2 a Q1.5 (0,8). Zona BAT hasta y -112,3
    (conexión sólida a los pines 2/3 de U2), C4 al este, vía de GND del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
2026-10-24 Feature: rutado de las vías de GND de desacoplos y VSYS; placa regenerada solo desde los scripts
    - rutas_fijas.py: vías de GND de C28, U8, C33, C11, C31, R55, C39, U11, R14, SW1, SW2, J1,
    C35, C40, JP5 y R53 (pads con hueco); los pads sin sitio quedan anotados para el relleno.
    - FurbyBoard.kicad_pcb regenerado con gen_pcb.py sin --ses: se descartan las pistas que
    Freerouting había importado (decisión: el rutado restante se hace a mano).
    - 3V3 a 0,4 mm también en la clase de red (params.py, .kicad_pro), como en el .kicad_dru.
    - TP11 1,5 mm al oeste (R19) para liberar la leyenda de J9; J9 rotulado M2/M1 como en el esquema.
    - pcb-toolkit.toml: `criticas` con las señales del bus DVP en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
2026-10-24 Feature: rutado de los sensores de J8 (TILT_A, TILT_B, TONGUE, sus series y el 3V3 de sus pull-ups)
    - Bloque RC junto a U10: columna izquierda 0,3 mm al oeste para que quepa una columna de vías
    de 0,6 entre columnas (x -97,15); filas reordenadas (TILT_A, TILT_B, TONGUE) y cinco piezas a 180°.
    - TILT_A por el hueco de filas y -78,25 y el pasillo junto a U10 a U10.4; TILT_B recto por y -80,015
    a U10.5; TONGUE por y -81,65 a U10.6. Series TILT_A_PAD, TILT_B_PAD y TONGUE_PAD por vías a B.Cu
    con carriles anidados hasta J8.1, J8.2 y J8.4.
    - 3V3 de R45 a R38.2 (0,4 mm por el hueco de 0,75: dos avisos de 0,175 aceptados); R47 y R43 por
    vías a In2 hasta el tronco de 3V3 de B.Cu. TP14 (GND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
2026-10-24 Feature: rutado de los LED del frente, ENC_LED_A, BAT_G y 3V3 locales (R57/R58/R19, R17, TP6)
    - LED PWR/RUN/PROG: ánodos rectos a su resistencia; LED_PWR_K por el norte de los LED (y -61,7,
    fuera del área de la antena) y x -52,9 hasta JP5.1.
    - 3V3 de R57/R58/R19 por una fila de 0,4 (y -66,0) con vía a In2 (x -55,0) hasta la fila de 3V3
    de In2; la vía de GND de SW2.2 pasa al este (1,5 mm) para dejar sitio. R17.2 al 3V3 de C9/U4.2;
    TP6 unido al tronco de B.Cu (que acababa en y -107,3).
    - ENC_LED_A entre las columnas de J9 hasta J9.3. BAT_G de la puerta de Q1 a R12 (0,5 mm dentro
    del patio de Q1 por la regla «cuello Q1»).
    Puerta D: revisar-rutado 0 errores (102 avisos; nuevos: 2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
2026-10-24 Docs: diagnóstico del rutado de la FurbyBoard (U10 aislado por el rutado crítico) y opciones de replanteo
2026-10-24 Feature: FurbyBoard a 6 capas (JLC06161H-7628) conservando el rutado: In3 señal, In4 GND, apilado en el PCB y en NOTAS
    Decisión de Guillermo (2026-10-24 23:25) tras el diagnóstico del rutado en 4 capas. Mismo prepreg
    exterior 7628 (0,2104 mm), así el par USB conserva sus ≈ 87 Ω sin tocar pistas. Keepout de la antena
    en las 6 capas, plano de GND en In4, tipos de capa desde params.LAYER_TYPES, bloque (stackup) escrito
    por gen_pcb.py, Gerber con In3/In4 en make_fab.sh. DRC: 0 infracciones salvo las 5 vías colgantes de
    redes pendientes, paridad 0, 57 sin unir (igual que antes); revisar-rutado PASS (0 errores, 102 avisos).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
2026-10-24 Feature: rutado de EN_6V, BQ_EN1 y BQ_EN2 desde U10 por In3
    Vías bajo el cuerpo de U10 y pasillo NE en In3: bajada a más de 1 mm de las
    columnas del I2S, cruce a 90° de VBAT_SNS y diagonal paralela a 1,2 mm por su
    lado NE, al sur del agujero del mecanismo y bajada entre la vía de BQ_ILIM y
    los LED del cargador. Llegada a U2 por vías en el eje de R6.1 y R7.1 (0,25 mm
    dentro del patio de U2, regla «cuello U2»).
    Puerta: revisar-rutado PASS (0 errores, 103 avisos; nuevo solo
    entrada-asimetrica de R6 por el lado de VSYS). DRC con paridad 0 y sin
    violaciones nuevas; BQ_EN1, BQ_EN2 y EN_6V sin conexiones pendientes.
    PNG revisados: In3 del pasillo NE, F.Cu bajo U10 y F.Cu de U2.
    Co-Authored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
2026-10-24 Feature: rutado de CHG y PGOOD desde U10 por In3 hasta el cargador
    Vías bajo U10 y pasillo SO de In3 (bajada bajo U10, x -87,0/-86,55 y este en
    y -105,6/-105,15, al sur de la vía de VBAT_SNS). C17 cierra el norte de U2.9:
    CHG llega a su vía y un tramo corto de B.Cu la une a otra vía al oeste de D1.1,
    de la que salen D1.1 y el carril x -61,225 hasta R9.1. PGOOD: U2.7 a R8.1 por
    debajo con vía al norte del tramo; D2.1 cuelga de una vía entre los pads de
    D1/D2 unida por B.Cu (en In3 cruzaría las bajadas de BQ_EN1/BQ_EN2/EN_6V). La
    vía de GND de U2.8 sube en diagonal a (-63,2, -108,95) para dejar sitio.
    Puerta: revisar-rutado PASS (0 errores, 104 avisos; nuevos: PGOOD a 0,175 de
    R6.1 y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
2026-10-24 Feature: rutado de TUMMY y BACK desde U10 por In3 hasta J9
    - Vías bajo el cuerpo de U10; ruta norte por In3 (y -75,95/-76,41), cruce bajo el
    módulo a más de 1 mm de VBAT_SNS y bajada por el canal x -48,95/-49,45 hasta
    R40/R42.
    - TUMMY local (C33.1, R39.1) por F.Cu rodeando U10 por el este; BACK local (C34.1,
    R41.1) desde una vía al oeste del bloque RC unida por B.Cu.
    - TUMMY_PAD y BACK_PAD a J9.7/J9.9 entre las columnas de J9 (In3 y B.Cu).
    - Revisado en PNG: U10 y bloque RC (F.Cu, In3, B.Cu) y esquina de J9 (In3, B.Cu).
    revisar-rutado PASS (0 errores); DRC sin violaciones nuevas.
2026-10-24 Feature: rutado de CAM_PWDN y CAM_EN desde U10 por In3
    - CAM_PWDN: tercer carril de la ruta norte, canal x -50,08 hasta R34.1 (vía en
    y -111,1) y puente de B.Cu desde una vía al sur de J6 hasta la vía de J6.8.
    - CAM_EN: único carril de la banda bajo IPROPI_IO (y -81,35), baja a la vía de
    U8.3 y bordea el anillo del mecanismo por x -54,0 hasta una vía entre D1 y R27
    que entra a R33.1 por F.Cu; U8.3 y U9.3 unidas por B.Cu bajo el canal.
    - Revisado en PNG: canal de la cámara y esquina de J9 (In3, B.Cu, F.Cu).
    revisar-rutado PASS (0 errores); DRC sin violaciones nuevas (avisos de
    margen 0,17-0,18 mm en vías de 3V3, I2C_SDA y GND y a D2).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
2026-10-24 Feature: rutado de LED_RUN_K desde U10 por In3 hasta el LED RUN
    - Vía bajo U10 y subida por In3 entre las vías de 3V3 e I2C_SCL al norte del
    expansor; cruces a 90° de LIGHT (y -69,0) y de VBAT_SNS (y -68,0) y paso a 45°
    entre las vías de I2C_SCL y EXP_INT del módulo; vía entre D5 y R58.
    - Revisado en PNG: In3 de U10 al LED RUN. revisar-rutado PASS (0 errores); DRC
    sin violaciones nuevas y ninguna conexión pendiente de las redes del bloque A2.
2026-10-24 Feature: rutado de HOME y del 3V3 de los pull-ups del bloque RC de U10
    HOME: R49.1 y C38.1 por el hueco entre filas del bloque RC, vía bajo U10 y In2
    hasta una vía junto al pin 11 del módulo; ramal a R50 por B.Cu bajo el módulo,
    interior de In3 rodeando el agujero del mecanismo (>= 0,6 mm del borde) e In2
    hasta una vía al oeste de R50.1. 3V3 de R39/R41/R49 por una fila de 0,4 en F.Cu
    a una vía sobre el tronco de B.Cu.
    Revisión visual (PNG): bloque RC de U10 y salida del pin 11 en F.Cu/In2; recorrido
    de HOME en B.Cu, In3 e In2 hasta R50. revisar-rutado 0 errores; DRC sin
    violaciones nuevas (2 avisos via_dangling previos), paridad 0.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
2026-10-24 Feature: rutado de HOME_PAD, ENC y ENC_IO hasta J9 y JP4
    HOME_PAD: R50.2 a una vía y por In2 entre las vías de TUMMY y TUMMY_PAD al canal
    entre columnas de J9 (x -43,07) hasta J9.5. ENC en F.Cu sin vías: de U11.4 entre
    J9.10 y J9.11 al canal y por la franja sobre JP4 a JP4.1. ENC_IO: vía bajo el
    módulo junto al pin 12, In3 al este en y -75,3 (a > 1 mm de VBAT_SNS), carril
    x -45,6 entre la columna oeste de J9 y las vías de x -46,55, ventana bajo JP4 y
    vía al este de JP4.2.
    Revisión visual (PNG): esquina de J9/JP4/R50 en F.Cu, In2 e In3; salida del pin
    12 y recorrido de ENC_IO bajo el módulo. revisar-rutado 0 errores; DRC sin
    violaciones nuevas (2 avisos via_dangling previos), parida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
2026-10-25 Feature: rutado de MOT_IN2 a U6, EXP_P07 a J11.7 e I2C_SCL a J11.6
    MOT_IN2: los pines 1 y 4 de U6 (IPROPI a R28.1, MOT_VREF a C23.1) encierran a
    los pines 2 y 3; su única salida es el hueco de 0,55 mm entre R28 y C23. U6.2
    sale con un codo a 90° fuera del patio, cruza el hueco hasta una vía entre las
    de GND de R28.2/C23.2 (la de C23.2 baja 0,1 mm), B.Cu bajo U6 y por la ranura
    TP8/TP11 al norte, junto al agujero y vía al SE de la de IPROPI; In2 hasta la
    vía de MOT_IN2. MOT_IN1 queda sin salida (hace falta mover R28 o C23).
    EXP_P07: vía bajo U10 entre LED_RUN_K y TUMMY de In3; In3 al oeste y al sur
    por el este de J8 y J5 hasta J11.7. I2C_SCL: de R37.1 a una vía al sur de
    EXP_INT; In2 a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
2026-10-25 Feature: rutado de I2C_SDA a J11.5 y puente de VSYS de U7 por B.Cu
    I2C_SDA: por In3 (en In2 dejaba sin relleno de VSYS a R54) desde la vía junto
    a R36 al oeste por el hueco J8.2/J8.3, a 1 mm al oeste de SCL de In2, por el
    oeste de J5 y J11 hasta la fila J11.8/J11.9 y entre columnas a J11.5.
    VSYS de U7: SCL (commit anterior) cierra en In2 la bolsa de la vía de los
    pines 7/8 de U7 (el relleno se elimina como isla); puente de 0,6 mm en B.Cu
    hasta la vía del pin 2, que cuelga del relleno principal.
    Revisión visual (PNG): In3 de U10 a J11, In2 alrededor de J5 y J8 (relleno),
    B.Cu bajo U7. revisar-rutado 0 errores; DRC sin violaciones nuevas, paridad 0;
    sin conectar 22 → 20 (VSYS vuelve a e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
2026-10-25 Feature: rutado de I2C_SCL e I2C_SDA de J6 hasta el bus del módulo
    Cierra las dos vías colgantes de J6. SCL por In3: al norte entre la columna de
    vías de J6 y la vía de 3V3 (0,15 a cada lado), al oeste al norte de ENC_IO,
    por la ranura entre GND y ENC_IO (x -79,6) y entre GND e I2S_DIN (x -83,1),
    por debajo de LIGHT y hasta la vía de SCL junto a R37 desde el sur. SDA por
    B.Cu: al norte por el este de las vías de J6, al oeste por debajo de BOOT y
    EN y de las vías del EP del módulo, y al norte hasta la vía de SDA del pin 4.
    Revisión visual (PNG): In3 y B.Cu de J6 al módulo y al canal oeste.
    revisar-rutado 0 errores; DRC 0 violaciones (desaparecen los via_dangling),
    paridad 0; sin c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
2026-10-25 Feature: rutado local de U0TX entre U4.37 y el LED PROG (D3.1)
    U4.37 a una vía al este del pin (al norte de LED_RUN_K de In3, para que el
    tramo hacia J11 pueda salir por la banda norte de In3) y por B.Cu hasta una
    vía bajo D3.1, que en F.Cu queda encerrado por LED_PWR_K y la fila de 3V3.
    El tramo de UART0 hasta J11.9/J11.10 queda pendiente (sin pasillo libre).
    Revisión visual (PNG): B.Cu entre el pin 37 y D3. revisar-rutado 0 errores;
    DRC 0 violaciones, paridad 0; sin conectar 18 → 17.
2026-10-25 Fix: relleno de VSYS de In2 y vías del puente de VSYS de U7
    El tramo de MOT_IN2 en In2 (y -86,6) cerraba el paso del relleno de VSYS entre
    la fila MOT de In2 y la diagonal de IPROPI y el relleno del cuadrante NE se
    eliminaba como isla (2737 → 1730 mm²). Ese tramo pasa a In3: el relleno vuelve
    a 2656 mm² (lo que falta son las pistas nuevas y la bolsa de U7).
    Puente de VSYS de U7 por B.Cu: segunda vía en cada extremo, (-97,0;-85,7) y
    (-92,4;-90,65), con pista de 0,6 en F.Cu y B.Cu (cambio de capa de potencia
    con 2 vías, picos de 0,9 A). C26 sigue a 0,7 mm de los pines 7/8 de U7.
    Revisión visual (PNG): In2 de toda la placa frente a e03e72a; extremos del
    puente. revisar-rutado 0 errores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
2026-10-25 Docs: decisiones y pendientes del bloque C en NOTAS de la FurbyBoard
    Decisiones del 2026-10-25: capas del I2C a J11 y de los enlaces de J6, puente
    de VSYS de U7 con 2 vías por extremo, tramo de MOT_IN2 por In3 para no cortar
    el relleno de VSYS de In2 y vía de GND de C23.2. Pendientes con diagnóstico:
    MOT_IN1 a U6.3 y UART0 a J11 (sin pasillo; opciones para decidir).
2026-10-25 Feature: MOT_IN1 al puente H junto con MOT_IN2 (bloque M)
    - R28 0,17 mm al norte y C23 0,30 mm al sur: hueco de 0,80 mm para las dos
    entradas; IPROPI y MOT_VREF siguen rectas desde U6.
    - Columna de 4 vías (GND, MOT_IN2, MOT_IN1, GND) a paso 0,75 en x -54,375.
    - MOT_IN1/MOT_IN2 en pareja por B.Cu (0,15) bajo U6, entre TP8 y TP11 y
    hasta el agujero; MOT_IN2 a In3 hacia JP2, MOT_IN1 entre IPROPI_IO y el
    agujero hasta R29.1. CAM_EN de In3 desplazada para despejar la vía de GND.
    Revisión: revisar-rutado PASS (0 errores), DRC 0 violaciones, paridad 0,
    16 sin conectar (17 antes; MOT_IN1 cerrada). Rellenos sin islas nuevas
    (VSYS In2 2654,8 mm² en 2 trozos; GND In1/In4 3295,2 mm² en 1). P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
2026-10-25 Feature: IR_TX, IR_RX e IR_RX_PAD del bloque IR (bloque D)
    IR_TX: vía bajo el módulo, In2 al norte, In3 por la banda norte pegada a
    LED_RUN_K y vía junto a Q3 (fuera del keepout de H1). IR_RX: B.Cu cruza
    LED_RUN_K, In3 entre las vías EN/SDA de los pines 3/4 y al norte de la vía
    GND de C9, vía junto a R56. IR_RX_PAD en F.Cu entre J7.7 y J7.8.
    Quedan dos carriles de In3 para la UART entre J7 e IR_RX.
    Revisión: DRC 0/0 de violaciones (12 sin unir, ninguno de estas redes),
    revisar-rutado PASS sin errores; mapas leídos de In3 (banda J7-módulo),
    F.Cu (J7, Q3, R55, R56), In2 (bajo el módulo: relleno VSYS sin islas
    nuevas, 2 trozos) y B.Cu. Rellenos: GND B 2770,4/7, F 2080,3/19,
    In1/In4 3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
2026-10-25 Feature: IR_LED_A e IR_LED_K a J7 (bloque D)
    IR_LED_K (0,3) en F.Cu de Q3.3 a J7.2 por el hueco entre J7.5 y J7.6.
    IR_LED_A (0,3) por In2 desde J7.1 por el mismo hueco hasta una vía en el
    pasillo entre Q3 y R54 (la única con salida a R54.2 en F.Cu); LIGHT de In2
    dobla en y -70,4 para dejarle sitio. Como IR_LED_A ocupa el único paso del
    relleno de VSYS de In2 hacia la bolsa de R54, la vía de R54.1 se une al
    relleno principal por un puente de In3 de 0,6. La vía de IR_TX junto a Q3
    sube 0,4 mm para dejar paso al puente.
    Revisión: DRC 0 violaciones (10 sin unir: IR_PWR, LEDs del cargador, 3V3,
    GND y UART), revisar-rutado PASS sin errores; mapas leídos de F.Cu (J7, Q3,
    R54-R56), In3 (puen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
2026-10-25 Test: simulación del raíl de 3V3 (TPS63802) con modelo promediado calibrado
    Modelos compartidos en sim/models/furby.lib, analiza.py (criterios y PNG) y
    ruta_r.py (resistencia de pistas). Escalón de 0,1 a 0,55 A: 3V3 mín. 3,20 V en
    el peor caso; rizado 5,5/9,8 mV pp; pico de L1 1,37 A. Todo PASS.
2026-10-25 Feature: 3V3 de R8, R9, C30 y R34 y vía de cosido de GND (bloque D)
    3V3 (0,4) en F.Cu entre R9.2, R8.2, C30.1 y R34.2 con una vía entre R8/R9 y
    C30 que sube por B.Cu al este de TP13 hasta la vía del tronco de 3V3 de
    B.Cu. Vía de GND en el trozo de relleno de F.Cu de U10.12 y C34.2, que no
    tenía unión con el plano (el aviso de zona sin unir del DRC).
    Revisión: DRC 0 violaciones, 5 sin unir (IR_PWR, LED_PG_A, LED_CHG_A y la
    UART, fuera de este encargo), revisar-rutado PASS sin errores; mapas leídos
    de F.Cu y B.Cu (D1/D2, R8/R9, C30, R34, TP13) y de F.Cu bajo U10. Rellenos:
    GND F 2070,0 en 21 trozos, todos con vía o pad (el nuevo, al sur de la fila
    de 3V3, con R7.2/R25.2/C12.2 y tres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
2026-10-25 Test: simulación del power path del BQ24073 (supplement, enchufe y desenchufe)
    Dos FAIL documentados con propuesta de firmware: pico de 2,9 A con USB en
    USB500 y BAT-FET máximo (VBAT - VSYS 308 mV > VO(SC2)) y biestabilidad al
    enchufar con >= 4,3 W en modo ILIM (U2 a 1,76 W). Desenchufe y enchufe en
    caliente PASS.
2026-10-25 Feature: LED_CHG_A de R10 a D1 por In3 (bloque D)
    D1.2 sale al norte en F.Cu a una vía entre el tronco de 3V3 de B.Cu y
    HOME de In3 (0,2 a cada uno); por In3 al sur entre las vías de PGOOD y
    CAM_EN, al este de EN_6V, por debajo de las vías de EN_6V y GND y por
    encima de J2, hasta una vía al oeste de R10 (fuera del VBUS de B.Cu y de
    BQ_TS de In2) y F.Cu a R10.2. Rodeo < 1,5.
    Revisión: DRC 0 violaciones, 4 sin unir (IR_PWR, LED_PG_A y UART);
    revisar-rutado PASS sin errores; mapas leídos de In3 (todo el recorrido)
    y F.Cu (D1 y R10). Rellenos: GND B 2759,8 en 8 trozos (todos con vía o
    pad), F 2066,7/21, In1/In4 3284,8/1, VSYS In2 2616,4/3 unidos.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
2026-10-25 Docs: decisiones y pendientes del bloque D en NOTAS de la FurbyBoard
2026-10-25 Test: simulación de la batería y Q1 (caída, polaridad inversa con y sin USB, conexión)
    Q1 a 2,9 A: 27 mV y 78 mW. Al revés sin USB, BAT a 0 V. Al revés con USB, en
    la esquina mala el BQ24073 entra en precarga (BAT 1,72 V > VBAT(SC)) y Q1
    disipa 0,32 W: PASS. Conexión de la celda: 14,6 A de pico durante µs.
2026-10-25 Test: simulación del DRV8231A con el motor y el elevador promediado
    Regulación ITRIP (pico 1,00 A en arranque, bloqueo e inversión), IPROPI frente
    a VREF, V6 >= 5,83 V, Tj del DRV 103 °C bloqueado en continuo. Se anota que la
    θJA del DSG es 66,5 °C/W (NOTAS usaba la del DDA).
2026-10-25 Test: simulación del MAX98357A sobre VSYS con el puente de B.Cu
    Clase D conmutado a 300 kHz con 1 W en 4 ohm: VDD en los pines 7/8 con 257 mV
    pp de rizado (FAIL frente a 200 mV); con 10 µF junto a los pines, 25 mV pp
    (propuesta). Tiempo muerto en todos los interruptores de comportamiento
    (rizado del TPS63802 y puente H recalculados).
2026-10-25 Feature: LED_PG_A de D2.2 a R11.2 por In3 (bloque U)
    Vía al norte de D2.2 (D1 sube 0,1 mm); la vía de PGOOD de D2.1 pasa a x -59,8 y
    EN_6V/BQ_EN2/BQ_EN1 de In3 se apartan 0,3 al oeste en ese tramo con quiebros
    escalonados; LED_CHG_A baja recta por x -59,2 y LED_PG_A corre paralela por el
    sur hasta una vía al oeste de R11.2.
    Puerta D: DRC 0 con paridad 0 (3 sin unir: IR_PWR, U0TX, U0RX), revisar-rutado
    0 errores (avisos nuevos: rodeo de los dos LED), rellenos sin trozos nuevos.
    PNG revisados: F e In3 de D1/D2/R9 y del recorrido sur hasta R10/R11.
2026-10-25 Test: simulación de los LDO de la cámara (arranque, PSRR, rizado y disipación)
    Modelo ME6211 ajustado a la PSRR de la hoja (70/62 dB). Arranque en 36 µs sin
    sobreimpulso, DVDD siempre por debajo de AVDD, 3V3 mín. 3,27 V; rizado de
    AVDD 0,16 mV pp; Tj de U9 82 °C. Todo PASS.
2026-10-25 Test: simulación del NTC en TS (ventana de carga con tolerancias)
    Nominal 0,2-51,2 °C; con las tolerancias del BQ24073 y del NTC, de -2,2-56,4 °C
    a 2,6-46,5 °C. Frente a 0-45 °C queda pendiente de la hoja de la celda.
2026-10-25 Test: simulación de las señales (I2C, LED, IR, filtros de sensores y ADC)
    I2C con Cb de las pistas reales (≈ 42 pF): 166 ns, vale para 400 kHz. LED
    verdes InGaN más tenues (D4 0,24 mA en la esquina mala; propuesta R57/R58 de
    1 kΩ). R54 justo con portadora continua. ADC de VBAT_SNS: error de muestreo
    aceptable solo a <= 1 kHz de media (regla de firmware).
2026-10-25 Test: simulación del arranque y de la caída de batería con el pico de cargas
    EN se libera 13,8 ms después de 3V3 estable; 3V3 aguanta la calibración del
    WiFi con la batería a 3,0 V. El pico de 10,2 W hunde VSYS bajo el UVLO del
    elevador con la batería < 3,36 V (0,21 ohm) o < 4,0 V (0,37 ohm); 3V3 se
    mantiene. RESULTADOS.md con resumen, propuestas y tabla de lo no simulado.
2026-10-25 Docs: resumen de las simulaciones SPICE en NOTAS.md
2026-10-25 Feature: UART0 del módulo a J11 por In3 (bloque U)
    J11 permutado (5 EXP_P07, 6 SCL, 7 U0TX, 9 SDA, 10 U0RX; alimentaciones
    sin cambios). TX y RX salen por In3 bajo el keepout de la antena, cruzan
    J7 por la fila entre sus dos hileras y por la franja al sur, bajan en
    pareja por el oeste de H1 y el este de J8/J5 y entran en J11.7 y J11.10.
    SDA cruza a J8 por F.Cu (en In3 cerraba el paso; en In2 aislaba VSYS) y
    EXP_P07 baja por In3 entre las vías del clase D y del I2S hasta J11.5.
    Puerta D: ERC 0, DRC 0 con paridad 0 (1 sin unir: IR_PWR), revisar-rutado
    0 errores, rellenos VSYS In2 en 3 trozos (2613 mm2) y GND sin trozos nuevos.
    PNG revisados: In3 de J7/H1, de J5/J11 y de la salida del módul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
2026-10-25 Docs: J_EXP permutado, decisiones del bloque U y diagnóstico de IR_PWR en NOTAS
    Rótulos de la cara inferior de J_EXP y TEST-PLAN con U0TX en el pin 7;
    NOTAS: decisiones (D1, quiebros de In3, J11, UART, SDA/EXP_P07), mapa de
    J_EXP en «Pines» y en «Pendiente» solo IR_PWR con su diagnóstico.
    DRC 0 con paridad 0 (1 sin unir: IR_PWR), revisar-rutado sin errores.
2026-10-25 Feature: IR_PWR rutado de U10 a J7 (bloque U2, 0 sin unir)
    - Puertos del TCA9535 en ciclo: P03 LED_RUN_K, P04 EXP_P07, P17 IR_PWR;
    J7.3 <-> J7.8 (IR_PWR a J7.8 «RXV», J7.3 a GND). Rótulos de J7 y J_EXP.5.
    - IR_PWR: vía que era de LED_RUN_K, columna de In3 x -91,4 entre LED_RUN_K
    y TUMMY, bolsa de In3 hasta una vía bajo J7.8 y In2 recto al pad.
    - I2C_SCL: ramal de J11 desde la vía de U10.22 por In2 bajo U10; ramal de
    J6 a una vía nueva y B.Cu a la fila de y -69; R37.1 con 0,3.
    - TONGUE recto a C35.1 y R43 0,13 mm al sur para la vía de EXP_P07.
    Puerta D: ERC 0; DRC con paridad 0 violaciones, 0 sin unir, 0 paridad
    (también con relleno sobre una copia); revisar-rutado PASS, 0 err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
2026-10-25 Docs: mapa de puertos y J7 del bloque U2 en NOTAS y TEST-PLAN
    Pines (P03 LED_RUN_K, P04 EXP_P07, P17 IR_PWR; J7.3 GND, J7.8 IR_PWR),
    decisiones del bloque U2 con la pérdida de la bolsa de VSYS de In2, IR_PWR
    fuera de «Pendiente» y pruebas de sensores, LED RUN e IR con los puertos
    nuevos.
2026-10-25 Fix: C41 de 10 µF junto a VDD de U7 y R57/R58 a 1 kΩ (arreglos de la simulación)
    - C41 (C19702, 10 µF 10 V X5R 0603) al oeste de C26, a 1,3 mm de los pines 7/8,
    del lado de los pines del puente de VSYS de B.Cu; VSYS al tronco de los pines
    (0,6 mm, y -86,075) y GND por su vía al oeste. sim: 257 mV pp en VDD con solo C26.
    - Micromovimientos: vía de TONGUE_PAD 0,7 mm al norte (diagonal desde R44.2; B.Cu por
    y -83,55) y segunda vía de VSYS del puente de x -97,0 a -96,875 (baja en F.Cu al
    tramo de C41). Ni I2S ni salidas al altavoz tocados.
    - R57 y R58 de 2,2 kΩ / 1,5 kΩ a 1 kΩ (C21190): D4/D5 son verdes InGaN (2,6–3,1 V).
    Puertas: ERC 0; DRC con paridad 0 infracciones, 0 sin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
2026-10-25 Fix: corriente simulada de D4/D5 con 1 kΩ en las descripciones de R57, R58 y JP5
    La simulación de señales con R57/R58 de 1 kΩ da 0,47–0,92 mA (no 0,4–0,75).
    Regenerados esquema y PCB: ERC 0, DRC con paridad 0 y 0 sin unir, revisar-rutado
    PASS (0 errores), rellenos iguales al commit anterior.
2026-10-25 Test: simulación del amplificador con C41 y de los LED verdes con 1 kΩ
    - max98357_vsys.cir: C41 (10 µF, ≈ 5 µF a 3,6 V) junto a los pines 7/8 con la
    conexión real del PCB (1,25 nH; peor caso 2 nH). Rizado en VDD 70 mV pp nominal y
    87 mV pp en el peor caso (puente de 5 nH), frente a 258 mV pp sin C41: PASS
    (≤ 200 mV pp). Pico por el puente de B.Cu 1,52 → 0,84 A.
    - senales_i2c_led_ir.cir: R57/R58 de 1 kΩ, D4 y D5 a 0,47–0,92 mA: PASS.
2026-10-25 Docs: resultados de la simulación con C41 y R57/R58 de 1 kΩ; rizado de VDD en TEST-PLAN
    RESULTADOS.md: amplificador PASS con C41 (70 / 87 mV pp, antes 258), LED verdes
    PASS (0,47–0,92 mA), propuestas de pieza y de la θJA marcadas como aplicadas.
    TEST-PLAN §13: medida del rizado de VDD de U7 en C41.
2026-10-25 Docs: θJA del DRV8231A (DSG), decisiones del bloque F y reglas para el firmware
    - NOTAS: θJA 66,5 °C/W (DSG, no 42,8 del DDA) en la tabla de raíles y en «Cálculos»
    (Tj ≈ 90 °C; 103 °C con el motor bloqueado continuo).
    - NOTAS «Decisiones»: C41, micromovimientos para C41 y R57/R58 de 1 kΩ, con su motivo.
    - NOTAS y README: sección «Reglas para el firmware» con la simulación de la que sale
    cada regla (USB y PGOOD, ILIM con la restricción B8, VBAT ≥ 3,7 V, celda ≤ 100 mΩ,
    ADC ≤ 1 kHz y las menores).
2026-10-25 Feature: cosido de GND entre In1, In4, F.Cu y B.Cu y vías de GND de C35 y C5
    45 vías de 0,6/0,3 en rutas_fijas.py (bloque E): 33 en el borde (paso nominal
    4 mm), 3 bajo el módulo junto al keepout de la antena (y -64,9), 7 de rejilla
    interior de 8 mm y stubs a 45° de C35.2 y C5.2 (vía a 0,23 y 0,58 mm del pad).
    Puertas: ERC 0, DRC con paridad 0 y 0 sin unir, revisar-rutado PASS (0 errores,
    152 avisos, los mismos que antes). Rellenos: GND In1/In4 3279,4 mm² en 1, GND F
    2055,0 en 21, GND B 2758,1 en 11, VSYS In2 2541,8 en 3 unidos (antipads).
    PNG revisados: In1 y B.Cu de la placa entera, C35/U10, C5/R14, fila de la
    antena (F, In2, In3), borde inferior con el USB-C y borde izquierdo (J_EX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
2026-10-25 Docs: cosido de GND del bloque E y aviso USB_DP/L1 de comprobar-flujo aceptado
    El aviso es un falso positivo del ratsnest en línea recta (U1.1 -> TP2): el
    cobre del par queda a 4,31/3,88 mm del núcleo de L1, en F.Cu sobre In1.
    Anota los huecos del borde sin sitio, por qué no bajan los trozos de F/B y la
    diferencia entre el relleno de gen_pcb.py y el de kicad-cli --refill-zones.
2026-10-25 Style: serigrafía de la FurbyBoard colocada tras el rutado y sin pisar vías
    Los rótulos se colocaban antes del rutado y muchos pisaban vías tapadas (JLCPCB
    recorta esa serigrafía). Ahora gen_pcb.py los coloca sobre la placa ya rutada:
    - Vías como obstáculo (0,15 mm), pistas de su cara evitadas cuando se puede,
    tamaño por la tinta del texto (no por la caja de KiCad, 1,7 mm de alto a 1,0).
    - 1,0 mm de letra (mínimo de JLCPCB) y 0,8 solo si no cabe; 0,5 mm entre rótulos.
    - Rótulos inequívocos: más cerca de su pieza que de las de su grupo (J2/J3,
    JP1-JP3, D3-D5, SW1/SW2) y a 1,2 mm de los pads de cable ajenos.
    - Leyendas de J5, J7 y J11 con la disposición de sus pads, filas ali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
2026-10-25 Docs: notas del esquema y descripción de D5 al día con el mapa de pines final
    Las notas de las hojas seguían con pines de antes del replanteo: JP1 libera
    GPIO9 (no GPIO48), la INT del TCA9535 va a GPIO6 (no GPIO21), JP4 libera GPIO8
    (no GPIO14) y el LED del encoder va desde V6 por 470 Ω (sin AO3400A); LED RUN en
    P03 (no P16) y J_EXP 2 × 5 con el orden del bloque U. Sin cambios de redes.
    Puertas: ERC 0, DRC con paridad 0/0 y 0 sin unir; cobre y rellenos idénticos.
2026-10-25 Docs: NOTAS de la FurbyBoard al día tras el rutado en 6 capas y la serigrafía
    - «Estado» nuevo: rutado completo a mano por bloques (0 sin unir), serigrafía,
    simulación y lo que falta antes de fabricar.
    - Rúbrica: estrategia real (todo explícito en rutas_fijas.py, sin Freerouting).
    - «Decisiones»: filas del bloque S (serigrafía tras el rutado, rótulos
    inequívocos, leyendas, recorte junto a vías, nombre y PLACA); las filas de los
    bloques C y D que estaban en «Simulación» y «Revisiones» pasan a su tabla.
    - «Pines»: mapa final pin → GPIO → red del módulo y puertos del TCA9535.
    - «Intentos» y «Revisiones»: rutado en 6 capas por bloques (A1…E), puerta D
    prop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
2026-10-25 Docs: TEST-PLAN de la FurbyBoard con los pines finales, la consola UART y las reglas del firmware
    - TP con su posición y las piezas de al lado (TP13 junto a D1/D2 y TP14 junto
    al amplificador, no al puente H ni al expansor).
    - GPIO corregidos al mapa final: motor IN1 en GPIO9, leva GPIO18, encoder GPIO8,
    INT del TCA9535 GPIO6, micro GPIO17; puertos AMP_SD P05, CAM_EN P16, CAM_PWDN
    P15. Sin Q2: el LED del encoder va desde V6 por R51.
    - Consola serie en J_EXP.7 (TX) y J_EXP.10 (RX) con adaptador de 3,3 V.
    - LED verdes con R57/R58 de 1 kΩ, leyenda de J9 aparte y rótulos de batería.
    - §18 nuevo: medida de cada regla del firmware (celda ≤ 100 mΩ, USB500 con
    motor y audio, pausa al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
2026-10-25 Docs: README de la FurbyBoard reescrito como hoja de datos
    Para quien coja la placa sin contexto: estado y puertas, resumen de
    características, diagrama de bloques, apilado de 6 capas y método de rutado (a
    mano por bloques, sin autorrutador, y por qué se pasó de 4 a 6 capas), pinout de
    J1, J2/J3, J5, J6, J7, J8, J9 y J_EXP (con la consola UART en J11.7/J11.10), mapa
    de GPIO del ESP32-S3 y de puertos del TCA9535, TP con su valor, LED, botones y
    puentes, resumen de la simulación, reglas para el firmware, limitaciones
    conocidas, cómo regenerar y estructura de la carpeta.
    Tablas de conectores, J6, TP, TCA9535 y GPIO contrastadas por script con
    scripts/design.py y con los nombres de pin de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
2026-10-25 Docs: puerta E1 propia de la FurbyBoard (fin del rutado) y PNG de las 6 capas
    Pasa con hallazgos: 0 críticos, 0 importantes abiertos, 13 mejoras.
    ERC 0; DRC con paridad 0/0/0 en la placa guardada y en la rellenada por
    kicad-cli; revisar-rutado 0 errores (152 avisos justificados por tipo);
    keepout de antena limpio en 6 capas; cobre a >= 0,30 mm del agujero del
    mecanismo; simulación con los mismos veredictos; README = design.py.
    El relleno de gen_pcb.py usa 0,5 mm a borde: paso obligatorio de relleno
    con kicad-cli antes de los Gerber, documentado en NOTAS y README.
    Zonas revisadas en PNG: placa entera en F, In1-In4, B y las dos
    serigrafías; C3, C2, R10, C16, C25, R31, C38, D3, JP1, C21.
    Co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
2026-10-25 Docs: revisión independiente E1 de la FurbyBoard (NO PASA: 3 importantes)
    Informe revisiones/2026-10-25-E-independiente.md y fila en NOTAS «Revisiones».
    Herramientas repetidas sobre copia (ERC 0, DRC 0/0/0, revisar-rutado 0 errores,
    kicad-happy, simulación con los mismos 6 FAIL), pinouts contra datasheets y
    geometría propia. Importantes: vías por cruce de potencia (VSYS, V6, MOT_OUT1,
    VBUS), VBUS_IN a 0,5 mm en In2 de 0,5 oz, y LED del encoder desde V6 encendido
    con el elevador apagado (TPS61089 sin desconexión de carga).
2026-10-25 Fix: LED del encoder desde EN_6V y no desde V6 (revisión E independiente, I3)
    El TPS61089 no desconecta la carga: con EN bajo, V6 = VSYS - 0,4 V por el
    diodo del FET alto (SLVSD38C), así que el LED del encoder (R51 desde V6)
    gastaba 2,8-5,3 mA también dormido, frente a los ~80 uA del requisito.
    - R51 de 220 ohm (C22962, básica) desde EN_6V (P12 del TCA9535, push-pull):
    luce solo con el elevador encendido. TCA9535 (SCPS201F): VOH >= 2,6 V a
    -8 mA con VCC 3 V -> 5,4 mA en el peor caso bajo, ~8 mA típico, <= 10,4 mA
    de cota (IOH recomendada 10 mA). EN_6V >= 2,6 V >> VEN_H 1,2 V.
    - Ruta: vía de EN_6V junto a U5 a (-48,4; -118,25) y B.Cu por x -48,4,
    y -108,4 y el pasillo x -45,8 d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
2026-10-25 Fix: vías de potencia por cruce de capa según el cálculo (revisión E independiente, I1)
    Las transiciones de capa de las redes de potencia tenían menos vías de las
    calculadas (⌈I / 0,7 A⌉, NOTAS «Cálculos»), sin mover piezas:
    - VSYS de OUT de U2 al plano de In2: 2 -> 5 (fila en y -103,75 al oeste de
    TP5 y una debajo). La de R6.2 que contaba la revisión no está unida a OUT
    por F.Cu.
    - VSYS a L2.1 (entrada del elevador, 2,2 A): 2 -> 4.
    - V6: 2 vías junto a C18 (la segunda donde estaba la de EN_6V) y 2 en C21.1
    (tronco de B.Cu hasta y -105,3).
    - MOT_OUT1: 2 vías (la segunda al sur) e In2 de 0,5 a 1,0 mm.
    - VBUS: 2 en F1.2 y 2 en C1; 3V3: 2 al módulo junto a C9.
    Las de MOT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
2026-10-25 Fix: VBUS_IN del lóbulo del USB por B.Cu en vez de 27 mm de In2 (revisión E independiente, I2)
    VBUS_IN iba 27 mm por In2 a 0,5 mm: en 0,5 oz interior eso son 0,44 A a
    ΔT 10 °C (IPC-2221) frente a 1,34 A en modo ILIM.
    - B.Cu (1 oz) a 0,5 mm de las vías de A4/B9 y A9/B4 de J1 a dos vías junto
    a F1.1: fila y -120,85 sobre la ranura del conector, diagonal bajo el pad
    de escudo y fila y -122,41 bajo F1. 1,45 A a ΔT 10 °C (≈ 8 °C a 1,34 A),
    16 mOhm. Más ancho no cabe entre la vía de CC2 de J1 (0,2 mm) y la muesca
    de la ranura (0,34 mm). Dos vías por extremo.
    - In2 solo conserva los 2 mm de la toma de U1.5 (TVS); el plano de VSYS
    recupera el lóbulo.
    - CC2 pasa de B.Cu a In3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
2026-10-25 Docs: respuesta del diseño a la revisión E independiente (vuelta 1) y NOTAS al día
    - Informe de la revisión: sección «Respuesta del diseño (vuelta 1)» con lo
    hecho en I1, I2 e I3, su commit y la medida que lo demuestra, las puertas
    tras el último commit y qué mirar en la revisión breve.
    - NOTAS: estado, fila de la vuelta 1 en «Revisiones», avisos aceptados
    (rodeos de V6 y VBUS_IN, entradas asimétricas) y áreas esperadas del
    relleno de kicad-cli antes de los Gerber.
    - Mejoras de texto de paso: M5/M8 (12 textos a 0,8 mm en README y NOTAS)
    y M10 (TEST-PLAN §1: prueba en seco en la base antes de soldar la
    batería; si roza, se descarta la placa).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
2026-10-25 Docs: re-revisión independiente de la FurbyBoard (vuelta 1 de E): PASA, I1–I3 cerrados
    Sección «Re-revisión (vuelta 1)» en revisiones/2026-10-25-E-independiente.md
    y fila en NOTAS «Revisiones», sobre ada99af y sin tocar el diseño:
    - Herramientas vueltas a ejecutar: ERC 0; DRC con paridad 0/0/0 en la placa
    guardada y con relleno de kicad-cli sobre una copia; revisar-rutado 0
    errores / 152 avisos; comprobar-flujo solo el falso positivo USB/L1;
    rellenos sin trozos ni islas nuevos frente a 8bef784.
    - I1: vías por cruce medidas con volcado propio (VSYS U2 5, L2.1 4, V6 2+2,
    MOT_OUT1 2 con In2 a 1,0, VBUS 2+2, VBUS_IN 2+2, 3V3 2; ≤ 0,7 A por vía).
    - I2: VBUS_IN 15,9 mm por B.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
2026-10-25 Feature: modelos 3D de U2, U5 y Q1 y rutas de modelo para U6 y U7
    gen_modelos3d.py genera los STEP del VQFN-16 RGT (BQ24073), del VQFN-HR
    RNR0011A (TPS61089) y del PowerPAK 1212-8 (SI7615ADN) con las medidas de
    los dibujos de TI y Vishay. U6 y U7 usan modelos que KiCad 10 ya trae con
    otro nombre. NOTAS.md recoge la ruta que el generador de la placa tiene
    que poner en cada huella.
2026-10-25 Fix: holgura mínima PCB-pared de la base a 0,47
    Es el mínimo del contrato en las orejetas del USB-C (interfaz-base.md §1)
    y el valor con el que se generó la base del 2026-10-24. NOTAS de la base
    recoge el cambio y el agujero del mecanismo validado.
2026-10-25 Docs: agujero del mecanismo validado por Guillermo en el contrato de la base
2026-10-25 Style: logo de @GuilleMaker en la serigrafía inferior de la FurbyBoard
    - scripts/logo_guillemaker.py vectoriza serigrafia/logo-guillemaker.png
    (umbral, contornos con contourpy, agujeros con corte de ancho cero) en
    lib/FurbyBoard.pretty/Logo_GuilleMaker.kicad_mod, 11,0 x 10,7 mm; texto
    de 1,48 mm con trazo de 0,18 mm de mediana.
    - gen_pcb.py lo pone el último, tras los rótulos, en el hueco libre más
    cercano a layout.LOGO_GUILLEMAKER: queda en (-76,0; -88,5), sobre el
    nombre de la placa. Silueta sin vías (+0,15), pads, rótulos ni courtyards.
    - Cobre, rellenos, rótulos y demás huellas idénticos a e53cb6b (comparados
    pista a pista y zona a zona); solo se añade LOGO2 (board_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
2026-10-25 Docs: serigrafía y logo de GuilleMaker en README y NOTAS de la FurbyBoard
    README: sección «Serigrafía», script y carpeta serigrafia/ en las tablas,
    paso de regeneración. NOTAS: decisión del logo (sitio, tamaño, por qué no
    junto al del Furby ni en la cara superior) y fila de planta. PNG de la cara
    inferior con el logo en render/serigrafia-logo-guillemaker.png.
2026-10-25 Feature: modelos 3D de U2, U5, U6, U7 y Q1 y relleno de zonas con las reglas del proyecto
    - gen_pcb.py pone en las huellas de U2, U5, U6, U7 y Q1 el modelo 3D que KiCad 10
    no instala (propios de gen_modelos3d.py y dos de KiCad del mismo cuerpo).
    - gen_pcb.py guarda las zonas sin rellenar; scripts/rellenar.sh las rellena con
    kicad-cli después de gen_pro.py (margen a borde 0,3 del proyecto, hallazgo E1-1)
    y pasa el DRC sin relleno.
    Cobre idéntico a 05cabf1 (1044 pistas, 334 vías, 6 zonas, huellas en la misma
    posición). DRC con paridad 0/0/0, 0 sin unir. Rellenos iguales a la re-revisión:
    In1/In4 3313,1 mm² en 1, GND F 2084,6 en 21, GND B 2773,2 en 10, VSYS In2 2616,3
    en 3, BAT 31,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
2026-10-25 Feature: ficheros de fabricación de la FurbyBoard para JLCPCB (6 capas)
    - make_fab.sh: comprueba que los rellenos están al día (copia rellenada con
    kicad-cli idéntica a la placa), taladros PTH y NPTH en ficheros separados y
    comprobación del CPL con pcb-toolkit cpl-rotaciones si está instalado.
    - jlc_post.py: una línea de BOM por huella y LCSC (SW1 y SW2 iban en dos líneas
    por tener valores distintos); docstring con la comparación de giros de E2.
    - fabricacion/: Gerber de 6 capas + taladros (zip y sueltos), BOM (51 líneas,
    124 piezas, 18 extended), CPL, ERC, DRC y esquema en PDF.
    - render/: placa montada en 3D (arriba, abajo, iso) y STEP para la carcasa.
    ERC 0/0, DRC con pa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
2026-10-25 Docs: puerta E2 y README de fabricación de la FurbyBoard (6 capas)
    - revisiones/2026-10-25-E2-fabricacion.md: PASA (2 importantes corregidos en
    fbace1e, 3 mejoras); fila en «Revisiones» de NOTAS.
    - fabricacion/README.md reescrito para 6 capas: qué subir, apilado, opciones de
    PCB y de montaje Economic, piezas a mirar en el visor, coste estimado, lista
    «Confirmar antes de pedir» y BOM con clase, stock y precio de JLCPCB del día.
    - README y NOTAS: estado, Isat de L2 confirmada, RT1 NRND con alternativa,
    pendientes al día y sin las referencias a rutado.dsn/rutado.ses.
2026-10-25 Docs: avisos aceptados de comprobar-flujo sobre cobre (I2S_DIN y MOT_VREF)
    La versión de comprobar-flujo que mide el cobre real marca dos cruces de
    zona caliente en la FurbyBoard v1.0. Ambos se aceptan con medidas:
    - I2S_DIN (In2) a 0,40 mm del núcleo del clase D: los agresores reales
    (SPK_P/SPK_N, solo F.Cu) cruzan a 45° con In1 GND continuo entre medias;
    acoplamiento inductivo acotado en <= 25 mV frente a ~0,8 V de margen.
    - MOT_VREF (F.Cu) a 2,58 mm del núcleo de L2: lo cercano es el pad VSYS
    (2,83 mm); el nodo SW queda a 6,0 mm; ~0,07 mV inducidos sobre 2,245 V.
    Sin cambios de cobre ni de ficheros de fabricación.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
2026-10-25 Docs: falso positivo USB_DP/L1 resuelto en pcb-toolkit 28b60ac
2026-10-25 Docs: enlace a la explicación interactiva de la FurbyBoard en makerisland.es
2026-10-27 Feature: series de 33 Ω en los relojes del bus DVP (M7): R59 en XCLK junto al pin 21 y R60 en PCLK junto a J6
    - design.py: R59 y R60, 0402 UNI-ROYAL 33 Ω (C25105, básica); redes nuevas CAM_XCLK_IO
    (pin 21 → R59) y CAM_PCLK_CAM (J6.17 → R60). Rs + Rout ≈ Z0 (≈ 75 Ω de la pista de
    0,15 sobre In1); HREF, VSYNC y los datos no la llevan (motivo en design.py y NOTAS).
    - layout.py: R59 en (−72,365; −82,35) bajo el pin 21, entre el patio del módulo y la fila
    del bus; R60 en (−53,6; −78,0) a 2 mm del pad 17 de J6.
    - rutas_fijas.py: XCLK acortado por el este hasta R59.2 y entrada al pin 21 desde R59.1
    con una diagonal; PCLK baja a y −78,0 en el tramo de R60 y Y7 a −78,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
2026-10-27 Fix: paralelos In2/In3 (M1), tanda 1: 28 → 19 pares; cero con señal analógica, de reloj o UART junto a la antena
    Cambios en scripts/rutas_fijas.py, sin mover piezas ni vías:
    - U0RX (In3) sube a y −63,0 entre el módulo y x −81,8: VBAT_SNS (In2, y −64,26) queda a 1,06 mm.
    - EN_6V/BQ_EN2/BQ_EN1 (In3): columnas 0,1 al oeste (EN_6V a 1,05 de I2S_DIN) y diagonales 0,1 mm
    al NE (BQ_EN1 a 1,07 de la diagonal de VBAT_SNS).
    - CAM_EN (In3): tramo norte por x −51,3 y la fila y −87,9 (antes x −53,5, a 0,28 de CAM_2V8 y a
    0,9 de la columna de 3V3).
    - BQ_TS (In2) a y −114,05 y LED_CHG_A/LED_PG_A (In3) a −115,3/−115,7: 1,05 mm.
    - VBAT_SNS (In2) fila corta a y −76,1 y filas TUMM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
2026-10-27 Feature: ficheros de fabricación regenerados tras M7 y M1 (E2 repetida)
    make_fab.sh sobre 4156112 con el pcb-toolkit del venv (tabla de giros): rellenos al día
    (copia idéntica), ERC 0, DRC con paridad 0/0/0; Gerber de 6 capas, taladros (383 PTH y 4 NPTH,
    iguales: sin vías nuevas), BOM 52 líneas / 126 piezas (nueva línea C25105: R59, R60, 0402 33 Ω,
    básica), CPL con R59 y R60 a 0° (cpl-rotaciones PASS, 2 avisos giro-sin-tabla por C25105),
    renders, STEP y PDF. Pads de R59/R60 comprobados por texto en F.Cu, F.Mask y F.Paste.
    README de fabricación: fecha y commit, 52/126, C25105 en la BOM y en «Confirmar antes de
    pedir», R59/R60 en «Revisar en el visor», coste.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
2026-10-27 Docs: cierre de M7 y M1 en NOTAS, README y TEST-PLAN e informe revisiones/2026-10-27-M7-M1.md
    - NOTAS: estado del 2026-10-27, decisiones de M7 (series de 33 Ω, valor y por qué solo en los
    relojes) y de M1 (9 pares corregidos), cálculo de Rs, medida de paralelos en «Apilado», fila
    de «Revisiones», sección nueva «Paralelos In2/In3 aceptados» con los 19 pares justificados
    uno a uno (geometría que los pinza y por qué no molestan) y pendientes de pcb-toolkit.
    - README: estado, resumen y bloque de cámara con R59/R60, tablas de J6 y del módulo con las
    redes cortas CAM_XCLK_IO y CAM_PCLK_CAM.
    - TEST-PLAN §14: medida de los flancos de XCLK y PCLK en R59/R60 y qué valor poner s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
2026-10-27 Docs: revisión independiente de M7 y M1 (PASA): informe, cifra de IPROPI‖CAM_EN corregida en NOTAS y medida de un dato del DVP en TEST-PLAN §14
    Revisado sobre f64f744 con herramientas repetidas y volcado propio: ERC 0, DRC con paridad 0/0/0 y relleno idéntico, revisar-rutado 0 errores, paralelos In2/In3 28 → 19 con las mismas separaciones, R59/R60 en el extremo que genera cada reloj, Gerber cotejados pad a pad y pista a pista, 383 PTH + 4 NPTH, BOM 52/126, cpl-rotaciones PASS. 0 críticos, 0 importantes, 2 mejoras documentales resueltas aquí.
2026-10-27 Fix: M3, piezas a ≥ 0,5 mm del borde fresado: R24 en 0402 bajo C15, R23 y R50 recolocadas
    Medido contra GetBoardPolygonOutlines (contorno real con el agujero del mecanismo), de borde a
    borde, patio / cuerpo / pads, en las 158 huellas (script propio con pcbnew):
    - R24 (30 kΩ, compensación del TPS61089): 0603 a 0,09 / 0,36 / 0,34 mm → 0402 UNI-ROYAL
    0402WGF3002TCE (C25776, extended) en (−53,88; −119,10) a 180°: 0,60 / 0,80 / 0,77 mm. En la
    esquina no hay otro hueco de 0603: la columna C12/R22/C15/R24 va a 1,6 mm de paso bajo el patio
    de L2, al oeste están C14 y el keepout de H4 y al sur la muesca del contorno. R24 sigue pegada a
    C15 (COMP) y a C14 (RC), fuera de la zona de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
2026-10-27 Feature: ficheros de fabricación regenerados tras M3 (E2 repetida)
    make_fab.sh con PCB_TOOLKIT del venv sobre ce455a2: rellenos al día (copia rellenada por kicad-cli
    idéntica a la guardada), ERC 0, DRC con paridad 0/0/0, Gerber de 6 capas + taladros con el origen
    auxiliar (220; −40), BOM 52 líneas / 126 piezas (R24 pasa a C25776, 30 kΩ 0402, extended) y CPL
    con R24 en (−53,880; −119,100) a 180°. cpl-rotaciones PASS, 0 errores, 3 avisos giro-sin-tabla
    (R59, R60 y R24, 0402 sin polaridad). Renders y STEP regenerados.
2026-10-27 Docs: cierre de M3 en NOTAS y README de fabricación e informe revisiones/2026-10-27-M3.md
    NOTAS: fila de M3 en «Estado», tres decisiones (R24 en 0402 y por qué no cabe un 0603; R23, R50
    y ENC_IO; pads de cable que no se mueven), fila en «Revisiones», aviso descentrada de R23:1
    aceptado y los 0402 pendientes en la tabla de giros. README de fabricación: commit de origen,
    las tres 0402 a mirar en el visor, 19 extended (58,33 USD) y totales, fila de C25776 en
    «Confirmar antes de pedir» con la opción C25779 (33 kΩ basic, fc +10 %) y la línea de la BOM.
    Informe con tabla de distancias antes/después, herramientas, 11 PNG, hallazgos A1–A3 y
    «Para el revisor».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
2026-10-27 Fix: A2, R24 a 33 kΩ 0402 básica (C25779) en vez de 30 kΩ extended, con la E2 repetida
    Revisión independiente de M3: el 30 kΩ 0402 (C25776) es extended en JLCPCB (3,07 USD de carga por
    pedido) y el 33 kΩ 0402 (C25779, UNI-ROYAL 0402WGF3302TCE) es básica (API de JLCPCB, 2026-10-27:
    2 540 677 en stock, 0,0019 USD). Lazo del TPS61089 con las ecuaciones 11-19 de SLVSD38C (VREF
    1,212 V, GEA 190 µS, Rsense 0,08 Ω, L 1 µH ± 20 %, Cout 42-70 µF efectivos, VIN 2,7-4,4 V,
    0,2-1 A): con 33 k fC 20-40 kHz, siempre < fSW/10 (96 kHz) y < fRHPZ/5 (26 kHz en la peor esquina),
    margen de fase mínimo 78,8° (30 k: 79,9°) y de ganancia ≥ 16 dB. Misma posición, giro y huella;
    C14 y C15 sin cambi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
2026-10-27 Docs: revisión independiente de M3 (PASA): informe revisiones/2026-10-27-M3-independiente.md y NOTAS
    Sobre 3807781, herramientas repetidas (ERC 0; DRC con paridad 0/0/0; revisar-rutado 0 errores /
    152 avisos; comprobar-flujo sin cruces nuevos; kicad-happy sin hallazgos nuevos; cpl-rotaciones
    PASS) y volcados propios: distancias al contorno de las 158 huellas, geometría de la esquina,
    rellenos trozo a trozo, paralelos In2/In3, keepouts, Gerber cotejados por geometría y
    rasterizados. 0 críticos, 0 importantes; A1 aceptado, A2 calculado (SLVSD38C ec. 11-19) y aplicado
    en 598f268, A4 nueva (tabla de giros del toolkit). Tabla «Revisiones» y estado de M3 en NOTAS.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
